cyberseihis/bnnprint/write/area_table.md

| | gasId | winewhite | cardio | pendigits | Har | winered |
|:---|---:|---:|---:|---:|---:|---:|
| bnndw |  8186903514 |  2398069796 | 2625544276 |  2989958945 | 2538763759 | 2451240647 |
| bnnpaar | 28155004994 |  1801300497 | 3873514668 |  3542788838 | 1742276623 | 1855123140 |
| bnndsat |  8104696944 |  2243047476 | 2476688256 |  2978862895 | 2401863926 | 2301503726 |
| bnnrobus |  5539426651 | 955878036 | 1244282486 |  1192648308 |  997044886 |  966295906 |
| bnnromem |  3787005725 | 795724384 |  973538254 | 954620558 |  815933049 |  795551471 |
| bnnromesx |  3784003792 | 797892993 | 1002634724 | 947374667 |  837521356 |  812703088 |
| bnnparstepw | 32698398388 |  1999572812 | 3928792766 |  3709266179 | 2315518878 | 2278159189 |
| bnnpaarter  | 26137614509 |  1665255587 | 3596909349 |  3222330307 | 1872808096 | 1747020576 |
| bnnparpnw | 26940613850 |  2586857731 | 4581533966 |  4301046264 | 2915795216 | 2779674503 |
| bnnpaarx | 28161515912 |  1819920659 | 3878707190 |  3551930192 | 1733307035 | 1843638582 |
| bnnparser | 17136617736 |  2036496895 | 3321122892 |  3396546062 | 2425075600 | 2186536366 |
| bnnrospinor |  3710576970 | 747786913 |  934543087 | 881331046 |  775932821 |  757033635 |
| bnnpar | 26976191700 |  2600670967 | 4671425747 |  4294613522 | 2939539015 | 2782322518 |
| bnndsatin |  7747969288 |  2356646791 | 2810682089 |  3109779691 | 2545317224 | 2429171177 |
| bnnroll |  4296589691 |  1034974561 | 1118415523 |  1313186365 | 1030487839 | 1020139925 |
| bnnparsign  | 17509279782 |  2047349412 | 3327450493 |  3338288839 | 2451830762 | 2245461263 |
| bnnroclk |  3740279945 | 757164887 |  978063287 | 944926916 |  813471167 |  781711587 |
| bnnroperm |  3767065181 | 785042623 |  956446441 | 935021870 |  814428053 |  787104215 |
| bnnrospine  |  3731008262 | 748739199 |  930476830 | 907653792 |  781939782 |  760587951 |
| bnnromesh |  3762552965 | 778943884 |  967400533 | 943117202 |  811382778 |  799002613 |
| bnndirect |  8862217257 |  2731200293 | 3049513878 |  3293137497 | 2763413176 | 2711150360 |
| bnnparw | 17136617736 |  2036496895 | 3321122892 |  3396546062 | 2425075600 | 2186536366 |
| bnnrolx |  4212096283 | 864705835 | 1109597201 |  1069429557 |  914303937 |  885090188 |
| bnnromex |  3797082992 | 796969544 |  975525744 | 966093815 |  822660672 |  810091571 |
| bnnseq |  4767284030 |  2974950246 | 3146979597 |  3471397032 | 2954896914 | 2957271954 |
| bnnrolin |  3854120055 | 799945409 | 1085099120 |  1036541150 |  829139916 |  804058285 |
| bnnparce | 18182298639 |  2047575794 | 3484390096 |  3573660077 | 2499410773 | 2076451308 |
