cyberseihis/bnnprint/scripts/grefs.md

bnnpar_bnnparsign

| | bnnpar area(cm²) | bnnparsign area(cm²) | area change | bnnpar power(mW) | bnnparsign power(mW) | power change |
|:---|---:|---:|:---|---:|---:|:---|
| Har | 29.4  | 24.52 | -16.6% | 92.1 | 78.8 | -14.4% |
| cardio | 46.71 | 33.27 | -28.8% | 145.3 | 106.2 | -26.9% |
| gasId | 269.76 | 175.09 | -35.1% | 767.7 | 499.1 | -35.0% |
| pendigits | 42.95 | 33.38 | -22.3% | 136.8 | 108.9 | -20.4% |
| winered | 27.82 | 22.45 | -19.3% | 90.7 | 74.6 | -17.8% |
| winewhite | 26.01 | 20.47 | -21.3% | 84.6 | 68 | -19.6% |

bnnparsign_bnnparw

| | bnnparsign area(cm²) | bnnparw area(cm²) | area change | bnnparsign power(mW) | bnnparw power(mW) | power change |
|:---|---:|---:|:---|---:|---:|:---|
| Har | 24.52 | 24.25 | -1.1% | 78.8 | 77.6 | -1.5% |
| cardio | 33.27 | 33.21 | -0.2% | 106.2 | 105.4 | -0.8% |
| gasId | 175.09 | 171.37 | -2.1% | 499.1 | 486.9 | -2.4% |
| pendigits | 33.38 | 33.97 | +1.8% | 108.9 | 109.6 | +0.6% |
| winered | 22.45 | 21.87 | -2.6% | 74.6 | 72.3 | -3.1% |
| winewhite | 20.47 | 20.36 | -0.5% | 68 | 66.7 | -1.9% |

bnnparw_bnnparce

| | bnnparw area(cm²) | bnnparce area(cm²) | area change | bnnparw power(mW) | bnnparce power(mW) | power change |
|:---|---:|---:|:---|---:|---:|:---|
| Har | 24.25 | 24.99 | +3.1% | 77.6 | 79 | +1.8% |
| cardio | 33.21 | 34.84 | +4.9% | 105.4 | 110.5 | +4.8% |
| gasId | 171.37 | 181.82 | +6.1% | 486.9 | 516.1 | +6.0% |
| pendigits | 33.97 | 35.74 | +5.2% | 109.6 | 115.5 | +5.4% |
| winered | 21.87 | 20.76 | -5.1% | 72.3 | 67.7 | -6.4% |
| winewhite | 20.36 | 20.48 | +0.6% | 66.7 | 65.8 | -1.3% |

bnnparw_bnnparstepw

| | bnnparw area(cm²) | bnnparstepw area(cm²) | area change | bnnparw power(mW) | bnnparstepw power(mW) | power change |
|:---|---:|---:|:---|---:|---:|:---|
| Har | 24.25 | 23.16 | -4.5% | 77.6 | 73.7 | -5.0% |
| cardio | 33.21 | 39.29 | +18.3% | 105.4 | 125.5 | +19.1% |
| gasId | 171.37 | 326.98 | +90.8% | 486.9 | 935.2 | +92.1% |
| pendigits | 33.97 | 37.09 | +9.2% | 109.6 | 120.3 | +9.8% |
| winered | 21.87 | 22.78 | +4.2% | 72.3 | 75.3 | +4.1% |
| winewhite | 20.36 | 20 | -1.8% | 66.7 | 65.8 | -1.3% |

bnnparsign_bnnpaar

| | bnnparsign area(cm²) | bnnpaar area(cm²) | area change | bnnparsign power(mW) | bnnpaar power(mW) | power change |
|:---|---:|---:|:---|---:|---:|:---|
| Har | 24.52 | 17.42 | -29.0% | 78.8 | 57.2 | -27.4% |
| cardio | 33.27 | 38.74 | +16.4% | 106.2 | 124.1 | +16.9% |
| gasId | 175.09 | 281.55 | +60.8% | 499.1 | 807.6 | +61.8% |
| pendigits | 33.38 | 35.43 | +6.1% | 108.9 | 114.6 | +5.2% |
| winered | 22.45 | 18.55 | -17.4% | 74.6 | 62.6 | -16.1% |
| winewhite | 20.47 | 18.01 | -12.0% | 68 | 59.8 | -12.1% |

bnnpaar_bnnpaarter

| | bnnpaar area(cm²) | bnnpaarter area(cm²) | area change | bnnpaar power(mW) | bnnpaarter power(mW) | power change |
|:---|---:|---:|:---|---:|---:|:---|
| Har | 17.42 | 18.73 | +7.5% | 57.2 | 60.8 | +6.3% |
| cardio | 38.74 | 35.97 | -7.2% | 124.1 | 116 | -6.5% |
| gasId | 281.55 | 261.38 | -7.2% | 807.6 | 759.7 | -5.9% |
| pendigits | 35.43 | 32.22 | -9.1% | 114.6 | 107.3 | -6.4% |
| winered | 18.55 | 17.47 | -5.8% | 62.6 | 59.6 | -4.8% |
| winewhite | 18.01 | 16.65 | -7.6% | 59.8 | 55.9 | -6.5% |

bnnseq_bnndirect

| | bnnseq area(cm²) | bnndirect area(cm²) | area change | bnnseq power(mW) | bnndirect power(mW) | power change |
|:---|---:|---:|:---|---:|---:|:---|
| Har | 29.55 | 27.63 | -6.5% | 132.7 | 128.8 | -2.9% |
| cardio | 31.47 | 30.5  | -3.1% | 143.1 | 150.8 | +5.4% |
| gasId | 47.67 | 88.62 | +85.9% | 216.8 | 364.5 | +68.1% |
| pendigits | 34.71 | 32.93 | -5.1% | 139 | 135.7 | -2.4% |
| winered | 29.57 | 27.11 | -8.3% | 131.7 | 125.7 | -4.6% |
| winewhite | 29.75 | 27.31 | -8.2% | 128.6 | 122.6 | -4.7% |

bnndirect_bnndw

| | bnndirect area(cm²) | bnndw area(cm²) | area change | bnndirect power(mW) | bnndw power(mW) | power change |
|:---|---:|---:|:---|---:|---:|:---|
| Har | 27.63 | 25.39 | -8.1% | 128.8 | 116.4 | -9.6% |
| cardio | 30.5  | 26.26 | -13.9% | 150.8 | 124.9 | -17.2% |
| gasId | 88.62 | 81.87 | -7.6% | 364.5 | 325.6 | -10.7% |
| pendigits | 32.93 | 29.9  | -9.2% | 135.7 | 123.1 | -9.3% |
| winered | 27.11 | 24.51 | -9.6% | 125.7 | 112.1 | -10.8% |
| winewhite | 27.31 | 23.98 | -12.2% | 122.6 | 106.2 | -13.4% |

bnndw_bnndsat

| | bnndw area(cm²) | bnndsat area(cm²) | area change | bnndw power(mW) | bnndsat power(mW) | power change |
|:---|---:|---:|:---|---:|---:|:---|
| Har | 25.39 | 24.02 | -5.4% | 116.4 | 109.2 | -6.2% |
| cardio | 26.26 | 24.77 | -5.7% | 124.9 | 118.7 | -5.0% |
| gasId | 81.87 | 81.05 | -1.0% | 325.6 | 318.9 | -2.1% |
| pendigits | 29.9  | 29.79 | -0.4% | 123.1 | 121.6 | -1.2% |
| winered | 24.51 | 23.02 | -6.1% | 112.1 | 104.5 | -6.8% |
| winewhite | 23.98 | 22.43 | -6.5% | 106.2 | 98.5 | -7.3% |

bnnrolx_bnnrolin

| | bnnrolx area(cm²) | bnnrolin area(cm²) | area change | bnnrolx power(mW) | bnnrolin power(mW) | power change |
|:---|---:|---:|:---|---:|---:|:---|
| Har | 9.14 | 8.29 | -9.3% | 39 | 36.3 | -6.9% |
| cardio | 11.1  | 10.85 | -2.3% | 45.5 | 45.6 | +0.2% |
| gasId | 42.12 | 38.54 | -8.5% | 142.4 | 131.3 | -7.8% |
| pendigits | 10.69 | 10.37 | -3.0% | 43.5 | 42.6 | -2.1% |
| winered | 8.85 | 8.04 | -9.2% | 38.9 | 35.7 | -8.2% |
| winewhite | 8.65 | 8 | -7.5% | 37.5 | 34.9 | -6.9% |

bnnrolin_bnnrospine

| | bnnrolin area(cm²) | bnnrospine area(cm²) | area change | bnnrolin power(mW) | bnnrospine power(mW) | power change |
|:---|---:|---:|:---|---:|---:|:---|
| Har | 8.29 | 7.82 | -5.7% | 36.3 | 31.7 | -12.7% |
| cardio | 10.85 | 9.3  | -14.3% | 45.6 | 36 | -21.1% |
| gasId | 38.54 | 37.31 | -3.2% | 131.3 | 124.4 | -5.3% |
| pendigits | 10.37 | 9.08 | -12.4% | 42.6 | 35.1 | -17.6% |
| winered | 8.04 | 7.61 | -5.3% | 35.7 | 30.9 | -13.4% |
| winewhite | 8 | 7.49 | -6.4% | 34.9 | 30.9 | -11.5% |

bnnrospine_bnnrobus

| | bnnrospine area(cm²) | bnnrobus area(cm²) | area change | bnnrospine power(mW) | bnnrobus power(mW) | power change |
|:---|---:|---:|:---|---:|---:|:---|
| Har | 7.82 | 9.97 | +27.5% | 31.7 | 26.1 | -17.7% |
| cardio | 9.3  | 12.44 | +33.8% | 36 | 29.4 | -18.3% |
| gasId | 37.31 | 55.39 | +48.5% | 124.4 | 97.9 | -21.3% |
| pendigits | 9.08 | 11.93 | +31.4% | 35.1 | 29.7 | -15.4% |
| winered | 7.61 | 9.66 | +26.9% | 30.9 | 25.7 | -16.8% |
| winewhite | 7.49 | 9.56 | +27.6% | 30.9 | 25.2 | -18.4% |

bnnparw_bnnrospine

| | bnnparw area(cm²) | bnnrospine area(cm²) | area change | bnnparw power(mW) | bnnrospine power(mW) | power change |
|:---|---:|---:|:---|---:|---:|:---|
| Har | 24.25 | 7.82 | -67.8% | 77.6 | 31.7 | -59.1% |
| cardio | 33.21 | 9.3  | -72.0% | 105.4 | 36 | -65.8% |
| gasId | 171.37 | 37.31 | -78.2% | 486.9 | 124.4 | -74.5% |
| pendigits | 33.97 | 9.08 | -73.3% | 109.6 | 35.1 | -68.0% |
| winered | 21.87 | 7.61 | -65.2% | 72.3 | 30.9 | -57.3% |
| winewhite | 20.36 | 7.49 | -63.2% | 66.7 | 30.9 | -53.7% |

bnnparw_tnnparsign

| | bnnparw area(cm²) | tnnparsign area(cm²) | area change | bnnparw power(mW) | tnnparsign power(mW) | power change |
|:---|---:|---:|:---|---:|---:|:---|
| Har | 24.25 | 13.4  | -44.7% | 77.6 | 42.7 | -45.0% |
| cardio | 33.21 | 19.21 | -42.2% | 105.4 | 62.4 | -40.8% |
| gasId | 171.37 | 101.65 | -40.7% | 486.9 | 297.1 | -39.0% |
| pendigits | 33.97 | 29.43 | -13.4% | 109.6 | 95.8 | -12.6% |
| winered | 21.87 | 11.78 | -46.1% | 72.3 | 40 | -44.7% |
| winewhite | 20.36 | 9.53 | -53.2% | 66.7 | 32.8 | -50.8% |
