cyberseihis/bnnprint/trainingdata/listofdatasets.txt

pendigits ready
har [XYZ][Mean/Std][Acc/Gyro] cleaned
arrythmia cleaned
redwine not all classes used
whitewine cleaned
cardio cleaned
gasId cleaned
