cyberseihis/bnnprint/write/tnstuf/bnnpar_tnnpartab.md

| | bnnpar area | tnnpar area | area change | bnnpar power | tnnpar power | power change |
|:---|---:|---:|:---|---:|---:|:---|
| Har | 29.4  | 14.58 | -50.4% | 92.1 | 46.1 | -49.9% |
| cardio | 46.71 | 20.55 | -56.0% | 145.3 | 66.3 | -54.4% |
| gasId | 269.76 | 110.99 | -58.9% | 767.7 | 325.4 | -57.6% |
| pendigits | 42.95 | 29.97 | -30.2% | 136.8 | 97.4 | -28.8% |
| winered | 27.82 | 13.42 | -51.8% | 90.7 | 44 | -51.5% |
| winewhite | 26.01 | 10.49 | -59.7% | 84.6 | 35.1 | -58.5% |
