cyberseihis/bnnprint/write/tnstuf/bnnparsign_tnnparsigntab.md

| | bnnparsign area | tnnparsign area | area change | bnnparsign power | tnnparsign power | power change |
|:---|---:|---:|:---|---:|---:|:---|
| Har | 24.52 | 13.4  | -45.4% | 78.8 | 42.7 | -45.8% |
| cardio | 33.27 | 19.21 | -42.3% | 106.2 | 62.4 | -41.2% |
| gasId | 175.09 | 101.65 | -41.9% | 499.1 | 297.1 | -40.5% |
| pendigits | 33.38 | 29.43 | -11.8% | 108.9 | 95.8 | -12.0% |
| winered | 22.45 | 11.78 | -47.5% | 74.6 | 40 | -46.4% |
| winewhite | 20.47 | 9.53 | -53.4% | 68 | 32.8 | -51.8% |
