cyberseihis/bnnprint/write/tnstuf/bnnseq_tnnseqtab.md

| | bnnseq area | tnnseq area | area change | bnnseq power | tnnseq power | power change |
|:---|---:|---:|:---|---:|---:|:---|
| Har | 29.55 | 25.69 | -13.1% | 132.7 | 119.6 | -9.9% |
| cardio | 31.47 | 21.74 | -30.9% | 143.1 | 101.4 | -29.1% |
| gasId | 47.67 | 35.6  | -25.3% | 216.8 | 158.2 | -27.0% |
| pendigits | 34.71 | 34.64 | -0.2% | 139 | 139.1 | +0.1% |
| winered | 29.57 | 24.95 | -15.6% | 131.7 | 117.3 | -10.9% |
| winewhite | 29.75 | 24.45 | -17.8% | 128.6 | 115.5 | -10.2% |
