cyberseihis/bnnprint/write/tnstuf/tnnparsign_tnnpaartab.md

| | tnnparsign area | tnnpaar area | area change | tnnparsign power | tnnpaar power | power change |
|:---|---:|---:|:---|---:|---:|:---|
| Har | 13.4  | 14.03 | +4.7% | 42.7 | 44 | +3.0% |
| cardio | 19.21 | 18.75 | -2.4% | 62.4 | 61.4 | -1.6% |
| gasId | 101.65 | 107.06 | +5.3% | 297.1 | 312.8 | +5.3% |
| pendigits | 29.43 | 28.34 | -3.7% | 95.8 | 93.2 | -2.7% |
| winered | 11.78 | 12.61 | +7.0% | 40 | 42.2 | +5.5% |
| winewhite | 9.53 | 10.47 | +9.9% | 32.8 | 34.9 | +6.4% |
