cyberseihis/bnnprint/write/tnstuf/tnnparsign_tnnpaartertab.md

| | tnnparsign area | tnnpaarter area | area change | tnnparsign power | tnnpaarter power | power change |
|:---|---:|---:|:---|---:|---:|:---|
| Har | 13.4  | 14.01 | +4.6% | 42.7 | 44.7 | +4.7% |
| cardio | 19.21 | 19.87 | +3.4% | 62.4 | 65 | +4.2% |
| gasId | 101.65 | 110.62 | +8.8% | 297.1 | 324.5 | +9.2% |
| pendigits | 29.43 | 27.95 | -5.0% | 95.8 | 93 | -2.9% |
| winered | 11.78 | 12.85 | +9.1% | 40 | 43.7 | +9.3% |
| winewhite | 9.53 | 10.29 | +8.0% | 32.8 | 34.2 | +4.3% |
