cyberseihis/bnnprint/write/tnstuf/tnnparsign_tnnparwtab.md

| | tnnparsign area | tnnparw area | area change | tnnparsign power | tnnparw power | power change |
|:---|---:|---:|:---|---:|---:|:---|
| Har | 13.4  | 13.82 | +3.1% | 42.7 | 44.2 | +3.5% |
| cardio | 19.21 | 19.85 | +3.3% | 62.4 | 63.9 | +2.4% |
| gasId | 101.65 | 101.42 | -0.2% | 297.1 | 294.6 | -0.8% |
| pendigits | 29.43 | 29.74 | +1.1% | 95.8 | 97.2 | +1.5% |
| winered | 11.78 | 12.26 | +4.1% | 40 | 40.6 | +1.5% |
| winewhite | 9.53 | 10.18 | +6.8% | 32.8 | 34.1 | +4.0% |
