cyberseihis/bnnprint/write/tnstuf/tnnseq_tnnzeqtab.md

| | tnnseq area | tnnzeq area | area change | tnnseq power | tnnzeq power | power change |
|:---|---:|---:|:---|---:|---:|:---|
| Har | 25.69 | 23.86 | -7.1% | 119.6 | 115.7 | -3.3% |
| cardio | 21.74 | 22.16 | +1.9% | 101.4 | 105.9 | +4.4% |
| gasId | 35.6  | 60.56 | +70.1% | 158.2 | 236.5 | +49.5% |
| pendigits | 34.64 | 32.95 | -4.9% | 139.1 | 135.7 | -2.4% |
| winered | 24.95 | 22.66 | -9.2% | 117.3 | 110.8 | -5.5% |
| winewhite | 24.45 | 22.08 | -9.7% | 115.5 | 108.9 | -5.7% |
