cyberseihis/bnnprint/write/tnstuf/tnnzeq_tnnzewtab.md

| | tnnzeq area | tnnzew area | area change | tnnzeq power | tnnzew power | power change |
|:---|---:|---:|:---|---:|---:|:---|
| Har | 23.86 | 19.85 | -16.8% | 115.7 | 94.5 | -18.3% |
| cardio | 22.16 | 18.06 | -18.5% | 105.9 | 83.4 | -21.2% |
| gasId | 60.56 | 57.54 | -5.0% | 236.5 | 221.6 | -6.3% |
| pendigits | 32.95 | 28.85 | -12.4% | 135.7 | 117.5 | -13.4% |
| winered | 22.66 | 18.73 | -17.3% | 110.8 | 89.3 | -19.4% |
| winewhite | 22.08 | 18.5  | -16.2% | 108.9 | 89.1 | -18.2% |
