cyberseihis/bnnprint/write/comps/bnnrolin_bnnromemtab.md

| | bnnrolin area | bnnromem area | area change | bnnrolin power | bnnromem power | power change |
|:---|---:|---:|:---|---:|---:|:---|
| Har | 8.29 | 8.16 | -1.6% | 36.3 | 35.1 | -3.3% |
| cardio | 10.85 | 9.74 | -10.2% | 45.6 | 40.8 | -10.5% |
| gasId | 38.54 | 37.87 | -1.7% | 131.3 | 130 | -1.0% |
| pendigits | 10.37 | 9.55 | -7.9% | 42.6 | 38.2 | -10.3% |
| winered | 8.04 | 7.96 | -1.0% | 35.7 | 35.2 | -1.4% |
| winewhite | 8 | 7.96 | -0.5% | 34.9 | 34.9 | +0.0% |
