cyberseihis/bnnprint/write/comps/bnnromem_bnnromeshtab.md

| | bnnromem area | bnnromesh area | area change | bnnromem power | bnnromesh power | power change |
|:---|---:|---:|:---|---:|---:|:---|
| Har | 8.16 | 8.11 | -0.6% | 35.1 | 35.3 | +0.6% |
| cardio | 9.74 | 9.67 | -0.7% | 40.8 | 40.1 | -1.7% |
| gasId | 37.87 | 37.63 | -0.6% | 130 | 129.6 | -0.3% |
| pendigits | 9.55 | 9.43 | -1.3% | 38.2 | 38.7 | +1.3% |
| winered | 7.96 | 7.99 | +0.4% | 35.2 | 34.8 | -1.1% |
| winewhite | 7.96 | 7.79 | -2.1% | 34.9 | 34.1 | -2.3% |
