cyberseihis/bnnprint/write/comps/bnnromesh_bnnromesxtab.md

| | bnnromesh area | bnnromesx area | area change | bnnromesh power | bnnromesx power | power change |
|:---|---:|---:|:---|---:|---:|:---|
| Har | 8.11 | 8.38 | +3.3% | 35.3 | 36.9 | +4.5% |
| cardio | 9.67 | 10.03 | +3.7% | 40.1 | 42 | +4.7% |
| gasId | 37.63 | 37.84 | +0.6% | 129.6 | 135.5 | +4.6% |
| pendigits | 9.43 | 9.47 | +0.4% | 38.7 | 40.4 | +4.4% |
| winered | 7.99 | 8.13 | +1.8% | 34.8 | 35.9 | +3.2% |
| winewhite | 7.79 | 7.98 | +2.4% | 34.1 | 35.4 | +3.8% |
