cyberseihis/bnnprint/write/comps/bnnromesh_bnnropermtab.md

| | bnnromesh area | bnnroperm area | area change | bnnromesh power | bnnroperm power | power change |
|:---|---:|---:|:---|---:|---:|:---|
| Har | 8.11 | 8.14 | +0.4% | 35.3 | 35.2 | -0.3% |
| cardio | 9.67 | 9.56 | -1.1% | 40.1 | 39.1 | -2.5% |
| gasId | 37.63 | 37.67 | +0.1% | 129.6 | 131.7 | +1.6% |
| pendigits | 9.43 | 9.35 | -0.8% | 38.7 | 38.5 | -0.5% |
| winered | 7.99 | 7.87 | -1.5% | 34.8 | 34.7 | -0.3% |
| winewhite | 7.79 | 7.85 | +0.8% | 34.1 | 33.9 | -0.6% |
