cyberseihis/bnnprint/write/comps/bnnromesh_bnnrospinetab.md

| | bnnromesh area | bnnrospine area | area change | bnnromesh power | bnnrospine power | power change |
|:---|---:|---:|:---|---:|---:|:---|
| Har | 8.11 | 7.82 | -3.6% | 35.3 | 31.7 | -10.2% |
| cardio | 9.67 | 9.3  | -3.8% | 40.1 | 36 | -10.2% |
| gasId | 37.63 | 37.31 | -0.9% | 129.6 | 124.4 | -4.0% |
| pendigits | 9.43 | 9.08 | -3.7% | 38.7 | 35.1 | -9.3% |
| winered | 7.99 | 7.61 | -4.8% | 34.8 | 30.9 | -11.2% |
| winewhite | 7.79 | 7.49 | -3.9% | 34.1 | 30.9 | -9.4% |
