cyberseihis/bnnprint/write/comps/bnnrospine_bnnrospinortab.md

| | bnnrospine area | bnnrospinor area | area change | bnnrospine power | bnnrospinor power | power change |
|:---|---:|---:|:---|---:|---:|:---|
| Har | 7.82 | 7.76 | -0.8% | 31.7 | 31.5 | -0.6% |
| cardio | 9.3  | 9.35 | +0.5% | 36 | 36.2 | +0.6% |
| gasId | 37.31 | 37.11 | -0.5% | 124.4 | 121.8 | -2.1% |
| pendigits | 9.08 | 8.81 | -3.0% | 35.1 | 34.1 | -2.8% |
| winered | 7.61 | 7.57 | -0.5% | 30.9 | 30.8 | -0.3% |
| winewhite | 7.49 | 7.48 | -0.1% | 30.9 | 30.6 | -1.0% |
