cyberseihis/bnnprint/write/mark.pdf

## Δυαδικά νευρωνικά δίκτυα για τυπωμένα ηλεκτρονικά

Παναγιώτης Παπανικολάου

7 Ιουλίου 2023

## Τυπωμένα ηλεκτρονικά

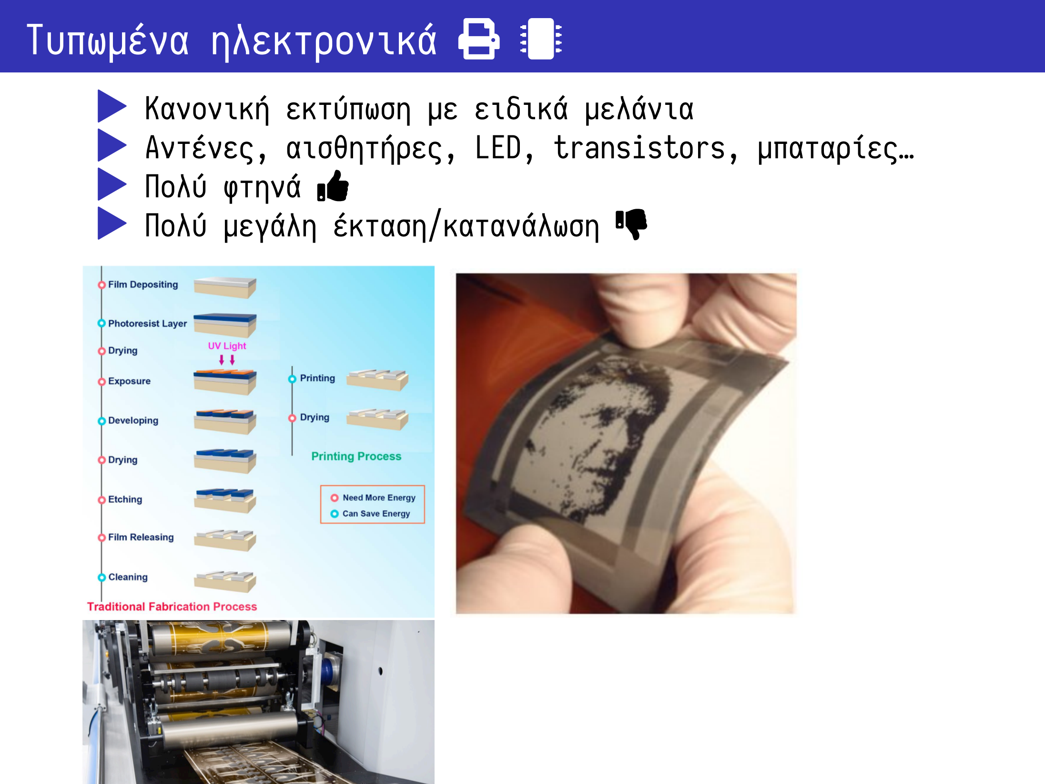
[picture p40: page 2]

- Κανονική εκτύπωση με ειδικά μελάνια
- Αντένες, αισθητήρες, LED, transistors, μπαταρίες…
- Πολύ φτηνά
- Πολύ μεγάλη έκταση/κατανάλωση

## Ubiquitous computing ç

Υπολογιστικά στοιχεία στα πάντα.

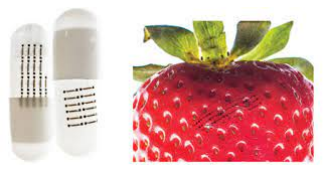
[picture p41: figure]

Εκτυπωμένo machine learning
- Πολλές εφαρμογές classification
- Δύσκολα υλοποιήσιμο

## Δυαδικά νευρωνικά δίκτυα(ΒΝΝ)

- Weights/activations ∈ {−1, 1} (1 bit)
- Multiply-accumulate → XNOR-popcount
- Χαμηλές απαιτήσεις
- Λιγότερο αξιόπιστα

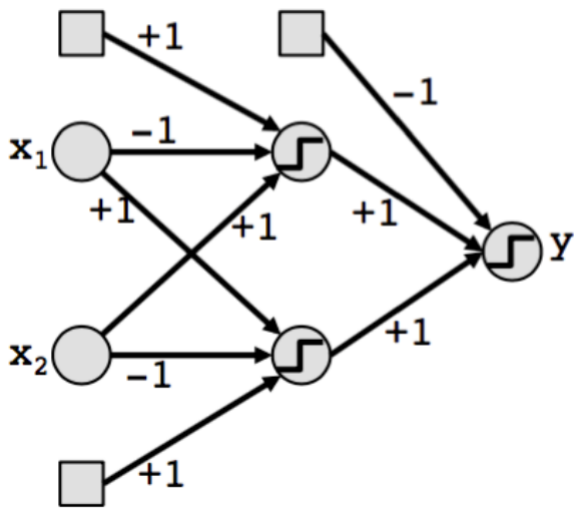
[picture p42: figure]

## Προηγούμενες εργασίες

- Αναλογικοί νευρώνες¹
- Bespoke decision trees, SVMs²
- Bespoke approximate MLPs³
- Stochastic computing⁴
- Sea of gates⁵

1
Weller et al, Programmable neuromorphic circuit based on printed electrolyte-gated transistors, in: (Asp-Dac)
2
Weller et al, Printed machine learning classifiers, in: Annu. Int. Symp. Microarchitecture (Micro)
3
Armeniakos et al, Cross-layer approximation for printed machine learning circuits, in: (Date)
4
Weller et al,Printed stochastic computing neural networks, in: (Date)
5
Iordanou et al, Tiny classifier circuits: Evolving accelerators for tabular data, (2023).

## Στόχος

Εξέταση ΒΝΝ ως προς την υποστήριξη τυπωμένου ML é

Υλοποίηση framework για αυτόματη δημιουργία τυπωμένου ΒΝΝ από dataset

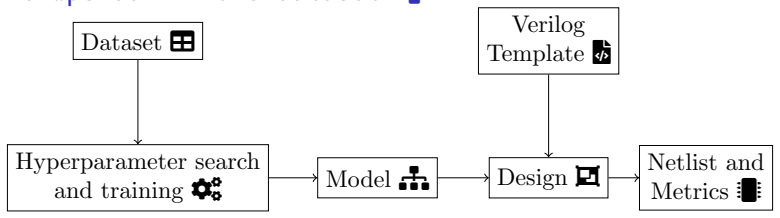
[picture p43: figure]
Dataset O; Hyperparameter search; and training Ô; Model ú; Design _; Verilog Template D; Netlist and Metrics >

## Model accuracy é

Dataset | FP32 BNN TNN MLPC
Cardio | 92 | 88 | 90 88
GasId | 90 | 81 | 88 -
Har | 74 | 51 | 52 -
Pendigits | 99 | 87 | 92 94
Redwine | 60 | 54 | 58 56
Whitewine | 57 | 51 | 50 54

## Παράλληλη υλοποίηση

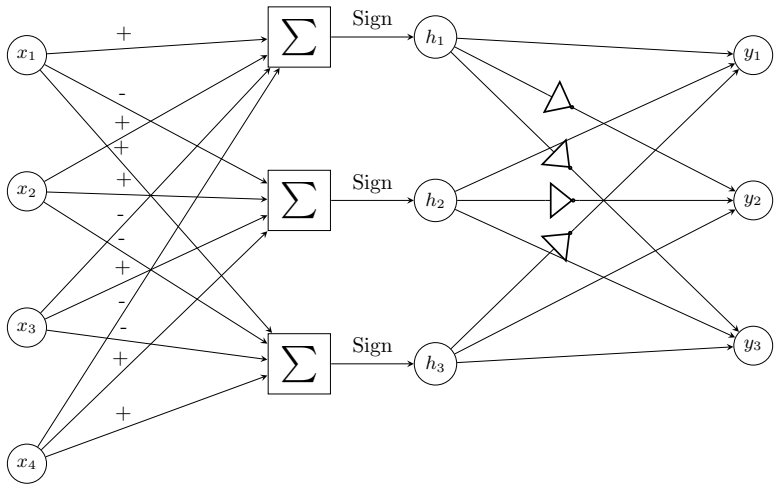
[picture p44: figure]
Sign

## Παράλληλη υλοποίηση

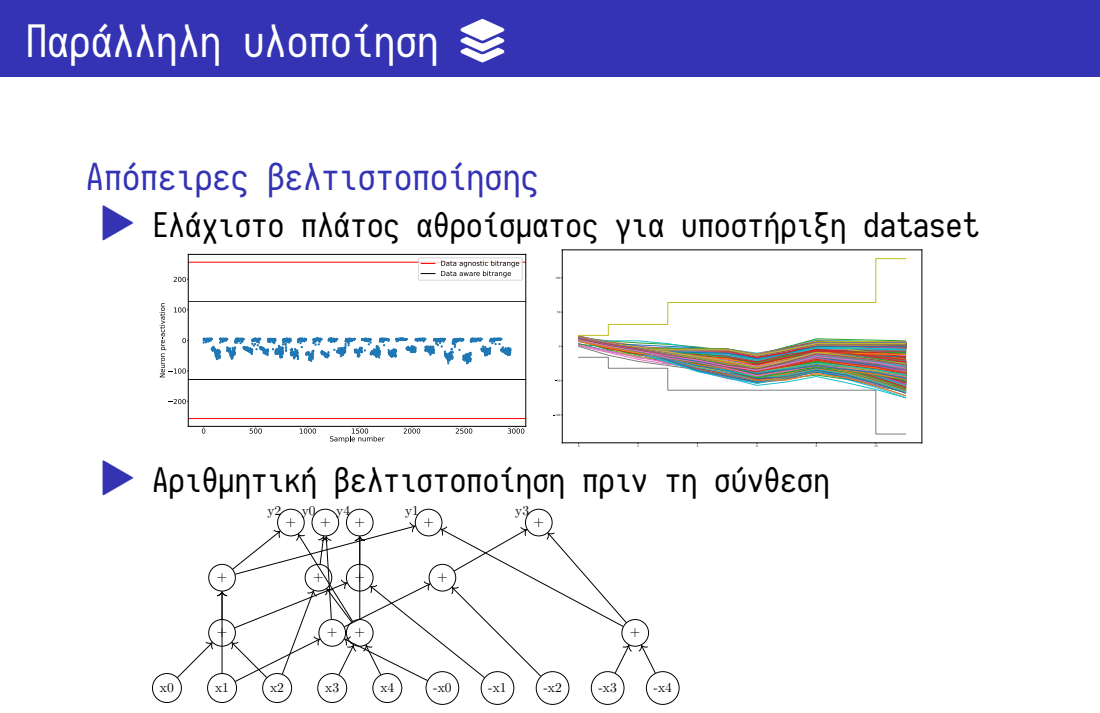
[picture p45: page 9]

Απόπειρες βελτιστοποίησης
▶ Ελάχιστο πλάτος αθροίσματος για υποστήριξη dataset

▶ Αριθμητική βελτιστοποίηση πριν τη σύνθεση

## Ακολουθιακή υλοποίηση ¥

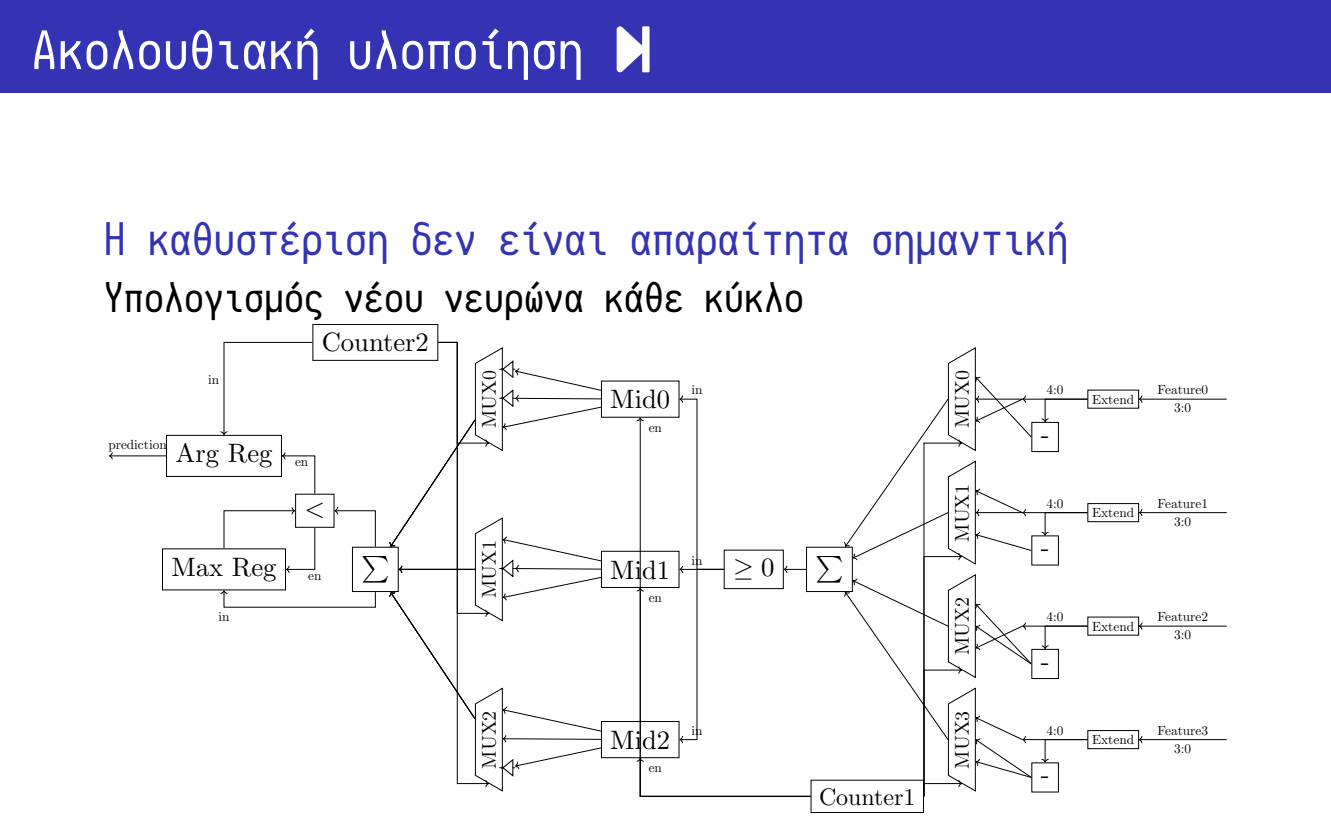
[picture p46: page 10]
Counter1; Extend; Feature0; MUX0; Feature1; MUX1; Feature2; MUX2; Feature3; MUX3; Counter2; Mid0; Mid1; Mid2; Max Reg; Arg Reg; prediction

Η καθυστέριση δεν είναι απαραίτητα σημαντική
Υπολογισμός νέου νευρώνα κάθε κύκλο P

## Βελτιώσεις στην ακολουθιακή υλοποίηση ¥

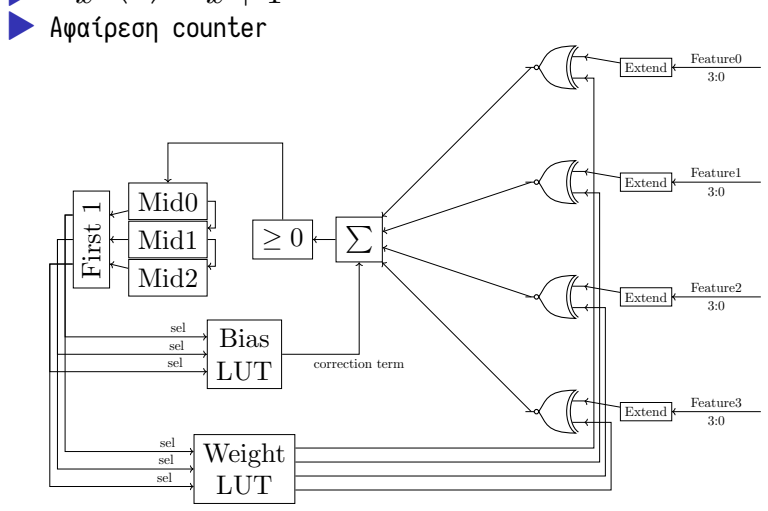
[picture p47: figure]
▶ Αφαίρεση counter; Bias LUT; Weight LUT; correction term; Extend; Feature0 3:0; Feature1 3:0; Feature2 3:0; Feature3 3:0; Mid1; First 1; Mid0; sel; Mid2

- −x ⟺ ¬x + 1

## Tristate buffer memory

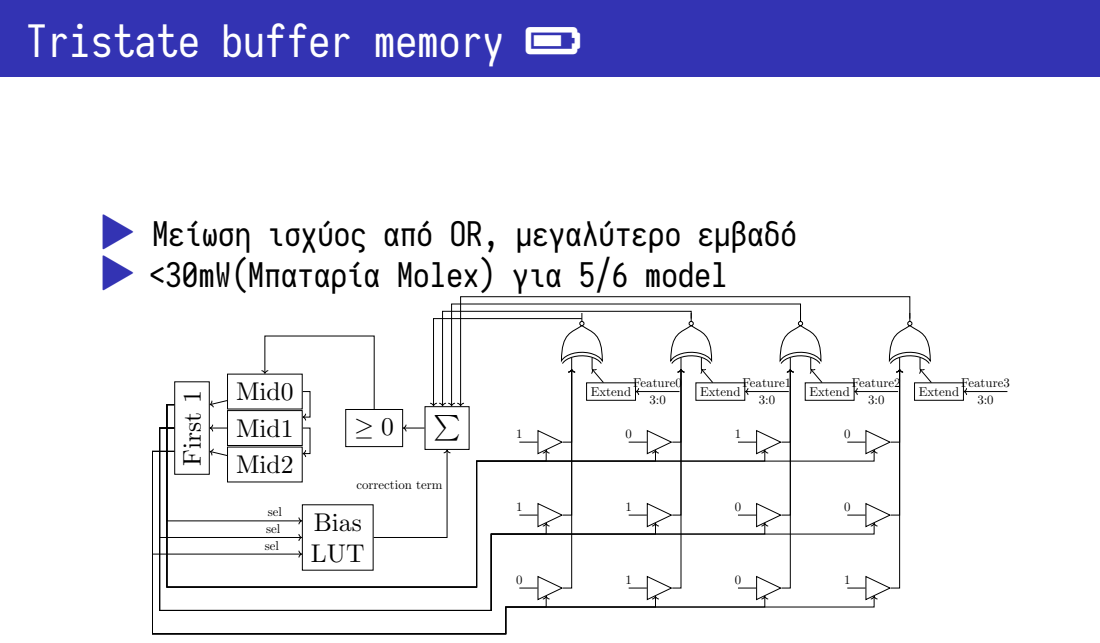
[picture p48: page 12]
Bias LUT; correction term; Extend Feature0; Extend Feature1; Extend Feature2; Extend Feature3; First 1; Mid0; sel; Mid1; Mid2

▶ Μείωση ισχύος από OR, μεγαλύτερο εμβαδό
▶ <30mW(Μπαταρία Molex) για 5/6 model

## Delays

dataset

combinatorial
delay(ms)

sequential
delay(ms)

sequential
cycles

total
sequential
delay(ms)
cardio | 142 | 147 | 43 | 6321
gasId | 260 | 181 | 46 | 8326
Har | 165 | 135 | 46 | 6210
pendigits | 309 | 147 | 50 | 7350
winered | 160 | 138 | 46 | 6348
winewhite | 143 | 129 | 47 | 6063

## Ternary weight networks

- Βάρη ∈ {−1, 0, 1} αντί {−1, 1}
- Αφαίρεση συνδέσεων με βάρος 0 ñ
- Καλύτερη ακρίβεια και έως 2× μικρότερα κόστη Ô

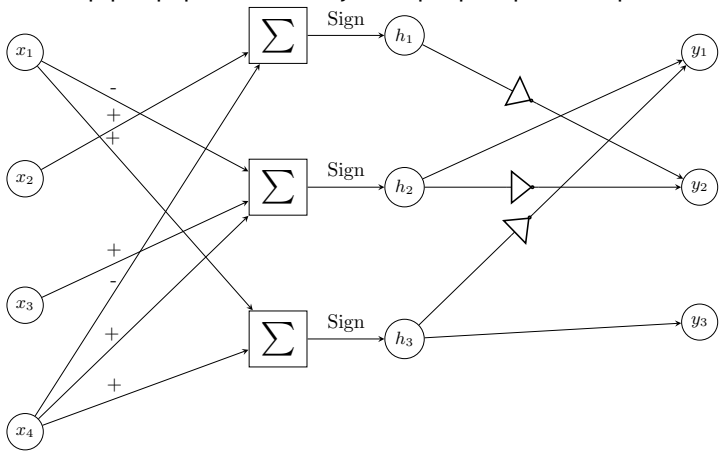
[picture p49: figure]
Sign

## Συγκρίσεις

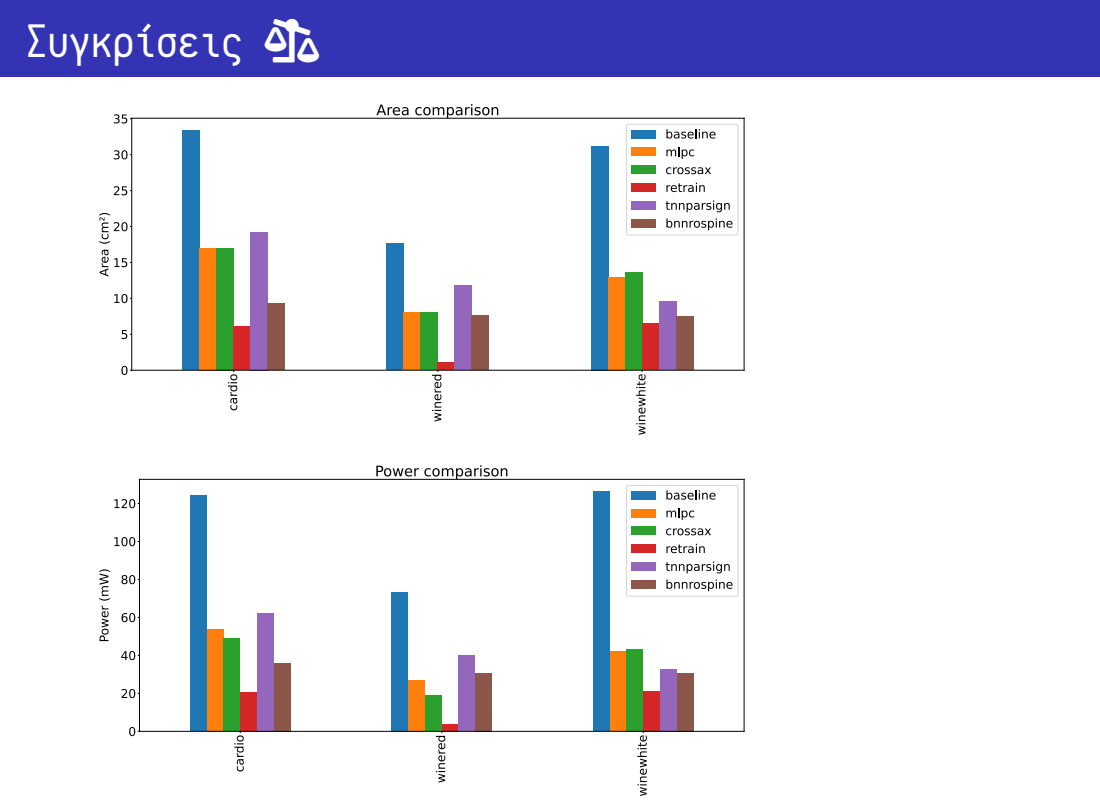
[picture p50: page 15]
