cyberseihis/bnnprint/write/xx.pdf

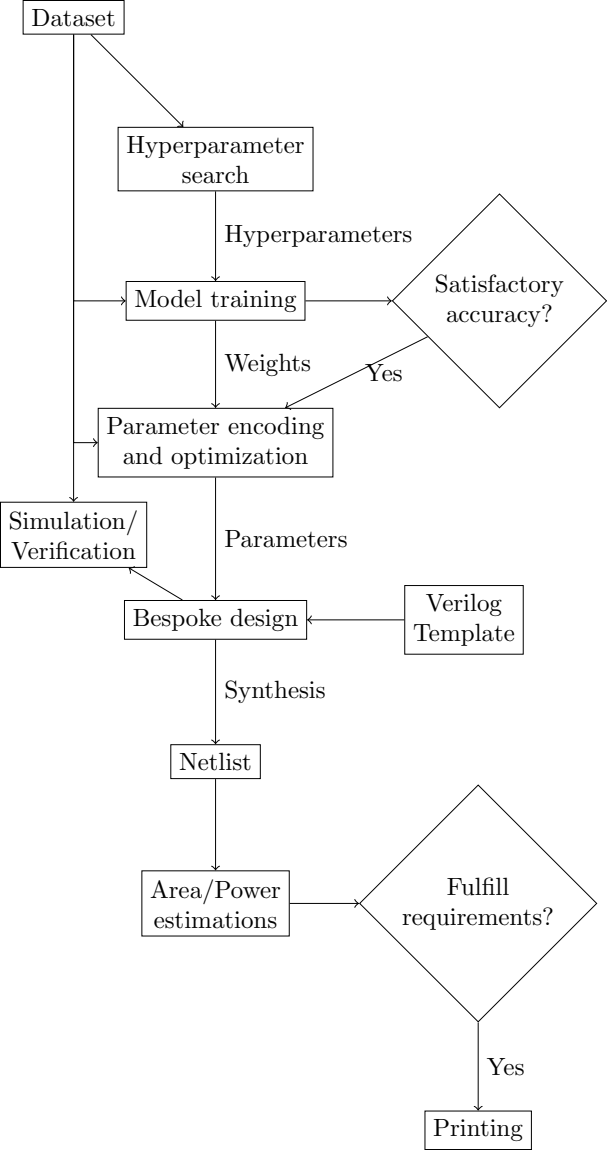
[picture p51: figure]
Dataset; Hyperparameter search; Model training; Parameter encoding and optimization; Satisfactory accuracy?; Bespoke design; Simulation/ Verification; Verilog Template; Netlist; Area/Power estimations; Fulfill requirements?; Printing; Hyperparameters; Weights; Yes; Parameters; Synthesis
