cyberseihis/bnnprint/write/grtheory.md

\newpage

# Abstract

Τα τυπωμένα ηλεκτρονικά είναι μια αναδυόμενη τεχνολογία που έχει τη δυνατότητα να καταστήσει δυνατή τη διείσδυση της πληροφορικής σε μια μεγάλη ποικιλία καταναλωτικών προϊόντων, χάρη στην υπό του cent κατασκευή τους και τους εύκαμπτους παράγοντες μορφής τους. Πολλές από τις προβλεπόμενες εφαρμογές που θα υποστηρίξουν έχουν να κάνουν με την ταξινόμηση των δεδομένων που συλλέγονται από τυπωμένους αισθητήρες για την εξαγωγή μιας χρήσιμης ιδιότητας σχετικά με το υπό μέτρηση αντικείμενο. Η εκτυπωμένη μηχανική μάθηση (ML) αναπτύσσεται προκειμένου να πραγματοποιούνται τέτοιου είδους ταξινομήσεις από δεδομένα αισθητήρων. Επειδή τα τυπωμένα ηλεκτρονικά έχουν πολύ υψηλότερες απαιτήσεις σε έκταση και κατανάλωση ενέργειας σε σύγκριση με τα παραδοσιακά ηλεκτρονικά, αυτά τα μοντέλα ML πρέπει να εκτελούνται σε περιβάλλον με πολύ περιορισμένους πόρους. Ευτυχώς, η ευκολία κατασκευής τυπωμένων κυκλωμάτων με τη χρήση προσθετικών μεθόδων επιτρέπει την πλήρη προσαρμογή του υλικού στο ακριβές εκπαιδευμένο μοντέλο που ενσωματώνει. Αυτό επιτρέπει τη συρρίκνωση των απαιτήσεων σε πόρους κατά πολλούς παράγοντες. Η παρούσα εργασία αξιολογεί τη δυνατότητα ανάπτυξης αρχιτεκτονικών δυαδικών νευρωνικών δικτύων (BNN) ως τυπωμένων ταξινομητών, όπου τα BNN είναι δίκτυα με βάρη και ενεργοποιήσεις που κβαντίζονται σε ένα μόνο bit για τη μείωση των υπολογιστικών απαιτήσεων στο ελάχιστο, γεγονός που τα καθιστά μια καλή υποψήφια αρχιτεκτονική για το συγκεκριμένο πρόβλημα.

\newpage

# Εισαγωγή

## Εισαγωγή στα τυπωμένα ηλεκτρονικά

Τα τυπωμένα ηλεκτρονικά αναφέρονται σε πολύ λεπτές ηλεκτρονικές συσκευές
και κυκλώματα που παράγονται με την εφαρμογή μελανιών με τις επιθυμητές
ηλεκτρικές ιδιότητες σε διάφορα υποστρώματα. Μπορούν να κατασκευαστούν
σε μεγάλο όγκο για πολύ χαμηλότερο κόστος σε σύγκριση με άλλα
ηλεκτρονικά με μεθόδους που είναι κοινές στην βιομηχανία εκτύπωσης. Αυτό
τα καθιστά ιδιαίτερα κατάλληλα για εφαρμογές όπου τα οφέλη της
ηλεκτρονικής λειτουργικότητας από μόνα τους δεν αντισταθμίζουν τα
σχετικά έξοδα. Επιπλέον, μπορούν να προσφέρουν ευέλικτες μορφές και τη
δυνατότητα κάλυψης μεγάλης περιοχής. Ένα άλλο πλεονέκτημα που μπορεί να
προκύψει από τη διάδοσή τους είναι η μείωση του αντίκτυπου των
ηλεκτρονικών αποβλήτων, αφού τα τυπωμένα ηλεκτρονικά μπορούν να είναι
πολύ λιγότερο τοξικά για το περιβάλλον και πιο εύκολα ανακυκλώσιμα από
τα υπόλοιπα, ή ακόμη και βιοδιασπώμενα. Δεν μπορούν να ανταγωνιστούν τα
ηλεκτρονικά πυριτίου σε επιδόσεις λόγω της μεγάλης αντίστασης των
αγώγιμων μελανιών, της έλλειψης υποστήριξης για υψηλές συχνότητες και
της μεγάλης μεταβλητότητας κατά την κατασκευή. Ενώ η δυνατότητα να
καλύπτουν μεγάλες περιοχές είναι μερικές φορές επιθυμητή, πολλές
εφαρμογές απαιτούν σμίκρυνση που δεν μπορούν να προσφέρουν. Μια ποικιλία
ενεργών και παθητικών συσκευών, όπως τρανζίστορ, αντιστάσεις, πυκνωτές,
αισθητήρες, συλλέκτες και κεραίες μπορούν να υλοποιηθούν με αυτές.
Θεωρούνται ότι αποτελούν μια αναδυόμενη αγορά με σημαντικές δυνατότητες
διεύρυνσης του ρόλου των υπολογιστικών συστημάτων στην καθημερινή ζωή.
Μπορούν να βοηθήσουν στη διείσδυση του Internet-of-Things να φτάσει πολύ
βαθύτερα, και έτσι συνεργίζονται καλά με άλλες εξελίξεις στον τομέα. Μια
πρόσφατη έκθεση της IDTechEx[25] προβλέπει την παγκόσμια αγορά για τα
τυπωμένα εύκαμπτα ηλεκτρονικά, εξαιρουμένων των OLEDs, θα φθάσει τα 12
δισεκατομμύρια δολάρια έως το 2033.




## Εισαγωγή στην πανταχού παρούσα πληροφορική και δήλωση θέσης

Η τεχνολογία γενικά και πιο συγκεκριμένα ο υπολογισμός παίζει έναν
ολοένα και μεγαλύτερο ρόλο στη ζωή μας και δεν υπάρχουν ενδείξεις ότι η
τάση αυτή θα επιβραδυνθεί σύντομα. Εξακολουθεί ωστόσο να υπάρχει ακόμη
ένα σχετικά άκαμπτο χάσμα μεταξύ του πραγματικού κόσμου και του
υπολογιστικού τομέα, πράγμα που σημαίνει ότι οι περισσότερες από τις
αλληλεπιδράσεις μας με τον κόσμο γύρω μας δεν εμπεριέχουν την
πραγματοποίηση οποιουδήποτε υπολογισμού. Δεν είναι δύσκολο να
φανταστούμε αμέτρητα παραδείγματα όπου υπολογιστικά στοιχεία θα
προσέθεταν αξία σε καθημερινές δραστηριότητες όπως τα ψώνια από το
παντοπωλείο ή θα μείωναν την απαιτούμενη εργασία σε διαδικασίες
παραγωγής, όπως η μεταποίηση, εάν τα στοιχεία αυτά είχαν σχεδόν μηδενικό
κόστος και μεγαλύτερη ενσωματωσιμότητα που συνδέεται με αυτά.

Αν και σχεδόν όλοι στις ανεπτυγμένες χώρες φέρουν μαζί τους και
αλληλεπιδρούν με ισχυρούς υπολογιστές παντού όπου τυχαίνει να
βρίσκονται, η μορφή της αλληλεπίδρασης δεν μπορεί εύκολα να προσαρμοστεί
στο πλαίσιο όπου βρίσκονται. Δεν μπορεί κανείς απλά να ρωτήσει τις
μπανάνες που πήρε αν είναι αρκετά ώριμες, να φωνάξει τα κλειδιά του για
να βρει πού τα άφησε, να ελέγξει με τα παπούτσια του πόσα βήματα μπορούν
να κάνουν ακόμα. Επιπλέον, είναι σαφές ότι οι μη μετρήσιμες διαδικασίες
είναι τρομερά μη βελτιστοποιημένες σε σύγκριση με το τι θα μπορούσε να
επιτευχθεί αν μια συνεχής ροή λεπτομερούς πληροφόρησης από κάθε ένα από
τα στοιχεία που την απαρτίζουν και πρόσβαση σε έλεγχο της κάθε
λεπτομέρειας αυτών των στοιχείων ήταν διαθέσιμη.  Σκεφτείτε για
παράδειγμα ένα αγρόκτημα όπου κάθε μεμονωμένος καρπός σε κάθε δέντρο
έχει να παρακολουθείται η πρόοδος της ανάπτυξής του.

Παίρνοντας ουσιαστικά τις ιδέες του Διαδικτύου των Πραγμάτων (IoT) και
προωθώντας στο λογικό τους όριο, η πανταχού παρούσα
πληροφορική(ubiquitous computing) είναι ένα φιλόδοξο ιδανικό για ένα
μέλλον όπου κάθε προϊόν είναι μια έξυπνη συσκευή, κάθε παρατηρήσιμη
ιδιότητα, για την οποία οποιοσδήποτε θα μπορούσε λογικά να ενδιαφερθεί,
είναι προσβάσιμη. Αυτοκίνητα θα είναι σε θέση να πλοηγούνται με ασφάλεια
χωρίς πρόσβαση στην όραση ρωτώντας τις θέσεις των κοντινών συσκευών,
αφού οτιδήποτε δεν είναι συσκευή άμεσα, έχει τουλάχιστον μία ή
περισσότερες προσαρτημένες.

Τα τυπωμένα ηλεκτρονικά είναι σε θέση να διαδραματίσουν σημαντικό ρόλο τουλάχιστον στα πρώτα στάδια ενός τέτοιου μετασχηματισμού. Η εκτύπωση είναι επί του παρόντος η μόνη μέθοδος κατασκευής που μπορεί να παρέχει υπολογιστικά στοιχεία κάτω του cent, και το κόστος είναι το μεγαλύτερο εμπόδιο για το πόσο διαδεδομένα μπορούν να γίνουν. Επιπλέον, η μη τοξικότητα είναι ζωτικής σημασίας για να καταστεί δυνατή η προσθήκη τους σε ταχέως κινούμενα καταναλωτικά αγαθά που είναι αναλώσιμα σε αυτές τις κλίμακες. Η ελαστικότητα βοηθά επίσης στην ευκολότερη ενσωμάτωση.  Ακόμα και οι σχετικά "μέτριες" σε σύγκριση με το πλήρες όραμα εφαρμογές που μπορούμε να περιμένουμε ότι θα έρθουν τελικά, όπως οι ετικέτες RFID που αντικαθιστούν τους barcodes και επιτρέπουν στα καταστήματα να παρακολουθούν κάθε μεμονωμένο στοιχείο του αποθέματος ή οι τυπωμένοι αισθητήρες ποιότητας τροφίμων που καθιστούν τις ημερομηνίες λήξης παρωχημένες, έχουν μεγάλες δυνατότητες να διαταράξουν ένα ευρύ φάσμα βιομηχανιών.

Η μηχανική μάθηση μπορεί να επιταχύνει τη διαδικασία κατά πολλές τάξεις μεγέθους σε σύγκριση με το χρόνο που θα χρειάζονταν εξειδικευμένοι άνθρωποι σε πολλούς τομείς για να σχεδιάσουν ένα υπολογιστικό μοντέλο για να ερμηνεύσουν και να επεξεργαστούν τα δεδομένα των αισθητήρων. Σε πολλές περιπτώσεις, το αρχικό κόστος των μηχανικών θα ήταν αρκετό για να σταματήσει εντελώς η υιοθέτηση του προτύπου. Αν το μόνο που χρειάζεται είναι να συλλεχθούν και να επισημανθούν κάποια δεδομένα αισθητήρων, αυτό μπορεί εύκολα να αντιμετωπιστεί από οποιονδήποτε υπάλληλο. Εξαρτόμαστε επίσης από το ότι το autoML είναι αρκετά καλό για τις περισσότερες από αυτές τις εφαρμογές δεδομένων μικρής κλίμακας, καθώς διαφορετικά θα αντιμετωπίζαμε απλώς την ίδια δυσχέρεια με το να χρειαζόμαστε έναν επιστήμονα δεδομένων για κάθε μικρόπράγμα. Μέθοδοι για την ελάφρυνση των πόρων που απαιτούνται από το εκτυπωμένο σύστημα που υλοποιεί το μοντέλο, όπως η κβάντιση και η δυαδικοποίηση, μπορούν σαφώς να επεκτείνουν το εύρος του πόσο πολύπλοκη μπορεί να είναι η υποστηριζόμενη ταξινόμηση.

Η ιδέα της παρούσας διατριβής λαμβάνει χώρα σε ένα τέτοιο σενάριο. Έχω διασφαλίσει ότι η όλη διαδικασία από το σύνολο δεδομένων μέχρι τη netlist που μπορεί να περάσει στον εκτυπωτή δεν απαιτεί καμία χειροκίνητη παρέμβαση. Οποιοσδήποτε μπορεί να περάσει τα δεδομένα του αισθητήρα του στο ένα άκρο και να λάβει μετρήσεις για την ακρίβεια του μοντέλου, την επιφάνεια του κυκλώματος και τις απαιτήσεις ισχύος στο άλλο άκρο, χωρίς να απαιτούνται από αυτόν ειδικές γνώσεις σε οποιονδήποτε τομέα. Αυτό γίνεται συγκεκριμένα με τη χρήση εξειδικευμένων υλοποιήσεων δυαδικών νευρωνικών δικτύων, προκειμένου να αξιολογηθεί η αποτελεσματικότητά τους ως προς την παροχή μιας ραχοκοκαλιάς για τη διαδικασία αυτή.

Φανταστείτε, αν θέλετε, το σενάριο ενός ιδιοκτήτη καφετέριας. Αποφασίζει ότι θα ήθελε τα ποτήρια στα οποία σερβίρει τον καφέ του να υποδεικνύουν την ποσότητα ζάχαρης ή άλλων γλυκαντικών που χρησιμοποιούνται στο ρόφημα. Αυτό θα προλάβαινε τους πελάτες από το να αρπάζουν τον λάθος καφέ από το τραπέζι επειδή όλα φαίνονται δυσδιάκριτα. Αφού ψάχνουν σε ένα διαδικτυακό αποθετήριο για το ποιος αισθητήρας θα ήταν χρήσιμος εδώ, παραγγέλνουν μερικά δειγματοληπτικά φύλλα αυτών των εκτυπωμένων αισθητήρων και ένα μικρό gadget που κουμπώνει στο φύλλο και καταγράφει τις μετρήσεις των αισθητήρων. Αφού τους βυθίσουν σε δώδεκα καφέδες με διαφορετικά μίγματα γλυκαντικών μέσα, συνδέουν το gadget στον υπολογιστή τους και παίρνουν ένα spreadsheet με τις τιμές των αισθητήρων για κάθε περίοδο βύθισης. Απλώς προσθέτουν την ετικέτα που αποφάσισαν ότι αντιστοιχεί σε κάθε επίπεδο γλυκαντικού και περνούν το φύλλο στο σύστημα. Αποφασίζουν ότι η αναφερόμενη ακρίβεια και έκταση είναι διαχειρίσιμες και παραγγέλνουν το κύκλωμα που προκύπτει να τυπωθεί σε μια παρτίδα εύκαμπτων επιθεμάτων που μπορούν να επικολληθούν στο εσωτερικό των ποτηριών.

# Υπόβαθρο - Προαπαιτούμενα

## Χρήσεις των τυπωμένων ηλεκτρονικών

Η χρήση των τυπωμένων ηλεκτρονικών που οι περισσότεροι άνθρωποι μπορεί να γνωρίζουν στην καθημερινή τους ζωή είναι η μεμβράνη που χρησιμοποιείται για την ανίχνευση των πατημάτων των πλήκτρων στα περισσότερα μη μηχανικά πληκτρολόγια, ή ίσως οι αποπαγωτές παρμπρίζ.

Άλλες χρήσεις περιλαμβάνουν:

- Αισθητήρες: τα εύκαμπτα, βιοδιασπώμενα και ελαστικά αισθητήρια στοιχεία επιτρέπουν την αποτελεσματική παρακολούθηση πολλών διεργασιών. Μια ποικιλία ιδιοτήτων του κόσμου μπορεί να μετρηθεί με τυπωμένους αισθητήρες, όπως η θερμοκρασία, η αφή, η πίεση, τα αέρια, η υγρασία, τα επίπεδα φωτός και η παρουσία ορισμένων χημικών ουσιών. Η ευελιξία και η μη τοξικότητα είναι ιδιαίτερα σημαντικές για την ιατρική παρακολούθηση, γι' αυτό και οι βιοαισθητήρες έχουν λάβει μεγάλη προσοχή, ενώ ορισμένοι από αυτούς (π.χ. εκτυπωμένα επιθέματα ανίχνευσης επιληπτικών κρίσεων) είναι ήδη διαθέσιμοι στο εμπόριο.

- RFID: Το RFID (Radio Frequency Identification) είναι μια ασύρματη τεχνολογία ανάγνωσης, η οποία επιτρέπει την απρόσκοπτη ταυτοποίηση και παρακολούθηση αντικειμένων μέσω μοναδικών κωδικών αναγνώρισης που αποθηκεύονται στις ετικέτες. Στόχος των τυπωμένων RFID είναι η αντικατάσταση των σημερινών μεθόδων αναγνώρισης αγαθών με έξυπνες ετικέτες. Οι ετικέτες RFID είναι συνήθως παθητικές και δεν απαιτούν παροχή ρεύματος. Μπορούν να κατασκευαστούν φτηνά με οποιαδήποτε κοινή μέθοδο εκτύπωσης. Έχει παρουσιαστεί ότι λειτουργούν σε συχνότητες 5G και WLAN και μπορούν να έχουν ακόμη και δυνατότητες αισθητήρων. Επί του παρόντος χρησιμοποιούνται κυρίως στα εισιτήρια και στην καταπολέμηση της κλοπής.

- Συγκομιδή ενέργειας: Οι τυπωμένες μπαταρίες μπορούν να παρέχουν ενέργεια στα λειτουργικά μέρη των τυπωμένων κυκλωμάτων μόνο για περιορισμένο χρονικό διάστημα και μπορεί να καταλαμβάνουν σημαντικό μέρος της επιφάνειας του κυκλώματος. Προκειμένου να καταστεί δυνατή η μεγαλύτερη αυτονομία στα αναπτυγμένα τυπωμένα ηλεκτρονικά συστήματα, η ικανότητα συγκομιδής ενέργειας από το περιβάλλον είναι ζωτικής σημασίας. Οι τυπωμένοι συλλέκτες μπορούν να αντλήσουν ενέργεια από ραδιοσήματα, δονήσεις και συνηθέστερα από το φως. Οι τυπωμένες φωτοηλεκτρικές/ηλιακές κυψέλες έχουν επίσης προσελκύσει μεγάλο ενδιαφέρον και εκτός του πεδίου των συγκομιστών για μικρά κυκλώματα, καθώς ενώ η απόδοσή τους δεν φτάνει τα επίπεδα των άκαμπτων ηλιακών κυψελών πυριτίου μπορούν να αναπτυχθούν σε μια ευρύτερη επιλογή χώρων, συμπεριλαμβανομένων των ενδυμάτων.

- Φωτισμός: Οι λυχνίες LED έχουν γίνει η κυρίαρχη πηγή φωτισμού, στη θέση των ενεργειακά σπάταλων λαμπτήρων πυρακτώσεως και των περιβαλλοντικών ναρκοπεδίων του φωτισμού με φθορίζοντες λαμπτήρες. Οι OLED αυξάνουν περαιτέρω την εξοικονόμηση ενέργειας και παράγουν πιο απαλό και ομοιόμορφο φωτισμό. Η εκτύπωση φαίνεται να αποτελεί μια πολλά υποσχόμενη λύση για την κατασκευή OLED χαμηλού κόστους με ανταγωνιστική φωτιστική απόδοση και να τους επιτρέπει να καλύπτουν μεγάλες επιφάνειες. Με αυτόν τον τρόπο έχουν καταδειχθεί φωτεινά πάνελ πάχους λεπτού χαρτιού.

- Οθόνες: Οι οθόνες είναι μία από τις πιο ώριμες πτυχές των τυπωμένων ηλεκτρονικών, με μεγάλες εκτυπωμένες οθόνες OLED 4Κ να είναι διαθέσιμες στο εμπόριο. Επιτρέπουν εύκαμπτες οθόνες, οι οποίες έχουν πολλές εφαρμογές στα ηλεκτρονικά είδη ευρείας κατανάλωσης και στα φορέσιμα και έτσι αποτελούν μια αγορά 5 δισεκατομμυρίων δολαρίων. Ακόμη και αν η εύκαμπτη οθόνη δεν είναι πλήρως τυπωμένη, τα τυπωμένα ηλεκτρονικά μπορούν να της προσφέρουν πρόσθετα χαρακτηριστικά. Οι οθόνες QLED μπορεί επίσης μια μέρα να εκτυπωθούν, αν η ακρίβεια εκτύπωσης συνεχίσει να αυξάνεται.

- Wearables: Έξυπνες ηλεκτρονικές συσκευές που φοριούνται είναι ήδη πολύ δημοφιλείς, όπως έξυπνα ρολόγια ή ακουστικά βαρηκοΐας ή δαχτυλίδια NFC. Τα τυπωμένα ηλεκτρονικά έχουν πολλά να προσφέρουν στον χώρο χάρη στην ευελιξία τους. Έχουν αναπτυχθεί αγώγιμα υλικά που μπορούν να εκτυπωθούν σε ύφασμα και να αντέξουν στο πλύσιμο με απορρυπαντικό, επιτρέποντας την ενσωμάτωση ηλεκτρονικών σε κανονικά ρούχα. Οι εκτυπωμένοι αισθητήρες μπορούν να χρησιμοποιηθούν για την παρακολούθηση της δραστηριότητας, ένα από τα πιο δημοφιλή χαρακτηριστικά των σημερινών έξυπνων ρολογιών, ή για την παρακολούθηση της υγείας, με εκτυπωμένα επιθέματα για την ανίχνευση επιληπτικών κρίσεων που κυκλοφορούν ήδη στην αγορά. Μπορεί επίσης να φανταστεί κανείς ότι θα ενδιέφεραν τη βιομηχανία της μόδας.

## Μέθοδοι κατασκευής

Τα τυπωμένα ηλεκτρονικά κατασκευάζονται με τεχνικές από τη βιομηχανία γραφικών εκτυπώσεων. Διακρίνονται σε τεχνικές εκτύπωσης με επαφή ή R2R που χρησιμοποιούν πρότυπο και σε ανέπαφες που δεν χρησιμοποιούν. Απαιτούνται πολλαπλά βήματα εκτύπωσης για τα πολλαπλά στρώματα του κυκλώματος. Οι τεχνικές εκτύπωσης επαφής περιλαμβάνουν:  

- Βαθυτυπία: Στη βαθυτυπία, ο κύλινδρος εκτύπωσης χαράσσεται με το πρότυπο και βυθίζεται εν μέρει στο μελάνι κατά τη διάρκεια της διαδικασίας, με μια λεπίδα να απορρίπτει το πλεονάζον μελάνι. Αυτό αφήνει μόνο μελάνι στα τμήματα του προτύπου, το οποίο μεταφέρεται στο υπόστρωμα υπό πίεση. Η βαθυτυπία μπορεί να εκτυπώσει με υψηλή ανάλυση και ταχύτητα σε σύγκριση με άλλες μεθόδους, αλλά το κόστος της χάραξης του κυλίνδρου την καθιστά χρήσιμη μόνο για μεγάλες παρτίδες.  

- Offset: Στην εκτύπωση offset το σχήμα του προτύπου εναποτίθεται σε έναν κύλινδρο με μια ουσία που δέχεται μελάνι και το αρνητικό του προτύπου καλύπτεται με ουσίες που απωθούν το μελάνι. Με αυτόν τον τρόπο μόνο το σχήμα του προτύπου απορροφά μελάνι από έναν κύλινδρο μελάνης και στη συνέχεια μεταφέρεται στο υπόστρωμα μέσω ενός ενδιάμεσου κυλίνδρου. 

- Φλεξογραφία: Το πρότυπο ενσωματώνεται σε μια εύκαμπτη πλάκα που τυλίγεται γύρω από έναν κύλινδρο εκτύπωσης έτσι ώστε τμήματα του σχήματος να υπερυψώνονται. Το μελάνι που εφαρμόζεται σε αυτόν τον κύλινδρο μεταφέρεται σε έναν δεύτερο κύλινδρο και στη συνέχεια στο υπόστρωμα, μόνο εάν βρίσκεται στα ανυψωμένα μέρη που αντιστοιχούν στο πρότυπο. Μπορεί να υποστηρίξει τόσο μη πορώδη όσο και πορώδη υποστρώματα.  

- Μεταξοτυπία: Το "κόσκινο" σε αυτή την περίπτωση είναι ένα στενά συνδεδεμένο ύφασμα, έτσι ώστε το μελάνι να μπορεί να περάσει μόνο με την άσκηση πίεσης. Ένα στένσιλ του προτύπου τοποθετείται πάνω στο κόσκινο και μια λεπίδα ωθεί το μελάνι μέσω των ακάλυπτων τμημάτων στο υπόστρωμα. Η μεταξοτυπία είναι η απλούστερη τεχνική από όλες και μπορεί να δημιουργήσει παχύτερα στρώματα και να εκτυπώσει σε καμπύλες επιφάνειες. Πάσχει από χαμηλότερη ανάλυση σε σύγκριση με άλλες μεθόδους.

- Εκτύπωση με ταμπόν: Το μελάνι μπαίνει πάνω σε μια χάραξη του προτύπου. Στη συνέχεια, ένα μαλακό ταμπόν πιέζεται πάνω του και μεταφέρει το μελάνι με το επιθυμητό σχήμα στο υπόστρωμα. Μπορεί να εκτυπώσει σε επιφάνειες τρισδιάστατων αντικειμένων.

Οι τεχνικές χωρίς επαφή περιλαμβάνουν:

- Εκτύπωση μελάνης: Το μελάνι πέφτει πάνω στο υπόστρωμα από μικροσκοπικά στόμια. Είτε υπάρχουν αρκετά στόμια για να καλύψουν το πλάτος της εκτύπωσης είτε μπορούν να μετακινηθούν για να το κάνουν. Δεν απαιτεί μεγάλο εξοπλισμό και διαφορετικά σχέδια μπορούν να εκτυπωθούν σε υψηλή ανάλυση χωρίς επιπλοκές στην αλλαγή προτύπων, γεγονός που την καθιστά ιδανική για εκτύπωση κατά παραγγελία. Το κύριο μειονέκτημά της είναι η ταχύτητα εκτύπωσης. Η εκτύπωση συνεχούς ροής μελάνης έχει μια ροή μελάνης που κατευθύνεται πάνω στο υπόστρωμα ή σε έναν κάδο απόρριψης, ανάλογα με τις πληροφορίες του σχεδίου. Μπορεί να εκτυπώσει μεγαλύτερες παρτίδες από την Drop-on-Demand inkjet, αλλά με πέντε φορές χαμηλότερη ανάλυση. Η DoD ελέγχει αν θα ρέει μελάνι χρησιμοποιώντας μια βαλβίδα, ώστε να μην σπαταλιέται μελάνι. Αναπτύσσεται σε μικρότερες κλίμακες από τη συνεχή ροή.

- Αεροζόλ: Το μελάνι κονιορτοποιείται σε λεπτή ομίχλη μέσω πεπιεσμένου αέρα ή υπερήχων, επιταχύνεται και ψεκάζεται πάνω στο υπόστρωμα. Μπορεί να χρησιμοποιηθεί σε καμπύλες επιφάνειες και μπορεί να παρέχει ακόμη μικρότερα μεγέθη χαρακτηριστικών από ό,τι ο inkjet, αλλά είναι απαγορευτικά αργό.

Επιπλέον, μέθοδοι όπως η εναπόθεση υπό κενό, κατά την οποία εξατμιζόμενο μελάνι καλύπτει μια επιφάνεια σε κενό αέρος, ή η νανολιθογραφία με στυλό εμβάπτισης, κατά την οποία ένα μικροσκόπιο ατομικής δύναμης εφαρμόζει το μελάνι με μεγάλη ακρίβεια στο υπόστρωμα, θεωρούνται μερικές φορές ότι περιλαμβάνονται στην ομπρέλα των τυπωμένων ηλεκτρονικών, και παρόλο που μπορούν να επιτύχουν μικρότερα μεγέθη χαρακτηριστικών απαιτούν εξειδικευμένο εξοπλισμό και δεν είναι τόσο φιλικές προς το κόστος όσο οι παραδοσιακές μέθοδοι εκτύπωσης και συνεπώς λιγότερο συναφείς.




## Μελάνια

Για την υλοποίηση λειτουργικών κυκλωμάτων απαιτούνται μελάνια με αγώγιμες, ημιαγώγιμες και διηλεκτρικές ιδιότητες. Συνήθως αποτελούνται από νανοσωματίδια υλικών με αυτές τις ιδιότητες που αναμειγνύονται με διαλύτη στο επιθυμητό ιξώδες και άλλα πρόσθετα για να καταστεί δυνατή η διαδικασία εκτύπωσης. Μπορούν να χρησιμοποιηθούν τόσο οργανικά όσο και ανόργανα υλικά.

- Αγώγιμα μελάνια: Η πλειονότητα των υλικών για αγώγιμα μελάνια είναι μεταλλικά νανοσωματίδια, με πιο συνηθισμένο το ασήμι. Αν και ο άργυρος ανήκει στην κατηγορία των πολύτιμων μετάλλων, το ασημένιο μελάνι δεν είναι φοβερά ακριβό, με στυλό με αγώγιμο ασημένιο μελάνι να κοστίζει λιγότερο από 4 δολάρια. Άλλα μέταλλα που χρησιμοποιούνται είναι ο χρυσός, το αλουμίνιο και ο χαλκός. Τα μελάνια χαλκού και αλουμινίου υφίστανται πολύ χειρότερη γήρανση από τα ασημένια. Τα οργανικά μελάνια βασίζονται συχνά σε νανοσωλήνες άνθρακα ή γραφένιο. Χρησιμοποιούνται επίσης φθηνότερα πολυμερή, παρά την κατώτερη αγωγιμότητά τους. Το πιο δημοφιλές είναι το PEDOT:PSS. Κεραμικά υλικά χρησιμοποιούνται επίσης σε αγώγιμα μελάνια, κυρίως οξείδιο του κασσίτερου του ινδίου(ITO), αν και πρόκειται για ακριβό υλικό.

- Ημιαγώγιμα μελάνια: Τα πιο συνηθισμένα ανόργανα υλικά που χρησιμοποιούνται είναι το πυρίτιο και το γερμάνιο και από τα οργανικά τα περισσότερα βασίζονται και πάλι σε CNT ή γραφένιο. Από αυτά μπορούν να παραχθούν τόσο υλικά τύπου p όσο και υλικά τύπου n, αν και οι τύποι p έχουν ιστορικά πολύ υψηλότερη απόδοση. (Το αντίθετο ισχύει για τα τρανζίστορ με πύλη ηλεκτρολύτη).

- Διηλεκτρικά μελάνια: Το διηλεκτρικό στρώμα πρέπει να είναι παχύτερο από το αγώγιμο και το ημιαγώγιμο στρώμα, ώστε να μην διαρρέει φορτίο μέσω αυτού. Ως ενεργό συστατικό μπορούν να χρησιμοποιηθούν υλικά υποστρώματος, κεραμικά οξείδια και πολυμερή.





## TinyML

Edge computing enables applications where data processing is location sensitive. It provides greater security, privacy and availability guarantees to the end users. It is a fundamental component of the IoT market, that can reduce the dependance on cloud systems. The main bottleneck to it's addoption spread are the resource contstraints it imposes.  

To deal with the demand of running machine learning applications on the edge for inteligent devices, traditional architectures are too bloated to make the cut. Many models nowadays demand computing capabilities out of reach for even the most high-end consumer hardware, let alone low power devices. TinyML is the field of optimising machine learning architectures to run on ultra resource constrained systems, typically no more than a few milliwatts.  

Multidisciplinary work is demanded for this undertaking, as both the ML algorithms, the software and the hardware that supports them must accomodate these constraints while not compromising the accuracy of the models to a significant degree. Roughly the constraints at play are energy efficiency, processing capacity, memory space and production and engineering costs. It should be emphasised that the concern is with the inference step of ML although enabling the training phase on edge hardware is also it's own niche endeavor. 

Since pretrained ML models cannot be run on these terms by default, end to end pipelines are required from data acquisition to inference, giving rise to the field of TinyML-as-a-Service or TinyMaaS. Special precausions must be taken at every intermediate step to lead to a runtime model lightweight enough.  

Some approaches to the problem include:

## TinyML

Το Edge Computing επιτρέπει εφαρμογές στις οποίες η επεξεργασία δεδομένων είναι ευαίσθητη στην τοποθεσία. Παρέχει μεγαλύτερες εγγυήσεις ασφάλειας, ιδιωτικότητας και διαθεσιμότητας στους τελικούς χρήστες. Αποτελεί θεμελιώδες στοιχείο της αγοράς IoT, που μπορεί να μειώσει την εξάρτηση από τα συστήματα cloud. Το κύριο εμπόδιο στην εξάπλωση της προσθήκης είναι οι περιορισμοί πόρων που επιβάλλει.  

Για να αντιμετωπιστεί η απαίτηση εκτέλεσης εφαρμογών μηχανικής μάθησης στην ακμή για έξυπνες συσκευές, οι παραδοσιακές αρχιτεκτονικές είναι πολύ διογκωμένες για να ανταποκριθούν. Πολλά μοντέλα απαιτούν σήμερα υπολογιστικές δυνατότητες που δεν είναι εφικτές ακόμη και για το πιο high-end καταναλωτικό υλικό, πόσο μάλλον για συσκευές χαμηλής ισχύος. Το TinyML είναι ο τομέας της βελτιστοποίησης των αρχιτεκτονικών μηχανικής μάθησης ώστε να εκτελούνται σε συστήματα με εξαιρετικά περιορισμένους πόρους, συνήθως όχι περισσότερους από μερικά χιλιοστά του βατ.  

Για το εγχείρημα αυτό απαιτείται διεπιστημονική εργασία, καθώς τόσο οι αλγόριθμοι ML, όσο και το λογισμικό και το υλικό που τους υποστηρίζει πρέπει να προσαρμόζονται σε αυτούς τους περιορισμούς, χωρίς να διακυβεύεται σε σημαντικό βαθμό η ακρίβεια των μοντέλων. Περίπου οι περιορισμοί που παίζουν ρόλο είναι η ενεργειακή απόδοση, η ικανότητα επεξεργασίας, ο χώρος μνήμης και το κόστος παραγωγής και σχεδιασμού. Θα πρέπει να τονιστεί ότι η ανησυχία αφορά το στάδιο inference της ML, αν και η δυνατότητα υλοποίησης της φάσης εκπαίδευσης σε υλικό άκρων αποτελεί επίσης μια δική της εξειδικευμένη προσπάθεια. 

Δεδομένου ότι τα προ-εκπαιδευμένα μοντέλα ML δεν μπορούν να εκτελούνται σε αυτούς τους όρους κατά κανόνα, απαιτούνται pipelines από άκρη σε άκρη, από την απόκτηση δεδομένων έως την εξαγωγή συμπερασμάτων, δημιουργώντας τον τομέα της TinyML-as-a-Service ή TinyMaaS. Πρέπει να λαμβάνονται ειδικές προφυλάξεις σε κάθε ενδιάμεσο βήμα ώστε να οδηγηθούμε σε ένα αρκετά ελαφρύ μοντέλο εκτέλεσης.  

Ορισμένες προσεγγίσεις του προβλήματος περιλαμβάνουν:

- Μια εναλλακτική λύση στα κοινά μοντέλα ML που μπορεί να λειτουργήσει με χαμηλότερους ενεργειακούς προϋπολογισμούς είναι ο υπερδιάστατος υπολογισμός (HDC). Σε αυτό το παράδειγμα, αξιοποιείται η ιδιότητα των χώρων υψηλών διαστάσεων ότι τα τυχαία δειγματισμένα διανύσματα είναι σχεδόν σίγουρα σχεδόν ορθογώνια μεταξύ τους για την αναπαράσταση κλάσεων και χαρακτηριστικών ως σύνολα υπερδιανυσμάτων. Τα δείγματα αντιστοιχίζονται σε querry υπερδιανύσματα κατά τη διάρκεια του inference, τα οποία στη συνέχεια συγκρίνονται με τους κωδικοποιητές κλάσεων και το πιο παρόμοιο δηλώνεται ως η προβλεπόμενη κλάση. Τα διανύσματα έχουν συνήθως δυαδικά στοιχεία 1 ή -1 για τη μείωση των απαιτήσεων. Μπορεί να χειριστεί θορυβώδη ή/και ελλιπή δεδομένα, γεγονός που αποτελεί μεγάλο πλεονέκτημα. Δυστυχώς ο αριθμός των διαστάσεων που απαιτούνται για πολλά προβλήματα είναι τόσο μεγάλος που δεν μπορούμε να κάνουμε εξοικονόμηση πόρων με αυτή τη μέθοδο. 

- Μια από τις πιο διαδεδομένες μεθόδους στο πεδίο είναι η αναζήτηση περιορισμένης νευρωνικής αρχιτεκτονικής (constrained neural architecture search, NAS). Η αναζήτηση νευρωνικής αρχιτεκτονικής εξετάζει ένα χώρο αναζήτησης διαφορετικών αρχιτεκτονικών για διαφορετικές υπερπαραμέτρους. Ένας αλγόριθμος προσπαθεί να εντοπίσει την καλύτερη δυνατή αρχιτεκτονική για τη μεγιστοποίηση της απόδοσης του μοντέλου στην επίτευγματική συνάρτηση. Ένας αξιολογητής εξετάζει τους συμβιβασμούς μεταξύ ακρίβειας και αποδοτικότητας κατά την εγκατάσταση, δεδομένων των δηλωμένων περιορισμών μνήμης, ενέργειας κ.λπ. Μπορεί να εξετάσει ένα ή πολλά μοντέλα-στόχους σε μία ή περισσότερες πλατφόρμες. Τόσο ο χώρος αναζήτησης όσο και ο αλγόριθμος αναζήτησης έχουν επίγνωση του υλικού. Πρόκειται για ένα πρόβλημα βελτιστοποίησης πολλαπλών στόχων που συνήθως υλοποιείται ως πρόβλημα βελτιστοποίησης πολλαπλών σταδίων ενός στόχου. Η εκτέλεση της αναζήτησης είναι πολύ χρονοβόρα, αλλά τα αποτελέσματα υπερτερούν των περισσότερων χειροκίνητα σχεδιασμένων δικτύων.

- Μια προφανής προσέγγιση για τον χειρισμό του προβλήματος του περιορισμού μνήμης είναι η χρήση τεχνικών συμπίεσης δεδομένων στο μοντέλο ML. Μια βασική προσέγγιση που έχει επιδείξει συντελεστές συμπίεσης 15-40 φορές είναι τα προϊόντα Kronecker (KP). Ωστόσο, μπορεί να προκύψουν μεγάλες ποινές ακρίβειας και μια μέθοδος που ονομάζεται ντοπαρισμένο προϊόν Kronecker (DKP) αξιοποιεί την προσαρμογή των συν-μητρών για να προσπαθήσει να τις διορθώσει.

- Once-for-all network είναι το όνομα μιας μεθόδου για την αποσύνδεση της αναζήτησης της αρχιτεκτονικής από την εκπαίδευση του μοντέλου. Η OFA μπορεί να βρει εξειδικευμένα υποδίκτυα που διατηρούν σε μεγάλο βαθμό την ακρίβεια του μεγαλύτερου μοντέλου πλήρους ακρίβειας χωρίς την ανάγκη εκπαίδευσης. Ένας πρόσφατος αλγόριθμος προοδευτικής συρρίκνωσης (PSA) μειώνει το βάθος και το πλάτος των στρωμάτων διατηρώντας υψηλότερη τελική ακρίβεια από την αντίστοιχη γενική περικοπή.




- Η υπερπαραμετροποίηση είναι η ιδιότητα ενός νευρωνικού δικτύου όπου οι πλεονάζοντες νευρώνες δεν βελτιώνουν την ακρίβεια των αποτελεσμάτων. Αυτός ο πλεονασμός μπορεί συχνά να αφαιρεθεί με μικρή ή καθόλου απώλεια ακρίβειας. Τα πλήρως συνδεδεμένα βαθιά νευρωνικά δίκτυα απαιτούν N^2 συνδέσεις μεταξύ των νευρώνων. Το κλάδεμα του δικτύου αφαιρεί παραμέτρους που δεν επηρεάζουν την ακρίβεια σε μεγάλο βαθμό. Μια συνηθισμένη περίπτωση όπου αυτό μπορεί εύκολα να γίνει είναι όταν οι παράμετροι είναι είτε μηδέν είτε αρκετά κοντά σε αυτό. Ομοίως όταν οι τιμές των παραμέτρων είναι περιττά επαναλαμβανόμενες. Μπορεί να εφαρμοστεί σε οποιαδήποτε κλίμακα, από μεμονωμένες συνδέσεις, νευρώνες έως ολόκληρα επίπεδα. Όταν μια διαδικασία κλαδέματος έχει ως αποτέλεσμα το νευρωνικό δίκτυο να χάσει τη συμμετρική του δομή αναφέρεται ως μη δομημένο κλάδεμα, διαφορετικά πρόκειται για δομημένο κλάδεμα. Το μη δομημένο κλάδεμα οδηγεί σε αραιούς πίνακες βαρών που οι γενικοί επεξεργαστές δεν εκτελούν αποτελεσματικά.  Η επανεκπαίδευση ενός δικτύου μετά το κλάδεμα των παραμέτρων που δεν συνέβαλαν αρκετά μπορεί να του επιτρέψει να επιτύχει υψηλότερες ακρίβειες από ό,τι πριν. Ακόμα και το κλάδεμα ενός τυχαία αρχικοποιημένου δικτύου χωρίς εκπαίδευση πριν ή μετά μπορεί να οδηγήσει σε ευπρεπή ακρίβεια. Το κλάδεμα χωρίζεται σε στατικό κλάδεμα και δυναμικό κλάδεμα. Το στατικό κλάδεμα αφαιρεί νευρώνες μεταξύ των σταδίων εκπαίδευσης και λειτουργίας, ενώ στο δυναμικό κλάδεμα αυτό συμβαίνει κατά τη διάρκεια της εκτέλεσης. Συνήθως όλα τα βάρη του μοντέλου είναι διαθέσιμα κατά τον χρόνο εκτέλεσης και ένας ελεγκτής συμπεριλαμβάνει ή αποκλείει υπό όρους τμήματα του δικτύου από τον υπολογισμό με βάση την ανίχνευση συγκεκριμένων χαρακτηριστικών μοτίβων. Αυτός ο ελεγκτής είναι συχνά επίσης ένα εκπαιδευμένο μοντέλο μηχανικής μάθησης. Τα κριτήρια για το ποια στοιχεία πρέπει να κλαδευτούν περιλαμβάνουν το brute-force pruning, όπου ολόκληρο το μοντέλο αναζητείται στοιχείο προς στοιχείο για να βρεθούν εκείνα που δεν επηρεάζουν το αποτέλεσμα. Για το κλάδεμα των νευρώνων μπορούν να χρησιμοποιηθούν νόρμες των διανυσμάτων βάρους, ιδίως η δημοφιλής νόρμα L1 στη μέθοδο LASSO. Το Optimal Brain Damage χρησιμοποιεί τη δεύτερη παράγωγο ή τον Εσσιανό πίνακα της συνάρτησης απωλειών για τον εντοπισμό μη αναγκαίων βαρών και διαδέχθηκε από το παρόμοιο Optimal Brain Surgeon. Ο υπολογισμός αυτών των παραγώγων είναι πολύ υπολογιστικά δαπανηρός για να εφαρμοστεί σε μεγαλύτερα δίκτυα. Το Average Percentage Of Zeros (Μέσο ποσοστό μηδενικών) είναι μια μέθοδος για να κρίνεται αν οι έξοδοι ενός νευρώνα συμβάλλουν συνήθως στο αποτέλεσμα. Το κλάδεμα με βάση την ποινή εισάγει περιορισμούς κατά τη διάρκεια της εκπαίδευσης, ώστε περισσότερα βάρη να είναι κοντά στο μηδέν και έτσι να μπορούν να κλαδευτούν. Η επιλογή χαρακτηριστικών αφαιρεί τα χαρακτηριστικά εισόδου του μοντέλου που δεν αξιοποιούνται επαρκώς. Αποτρέπει την υπερβολική προσαρμογή και επιταχύνει την εκπαίδευση. Μια άλλη μέθοδος ομαδοποιεί τα κρυμμένα χαρακτηριστικά ενός επιπέδου και αφαιρεί εκείνα που είναι αρκετά κοντά ώστε να είναι περιττά. Το επαναληπτικό κλάδεμα ενός δικτύου και στη συνέχεια η επανεκπαίδευσή του μόνο με τα εναπομείναντα στοιχεία επιτρέπει την αφαίρεση πολύ μεγαλύτερου ποσοστού παραμέτρων χωρίς να βλάπτεται η απόδοση. Η απόσταξη γνώσης με το αρχικό δίκτυο ως δάσκαλο και το κλαδεμένο δίκτυο ως μαθητή μπορεί να χρησιμοποιηθεί για την ανάκτηση της χαμένης ακρίβειας.




- Η απόσταξη γνώσης είναι μια διαδικασία εκπαίδευσης ενός μικρότερου, ρηχότερου μαθητικού δικτύου για να αποδίδει κατά ένα μεγάλο μέρος τα logits εξόδου ενός μεγαλύτερου, ικανότερου δικτύου δασκάλου που έχει εκπαιδευτεί με ικανοποιητική ακρίβεια. Οι πιο προηγμένες παραλλαγές περιλαμβάνουν σύνολα μικρών δικτύων που το καθένα προσπαθεί να ταιριάξει με τα αποτελέσματα του συγκεντρωμένου συνόλου ή την αυτοαπόσταξη κατά την οποία τα ρηχότερα στρώματα ενός βαθύ νευρωνικού δικτύου προσπαθούν να μάθουν να ταιριάζουν με τα πιο περίπλοκα χαρακτηριστικά των βαθύτερων στρωμάτων. Εάν η διαφορά μεγέθους μεταξύ των δικτύων μαθητή και δασκάλου είναι πολύ μεγάλη, ένα ενδιάμεσου μεγέθους δίκτυο βοηθού δασκάλου λαμβάνει τις απαντήσεις του δασκάλου και στη συνέχεια τις αποστάζει στο μαθητή.

- Η κβάντιση είναι η διαδικασία μείωσης της αριθμητικής ακρίβειας των τιμών στο μοντέλο. Τα δίκτυα χρησιμοποιούν συνήθως αριθμούς κινητής υποδιαστολής 32 bit κατά τη διάρκεια της εκπαίδευσης[22]. Οι πιο συνηθισμένοι στόχοι κβαντισμού για αυτά είναι είτε ακέραιοι αριθμοί 8-bit είτε ακέραιοι αριθμοί 4-bit. Σε πολλές περιπτώσεις το δίκτυο δεν αξιοποιεί πλήρως αυτό το επίπεδο ακρίβειας. Η μείωση της ακρίβειας σε αυτές τις περιπτώσεις μπορεί να ανακουφίσει τον υπολογιστικό φόρτο που συνεπάγεται με αμελητέες θυσίες ακρίβειας. Η εκπαίδευση με επίγνωση της κβάντισης είναι μια διαδικασία κατά την οποία το δίκτυο πλήρους ακρίβειας εκπαιδεύεται εκ νέου στη μειωμένη μορφή. Διαδέχεται την κβάντιση του δικτύου μόνο μετά την ολοκλήρωση της διαδικασίας εκπαίδευσης. Όταν η μέθοδος φτάνει στα όριά της, η ακρίβεια μειώνεται σε 1 bit. Τα δίκτυα με ακρίβεια ενός μόνο bit ονομάζονται δυαδικά νευρωνικά δίκτυα(BNNs).

## Binary Neural Networks

BNN είναι ο όρος για τα νευρωνικά δίκτυα που έχουν τόσο τις ενεργοποιήσεις όσο και τα βάρη με ακρίβεια 1 bit σε όλα τα κρυφά στρώματα. Τα στρώματα εισόδου οφείλουν να έχουν εισόδους υψηλότερης ακρίβειας, ώστε το δίκτυο να λαμβάνει επαρκείς πληροφορίες για να είναι δυνατή η ταξινόμηση, ενώ τα στρώματα εξόδου των ταξινομητών έχουν τις ενεργοποιήσεις τους να συγκρίνονται μεταξύ τους για να αποφασίσουν για την προβλεπόμενη κλάση, οπότε δεν μπορούν να δυαδικοποιηθούν. Ο πιο συνηθισμένος τομέας για τα BNN είναι τα Convolutional Neural Networks(CNNs). Παρουσιάστηκαν ανεξάρτητα το 2016 από τις εργασίες [23] και [24].

Πέρα από τη μείωση του μεγέθους αποθήκευσης που απαιτείται για τα βάρη $32\times$ σε σύγκριση με ένα δίκτυο πλήρους ακρίβειας 32-bit της ίδιας αρχιτεκτονικής, το υπολογιστικό κόστος μειώνεται επίσης σημαντικά, καθώς οι πράξεις πολλαπλασιασμού-συσσώρευσης(MAC) μπορούν να πραγματοποιηθούν με πράξεις XNOR και popcount. Αυτό μπορεί να οδηγήσει σε βελτίωση της ταχύτητας έως και $58\times$.

Κατά τη διάρκεια της εκπαίδευσης, χρησιμοποιούνται υποκείμενα βάρη υψηλότερης ακρίβειας για να γίνει η μάθηση πιο ισχυρή. Στη φάση προς τα εμπρός διάδοσης, αυτά τα ακριβέστερα βάρη, $W$, και οι ενεργοποιήσεις από το προηγούμενο επίπεδο $I$ δυαδικοποιούνται χρησιμοποιώντας τη συνάρτηση προσήμου:

$$ 
sign(x) = \begin{dcases}
    +1, & \text{if } x \geq 0\\
    -1,              & \text{if } x < 0
\end{dcases}
$$

Οι δυαδικές πράξεις $({-1,1},*)$ και $({0,1},\odot)$ είναι ισόμορφες, οπότε ο πολλαπλασιασμός των βαρών με τις ενεργοποιήσεις γίνεται με τη χρήση της πράξης XNOR όταν οι δυαδικές τιμές {-1,1} κωδικοποιούνται στις λογικές τιμές {0,1} για να αποθηκευτούν σε ένα bit.

Αυτή η απεικόνιση μπορεί να αναπαρασταθεί με τον γραμμικό μετασχηματισμό $f(x) = \frac{x+1}{2}$, αφού $f(-1) = 0$ και $f(1)=1$. Η συσσώρευση και η επακόλουθη δυαδικοποίηση των προϊόντων ενεργοποίησης-βάρους $sign(I)*sign(W)$ μπορεί να υπολογιστεί με την εκτέλεση μιας πράξης popcount, η οποία επιστρέφει τον αριθμό των bit σε μια δεδομένη συλλογή που είναι 1, και τη σύγκριση του αποτελέσματος με ένα κατώφλι για τη δυαδικοποίηση.

Κατά τη διάρκεια της προς τα πίσω διάδοσης, πρέπει να χρησιμοποιηθεί μια προσέγγιση της συνάρτησης ενεργοποίησης $sign$, δεδομένου ότι το $sign$ έχει παράγωγο 0. Η πιο συνηθισμένη μέθοδος είναι γνωστή ως straight-through estimation(STE). Στην STE η συνάρτηση πρόσημου προσεγγίζεται ως εξής:

$$ 
STEsign(x) = \begin{dcases}
    +1, & \text{if } x \geq 1\\
    x, & \text{if } 1 \geq x \geq -1\\
    -1,              & \text{if } x \leq -1
\end{dcases}
$$

η οποία έχει παράγωγο:

$$ 
\frac{dSTEsign}{dx} = \begin{dcases}
    1, & \text{if } 1 \geq x \geq -1\\
    0,              & elsewhere
\end{dcases}
$$

Οι ενημερώσεις γίνονται στα υποκείμενα βάρη υψηλότερης ακρίβειας και οι δυαδικοποιήσεις τους χρησιμοποιούνται για το εμπρόσθιο πέρασμα.

## Σύνολα δεδομένων

Τα σύνολα δεδομένων που επιλέχθηκαν για την εκπαίδευση των μοντέλων και την υλοποίηση είναι αυτά που χρησιμοποιήθηκαν από το [20]. Με αυτόν τον τρόπο τα αποτελέσματα για την ακρίβεια του μοντέλου και τις απαιτήσεις σε χώρο/ενέργεια μπορούν να συγκριθούν με άλλες προσεγγίσεις στη βιβλιογραφία. Όπως και σε αυτές τις εργασίες, τα κατηγορικά χαρακτηριστικά αφαιρέθηκαν από τα σύνολα δεδομένων, αφήνοντας μόνο τις εισόδους από αισθητήρες, αφού σε αυτές θα έχει πρόσβαση το πραγματικό εκτυπωμένο σύστημα (αυτή η υπόθεση μπορεί να παρακαμφθεί, αλλά αυτό είναι πέρα από το τρέχον αντικείμενο). Σημειώστε ότι η επιλογή των χαρακτηριστικών μπορεί να μην είναι η ίδια με τις προηγούμενες εργασίες, δεδομένου ότι τα κομμάτια δεδομένων που διατηρούσαν δεν τεκμηριώνονταν. Όλα τους ελήφθησαν από το αποθετήριο μηχανικής μάθησης του UCI[7].

Σύντομη περιγραφή των συνόλων δεδομένων:

- Arrythmia[8]: Διάγνωση καρδιακής αρρυθμίας από 12 ηλεκτροκαρδιογραφήματα.
- Cardio[9]: Διάγνωση προβλημάτων στον καρδιακό ρυθμό αγέννητων
  βρεφών.
- Pendigits[10]: Ταξινόμηση γραπτού ψηφίου από μια σειρά 8
  σημάτων πίεσης από αισθητήρες αφής.
- Human Activity Recognition(HAR)[11]: Ταξινόμηση του τύπου της
  κίνησης ενός ατόμου (ορθοστασία, ανέβασμα σκαλοπατιών κ.λπ.) με τη χρήση επιταχυνσιόμετρων από κινητά τηλέφωνα
στη μέση τους.
- Gas Id[12]: Ταξινόμηση της παρουσίας αερίου με χρήση χημικών
αισθητήρων.
- Wine quality(white wine)[13]: Εκτίμηση της αντιλαμβανόμενης απόλαυσης των
  διαφόρων λευκών κρασιών με βάση την οξύτητα και τα ίχνη ανόργανων συστατικών.
- Wine quality(red wine)[13]: Αντίστοιχο με το παραπάνω για τα κόκκινα κρασιά.

Τα σύνολα δεδομένων χρησιμοποιούν εισόδους από αισθητήρες που αντιστοιχούν τουλάχιστον κατά προσέγγιση σε αισθητήρες που έχει αποδειχθεί ότι είναι δυνατόν να κατασκευαστούν με εκτύπωση. Το πλήρες σύστημα που περιλαμβάνει αισθητήρες, ταξινομητή και τροφοδοσία ρεύματος θα μπορούσε έτσι να υλοποιηθεί κάπως ρεαλιστικά και να μην απέχει πολύ από μια πραγματική περίπτωση χρήσης της τεχνολογίας.

Αισθητήρας | Dataset
---|---
Electrocardiography sensor on paper[1] | Arrythmia
Electrocardiography sensor on paper[1] | Cardio
Printed movement sensor | Human activity recognition
Printed gas sensor[6] | Gas identification
Printed piezoelectric sensor[4] | Pendigits
Printed pH sensor[2], Inkjet mineral sensor[3] | Wine Quality(White)
Printed pH sensor[2], Inkjet mineral sensor[3] | Wine Quality(Red)

\newpage
