cyberseihis/bnnprint/write/elad.md

---
link-citations: true
numbersections: true
header-includes:
 - \usepackage{fvextra}
 - \usepackage{mathtools}
 - \usepackage{amsmath}
 - \usepackage{tikz}
 - \usepackage[margin=1.5in]{geometry}
 - \usetikzlibrary{patterns} \DefineVerbatimEnvironment{Highlighting}{Verbatim}{breaklines,commandchars=\\\{\}}
 - \usepackage{float}
 - \floatplacement{figure}{H}
 - \makeatletter
 - \def\fps@figure{H}
 - \makeatother
---

\newpage

# Περίληψη

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

\newpage

# Εισαγωγή

## Εισαγωγή στην πανταχού παρούσα πληροφορική

Η τεχνολογία γενικά και πιο συγκεκριμένα ο υπολογισμός παίζει έναν
ολοένα και μεγαλύτερο ρόλο στη ζωή μας και δεν υπάρχουν ενδείξεις ότι η
τάση αυτή θα επιβραδυνθεί σύντομα. Εξακολουθεί ωστόσο να υπάρχει ακόμη
ένα σχετικά άκαμπτο χάσμα μεταξύ του πραγματικού κόσμου και του
υπολογιστικού τομέα, πράγμα που σημαίνει ότι οι περισσότερες από τις
αλληλεπιδράσεις μας με τον κόσμο γύρω μας δεν εμπεριέχουν την
πραγματοποίηση οποιουδήποτε υπολογισμού. Δεν είναι δύσκολο να
φανταστούμε αμέτρητα παραδείγματα όπου υπολογιστικά στοιχεία θα
προσέθεταν αξία σε καθημερινές δραστηριότητες όπως τα ψώνια από το
παντοπωλείο ή θα μείωναν την απαιτούμενη εργασία σε διαδικασίες
παραγωγής, όπως η μεταποίηση, εάν τα στοιχεία αυτά είχαν σχεδόν μηδενικό
κόστος και μεγαλύτερη ενσωματωσιμότητα που συνδέεται με αυτά.

Αν και σχεδόν όλοι στις ανεπτυγμένες χώρες φέρουν μαζί τους και
αλληλεπιδρούν με ισχυρούς υπολογιστές παντού όπου τυχαίνει να
βρίσκονται, η μορφή της αλληλεπίδρασης δεν μπορεί εύκολα να προσαρμοστεί
στο πλαίσιο όπου βρίσκονται. Δεν μπορεί κανείς απλά να ρωτήσει τις
μπανάνες που πήρε αν είναι αρκετά ώριμες, να φωνάξει τα κλειδιά του για
να βρει πού τα άφησε, να ελέγξει με τα παπούτσια του πόσα βήματα μπορούν
να κάνουν ακόμα. Επιπλέον, είναι σαφές ότι οι μη μετρήσιμες διαδικασίες
είναι τρομερά μη βελτιστοποιημένες σε σύγκριση με το τι θα μπορούσε να
επιτευχθεί αν μια συνεχής ροή λεπτομερούς πληροφόρησης από κάθε ένα από
τα στοιχεία που την απαρτίζουν και πρόσβαση σε έλεγχο της κάθε
λεπτομέρειας αυτών των στοιχείων ήταν διαθέσιμη.  Σκεφτείτε για
παράδειγμα ένα αγρόκτημα όπου κάθε μεμονωμένος καρπός σε κάθε δέντρο
έχει να παρακολουθείται η πρόοδος της ανάπτυξής του.

Παίρνοντας ουσιαστικά τις ιδέες του Διαδικτύου των Πραγμάτων (IoT) και
προωθώντας στο λογικό τους όριο, η πανταχού παρούσα
πληροφορική(ubiquitous computing) είναι ένα φιλόδοξο ιδανικό για ένα
μέλλον όπου κάθε προϊόν είναι μια έξυπνη συσκευή, κάθε παρατηρήσιμη
ιδιότητα, για την οποία οποιοσδήποτε θα μπορούσε λογικά να ενδιαφερθεί,
είναι προσβάσιμη. Αυτοκίνητα θα είναι σε θέση να πλοηγούνται με ασφάλεια
χωρίς πρόσβαση στην όραση ρωτώντας τις θέσεις των κοντινών συσκευών,
αφού οτιδήποτε δεν είναι συσκευή άμεσα, έχει τουλάχιστον μία ή
περισσότερες προσαρτημένες.

Τα τυπωμένα ηλεκτρονικά είναι σε θέση να διαδραματίσουν σημαντικό ρόλο τουλάχιστον στα πρώτα στάδια ενός τέτοιου μετασχηματισμού. Η εκτύπωση είναι επί του παρόντος η μόνη μέθοδος κατασκευής που μπορεί να παρέχει υπολογιστικά στοιχεία κάτω του cent, και το κόστος είναι το μεγαλύτερο εμπόδιο για το πόσο διαδεδομένα μπορούν να γίνουν. Επιπλέον, η μη τοξικότητα είναι ζωτικής σημασίας για να καταστεί δυνατή η προσθήκη τους σε ταχέως κινούμενα καταναλωτικά αγαθά που είναι αναλώσιμα σε αυτές τις κλίμακες. Η ελαστικότητα βοηθά επίσης στην ευκολότερη ενσωμάτωση.  Ακόμα και οι σχετικά "μέτριες" σε σύγκριση με το πλήρες όραμα εφαρμογές που μπορούμε να περιμένουμε ότι θα έρθουν τελικά, όπως οι ετικέτες RFID που αντικαθιστούν τους barcodes και επιτρέπουν στα καταστήματα να παρακολουθούν κάθε μεμονωμένο στοιχείο του αποθέματος ή οι τυπωμένοι αισθητήρες ποιότητας τροφίμων που καθιστούν τις ημερομηνίες λήξης παρωχημένες, έχουν μεγάλες δυνατότητες να διαταράξουν ένα ευρύ φάσμα βιομηχανιών.

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

## Εισαγωγή στα τυπωμένα ηλεκτρονικά

Τα τυπωμένα ηλεκτρονικά αναφέρονται σε πολύ λεπτές ηλεκτρονικές συσκευές
και κυκλώματα που παράγονται με την εφαρμογή μελανιών με τις επιθυμητές
ηλεκτρικές ιδιότητες σε διάφορα υποστρώματα. Μπορούν να κατασκευαστούν
σε μεγάλο όγκο για πολύ χαμηλότερο κόστος σε σύγκριση με άλλα
ηλεκτρονικά με μεθόδους που είναι κοινές στην βιομηχανία εκτύπωσης. Αυτό
τα καθιστά ιδιαίτερα κατάλληλα για εφαρμογές όπου τα οφέλη της
ηλεκτρονικής λειτουργικότητας από μόνα τους δεν αντισταθμίζουν τα
σχετικά έξοδα. Επιπλέον, μπορούν να προσφέρουν ευέλικτες μορφές και τη
δυνατότητα κάλυψης μεγάλης περιοχής. Ένα άλλο πλεονέκτημα που μπορεί να
προκύψει από τη διάδοσή τους είναι η μείωση του αντίκτυπου των
ηλεκτρονικών αποβλήτων, αφού τα τυπωμένα ηλεκτρονικά μπορούν να είναι
πολύ λιγότερο τοξικά για το περιβάλλον και πιο εύκολα ανακυκλώσιμα από
τα υπόλοιπα, ή ακόμη και βιοδιασπώμενα. Δεν μπορούν να ανταγωνιστούν τα
ηλεκτρονικά πυριτίου σε επιδόσεις λόγω της μεγάλης αντίστασης των
αγώγιμων μελανιών, της έλλειψης υποστήριξης για υψηλές συχνότητες και
της μεγάλης μεταβλητότητας κατά την κατασκευή. Ενώ η δυνατότητα να
καλύπτουν μεγάλες περιοχές είναι μερικές φορές επιθυμητή, πολλές
εφαρμογές απαιτούν σμίκρυνση που δεν μπορούν να προσφέρουν. Μια ποικιλία
ενεργών και παθητικών συσκευών, όπως τρανζίστορ, αντιστάσεις, πυκνωτές,
αισθητήρες, συλλέκτες και κεραίες μπορούν να υλοποιηθούν με αυτές.
Θεωρούνται ότι αποτελούν μια αναδυόμενη αγορά με σημαντικές δυνατότητες
διεύρυνσης του ρόλου των υπολογιστικών συστημάτων στην καθημερινή ζωή.
Μπορούν να βοηθήσουν στη διείσδυση του Internet-of-Things να φτάσει πολύ
βαθύτερα, και έτσι συνεργίζονται καλά με άλλες εξελίξεις στον τομέα. Μια
πρόσφατη έκθεση της IDTechEx[@fn25] προβλέπει την παγκόσμια αγορά για τα
τυπωμένα εύκαμπτα ηλεκτρονικά, εξαιρουμένων των OLEDs, θα φθάσει τα 12
δισεκατομμύρια δολάρια έως το 2033.

Σύγκριση της αφαιρετικής κατασκευής ηλεκτρονικών με την αμιγώς προσθετική κατασκευή. Source: https://doi.org/10.1109/ISCAS.2017.8050614

Πρόγνωση του μεγέθους της αγοράς τυπωμένων ηλεκτρονικών. Source: Precedence Research

## Χρήσεις των τυπωμένων ηλεκτρονικών

Η χρήση των τυπωμένων ηλεκτρονικών που οι περισσότεροι άνθρωποι μπορεί να γνωρίζουν στην καθημερινή τους ζωή είναι η μεμβράνη που χρησιμοποιείται για την ανίχνευση των πατημάτων των πλήκτρων στα περισσότερα μη μηχανικά πληκτρολόγια, ή ίσως οι αποπαγωτές παρμπρίζ.

Άλλες χρήσεις περιλαμβάνουν:

- Αισθητήρες: τα εύκαμπτα, βιοδιασπώμενα και ελαστικά αισθητήρια στοιχεία επιτρέπουν την αποτελεσματική παρακολούθηση πολλών διεργασιών. Μια ποικιλία ιδιοτήτων του κόσμου μπορεί να μετρηθεί με τυπωμένους αισθητήρες, όπως η θερμοκρασία, η αφή, η πίεση, τα αέρια, η υγρασία, τα επίπεδα φωτός και η παρουσία ορισμένων χημικών ουσιών. Η ευελιξία και η μη τοξικότητα είναι ιδιαίτερα σημαντικές για την ιατρική παρακολούθηση, γι' αυτό και οι βιοαισθητήρες έχουν λάβει μεγάλη προσοχή, ενώ ορισμένοι από αυτούς (π.χ. εκτυπωμένα επιθέματα ανίχνευσης επιληπτικών κρίσεων) είναι ήδη διαθέσιμοι στο εμπόριο.

- RFID: Το RFID (Radio Frequency Identification) είναι μια ασύρματη τεχνολογία ανάγνωσης, η οποία επιτρέπει την απρόσκοπτη ταυτοποίηση και παρακολούθηση αντικειμένων μέσω μοναδικών κωδικών αναγνώρισης που αποθηκεύονται στις ετικέτες. Στόχος των τυπωμένων RFID είναι η αντικατάσταση των σημερινών μεθόδων αναγνώρισης αγαθών με έξυπνες ετικέτες. Οι ετικέτες RFID είναι συνήθως παθητικές και δεν απαιτούν παροχή ρεύματος. Μπορούν να κατασκευαστούν φτηνά με οποιαδήποτε κοινή μέθοδο εκτύπωσης. Έχει παρουσιαστεί ότι λειτουργούν σε συχνότητες 5G και WLAN και μπορούν να έχουν ακόμη και δυνατότητες αισθητήρων. Επί του παρόντος χρησιμοποιούνται κυρίως στα εισιτήρια και στην καταπολέμηση της κλοπής.

- Συγκομιδή ενέργειας: Οι τυπωμένες μπαταρίες μπορούν να παρέχουν ενέργεια στα λειτουργικά μέρη των τυπωμένων κυκλωμάτων μόνο για περιορισμένο χρονικό διάστημα και μπορεί να καταλαμβάνουν σημαντικό μέρος της επιφάνειας του κυκλώματος. Προκειμένου να καταστεί δυνατή η μεγαλύτερη αυτονομία στα αναπτυγμένα τυπωμένα ηλεκτρονικά συστήματα, η ικανότητα συγκομιδής ενέργειας από το περιβάλλον είναι ζωτικής σημασίας. Οι τυπωμένοι συλλέκτες μπορούν να αντλήσουν ενέργεια από ραδιοσήματα, δονήσεις και συνηθέστερα από το φως. Οι τυπωμένες φωτοηλεκτρικές/ηλιακές κυψέλες έχουν επίσης προσελκύσει μεγάλο ενδιαφέρον και εκτός του πεδίου των συγκομιστών για μικρά κυκλώματα, καθώς ενώ η απόδοσή τους δεν φτάνει τα επίπεδα των άκαμπτων ηλιακών κυψελών πυριτίου μπορούν να αναπτυχθούν σε μια ευρύτερη επιλογή χώρων, συμπεριλαμβανομένων των ενδυμάτων.

- Φωτισμός: Οι λυχνίες LED έχουν γίνει η κυρίαρχη πηγή φωτισμού, στη θέση των ενεργειακά σπάταλων λαμπτήρων πυρακτώσεως και των περιβαλλοντικών ναρκοπεδίων του φωτισμού με φθορίζοντες λαμπτήρες. Οι OLED αυξάνουν περαιτέρω την εξοικονόμηση ενέργειας και παράγουν πιο απαλό και ομοιόμορφο φωτισμό. Η εκτύπωση φαίνεται να αποτελεί μια πολλά υποσχόμενη λύση για την κατασκευή OLED χαμηλού κόστους με ανταγωνιστική φωτιστική απόδοση και να τους επιτρέπει να καλύπτουν μεγάλες επιφάνειες. Με αυτόν τον τρόπο έχουν καταδειχθεί φωτεινά πάνελ πάχους λεπτού χαρτιού.

- Οθόνες: Οι οθόνες είναι μία από τις πιο ώριμες πτυχές των τυπωμένων ηλεκτρονικών, με μεγάλες εκτυπωμένες οθόνες OLED 4Κ να είναι διαθέσιμες στο εμπόριο. Επιτρέπουν εύκαμπτες οθόνες, οι οποίες έχουν πολλές εφαρμογές στα ηλεκτρονικά είδη ευρείας κατανάλωσης και στα φορέσιμα και έτσι αποτελούν μια αγορά 5 δισεκατομμυρίων δολαρίων. Ακόμη και αν η εύκαμπτη οθόνη δεν είναι πλήρως τυπωμένη, τα τυπωμένα ηλεκτρονικά μπορούν να της προσφέρουν πρόσθετα χαρακτηριστικά. Οι οθόνες QLED μπορεί επίσης μια μέρα να εκτυπωθούν, αν η ακρίβεια εκτύπωσης συνεχίσει να αυξάνεται.

- Wearables: Έξυπνες ηλεκτρονικές συσκευές που φοριούνται είναι ήδη πολύ δημοφιλείς, όπως έξυπνα ρολόγια ή ακουστικά βαρηκοΐας ή δαχτυλίδια NFC. Τα τυπωμένα ηλεκτρονικά έχουν πολλά να προσφέρουν στον χώρο χάρη στην ευελιξία τους. Έχουν αναπτυχθεί αγώγιμα υλικά που μπορούν να εκτυπωθούν σε ύφασμα και να αντέξουν στο πλύσιμο με απορρυπαντικό, επιτρέποντας την ενσωμάτωση ηλεκτρονικών σε κανονικά ρούχα. Οι εκτυπωμένοι αισθητήρες μπορούν να χρησιμοποιηθούν για την παρακολούθηση της δραστηριότητας, ένα από τα πιο δημοφιλή χαρακτηριστικά των σημερινών έξυπνων ρολογιών, ή για την παρακολούθηση της υγείας, με εκτυπωμένα επιθέματα για την ανίχνευση επιληπτικών κρίσεων που κυκλοφορούν ήδη στην αγορά. Μπορεί επίσης να φανταστεί κανείς ότι θα ενδιέφεραν τη βιομηχανία της μόδας.

Εκτυπωμένο NFC. Source: PRINTED ELECTRONICS LTD

Τυπωμένη μεμβράνη πληκτρολογίου. Source: Paulo Maluf

\newpage

## TinyML

Το Edge Computing επιτρέπει εφαρμογές στις οποίες η επεξεργασία δεδομένων είναι ευαίσθητη στην τοποθεσία. Παρέχει μεγαλύτερες εγγυήσεις ασφάλειας, ιδιωτικότητας και διαθεσιμότητας στους τελικούς χρήστες. Αποτελεί θεμελιώδες στοιχείο της αγοράς IoT, που μπορεί να μειώσει την εξάρτηση από τα συστήματα cloud. Το κύριο εμπόδιο στην εξάπλωση της προσθήκης είναι οι περιορισμοί πόρων που επιβάλλει.  

Για να αντιμετωπιστεί η απαίτηση εκτέλεσης εφαρμογών μηχανικής μάθησης στην ακμή για έξυπνες συσκευές, οι παραδοσιακές αρχιτεκτονικές είναι πολύ διογκωμένες για να ανταποκριθούν. Πολλά μοντέλα απαιτούν σήμερα υπολογιστικές δυνατότητες που δεν είναι εφικτές ακόμη και για το πιο high-end καταναλωτικό υλικό, πόσο μάλλον για συσκευές χαμηλής ισχύος. Το TinyML είναι ο τομέας της βελτιστοποίησης των αρχιτεκτονικών μηχανικής μάθησης ώστε να εκτελούνται σε συστήματα με εξαιρετικά περιορισμένους πόρους, συνήθως όχι περισσότερους από μερικά χιλιοστά του βατ.  

Για το εγχείρημα αυτό απαιτείται διεπιστημονική εργασία, καθώς τόσο οι αλγόριθμοι ML, όσο και το λογισμικό και το υλικό που τους υποστηρίζει πρέπει να προσαρμόζονται σε αυτούς τους περιορισμούς, χωρίς να διακυβεύεται σε σημαντικό βαθμό η ακρίβεια των μοντέλων. Περίπου οι περιορισμοί που παίζουν ρόλο είναι η ενεργειακή απόδοση, η ικανότητα επεξεργασίας, ο χώρος μνήμης και το κόστος παραγωγής και σχεδιασμού. Θα πρέπει να τονιστεί ότι η ανησυχία αφορά το στάδιο inference της ML, αν και η δυνατότητα υλοποίησης της φάσης εκπαίδευσης σε υλικό άκρων αποτελεί επίσης μια δική της εξειδικευμένη προσπάθεια. 

Δεδομένου ότι τα προ-εκπαιδευμένα μοντέλα ML δεν μπορούν να εκτελούνται σε αυτούς τους όρους κατά κανόνα, απαιτούνται pipelines από άκρη σε άκρη, από την απόκτηση δεδομένων έως την εξαγωγή συμπερασμάτων, δημιουργώντας τον τομέα της TinyML-as-a-Service ή TinyMaaS. Πρέπει να λαμβάνονται ειδικές προφυλάξεις σε κάθε ενδιάμεσο βήμα ώστε να οδηγηθούμε σε ένα αρκετά ελαφρύ μοντέλο εκτέλεσης.  

Ορισμένες προσεγγίσεις του προβλήματος περιλαμβάνουν:

- Μια από τις πιο διαδεδομένες μεθόδους στο πεδίο είναι η αναζήτηση περιορισμένης νευρωνικής αρχιτεκτονικής (constrained neural architecture search, NAS). Η αναζήτηση νευρωνικής αρχιτεκτονικής εξετάζει ένα χώρο αναζήτησης διαφορετικών αρχιτεκτονικών για διαφορετικές υπερπαραμέτρους. Ένας αλγόριθμος προσπαθεί να εντοπίσει την καλύτερη δυνατή αρχιτεκτονική για τη μεγιστοποίηση της απόδοσης του μοντέλου στην επίτευγματική συνάρτηση. Ένας αξιολογητής εξετάζει τους συμβιβασμούς μεταξύ ακρίβειας και αποδοτικότητας κατά την εγκατάσταση, δεδομένων των δηλωμένων περιορισμών μνήμης, ενέργειας κ.λπ. Μπορεί να εξετάσει ένα ή πολλά μοντέλα-στόχους σε μία ή περισσότερες πλατφόρμες. Τόσο ο χώρος αναζήτησης όσο και ο αλγόριθμος αναζήτησης έχουν επίγνωση του υλικού. Πρόκειται για ένα πρόβλημα βελτιστοποίησης πολλαπλών στόχων που συνήθως υλοποιείται ως πρόβλημα βελτιστοποίησης πολλαπλών σταδίων ενός στόχου. Η εκτέλεση της αναζήτησης είναι πολύ χρονοβόρα, αλλά τα αποτελέσματα υπερτερούν των περισσότερων χειροκίνητα σχεδιασμένων δικτύων.

- Μια προφανής προσέγγιση για τον χειρισμό του προβλήματος του περιορισμού μνήμης είναι η χρήση τεχνικών συμπίεσης δεδομένων στο μοντέλο ML. Μια βασική προσέγγιση που έχει επιδείξει συντελεστές συμπίεσης 15-40 φορές είναι τα προϊόντα Kronecker (KP). Ωστόσο, μπορεί να προκύψουν μεγάλες ποινές ακρίβειας και μια μέθοδος που ονομάζεται ντοπαρισμένο προϊόν Kronecker (DKP) αξιοποιεί την προσαρμογή των συν-μητρών για να προσπαθήσει να τις διορθώσει.

- Η υπερπαραμετροποίηση είναι η ιδιότητα ενός νευρωνικού δικτύου όπου οι πλεονάζοντες νευρώνες δεν βελτιώνουν την ακρίβεια των αποτελεσμάτων. Αυτός ο πλεονασμός μπορεί συχνά να αφαιρεθεί με μικρή ή καθόλου απώλεια ακρίβειας. Τα πλήρως συνδεδεμένα βαθιά νευρωνικά δίκτυα απαιτούν N^2 συνδέσεις μεταξύ των νευρώνων. Το κλάδεμα του δικτύου αφαιρεί παραμέτρους που δεν επηρεάζουν την ακρίβεια σε μεγάλο βαθμό. Μια συνηθισμένη περίπτωση όπου αυτό μπορεί εύκολα να γίνει είναι όταν οι παράμετροι είναι είτε μηδέν είτε αρκετά κοντά σε αυτό. Ομοίως όταν οι τιμές των παραμέτρων είναι περιττά επαναλαμβανόμενες. Μπορεί να εφαρμοστεί σε οποιαδήποτε κλίμακα, από μεμονωμένες συνδέσεις, νευρώνες έως ολόκληρα επίπεδα. Όταν μια διαδικασία κλαδέματος έχει ως αποτέλεσμα το νευρωνικό δίκτυο να χάσει τη συμμετρική του δομή αναφέρεται ως μη δομημένο κλάδεμα, διαφορετικά πρόκειται για δομημένο κλάδεμα. Το μη δομημένο κλάδεμα οδηγεί σε αραιούς πίνακες βαρών που οι γενικοί επεξεργαστές δεν εκτελούν αποτελεσματικά.  Η επανεκπαίδευση ενός δικτύου μετά το κλάδεμα των παραμέτρων που δεν συνέβαλαν αρκετά μπορεί να του επιτρέψει να επιτύχει υψηλότερες ακρίβειες από ό,τι πριν. Ακόμα και το κλάδεμα ενός τυχαία αρχικοποιημένου δικτύου χωρίς εκπαίδευση πριν ή μετά μπορεί να οδηγήσει σε ευπρεπή ακρίβεια.

- Η απόσταξη γνώσης είναι μια διαδικασία εκπαίδευσης ενός μικρότερου, ρηχότερου μαθητικού δικτύου για να αποδίδει κατά ένα μεγάλο μέρος τα logits εξόδου ενός μεγαλύτερου, ικανότερου δικτύου δασκάλου που έχει εκπαιδευτεί με ικανοποιητική ακρίβεια. Οι πιο προηγμένες παραλλαγές περιλαμβάνουν σύνολα μικρών δικτύων που το καθένα προσπαθεί να ταιριάξει με τα αποτελέσματα του συγκεντρωμένου συνόλου ή την αυτοαπόσταξη κατά την οποία τα ρηχότερα στρώματα ενός βαθύ νευρωνικού δικτύου προσπαθούν να μάθουν να ταιριάζουν με τα πιο περίπλοκα χαρακτηριστικά των βαθύτερων στρωμάτων. Εάν η διαφορά μεγέθους μεταξύ των δικτύων μαθητή και δασκάλου είναι πολύ μεγάλη, ένα ενδιάμεσου μεγέθους δίκτυο βοηθού δασκάλου λαμβάνει τις απαντήσεις του δασκάλου και στη συνέχεια τις αποστάζει στο μαθητή.

- Η κβάντιση είναι η διαδικασία μείωσης της αριθμητικής ακρίβειας των τιμών στο μοντέλο. Τα δίκτυα χρησιμοποιούν συνήθως αριθμούς κινητής υποδιαστολής 32 bit κατά τη διάρκεια της εκπαίδευσης[@fn22]. Οι πιο συνηθισμένοι στόχοι κβαντισμού για αυτά είναι είτε ακέραιοι αριθμοί 8-bit είτε ακέραιοι αριθμοί 4-bit. Σε πολλές περιπτώσεις το δίκτυο δεν αξιοποιεί πλήρως αυτό το επίπεδο ακρίβειας. Η μείωση της ακρίβειας σε αυτές τις περιπτώσεις μπορεί να ανακουφίσει τον υπολογιστικό φόρτο που συνεπάγεται με αμελητέες θυσίες ακρίβειας. Η εκπαίδευση με επίγνωση της κβάντισης είναι μια διαδικασία κατά την οποία το δίκτυο πλήρους ακρίβειας εκπαιδεύεται εκ νέου στη μειωμένη μορφή. Διαδέχεται την κβάντιση του δικτύου μόνο μετά την ολοκλήρωση της διαδικασίας εκπαίδευσης. Όταν η μέθοδος φτάνει στα όριά της, η ακρίβεια μειώνεται σε 1 bit. Τα δίκτυα με ακρίβεια ενός μόνο bit ονομάζονται δυαδικά νευρωνικά δίκτυα(BNNs).

\newpage

## Εκτυπωμένη μηχανική μάθηση

Οι πιο ξεκάθαρα επιθυμητές εφαρμογές των υπολογισμών σε τυπωμένα ηλεκτρονικά συστήματα στον τομέα της πανταχού παρούσας πληροφορικής επικεντρώνονται γύρω από κάποια μορφή ταξινόμησης. Για κάθε τυπωμένο κύκλωμα που περιλαμβάνει έναν ή περισσότερους αισθητήρες απαιτείται ένα σύστημα για την ερμηνεία των εξόδων αυτού του αισθητήρα σε μια χρήσιμη μορφή, εκτός από τις τετριμμένες περιπτώσεις.

Η δημιουργία χειροποίητων υπολογιστικών μοντέλων για κάθε συνδυασμό αισθητήρων και περιπτώσεων χρήσης στις οποίες περιλαμβάνονται και η σχεδίαση αποδοτικών σχεδίων υλικού για την υποστήριξη του καθενός θα απαιτούσε ένα συντριπτικό ποσό εργατοωρών. Η μηχανική μάθηση παρέχει ένα κοινό μέσο τόσο για τη δημιουργία μοντέλων πρόβλεψης όσο και αρχιτεκτονικών για την υλοποίηση σε κυκλώματα ενός τεράστιου φάσματος αυτών των εφαρμογών. Υπάρχουν λοιπόν σαφή κίνητρα για την παροχή αυτών των μέσων.

Οι δυσκολίες σε αυτό το εγχείρημα πηγάζουν όλες από τους ακραίους περιορισμούς πόρων που δίνονται από τα μεγέθη των στοιχείων και τις ενεργειακές απαιτήσεις των τυπωμένων ηλεκτρονικών. Για να ξεπεραστούν αυτά τα εμπόδια, ολόκληρη η διαδικασία, από την επιλογή των κατάλληλων γενικών αρχιτεκτονικών μέχρι τη διατήρηση μόνο των απολύτως απαραίτητων στοιχείων υλικού στα κυκλώματα που προκύπτουν, πρέπει να βελτιστοποιηθεί για το σκοπό αυτό.

Πέρα από το να μειωθεί η επιφάνεια του κυκλώματος σε ένα λογικό μέγεθος, ένας σημαντικός παράγοντας που εμποδίζει τη χρηστικότητα ορισμένων υλοποιήσεων είναι ότι καμία τυπωμένη μπαταρία δεν μπορεί να υποστηρίξει την ηλεκτρική τους κατανάλωση. Επομένως, δεν είναι δυνατόν να τις έχουμε σε λειτουργία στην πράξη. Η ισχύς εξόδου αυτών των μπαταριών είναι ένα σκληρό όριο που πρέπει να επιτευχθεί ή η τυπωμένη ML είναι καθαρά θεωρητική. Στην παρούσα εργασία στοχεύεται η πιο παραχωρητική μπαταρία, της Molex, η οποία μπορεί να υποστηρίξει κυκλώματα με ισχύ έως και 30mW.

\newpage

## Στόχος διπλωματικής εργασίας

Η ιδέα αυτής της διατριβής λαμβάνει χώρα σε ένα σενάριο διάχυτου υπολογισμού. Έχω διασφαλίσει ότι η όλη διαδικασία από το σύνολο δεδομένων μέχρι τη netlist που μπορεί να περάσει στον εκτυπωτή δεν απαιτεί καμία χειροκίνητη παρέμβαση. Οποιοσδήποτε μπορεί να περάσει τα δεδομένα του αισθητήρα του στο ένα άκρο και να λάβει μετρήσεις για την ακρίβεια του μοντέλου, την επιφάνεια του κυκλώματος και τις απαιτήσεις ισχύος στο άλλο άκρο, χωρίς να απαιτούνται από αυτόν ειδικές γνώσεις σε οποιονδήποτε τομέα. Αυτό γίνεται συγκεκριμένα με τη χρήση εξειδικευμένων υλοποιήσεων δυαδικών νευρωνικών δικτύων, προκειμένου να αξιολογηθεί η αποτελεσματικότητά τους ως προς την παροχή μιας ραχοκοκαλιάς για τη διαδικασία αυτή.

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

Έχουν αξιολογηθεί διάφορες αρχιτεκτονικές για ένα τέτοιο framework. Η παρούσα εργασία προσθέτει τα Δυαδικά Νευρωνικά Δίκτυα (BNN) στον κατάλογο των προσεγγίσεων για έντυπη εκτέλεση ML. Τα BNNs είναι δίκτυα που ποσοτικοποιούνται στο απόλυτο όριο του 1 bit. Έχουν σχεδιαστεί ειδικά για να ελαχιστοποιούν όσο το δυνατόν περισσότερο τους υπολογιστικούς πόρους και συνεπώς αποτελούν έναν βασικό υποψήφιο για να φέρουν όλο και περισσότερους ταξινομητές κάτω από το όριο υλοποίησης των τυπωμένων ηλεκτρονικών. Το μεγαλύτερο μέρος αυτής της διατριβής αφιερώνεται στην εξέταση αποδοτικών υλοποιήσεων υλικού προσαρμοσμένου κατά παραγγελία (bespoke) για τα BNNs ώστε να χωρέσουν στους περιορισμούς της τεχνολογίας.

# Σχετικές εργασίες στη μηχανική μάθηση για τυπωμένα κυκλώματα

Από τότε που η τεχνολογία των τυπωμένων υπολογιστών έφτασε στο σημείο όπου τα μοντέλα Μηχανικής Μάθησης θα μπορούσαν να υποστηριχθούν για εκτέλεση, έχουν γίνει εργασίες για την υλοποίησή τους.
Οι Tahoori et al [@fn14] επιδεικνύουν έναν αναλογικό νευρώνα δύο εισόδων και δείχνουν πώς θα μπορούσε να επεκταθεί σε πλήρως τυπωμένα αναλογικά νευρωνικά δίκτυα με λειτουργίες MAC και ενεργοποίησης. Οι Douthwaite et al[@fn15] χρησιμοποιούν κωδικοποίηση σημάτων στο πεδίο του χρόνου, αναπαριστώντας το μέγεθος ως πλάτος παλμού και κωδικοποιώντας τα βάρη με καθρέφτες ρεύματος. Η συσσώρευση γίνεται με γραμμική φόρτιση ενός πυκνωτή με τους κατοπτρισμένους παλμούς. Οι Gkoupidenis et al [@fn16] μιμούνται βιολογικής έμπνευσης συναπτικές λειτουργίες με τρανζίστορ με ηλεκτρολυτική πύλη και δείχνουν πώς θα μπορούσαν να χρησιμοποιηθούν για ένα perceptron ενός στρώματος. Οι Ozer et al [@fn17] οραματίζονται πώς θα μπορούσε να μοιάζει μια αυτόματη διαδικασία για τη δημιουργία εξειδικευμένων επεξεργαστών για μια ποικιλία αρχιτεκτονικών ML σε τυπωμένα ηλεκτρονικά, αλλά δεν προχωρούν πέρα από το στάδιο του οράματος. Οι Bleier et al [@fn18] παρουσιάζουν έναν τυπωμένο μικροεπεξεργαστή με σύνολο εντολών προσαρμοσμένο στο εκάστοτε πρόγραμμα. Οι Weller et al [@fn19] αξιοποιούν τον στοχαστικό υπολογισμό για να μειώσουν τις απαιτήσεις των μικτών αναλογικών-ψηφιακών νευρωνικών δικτύων, αλλά με βαρύ κόστος ακρίβειας.

Οι Mubarik et al [@fn20] αξιολογούν μικρές αρχιτεκτονικές μηχανικής μάθησης (δέντρα απόφασης, τυχαία δάση και μηχανές διανυσμάτων υποστήριξης) σε ψηφιακές, βασισμένες σε πίνακες αναζήτησης και αναλογικές αρχιτεκτονικές σε ειδικά σχεδιασμένα τυπωμένα κυκλώματα. Εξετάζουν επίσης τις MLP, αλλά αποφασίζουν ότι είναι πολύ δαπανηρές για να τις αξιολογήσουν. Τα κυριότερα αποτελέσματα αφορούν τα δέντρα απόφασης (DT), όπου εξετάζουν τις απαιτήσεις των τυπωμένων υλοποιήσεων για βάθη από 1 έως 8, τόσο σε συμβατικά όσο και σε προσαρμοσμένα κυκλώματα. Δείχνουν ότι τα κατά παραγγελία(bespoke) κυκλώματα, τα οποία είναι μοναδικά κατάλληλα για τυπωμένα ηλεκτρονικά λόγω του χαμηλού μη επαναλαμβανόμενου μηχανικού(NRE) και κατασκευαστικού κόστους, μπορούν να υλοποιηθούν με περίπου δύο τάξεις μεγέθους χαμηλότερες απαιτήσεις από τα κυκλώματα που μπορούν να υποστηρίξουν ένα ευρύτερο φάσμα DTs και όχι μόνο ένα. Η παρούσα διατριβή είναι άμεσα εμπνευσμένη από αυτή την εργασία όσον αφορά τη χρήση σχεδιασμού κατά παραγγελία για τη μείωση των απαιτήσεων των υλοποιήσεων μοντέλων και εφαρμόζει κυρίως τις ιδέες τους στον τομέα των BNNs.

Οι Armeniakos et al [@fn21] επεκτείνονται σε πιο απαιτητικά SVMs και Multi Layer Perceptrons. Προκειμένου να καταστεί δυνατή η υλοποίησή τους, αξιοποιούν τον προσεγγιστικό υπολογισμό με δύο τρόπους. Πρώτον, παρατηρούν ότι υπάρχει μεγάλη διακύμανση στις απαιτήσεις περιοχής ενός σταθερού πολλαπλασιαστή με βάση τον συντελεστή με τον οποίο πολλαπλασιάζει. Για παράδειγμα, ο πολλαπλασιασμός με μια δύναμη του δύο δεν απαιτεί καθόλου υλικό αφού πρόκειται για μια σταθερή μετατόπιση. Προσεγγίζουν τους συντελεστές βάρους των MLP και SVM για να εκμεταλλευτούν αυτή την παρατήρηση. Δεύτερον, εφαρμόζουν κλαδέματα μετά τη σύνθεση σε επίπεδο πύλης στη λίστα δικτύου των σχεδίων. Στοχεύουν σε πύλες που έχουν σχεδόν σταθερές εξόδους και επηρεάζουν μόνο τα λιγότερο σημαντικά bits των αποτελεσμάτων και τα αντικαθιστούν με τη σταθερή τιμή που ως επί το πλείστον εξάγουν. Μαζί αυτές οι προσεγγίσεις οδηγούν σε μειώσεις έκτασης και ισχύος περίπου κατά 2 φορές στις περισσότερες περιπτώσεις. Η εργασία αυτή είναι άμεση πηγή έμπνευσης για την παρούσα διατριβή, όπου οι συντελεστές βάρους ορίζονται στη φάση της εκπαίδευσης να είναι αποκλειστικά τιμές που δεν απαιτούν την υλοποίηση πολλαπλασιαστών, όπως συμβαίνει στα BNN. Έτσι, τα αποτελέσματα που επιτυγχάνονται εδώ συγκρίνονται με αυτά της εργασίας αυτής ως βάση. Η σύγκριση αυτή παρέχεται στην ενότητα [Αποτελέσματα](#results).

Στο επόμενο δημοσίευμα [@haware] εφαρμόζουν επιπλέον τεχνικές ελαχιστοποίησης των νευρωνικών συστημάτων, όπως κβάντιση, κλάδεμα και ομαδοποίηση βαρών, και τις συνδυάζουν χρησιμοποιώντας γενετικούς αλγορίθμους για να μειώσουν τις απαιτήσεις έκτασης έως και 8 φορές.

Στο [@modelcircuit], εκτός από τους προαναφερθέντες φιλικούς προς το υλικό συντελεστές και το κλάδεμα της λίστας δικτύων, εφαρμόζεται υπερκλιμάκωση τάσης(VOS) για την περαιτέρω μείωση των απαιτήσεων ισχύος των κυκλωμάτων ταξινομητών. Στη συνέχεια εφαρμόζεται ένας γενετικός αλγόριθμος για την ελαχιστοποίηση της περιοχής και τη μεγιστοποίηση της ακρίβειας για δεδομένο περιορισμό ισχύος. Αυτό επιτρέπει σε πολλά σχέδια να τροφοδοτούνται από τυπωμένες μπαταρίες θυσιάζοντας λιγότερο από 1% στην ακρίβεια.

Στη συνέχεια, το [@codesign] επανεκπαιδεύει τα MLP με μια συνάρτηση βαθμολόγησης που λαμβάνει υπόψη το κόστος υλικού που σχετίζεται με τον πολλαπλασιασμό με τον συντελεστή κάθε βάρους. Οι συντελεστές ταξινομούνται σε συστάδες με βάση το κόστος υλικού τους και η επανεκπαίδευση επιτρέπει τη χρήση όλο και πιο ακριβών τιμών για τα βάρη μέχρι να επιτευχθεί το όριο ακρίβειας. Επιπλέον, τα προϊόντα αθροίζονται χρησιμοποιώντας προσεγγιστική πρόσθεση απορρίπτοντας τα λιγότερο σημαντικά bit των προϊόντων που συμβάλλουν λιγότερο στο αποτέλεσμα του MAC. Όλες αυτές οι βελτιώσεις οδηγούν σε 6πλάσια εξοικονόμηση χώρου και ισχύος για απώλεια ακρίβειας 1% και 20πλάσια για 5%. Επειδή συχνά τα δίκτυά τους χρησιμοποιούν μόνο δυνάμεις του 2 ως βάρη και συνεπώς δεν χρησιμοποιείται υλικό για την εκτέλεση του πολλαπλασιασμού, αυτό το πλεονέκτημα της χρήσης BNN δεν υπάρχει εδώ. Ωστόσο, διαφορετικοί νευρώνες χρησιμοποιούν διαφορετικά βάρη για την ίδια είσοδο, με αποτέλεσμα λιγότερα ενδιάμεσα αθροίσματα να μπορούν να μοιραστούν μεταξύ των νευρώνων. Αυτό είναι ένα πλεονέκτημα που μπορούν να εκμεταλλευτούν τα BNNs, αν και πληρώνουν ένα τίμημα στις δυνατότητες αναπαράστασης.

Οι Balaskas et al στο [@axxdtrees] επεκτείνουν την ιδέα των φιλικών προς το υλικό συντελεστών στις τιμές κατωφλίου των συγκριτών στα δέντρα αποφάσεων. Πέρα από την τιμή κατωφλίου, η ακρίβεια της σύγκρισης μπορεί επίσης να διαμορφωθεί σε βάση ανά συγκριτή προκειμένου να αυξηθεί η αποδοτικότητα. Αναπτύσσουν έναν γενετικό αλγόριθμο για να βρουν βέλτιστες διαμορφώσεις των φιλικών προς το υλικό κατωφλίων κοντά στις αρχικές τιμές και μειωμένες ακρίβειες σύγκρισης χωρίς να θυσιάζεται ακρίβεια άνω του 1%. Ως αποτέλεσμα, η έκταση και η ισχύς μειώνονται κατά 3-4 φορές. Αυτό οδηγεί μερικά από τα μικρότερα σχέδια που εξετάζουν σε επιφάνεια κάτω από cm$^2$ και κατανάλωση ισχύος κάτω από mW.

Οι Iordanou et al [@tinyclass] έχουν μια ενδιαφέρουσα προσέγγιση στην οποία χρησιμοποιούν γενετικό προγραμματισμό βασισμένο σε γράφους για να αναζητήσουν στο χώρο των λογικών εκφράσεων boolean αυτές που προβλέπουν την κλάση των δεδομένων του πίνακα με υψηλή ακρίβεια και μεταφράζοντας αυτές τις λογικές πύλες σε μια netlist. Το αποτέλεσμα είναι μια θάλασσα από λογικές πύλες, σε αντίθεση με τα δομημένα κυκλώματα άλλων προσεγγίσεων. Είναι περιττό να πούμε ότι αυτό απομακρύνεται από το πρότυπο των παραδοσιακών αρχιτεκτονικών ML στις οποίες τοποθετείται αυτή η εργασία.

\newpage

# Πληροφοριακό υπόβαθρο - Προαπαιτούμενα

## Τεχνικές λεπτομέρειες για τα τυπωμένα ηλεκτρονικά

## Μέθοδοι κατασκευής

Τα τυπωμένα ηλεκτρονικά κατασκευάζονται με τεχνικές από τη βιομηχανία γραφικών εκτυπώσεων. Διακρίνονται σε τεχνικές εκτύπωσης με επαφή ή R2R που χρησιμοποιούν πρότυπο και σε ανέπαφες που δεν χρησιμοποιούν. Απαιτούνται πολλαπλά βήματα εκτύπωσης για τα πολλαπλά στρώματα του κυκλώματος. Οι τεχνικές εκτύπωσης επαφής περιλαμβάνουν:  

- Βαθυτυπία: Στη βαθυτυπία, ο κύλινδρος εκτύπωσης χαράσσεται με το πρότυπο και βυθίζεται εν μέρει στο μελάνι κατά τη διάρκεια της διαδικασίας, με μια λεπίδα να απορρίπτει το πλεονάζον μελάνι. Αυτό αφήνει μόνο μελάνι στα τμήματα του προτύπου, το οποίο μεταφέρεται στο υπόστρωμα υπό πίεση. Η βαθυτυπία μπορεί να εκτυπώσει με υψηλή ανάλυση και ταχύτητα σε σύγκριση με άλλες μεθόδους, αλλά το κόστος της χάραξης του κυλίνδρου την καθιστά χρήσιμη μόνο για μεγάλες παρτίδες.  

- Offset: Στην εκτύπωση offset το σχήμα του προτύπου εναποτίθεται σε έναν κύλινδρο με μια ουσία που δέχεται μελάνι και το αρνητικό του προτύπου καλύπτεται με ουσίες που απωθούν το μελάνι. Με αυτόν τον τρόπο μόνο το σχήμα του προτύπου απορροφά μελάνι από έναν κύλινδρο μελάνης και στη συνέχεια μεταφέρεται στο υπόστρωμα μέσω ενός ενδιάμεσου κυλίνδρου. 

- Φλεξογραφία: Το πρότυπο ενσωματώνεται σε μια εύκαμπτη πλάκα που τυλίγεται γύρω από έναν κύλινδρο εκτύπωσης έτσι ώστε τμήματα του σχήματος να υπερυψώνονται. Το μελάνι που εφαρμόζεται σε αυτόν τον κύλινδρο μεταφέρεται σε έναν δεύτερο κύλινδρο και στη συνέχεια στο υπόστρωμα, μόνο εάν βρίσκεται στα ανυψωμένα μέρη που αντιστοιχούν στο πρότυπο. Μπορεί να υποστηρίξει τόσο μη πορώδη όσο και πορώδη υποστρώματα.  

- Μεταξοτυπία: Το "κόσκινο" σε αυτή την περίπτωση είναι ένα στενά συνδεδεμένο ύφασμα, έτσι ώστε το μελάνι να μπορεί να περάσει μόνο με την άσκηση πίεσης. Ένα στένσιλ του προτύπου τοποθετείται πάνω στο κόσκινο και μια λεπίδα ωθεί το μελάνι μέσω των ακάλυπτων τμημάτων στο υπόστρωμα. Η μεταξοτυπία είναι η απλούστερη τεχνική από όλες και μπορεί να δημιουργήσει παχύτερα στρώματα και να εκτυπώσει σε καμπύλες επιφάνειες. Πάσχει από χαμηλότερη ανάλυση σε σύγκριση με άλλες μεθόδους.

- Εκτύπωση με ταμπόν: Το μελάνι μπαίνει πάνω σε μια χάραξη του προτύπου. Στη συνέχεια, ένα μαλακό ταμπόν πιέζεται πάνω του και μεταφέρει το μελάνι με το επιθυμητό σχήμα στο υπόστρωμα. Μπορεί να εκτυπώσει σε επιφάνειες τρισδιάστατων αντικειμένων.

Οι τεχνικές χωρίς επαφή περιλαμβάνουν:

- Εκτύπωση μελάνης: Το μελάνι πέφτει πάνω στο υπόστρωμα από μικροσκοπικά στόμια. Είτε υπάρχουν αρκετά στόμια για να καλύψουν το πλάτος της εκτύπωσης είτε μπορούν να μετακινηθούν για να το κάνουν. Δεν απαιτεί μεγάλο εξοπλισμό και διαφορετικά σχέδια μπορούν να εκτυπωθούν σε υψηλή ανάλυση χωρίς επιπλοκές στην αλλαγή προτύπων, γεγονός που την καθιστά ιδανική για εκτύπωση κατά παραγγελία. Το κύριο μειονέκτημά της είναι η ταχύτητα εκτύπωσης. Η εκτύπωση συνεχούς ροής μελάνης έχει μια ροή μελάνης που κατευθύνεται πάνω στο υπόστρωμα ή σε έναν κάδο απόρριψης, ανάλογα με τις πληροφορίες του σχεδίου. Μπορεί να εκτυπώσει μεγαλύτερες παρτίδες από την Drop-on-Demand inkjet, αλλά με πέντε φορές χαμηλότερη ανάλυση. Η DoD ελέγχει αν θα ρέει μελάνι χρησιμοποιώντας μια βαλβίδα, ώστε να μην σπαταλιέται μελάνι. Αναπτύσσεται σε μικρότερες κλίμακες από τη συνεχή ροή.

- Αεροζόλ: Το μελάνι κονιορτοποιείται σε λεπτή ομίχλη μέσω πεπιεσμένου αέρα ή υπερήχων, επιταχύνεται και ψεκάζεται πάνω στο υπόστρωμα. Μπορεί να χρησιμοποιηθεί σε καμπύλες επιφάνειες και μπορεί να παρέχει ακόμη μικρότερα μεγέθη χαρακτηριστικών από ό,τι ο inkjet, αλλά είναι απαγορευτικά αργό.

Επιπλέον, μέθοδοι όπως η εναπόθεση υπό κενό, κατά την οποία εξατμιζόμενο μελάνι καλύπτει μια επιφάνεια σε κενό αέρος, ή η νανολιθογραφία με στυλό εμβάπτισης, κατά την οποία ένα μικροσκόπιο ατομικής δύναμης εφαρμόζει το μελάνι με μεγάλη ακρίβεια στο υπόστρωμα, θεωρούνται μερικές φορές ότι περιλαμβάνονται στην ομπρέλα των τυπωμένων ηλεκτρονικών, και παρόλο που μπορούν να επιτύχουν μικρότερα μεγέθη χαρακτηριστικών απαιτούν εξειδικευμένο εξοπλισμό και δεν είναι τόσο φιλικές προς το κόστος όσο οι παραδοσιακές μέθοδοι εκτύπωσης και συνεπώς λιγότερο συναφείς.

Dimatix DMP-2850 Materials Printer. Source: FUJIFILM

Μεγάλο φύλλο κυκλωμάτων τυπωμένο σε σύστημα Roll-to-Roll. Source: PRINTED ELECTRONICS LTD

\newpage

## Μελάνια

Για την υλοποίηση λειτουργικών κυκλωμάτων απαιτούνται μελάνια με αγώγιμες, ημιαγώγιμες και διηλεκτρικές ιδιότητες. Συνήθως αποτελούνται από νανοσωματίδια υλικών με αυτές τις ιδιότητες που αναμειγνύονται με διαλύτη στο επιθυμητό ιξώδες και άλλα πρόσθετα για να καταστεί δυνατή η διαδικασία εκτύπωσης. Μπορούν να χρησιμοποιηθούν τόσο οργανικά όσο και ανόργανα υλικά.

- Αγώγιμα μελάνια: Η πλειονότητα των υλικών για αγώγιμα μελάνια είναι μεταλλικά νανοσωματίδια, με πιο συνηθισμένο το ασήμι. Αν και ο άργυρος ανήκει στην κατηγορία των πολύτιμων μετάλλων, το ασημένιο μελάνι δεν είναι φοβερά ακριβό, με στυλό με αγώγιμο ασημένιο μελάνι να κοστίζει λιγότερο από 4 δολάρια. Άλλα μέταλλα που χρησιμοποιούνται είναι ο χρυσός, το αλουμίνιο και ο χαλκός. Τα μελάνια χαλκού και αλουμινίου υφίστανται πολύ χειρότερη γήρανση από τα ασημένια. Τα οργανικά μελάνια βασίζονται συχνά σε νανοσωλήνες άνθρακα ή γραφένιο. Χρησιμοποιούνται επίσης φθηνότερα πολυμερή, παρά την κατώτερη αγωγιμότητά τους. Το πιο δημοφιλές είναι το PEDOT:PSS. Κεραμικά υλικά χρησιμοποιούνται επίσης σε αγώγιμα μελάνια, κυρίως οξείδιο του κασσίτερου του ινδίου(ITO), αν και πρόκειται για ακριβό υλικό.

- Ημιαγώγιμα μελάνια: Τα πιο συνηθισμένα ανόργανα υλικά που χρησιμοποιούνται είναι το πυρίτιο και το γερμάνιο και από τα οργανικά τα περισσότερα βασίζονται και πάλι σε CNT ή γραφένιο. Από αυτά μπορούν να παραχθούν τόσο υλικά τύπου p όσο και υλικά τύπου n, αν και οι τύποι p έχουν ιστορικά πολύ υψηλότερη απόδοση. (Το αντίθετο ισχύει για τα τρανζίστορ με πύλη ηλεκτρολύτη).

- Διηλεκτρικά μελάνια: Το διηλεκτρικό στρώμα πρέπει να είναι παχύτερο από το αγώγιμο και το ημιαγώγιμο στρώμα, ώστε να μην διαρρέει φορτίο μέσω αυτού. Ως ενεργό συστατικό μπορούν να χρησιμοποιηθούν υλικά υποστρώματος, κεραμικά οξείδια και πολυμερή.

### EGFET

Η παρούσα εργασία βασίζεται στο Process Design Kit(PDK) για τρανζίστορ επίδρασης πεδίου οξειδίου με ηλεκτρολύτη(EGFET)[@egfet]. Το EGFET χρησιμοποιεί στερεούς πολυμερείς ηλεκτρολύτες για την πύλη των τρανζίστορ αντί για διηλεκτρικά. Συγκεκριμένα χρησιμοποιείται οξείδιο του ινδίου για το σκοπό αυτό. Μπορούν να λειτουργήσουν σε συχνότητα έως και 250 Hz σε τάση 1V.

Το κύριο πλεονέκτημα των EGFET σε σύγκριση με τα οργανικά τρανζίστορ είναι ότι μπορούν να οδηγηθούν σε πολύ χαμηλές τάσεις, έως και 0,6V. Αυτό είναι ζωτικής σημασίας για την ικανοποίηση των περιορισμών που επιβάλλουν οι διαθέσιμες τυπωμένες μπαταρίες. Η περιοχή που καλύπτουν είναι ωστόσο σημαντικά μεγαλύτερη(10-100x) από εκείνη των οργανικών τρανζίστορ όπως τα CNT-TFT[@cnttft]. Για παράδειγμα, ένα απλό SR-latch που βασίζεται σε EGFET καταλαμβάνει 7mm$^2$. Μια άλλη διαφορά των τρανζίστορ με ηλεκτρολύτη με τα αντίστοιχα οργανικά είναι ότι στο EGFET είναι δυνατόν να υλοποιηθούν μόνο τρανζίστορ τύπου n, ενώ στο CNT είναι δυνατόν να υλοποιηθούν μόνο τρανζίστορ τύπου p. Κανένα από τα δύο δεν υποστηρίζει και τα δύο, οπότε οι πύλες CMOS δεν μπορούν να χρησιμοποιηθούν σε τυπωμένα κυκλώματα.

\newpage

## Δυαδικά νευρωνικά δίκτυα

BNN είναι ο όρος για τα νευρωνικά δίκτυα που έχουν τόσο τις ενεργοποιήσεις όσο και τα βάρη με ακρίβεια 1 bit σε όλα τα κρυφά στρώματα. Τα στρώματα εισόδου οφείλουν να έχουν εισόδους υψηλότερης ακρίβειας, ώστε το δίκτυο να λαμβάνει επαρκείς πληροφορίες για να είναι δυνατή η ταξινόμηση, ενώ τα στρώματα εξόδου των ταξινομητών έχουν τις ενεργοποιήσεις τους να συγκρίνονται μεταξύ τους για να αποφασίσουν για την προβλεπόμενη κλάση, οπότε δεν μπορούν να δυαδικοποιηθούν. Ο πιο συνηθισμένος τομέας για τα BNN είναι τα Convolutional Neural Networks(CNNs). Παρουσιάστηκαν ανεξάρτητα το 2016 από τις εργασίες [@fn23] και [@fn24].

Πέρα από τη μείωση του μεγέθους αποθήκευσης που απαιτείται για τα βάρη $32\times$ σε σύγκριση με ένα δίκτυο πλήρους ακρίβειας 32-bit της ίδιας αρχιτεκτονικής, το υπολογιστικό κόστος μειώνεται επίσης σημαντικά, καθώς οι πράξεις πολλαπλασιασμού-συσσώρευσης(MAC) μπορούν να πραγματοποιηθούν με πράξεις XNOR και popcount. Αυτό μπορεί να οδηγήσει σε βελτίωση της ταχύτητας έως και $58\times$.

Κατά τη διάρκεια της εκπαίδευσης, χρησιμοποιούνται υποκείμενα βάρη υψηλότερης ακρίβειας για να γίνει η μάθηση πιο ισχυρή. Στη φάση προς τα εμπρός διάδοσης, αυτά τα ακριβέστερα βάρη, $W$, και οι ενεργοποιήσεις από το προηγούμενο επίπεδο $I$ δυαδικοποιούνται χρησιμοποιώντας τη συνάρτηση προσήμου:

$$ 
sign(x) = \begin{dcases}
    +1, & \text{if } x \geq 0\\
    -1,              & \text{if } x < 0
\end{dcases}
$$

Οι δυαδικές πράξεις $({-1,1},*)$ και $({0,1},\odot)$ είναι ισόμορφες, οπότε ο πολλαπλασιασμός των βαρών με τις ενεργοποιήσεις γίνεται με τη χρήση της πράξης XNOR όταν οι δυαδικές τιμές {-1,1} κωδικοποιούνται στις λογικές τιμές {0,1} για να αποθηκευτούν σε ένα bit.

Αυτή η απεικόνιση μπορεί να αναπαρασταθεί με τον γραμμικό μετασχηματισμό $f(x) = \frac{x+1}{2}$, αφού $f(-1) = 0$ και $f(1)=1$. Η συσσώρευση και η επακόλουθη δυαδικοποίηση των προϊόντων ενεργοποίησης-βάρους $sign(I)*sign(W)$ μπορεί να υπολογιστεί με την εκτέλεση μιας πράξης popcount, η οποία επιστρέφει τον αριθμό των bit σε μια δεδομένη συλλογή που είναι 1, και τη σύγκριση του αποτελέσματος με ένα κατώφλι για τη δυαδικοποίηση.

Κατά τη διάρκεια της προς τα πίσω διάδοσης, πρέπει να χρησιμοποιηθεί μια προσέγγιση της συνάρτησης ενεργοποίησης $sign$, δεδομένου ότι το $sign$ έχει παράγωγο 0. Η πιο συνηθισμένη μέθοδος είναι γνωστή ως straight-through estimation(STE). Στην STE η συνάρτηση πρόσημου προσεγγίζεται ως εξής:

$$ 
STEsign(x) = \begin{dcases}
    +1, & \text{if } x \geq 1\\
    x, & \text{if } 1 \geq x \geq -1\\
    -1,              & \text{if } x \leq -1
\end{dcases}
$$

η οποία έχει παράγωγο:

$$ 
\frac{dSTEsign}{dx} = \begin{dcases}
    1, & \text{if } 1 \geq x \geq -1\\
    0,              & elsewhere
\end{dcases}
$$

Οι ενημερώσεις γίνονται στα υποκείμενα βάρη υψηλότερης ακρίβειας και οι δυαδικοποιήσεις τους χρησιμοποιούνται για το εμπρόσθιο πέρασμα.

## Σύνολα δεδομένων

Τα σύνολα δεδομένων που επιλέχθηκαν για την εκπαίδευση των μοντέλων και την υλοποίηση είναι αυτά που χρησιμοποιήθηκαν από το [@fn20]. Με αυτόν τον τρόπο τα αποτελέσματα για την ακρίβεια του μοντέλου και τις απαιτήσεις σε χώρο/ενέργεια μπορούν να συγκριθούν με άλλες προσεγγίσεις στη βιβλιογραφία. Όπως και σε αυτές τις εργασίες, τα κατηγορικά χαρακτηριστικά αφαιρέθηκαν από τα σύνολα δεδομένων, αφήνοντας μόνο τις εισόδους από αισθητήρες, αφού σε αυτές θα έχει πρόσβαση το πραγματικό εκτυπωμένο σύστημα (αυτή η υπόθεση μπορεί να παρακαμφθεί, αλλά αυτό είναι πέρα από το τρέχον αντικείμενο). Σημειώστε ότι η επιλογή των χαρακτηριστικών μπορεί να μην είναι η ίδια με τις προηγούμενες εργασίες, δεδομένου ότι τα κομμάτια δεδομένων που διατηρούσαν δεν τεκμηριώνονταν. Όλα τους ελήφθησαν από το αποθετήριο μηχανικής μάθησης του UCI[@fn7].

Σύντομη περιγραφή των συνόλων δεδομένων:

- Arrythmia[@fn8]: Διάγνωση καρδιακής αρρυθμίας από 12 ηλεκτροκαρδιογραφήματα.
- Cardio[@fn9]: Διάγνωση προβλημάτων στον καρδιακό ρυθμό αγέννητων
  βρεφών.
- Pendigits[@fn10]: Ταξινόμηση γραπτού ψηφίου από μια σειρά 8
  σημάτων πίεσης από αισθητήρες αφής.
- Human Activity Recognition(HAR)[@fn11]: Ταξινόμηση του τύπου της
  κίνησης ενός ατόμου (ορθοστασία, ανέβασμα σκαλοπατιών κ.λπ.) με τη χρήση επιταχυνσιόμετρων από κινητά τηλέφωνα
στη μέση τους.
- Gas Id[@fn12]: Ταξινόμηση της παρουσίας αερίου με χρήση χημικών
αισθητήρων.
- Wine quality(white wine)[@fn13]: Εκτίμηση της αντιλαμβανόμενης απόλαυσης των
  διαφόρων λευκών κρασιών με βάση την οξύτητα και τα ίχνη ανόργανων συστατικών.
- Wine quality(red wine)[@fn13]: Αντίστοιχο με το παραπάνω για τα κόκκινα κρασιά.

Τα σύνολα δεδομένων χρησιμοποιούν εισόδους από αισθητήρες που αντιστοιχούν τουλάχιστον κατά προσέγγιση σε αισθητήρες που έχει αποδειχθεί ότι είναι δυνατόν να κατασκευαστούν με εκτύπωση. Το πλήρες σύστημα που περιλαμβάνει αισθητήρες, ταξινομητή και τροφοδοσία ρεύματος θα μπορούσε έτσι να υλοποιηθεί κάπως ρεαλιστικά και να μην απέχει πολύ από μια πραγματική περίπτωση χρήσης της τεχνολογίας.

Αισθητήρας | Dataset
---|---
Electrocardiography sensor on paper[@fn1] | Arrythmia
Electrocardiography sensor on paper[@fn1] | Cardio
Printed movement sensor | Human activity recognition
Printed gas sensor[@fn6] | Gas identification
Printed piezoelectric sensor[@fn4] | Pendigits
Printed pH sensor[@fn2], Inkjet mineral sensor[@fn3] | Wine Quality(White)
Printed pH sensor[@fn2], Inkjet mineral sensor[@fn3] | Wine Quality(Red)

\newpage

# Προτεινόμενο σύστημα

Προτεινόμενο σύστημα

Όπως περιγράφεται στην ενότητα πανταχού παρούσα πληροφορική, το παραδοτέο αυτής της διατριβής προορίζεται να είναι ένα πλαίσιο που επιτρέπει σε ένα επισημασμένο σύνολο δεδομένων αισθητήρων να παράγει ένα πλήρως λειτουργικό τυπωμένο κύκλωμα που υλοποιεί έναν ταξινομητή για αυτό το σύνολο δεδομένων. Λόγω της έλλειψης πρόσβασης σε εξοπλισμό, η πραγματική εκτύπωση δεν είναι βιώσιμη σε αυτό το σημείο και το πεδίο εφαρμογής θα περιοριστεί στο μέρος της διαδικασίας από το σύνολο δεδομένων στη netlist.

Η αρχιτεκτονική του ταξινομητή θα είναι ειδικότερα ένα δυαδικό νευρωνικό δίκτυο (BNN), όπως εξηγείται στα προκαταρκτικά. Μπορεί να μην είναι απαραίτητα η καταλληλότερη αρχιτεκτονική σε κάθε περίπτωση, αλλά δημιουργήθηκε με σκοπό τη μείωση της κατανάλωσης πόρων, η οποία αποτελεί το βασικό μέλημα. Επιλέχθηκε έτσι ως η γωνιά που θα εξετάσω εδώ.

Η πρόχειρη ακολουθία των διεργασιών που εκτελούν τον εν λόγω μετασχηματισμό περιλαμβάνει τα εξής:

1. Αναζήτηση υπερπαραμέτρων: Προκειμένου μια διαδικασία εκπαίδευσης που δεν απαιτεί χειρισμό να είναι εφαρμόσιμη σε έναν αχανή χώρο πιθανών συνόλων δεδομένων αισθητήρων για τα οποία μπορεί να είναι επιθυμητοί οι εκτυπωμένοι ταξινομητές, μια ενιαία γενική διαμόρφωση των υπερπαραμέτρων εκπαίδευσης δεν επαρκεί. Έτσι, πρέπει να πραγματοποιηθεί αναζήτηση για την εύρεση ενός συνόλου κατάλληλου για την εκάστοτε κατανομή δεδομένων.
2. Εκπαίδευση μοντέλων: Αφού βρεθεί μια χρήσιμη διαμόρφωση υπερπαραμέτρων, ένα μοντέλο εκπαιδεύεται βάσει αυτών και αξιολογείται. Εάν η ακρίβεια του διαχωρισμού δοκιμής είναι επαρκής για τις ανάγκες του χρήστη, μπορεί να πραγματοποιηθεί η υπόλοιπη διαδικασία. Τα βάρη και η αρχιτεκτονική του δικτύου του τελικού μοντέλου διαβιβάζονται προς επεξεργασία.
3. Βελτιστοποίηση των παραμέτρων: Ορισμένες πληροφορίες που προκύπτουν από τα βάρη και το σύνολο δεδομένων μπορούν να χρησιμοποιηθούν για να βοηθήσουν τον σχεδιασμό να αποφύγει τους περιττούς υπολογισμούς. Για ένα ακραίο αλλά πρακτικά ισχύον παράδειγμα, εάν ένας νευρώνας δεν αλλάζει ποτέ την έξοδό του με βάση τις ενεργοποιήσεις εισόδου του, μπορεί να επισημανθεί ώστε να αντικατασταθεί με μια στατική σταθερή ανάθεση.
4. Κωδικοποίηση παραμέτρων: Τα βάρη, τα μέτρα της αρχιτεκτονικής του δικτύου και οι παράγωγες πληροφορίες υποβοήθησης είτε χρησιμοποιούνται για την παραγωγή κώδικα verilog που εκτελεί τους υπολογισμούς που συνεπάγονται είτε μορφοποιούνται έτσι ώστε να μπορούν να διαβαστούν και να αναλυθούν από τους μηχανισμούς ελέγχου της Verilog.
5. Ενσάρκωση της σχεδίασης: Ένα template για τον τύπο της σχεδίασης που θα έπρεπε να παραχθεί λαμβάνει τα αποσπάσματα της προσαρμοσμένης λειτουργικότητας ή/και τις μορφοποιημένες παραμέτρους που απαιτούνται για την εξαγωγή της εν λόγω λειτουργικότητας με τη χρήση των generate blocks που εισάγονται σε αυτό. Το αποτέλεσμα είναι ένας σχεδιασμός που είναι προσαρμοσμένος στο ακριβές εκπαιδευμένο υπό εξέταση μοντέλο.
6. Επαλήθευση: Πραγματοποιείται προσομοίωση συμπεριφοράς του σχεδιασμού για να επιβεβαιωθεί ότι η ακρίβεια του ταξινομητή διατηρείται ικανοποιητικά.
7. Σύνθεση: Μια βελτιστοποιημένη λίστα δικτύου παράγεται από τις προδιαγραφές HDL. Πραγματοποιείται προσομοίωση σε επίπεδο πύλης για να εξασφαλιστεί η λειτουργικότητα.
8. Εκτίμηση μετρικών: Οι εκτιμήσεις εμβαδού και ισχύος λαμβάνονται από τα εργαλεία σύνθεσης και προσομοίωσης χρησιμοποιώντας πληροφορίες από το PDK των τυπωμένων εξαρτημάτων. Εάν οι απαιτήσεις αυτές φαίνεται να υποστηρίζονται από τον προϋπολογισμό της περίπτωσης χρήσης, ο χρήστης μπορεί να δώσει εντολή εκτύπωσης.

Τμήματα της ευρύτερης διαδικασίας που δεν εμπίπτουν στο πεδίο εφαρμογής του παρόντος πλαισίου είναι:

- Διαθεσιμότητα εκτυπωμένων αισθητήρων
- Πρόσβαση σε δεδομένα εκτυπωμένων αισθητήρων για την επισήμανση
- Εξέταση άλλων υποσχόμενων αρχιτεκτονικών
- Σχεδιασμός μασκών για την τοποθέτηση τυπωμένων στοιχείων
- Συμπερίληψη της κατανάλωσης πόρων αισθητήρα, ADC και ένδειξης εξόδου σε
  αναφερόμενες εκτιμήσεις. 

Επιπλέον, το πλαίσιο παρέχει έναν τρόπο γρήγορης δοκιμής, αξιολόγησης και σύγκρισης υλοποιήσεων μοντέλων Verilog. Από τη στιγμή που έχει γραφτεί ο πρότυπος σχεδιασμός δεν απαιτούνται χειροκίνητα βήματα από τον σχεδιαστή για την εφαρμογή του σε κάθε μοντέλο που τον ενδιαφέρει, την επαλήθευση της λειτουργικότητάς του και τη λήψη feedback σχετικά με το πώς η νέα προσέγγιση συγκρίνεται με τις προηγούμενες. Αυτή η πτυχή του πλαισίου επέτρεψε στον πειραματισμό για την αναζήτηση αποδοτικών υλοποιήσεων BNN να προχωρήσει με ρυθμό που δεν θα ήταν εφικτός εάν τα βήματα αυτά δεν ήταν αυτοματοποιημένα.

Το υπόλοιπο της διατριβής θα ασχοληθεί σχεδόν εξ ολοκλήρου με τη σχεδίαση αποδοτικού υλικού ταξινομητή BNN κατά παραγγελία. Αυτό περιλαμβάνει τα μέρη 3 και 5 της διαδικασίας που αναφέρονται παραπάνω. Τα υπόλοιπα, αν και είναι χρονοβόρα για την υλοποίηση, δεν έχουν μέρη που να παρουσιάζουν ενδιαφέρον και θα συνοψιστούν στην ενότητα πειραματικής διάταξης.

Τα σημεία που νομίζω ότι είναι χρήσιμο να παρουσιαστούν εκ των προτέρων, προκειμένου να είναι κατανοητή η συζήτηση που θα ακολουθήσει για τις υλοποιήσεις HDL, είναι τα εξής:

- Κατά τη διάρκεια της εργασίας στα σχέδια που παρουσιάζονται χρησιμοποιούνται σταθερά 6 μοντέλα που αντιστοιχούν σε 6 από τα 7 σύνολα δεδομένων που παρουσιάζονται παραπάνω για τη δοκιμή και τη σύγκριση των αποτελεσμάτων. Το ένα σύνολο δεδομένων από τα 7 που δεν κατάφερε να περάσει ήταν το Arrhythmia, επειδή η εκμαθημένη στρατηγική του μοντέλου δεν ήταν αποδεκτή.

- Όλα αυτά τα δίκτυα έχουν ένα κρυφό στρώμα που δέχεται εισόδους 4 bit που λαμβάνονται από τους ADC που είναι συνδεδεμένοι με τους αντίστοιχους αισθητήρες και ένα στρώμα εξόδου που δέχεται δυαδικές εισόδους 1 bit από το προηγούμενο στρώμα και παράγει μια βαθμολογία για το πόσο πιθανή είναι η κάθε κλάση. Μια μονάδα argmax περιλαμβάνεται επίσης σε όλες τις ακόλουθες υλοποιήσεις για να παρέχει το δείκτη της προβλεπόμενης κλάσης και περιλαμβάνεται επίσης στις εκτιμήσεις περιοχής/ισχύος.

- Όλα αυτά τα δίκτυα έχουν ακριβώς 40 κρυμμένους νευρώνες στο πρώτο επίπεδο. Αυτό δεν αντικατοπτρίζει έναν πραγματικό περιορισμό του πλαισίου. Μια πρώτη παρτίδα μοντέλων που χρησιμοποιήθηκαν για την αξιολόγηση των σχεδίων και επρόκειτο να αντικατασταθούν κάποια στιγμή, κατέληξε να παραμείνει μέχρι το τέλος. Mετά από κάποιο σημείο η αντικατάστασή τους θα απαιτούσε την επαναξιολόγηση κάθε τύπου υλοποίησης σχεδιασμού με κάθε νέο μοντέλο, προκειμένου οι συγκρίσεις αποτελεσμάτων να είναι κατατοπιστικές, γεγονός που θα απαιτούσε σημαντική χρήση του χρόνου σύνθεσης και θα σταματούσε την περαιτέρω πρόοδο για κάποιο χρονικό διάστημα.

- Κατά τη διάρκεια της σύνθεσης επιτρέπεται ένας πρακτικά απεριόριστος προϋπολογισμός χρονισμού, ώστε να μην πραγματοποιούνται βελτιστοποιήσεις χρονισμού και να μην αντισταθμίζονται με πιο σημαντικούς για το έργο στόχους.

- Η εκτίμηση της κατανάλωσης ισχύος γίνεται με προσομοίωση του συντιθέμενου κυκλώματος σε επίπεδο πύλης, αξιολογώντας 1000 δείγματα του συνόλου δεδομένων για την αναπαραγωγή ενός ρεαλιστικού περιβάλλοντος χρήσης. Η συχνότητα ρολογιού ορίζεται στην κρίσιμη συχνότητα χρονισμού του κυκλώματος που αναφέρει το εργαλείο σύνθεσης.

\newpage

## Γλωσσάριο συμβόλων
- $N$ = ο αριθμός των χαρακτηριστικών εισόδου,  
- $M$ = ο αριθμός των κρυφών νευρώνων (στην περίπτωσή μας είναι πάντα 40),  
- $C$ = ο αριθμός των νευρώνων εξόδου/ αριθμός κλάσεων.  
- $S$ είναι ο αριθμός των δειγμάτων στο σύνολο δεδομένων,
- $x_i$ είναι το $i$-οστό χαρακτηριστικό εισόδου,  
- $D^i$ το $i$-οστό δείγμα του συνόλου δεδομένων,
- $D^i_j$ είναι η τιμή που παίρνει το $j$-οστό χαρακτηριστικό εισόδου στο $i$-οστό δείγμα του συνόλου δεδομένων,
- $h_i$ είναι ο $i$-οστός κρυφός νευρώνας, που χρησιμοποιείται επίσης για να δηλώσει την τιμή εξόδου του πριν από τη δυαδικοποίηση,  
- $s_i$ είναι η έξοδος του $i$-οστού κρυμμένου νευρώνα μετά τη δυαδικοποίηση, οπότε $s_i = h_i \ge 0$,  
- $y_i$ είναι ο $i$-οστός νευρώνας εξόδου, που χρησιμοποιείται επίσης για να δηλώσει την τιμή εξόδου του,  
- $W1$ = ο πίνακας βαρών του πρώτου στρώματος,  
- $W2$ = ο πίνακας βαρών του δεύτερου στρώματος,  

Οι σειρές αντιπροσωπεύουν νευρώνες και οι στήλες αντιπροσωπεύουν ενεργοποιήσεις εισόδου,
έτσι $W1_{i,j}$ είναι το βάρος του πρώτου στρώματος που αντιστοιχεί στην
σύνδεση μεταξύ του χαρακτηριστικού εισόδου $x_j$ και του νευρώνα $h_i$.

\newpage

# Πλήρως συνδυαστικές πλήρως συνδεδεμένες υλοποιήσεις
Συγκρίνονται δύο αρχικές προσεγγίσεις για την υλοποίηση των πλήρως συνδεδεμένων BNNs σε ένα πλήρως συνδυαστικό μονοπάτι δεδομένων. Μόνο το πρώτο στρώμα διαφέρει μεταξύ τους, το δεύτερο στρώμα παραμένει αμετάβλητο.

## Θετικό-αρνητικό άθροισμα

Υλοποίηση με διαχωρισμό θετικών και αρνητικών αθροισμάτων

Για κάθε νευρώνα στο πρώτο στρώμα υπολογίζονται δύο αθροίσματα. $\Sigma^+_i$ είναι το άθροισμα των χαρακτηριστικών εισόδου για τα οποία η σύνδεση με τον $i$-οστό κρυφό νευρώνα έχει θετικό βάρος , ενώ $\Sigma^-_i$ το άθροισμα εκείνων που έχουν αρνητικό βάρος συνδεδεμένο. Τα δύο αθροίσματα συγκρίνονται στη συνέχεια και αν το θετικό άθροισμα είναι μεγαλύτερο ή ίσο με το αρνητικό η έξοδος του νευρώνα είναι 1, διαφορετικά 0.
$$ \Sigma^+_i = \sum_{j=0}^{N-1} x_j [W1_{i,j} > 0] $$
$$ \Sigma^-_i = \sum_{j=0}^{N-1} x_j [W1_{i,j} < 0] $$
$$ h_i = \Sigma^+_i \ge \Sigma^-_i $$

Sample code snippet:
```{.verilog}
assign positives[0] = + feature_array[1] + feature_array[2] + ... + feature_array[10];
assign negatives[0] = + feature_array[0] + feature_array[3] + feature_array[5];
assign hidden[0] = positives[0] >= negatives[0];
```

Η λογική πίσω από τη διάσπαση των αθροισμάτων είναι ότι η διατήρηση των λειτουργιών στη χρήση μόνο μη προσημασμένων θετικών αριθμών και η χρήση μόνο της πρόσθεσης και όχι της αφαίρεσης σημαίνει ότι απαιτούνται απλούστερες λειτουργίες και αυτό μπορεί να οδηγήσει σε μικρότερο αποτύπωμα.

Για κάθε νευρώνα του στρώματος εξόδου η τιμή του υπολογίζεται αθροίζοντας την έξοδο των κρυφών νευρώνων. Η δυαδική έξοδος του κρυμμένου νευρώνα $s_j$ προστίθεται ως έχει στο άθροισμα του νευρώνα εξόδου $y_i$ στην περίπτωση που το βάρος της σύνδεσής τους $W2_{i,j}$ είναι θετικό και το δυαδικό αντίστροφό του προστίθεται στο άθροισμα αν το $W2_{i,j}$ είναι αρνητικό. Αυτό ισοδυναμεί με το άθροισμα του xnor μεταξύ του διανύσματος εξόδου του κρυφού στρώματος και του διανύσματος βάρους του νευρώνα εξόδου.

$$
y_i = \sum_{j=0}^{M-1} \begin{dcases}
    s_j,& \text{if } W2_{i,j} > 0\\
    \neg s_j,              & \text{if } W2_{i,j} < 0
\end{dcases}
$$

Code sample:

```{.verilog}
assign scores[0*SUM_BITS+:SUM_BITS] = + hidden_n[0] + hidden[1] + hidden[2] + ... + hidden_n[39];
```

## Προσημασμένο άθροισμα

Εφαρμογή ενός μόνο αθροίσματος ανά νευρώνα

Σε αυτή την έκδοση υπολογίζεται ένα μόνο άθροισμα για κάθε νευρώνα. Εάν η σύνδεση μεταξύ του χαρακτηριστικού εισόδου $x_j$ και του κρυμμένου νευρώνα $h_i$ έχει βάρος $W1_{i,j} = 1$ προστίθεται στο άθροισμα, διαφορετικά αφαιρείται από αυτό. Ουσιαστικά η πρόσθεση του χαρακτηριστικού πολλαπλασιασμένου είτε με 1 είτε με -1 είναι hard-coded ως η προκύπτουσα πρόσθεση ή αφαίρεση αντίστοιχα. Το αποτέλεσμα στη συνέχεια συγκρίνεται με το μηδέν για να δώσει τη δυαδική έξοδο του νευρώνα. Δεδομένου ότι το αποτέλεσμα είναι ένας προσημασμένος αριθμός, αυτό σημαίνει απλώς ότι λαμβάνεται το bit του προσήμου.

$$
h_i = \sum_{j=0}^{N-1} \begin{dcases}
    + x_j,& \text{if } W1_{i,j} > 0\\
    - x_j,              & \text{if } W1_{i,j} < 0
\end{dcases}
$$

Code sample:
```{.verilog}
wire signed [8:0] intra_0;
assign intra_0 = - feature_array[0] + feature_array[1] + ... + feature_array[10];
assign hidden[0] = intra_0 >= 0;
```
Η υλοποίηση του δεύτερου στρώματος δεν αλλάζει από τον τρόπο που είναι περιγράφεται παραπάνω.

### Αποτελέσματα και ανάλυση

| | bnnpar area(cm²) | bnnparsign area(cm²) | area change | bnnpar power(mW) | bnnparsign power(mW) | power change |
|:---|---:|---:|:---|---:|---:|:---|
| Har | 29.4  | 24.52 | -16.6% | 92.1 | 78.8 | -14.4% |
| cardio | 46.71 | 33.27 | -28.8% | 145.3 | 106.2 | -26.9% |
| gasId | 269.76 | 175.09 | -35.1% | 767.7 | 499.1 | -35.0% |
| pendigits | 42.95 | 33.38 | -22.3% | 136.8 | 108.9 | -20.4% |
| winered | 27.82 | 22.45 | -19.3% | 90.7 | 74.6 | -17.8% |
| winewhite | 26.01 | 20.47 | -21.3% | 84.6 | 68 | -19.6% |

Table: Σύγκριση του απλού προσημασμένου αθροίσματος με την προσέγγιση διπλού μη προσημασμένου αθροίσματος

Σύγκριση του αθροίσματος με μονό πρόσημο με την προσέγγιση διπλών αθροισμάτων χωρίς πρόσημο

Η αρχική μου προσδοκία ήταν ότι η διάσπαση των χαρακτηριστικών σε δύο αθροίσματα για την αποφυγή αφαιρέσεων θα οδηγούσε σε καλύτερα αποτελέσματα από τη διατήρηση όλων των πράξεων για έναν νευρώνα σε μία μόνο έκφραση με βάση το σκεπτικό που συνοψίστηκε προηγουμένως. Στην πραγματικότητα αποδεικνύεται ότι η χρήση ενός ενιαίου αθροίσματος έχει απαιτήσεις σε επιφάνεια και ισχύ 20-30% χαμηλότερες από τη χρήση δύο αθροισμάτων.

Η εξήγησή μου γι' αυτό είναι ότι η διατήρηση των όρων σε ξεχωριστές εκφράσεις εμποδίζει τον μεταγλωττιστή να εντοπίζει και να μειώνει αποτελεσματικά τις κοινές υποεκφράσεις κατά τη σύνθεση. Για παράδειγμα, αν η έκφραση ενός νευρώνα περιέχει $+x_5+x_6-x_7$ και ένας άλλος νευρώνας περιέχει $-x_5+x_6+x_7$ τότε το αποτέλεσμα του $x_5-x_7$ μπορεί να χρησιμοποιηθεί και για τους δύο νευρώνες, αλλά αν τα $x_5$ και $x_7$ δεν είναι στην ίδια έκφραση, όπως δεν θα ήταν στην υλοποίηση θετικού-αρνητικού αθροίσματος, αυτή η αριθμητική βελτιστοποίηση δεν χρησιμοποιείται από τον μεταγλωττιστή.

\newpage

### Μείωση του ελάχιστου εύρους bit-width

Τιμές προ-ενεργοποίησης για έναν κρυφό νευρώνα για κάθε δείγμα του συνόλου δεδομένων και σύγκριση του προκαθορισμένου και του ελάχιστου εύρους bit που υποστηρίζει όλες τις τιμές

Το σκεπτικό λέει ότι αν μειωθεί το εύρος bit που απαιτείται για το συνολικό άθροισμα των χαρακτηριστικών, μειώνεται και το εύρος bit που απαιτούν χαμηλότερα στο γράφημα του αθροιστή τα επιμέρους αθροίσματα από τα οποία εξαρτάται. Κατά συνέπεια, οι αθροιστές πρέπει να φιλοξενήσουν λιγότερα bits και πρέπει να υλοποιηθεί λιγότερη λογική γι' αυτούς.

Τουλάχιστον θεωρητικά, το ελάχιστο κύκλωμα για την υλοποίηση των υπολογισμών των αθροισμάτων του πρώτου στρώματος με μειωμένα πλάτη για τα αποτελέσματα θα πρέπει να είναι αυστηρά ίσο ή μικρότερο από αυτό με πλήρη πλάτη. Αυτό οφείλεται στο γεγονός ότι, δεδομένου ενός κυκλώματος που υλοποιεί τους υπολογισμούς πλήρους πλάτους, τα αποτελέσματα μειωμένου πλάτους μπορούν να ληφθούν επιλέγοντας την περιοχή bit αυτού του πλάτους από τα λιγότερο σημαντικά bits του αποτελέσματος πλήρους πλάτους. Αυτό είναι απλή επιλογή σημάτων και δεν απαιτεί πρόσθετο υλικό, επομένως η μείωση του πλάτους των νευρώνων δεν μπορεί ποτέ να απαιτήσει πρόσθετη λογική.

Μέχρι στιγμής στο πρώτο στρώμα το εύρος bit του συνολικού αθροίσματος $h_i$ του νευρώνα έχει οριστεί να είναι αρκετά μεγάλο ώστε να χωράει οποιαδήποτε τιμή που μπορεί να προκύψει ως αποτέλεσμα $M$ προσθέσεων και αφαιρέσεων 4-bit μη προσημασμένων αριθμών. Η υπόθεση είναι ότι αυτό το εύρος είναι σημαντικά ευρύτερο από το εύρος των τιμών που παίρνει στην πραγματικότητα ο νευρώνας κατά την αξιολόγηση τυπικών δειγμάτων. Αυτό θα σήμαινε ότι το εύρος bit μπορεί να μειωθεί χωρίς σφάλματα λόγω υπερχείλισης ή υποχείλισης κατά την πραγματική χρήση του σχεδίου, και αυτή η μείωση θα βελτίωνε την απόδοση.

Για να ελεγχθεί αυτό υπολογίζεται το συνολικό άθροισμα κάθε νευρώνα $h_i$ για κάθε δείγμα στο σύνολο δεδομένων. Παίρνω την ελάχιστη και τη μέγιστη τιμή αυτών των τιμών. Δεδομένου ότι όλες οι τιμές που πρέπει να πάρει το συνολικό άθροισμα περιέχονται στο εύρος μεταξύ αυτών των δύο, οι αριθμητικές πράξεις δεν χρειάζεται να εξυπηρετήσουν οποιοδήποτε εύρος μεγαλύτερο από αυτό.  Έστω $H^i_j$ η τιμή του $h_i$ κατά την αξιολόγηση του $i$-οστού δείγματος του συνόλου δεδομένων και $wh_i$ το εύρος bit του $i$-οστού κρυμμένου νευρώνα.

$$h_{i max} = \max\limits_{j=0}^{S-1} H^i_j$$
$$h_{i min} = \min\limits_{j=0}^{S-1} H^i_j$$
$$ wh_i = \lceil \log_2(\max(h_{i max},\lvert h_{i min}\rvert -1)) \rceil+1 $$

### Αποτελέσματα και ανάλυση

| | bnnparsign area(cm²) | bnnparw area(cm²) | area change | bnnparsign power(mW) | bnnparw power(mW) | power change |
|:---|---:|---:|:---|---:|---:|:---|
| Har | 24.52 | 24.25 | -1.1% | 78.8 | 77.6 | -1.5% |
| cardio | 33.27 | 33.21 | -0.2% | 106.2 | 105.4 | -0.8% |
| gasId | 175.09 | 171.37 | -2.1% | 499.1 | 486.9 | -2.4% |
| pendigits | 33.38 | 33.97 | +1.8% | 108.9 | 109.6 | +0.6% |
| winered | 22.45 | 21.87 | -2.6% | 74.6 | 72.3 | -3.1% |
| winewhite | 20.47 | 20.36 | -0.5% | 68 | 66.7 | -1.9% |

Table: Αποτελέσματα του περιορισμού του εύρους bit των νευρώνων

Αποτελέσματα του περιορισμού των bitwidths των νευρώνων

Τα αποτελέσματα είναι αμελητέα, στην περιοχή του 1-3%, και στην περίπτωση των pendigits μάλιστα επιδεινώνονται λίγο. Αυτή η επιδείνωση δεν θα έπρεπε να είναι δυνατή θεωρητικά εάν τα συνθετικά κυκλώματα είναι βέλτιστες υλοποιήσεις της περιγραφής τους. Αυτό είναι τουλάχιστον ένδειξη ότι τα αμελητέα αποτελέσματα στα άλλα σύνολα δεδομένων μπορούν να είναι καλύτερα, αν μπορέσω να τα φέρω σε μια μορφή με την οποία ο μεταγλωττιστής μπορεί να δουλέψει καλύτερα, αν και εξακολουθώ να πιστεύω ότι το κύριο πρόβλημα είναι με την ίδια την προσέγγιση. Φαίνεται ότι η περικοπή αντιβαίνει στις βέλτιστες πρακτικές και μπλοκάρει τη διαδικασία εξαγωγής μονοπατιών δεδομένων για ορισμένους νευρώνες, οπότε ορισμένες βελτιστοποιήσεις δεν εφαρμόζονται σε αυτούς και ορισμένοι που θα ήταν κοινοί πόροι δεν μοιράζονται. Δεν έχω βρει μέθοδο για να παρακάμψω αυτόν τον περιορισμό σε αυτό το σημείο.

\newpage

### Μείωση του εύρους bit των ενδιάμεσων αποτελεσμάτων
#### Συλλογισμός

Με δεδομένο τον τελικό στόχο της εφαρμογής τεχνικών προσεγγιστικού υπολογισμού στο γράφημα αθροιστών των σχεδίων προκύπτει ένα πρόβλημα, που αναφέρθηκε προηγουμένως. Εάν η προσέγγιση, όποια και αν είναι αυτή, εφαρμόζεται ξεχωριστά στο άθροισμα κάθε νευρώνα, σχεδόν σίγουρα μπλοκάρει τη διαδικασία εξαγωγής διαδρομών δεδομένων από την εκτέλεση αριθμητικών βελτιστοποιήσεων, όπως η μείωση και ο διαμοιρασμός κοινών υποεκφράσεων μεταξύ των νευρώνων. Το αποτέλεσμα είναι $M$ ξεχωριστά δέντρα προσεγγιστικού αθροιστή. Ακόμη και με δεδομένο ότι η λογική μείωση που κερδίζεται από τις προσεγγιστικές προσθέσεις για κάθε δέντρο αθροιστή είναι υπεραρκετή για να αντισταθμίσει το χαμένο όφελος από την κοινή χρήση ενδιάμεσων αποτελεσμάτων, αυτή μπορεί να είναι μια περιττή παραχώρηση.

Για να εκτιμήσω πόσο μεγάλη μπορεί να είναι η αρνητική επίδραση μιας τεχνικής προσέγγισης που δεν λαμβάνει υπόψη την κοινή χρήση μεταξύ των νευρώνων, μειώνω τα πλάτη bit των ενδιάμεσων αποτελεσμάτων του αθροίσματος κάθε νευρώνα. Παρόλο που αυτό θα βοηθούσε εύλογα για έναν μεμονωμένο νευρώνα, αναμένω ότι θα προκαλέσει τη διακοπή του διαμοιρασμού πόρων. Δεδομένου του πόσο μεγάλη είναι η αρνητική επίδραση, μπορώ να ελέγξω αν αυτό είναι ένα πρόβλημα που θα έπρεπε να διορθωθεί πριν η προσέγγιση μπορεί να εφαρμοστεί με σιγουριά.

#### Εφαρμογή

Τα ενδιάμεσα αθροίσματα του διαδοχικού υπολογισμού του κρυμμένου νευρώνα 28 για όλο το σύνολο δεδομένων Har και το εύρος των bit που απαιτείται για την υποστήριξη κάθε βήματος

Το σωρευτικό άθροισμα κατά μήκος των χαρακτηριστικών εισόδου πολλαπλασιασμένων με το βάρος της σύνδεσής τους με τον νευρώνα $i$ υπολογίζεται για κάθε κρυφό νευρώνα και για κάθε δείγμα του συνόλου δεδομένων. Στη συνέχεια, υπολογίζεται η μέγιστη και η ελάχιστη τιμή σε όλα τα δείγματα σε κάθε βήμα του σωρευτικού αθροίσματος για έναν συγκεκριμένο νευρώνα. Με παρόμοιο τρόπο με τη μέθοδο που περιγράφηκε παραπάνω για τη μείωση του εύρους bit του συνολικού αποτελέσματος των πράξεων του νευρώνα, οι πράξεις γράφονται διαδοχικά με το αποτέλεσμα της καθεμιάς να έχει το εύρος bit που ορίζεται με βάση το εύρος τιμών για το ισοδύναμο βήμα του αθροίσματος για όλο το σύνολο δεδομένων.

Έστω $h_{i,j}$ το αποτέλεσμα της τιμής προ-ενεργοποίησης του $i$-οστού κρυμμένου νευρώνα λαμβάνοντας υπόψη μόνο τα χαρακτηριστικά εισόδου $x_0$ έως $x_j$, ή ισοδύναμα η τιμή του $h_i$ αν τα $x_{j+1}$ έως $x_{N-1}$ είναι καλυμμένα με μηδέν.

$$ h_{i,j} = \sum_{k=0}^{j} x_k W1_{i,k} $$
$$ hmax_{i,j} = \max\limits_{l=0}^{S-1} \sum_{k=0}^{j} D_k^l W1_{i,k} $$
$$ hmin_{i,j} = \min\limits_{l=0}^{S-1} \sum_{k=0}^{j} D_k^l W1_{i,k} $$
$$ wh_{i,j} = \lceil \log_2(\max(hmax_{i,j},\lvert hmin_{i,j}\rvert -1)) \rceil+1 $$

Μερικές φορές, λόγω της σειράς των προσθέσεων και αφαιρέσεων, το πλάτος που απαιτείται σε ένα μεταγενέστερο βήμα είναι μικρότερο από αυτό ενός προηγούμενου βήματος. Αυτό οφείλεται στο γεγονός ότι κάθε δείγμα για το οποίο θα υπήρχε υπερχείλιση στο προηγούμενο βήμα με το μικρότερο πλάτος θα υποχείλιζε σε κάποιο επόμενο χαρακτηριστικό πίσω στο εύρος που υποστηρίζει. Αυτό έχει ληφθεί υπόψη. Εάν ένα πλάτος του αποτελέσματος μιας επόμενης λειτουργίας είναι μικρότερο, το πλάτος bit της προηγούμενης πρόσθεσης/αφαίρεσης απλά τίθεται σε αυτή τη μικρότερη τιμή.

$$ wh'_{i,j} = \min\limits_{k=j}^{N-1} wh_{i,j} $$

Διαδοχικές πράξεις που έχουν το ίδιο εύρος bit στο αποτέλεσμα ομαδοποιούνται και εκφράζονται σε verilog ως ένα ενιαίο άθροισμα. Δεν έχω επιβεβαιώσει αν αυτό όντως επηρεάζει καθόλου το αποτέλεσμα της σύνθεσης, αλλά φαίνεται να συμμορφώνεται περισσότερο με τις συστάσεις του οδηγού βέλτιστων πρακτικών.

#### Αποτελέσματα και ανάλυση

| | bnnparw area(cm²) | bnnparstepw area(cm²) | area change | bnnparw power(mW) | bnnparstepw power(mW) | power change |
|:---|---:|---:|:---|---:|---:|:---|
| Har | 24.25 | 23.16 | -4.5% | 77.6 | 73.7 | -5.0% |
| cardio | 33.21 | 39.29 | +18.3% | 105.4 | 125.5 | +19.1% |
| gasId | 171.37 | 326.98 | +90.8% | 486.9 | 935.2 | +92.1% |
| pendigits | 33.97 | 37.09 | +9.2% | 109.6 | 120.3 | +9.8% |
| winered | 21.87 | 22.78 | +4.2% | 72.3 | 75.3 | +4.1% |
| winewhite | 20.36 | 20 | -1.8% | 66.7 | 65.8 | -1.3% |

Table: Αποτελέσματα της συρρίκνωσης των ενδιάμεσων αποτελεσμάτων

Αποτελέσματα της συρρίκνωσης ενδιάμεσων αποτελεσμάτων

Τα αποτελέσματα ήταν θετικά για δύο από τα μοντέλα με τον μικρότερο αριθμό χαρακτηριστικών εισόδου $N$, πράγμα που σημαίνει ότι η μέθοδος αυτή απέδωσε καλύτερα από την αρχική προσδοκία. Ωστόσο, η απώλεια βελτιστοποίησης από τη μείωση των κοινών λειτουργιών παρουσιάζει σαφή κλιμάκωση με τον αριθμό $N$ των χαρακτηριστικών εισόδου. Με περισσότερα στοιχεία προς άθροιση, θα έπρεπε να προκύπτουν περισσότερες κοινές υποεκφράσεις προς βελτιστοποίηση, οπότε αυτό ανταποκρίνεται στις προσδοκίες.

Στο δίκτυο με το μεγαλύτερο $N$, αυτό που ανήκει στο gasId, το οποίο έχει 128 χαρακτηριστικά αισθητήρων, η κατάσταση έχει γίνει αρκετά σοβαρή ώστε να διπλασιαστούν σχεδόν οι απαιτήσεις σε επιφάνεια και ισχύ. Αυτό δείχνει ότι το πρόβλημα είναι πράγματι σημαντικό όταν υπάρχουν περισσότερες από ένα μικρό αριθμό εισόδων και θα πρέπει να αναζητηθούν τρόποι για την αντιμετώπισή του.

\newpage

### Προκαταβολική αριθμητική βελτιστοποίηση

Υλοποίηση ενός δυαδικού στρώματος βάρους με προκαθορισμένη σειρά προσθέσεων

#### Αιτιολόγηση
Με βάση τα αποτελέσματα από τα παραπάνω επιχειρώ να πάρω την αριθμητική έκφραση που υπολογίζει το σχέδιο μετά τη σύνθεση, με σκοπό να προσαρμόσω σε αυτήν μεταγενέστερες τεχνικές προσέγγισης, αντί να υπαγορεύουν οι προσεγγίσεις το γράφημα των πράξεων και να χάνονται αυτά τα πλεονεκτήματα.

Ο μεταγλωττιστής σχεδίασης παρέχει μια αναφορά "*resource and datapath extraction*", η οποία, παραθέτοντας τον οδηγό χρήσης, "αναλύει το αριθμητικό περιεχόμενο της σχεδίασης και παρέχει ανατροφοδότηση, ώστε να μπορείτε να βελτιώσετε τον κώδικα RTL όπως απαιτείται". Σε αυτή την αναφορά οι αριθμητικές πράξεις που εκτελούνται μετά τη βελτιστοποίηση από κάθε μπλοκ datapath περιγράφονται στην ενότητα πόρων του μπλοκ. Από αυτό θα μπορούσε να ανακατασκευαστεί ένα γράφημα πρόσθεσης/αφαίρεσης από τα στοιχεία εισόδου στις εξόδους του στρώματος με σχετικά απλή ανάλυση.

Δυστυχώς, η έκθεση δεν παρέχει αντιστοίχιση μεταξύ των συμβόλων που χρησιμοποιεί για τις μεταβλητές εισόδου και εξόδου των μπλοκ datapath και των αντίστοιχων σημάτων στην αρχική σχεδίαση. Εξαιτίας αυτού, ο ανακατασκευασμένος γράφος αθροιστή δεν μπορεί να χρησιμοποιηθεί για την υλοποίηση των επιπέδων του δικτύου, πριν οι είσοδοι και οι έξοδοι επισημανθούν με άλλο τρόπο.

Ως εναλλακτική λύση, αναζητούνται στη βιβλιογραφία αλγόριθμοι ή ευρετικές μέθοδοι που θα εκτελούσαν μια αντίστοιχη αριθμητική βελτιστοποίηση με αυτή που παρέχει ο Design Compiler. Δεν φαντάζει πολύ αισιόδοξο ότι υπάρχει μια de facto πρότυπη μέθοδος για τέτοιες περιπτώσεις και ίσως μάλιστα να είναι αυτή που χρησιμοποιείται κάτω από την κουκούλα του μεταγλωττιστή, οπότε οι λειτουργίες που βρίσκονται είναι ακριβώς ή σχεδόν οι ίδιες. 

Ένα παράδειγμα της αναφοράς εξαγωγής ενός μπλοκ datapath. Επισημαίνεται μια ενδιάμεση τιμή που επαναχρησιμοποιείται πολλές φορές.

#### Εφαρμογή

Μια διατύπωση του προβλήματος είναι η ακόλουθη:  Δεδομένου ενός καταλόγου εκφράσεων της γενικής μορφής $y_i = x_0 + x_1 - x_2 - ... + x_n$ στην οποία οι τελεστές μπορούν να διαμοιραστούν μεταξύ των εκφράσεων βρείτε τον ελάχιστο αριθμό προσθέσεων ή αφαιρέσεων που πρέπει να εκτελεστούν για την αξιολόγηση όλων των εκφράσεων. 

Το πρόβλημα αποδεικνύεται σημαντικά λιγότερο καλά μελετημένο από ό,τι αρχικά αναμενόταν. Ενώ η παραπλανητικά απλή περιγραφή υποδηλώνει έναν απλό τρόπο για την απάντησή του, είναι NP-Complete δύσκολο, πιο συγκεκριμένα στην οικογένεια MaxSNP των προβλημάτων βελτιστοποίησης. Ως άμεσο αποτέλεσμα επιχειρούνται μόνο προσεγγιστικές λύσεις. Ο [@guy] αναζητά ακριβείς λύσεις αξιοποιώντας επιλυτές SAT, αλλά καταφέρνει να το κάνει να λειτουργήσει μόνο για πολύ μικρά μεγέθη πινάκων μέχρι 8 x 8. Δεν βρέθηκαν πολλά άλλα για το ακριβές σενάριο παραπάνω, αλλά ένα αρκετά κοντινό πρόβλημα που έχει να κάνει με την παραγοντοποίηση παρόμοιων λιστών εκφράσεων της μορφής $y_i = x_0 \oplus x_1 \oplus ... \oplus x_n$ με τη χρήση των ελάχιστων δυνατών πράξεων XOR εξετάζεται ενεργά χάρη σε ορισμένες εφαρμογές στον τομέα των κρυπτογραφικών επιταχυντών. Και τα δύο ανήκουν στην οικογένεια προβλημάτων συντομότερου γραμμικού προγράμματος.

Επιλέγω να δοκιμάσω να χρησιμοποιήσω πρώτα τον αλγόριθμο παραγοντοποίησης του Paar [@paar]. Είναι παλαιότερος από τις περισσότερες ευρετικές μεθόδους που έχουν εφαρμοστεί στο πρόβλημα της παραγοντοποίησης XOR, αλλά έχει το πλεονέκτημα ότι δεν εκμεταλλεύεται την ακύρωση όρων. Χάρη στην ιδιότητα $x \oplus x = 0$ ορισμένες βέλτιστες λύσεις στο πρόβλημα XOR περιλαμβάνουν δύο υποεκφράσεις που περιέχουν τον ίδιο όρο $x$ και συνδυάζονται με XOR για να παράγουν μια επιθυμητή έκφραση που δεν περιλαμβάνει τον όρο $x$. Οι ευρετικές μέθοδοι που αναπτύχθηκαν μετά τον Paar εκμεταλλεύονται αυτό το χαρακτηριστικό, και ενώ υπάρχει ένας παραλληλισμός μεταξύ αυτού και της ακύρωσης των όρων των αντιθέτων στο σενάριό μας ($x - x = 0$ ή $x + -x = 0$) δεν έχω καταφέρει να βρω τις προσαρμογές που απαιτούνται για να εφαρμόσω τις ιδέες τους στο νέο πεδίο. Έτσι, δίνω προτεραιότητα στην πιο απλή μέθοδο, που μεταφράζεται άμεσα στη χρήση της πρόσθεσης στη θέση της ισοτιμίας.

Δοκιμάζω επίσης μια μικρή τροποποίηση της αρχικής διαδικασίας ώστε να είναι άμεσα συμβατή με εκφράσεις που περιλαμβάνουν αφαιρέσεις.

\newpage

#### Αποτελέσματα και ανάλυση

| | bnnparsign area(cm²) | bnnpaar area(cm²) | area change | bnnparsign power(mW) | bnnpaar power(mW) | power change |
|:---|---:|---:|:---|---:|---:|:---|
| Har | 24.52 | 17.42 | -29.0% | 78.8 | 57.2 | -27.4% |
| cardio | 33.27 | 38.74 | +16.4% | 106.2 | 124.1 | +16.9% |
| gasId | 175.09 | 281.55 | +60.8% | 499.1 | 807.6 | +61.8% |
| pendigits | 33.38 | 35.43 | +6.1% | 108.9 | 114.6 | +5.2% |
| winered | 22.45 | 18.55 | -17.4% | 74.6 | 62.6 | -16.1% |
| winewhite | 20.47 | 18.01 | -12.0% | 68 | 59.8 | -12.1% |

Table: Επίδραση της προκαταβολικής αριθμητικής βελτιστοποίησης με την ευρετική του Paar

| | bnnpaar area(cm²) | bnnpaarter area(cm²) | area change | bnnpaar power(mW) | bnnpaarter power(mW) | power change |
|:---|---:|---:|:---|---:|---:|:---|
| Har | 17.42 | 18.73 | +7.5% | 57.2 | 60.8 | +6.3% |
| cardio | 38.74 | 35.97 | -7.2% | 124.1 | 116 | -6.5% |
| gasId | 281.55 | 261.38 | -7.2% | 807.6 | 759.7 | -5.9% |
| pendigits | 35.43 | 32.22 | -9.1% | 114.6 | 107.3 | -6.4% |
| winered | 18.55 | 17.47 | -5.8% | 62.6 | 59.6 | -4.8% |
| winewhite | 18.01 | 16.65 | -7.6% | 59.8 | 55.9 | -6.5% |

Table: Σύγκριση του τροποποιημένου ευρετικού συστήματος Paar με το αρχικό

Επίδραση της προκαταβολικής αριθμητικής βελτιστοποίησης με την ευρετική του Paar

Σύγκριση της τροποποιημένης ευρετικής του Paar με την αρχική

Περίμενα ότι είτε:

1. Τα αποτελέσματα της σκληρής αντιστοίχισης της σειράς των πράξεων για τον υπολογισμό του αποτελέσματος της προ-ενεργοποίησης των νευρώνων με τη χρήση της ευρετικής του Paar θα είναι σημαντικά χειρότερα από το αποτέλεσμα που θα είχαμε αν αφήναμε τον Design Compiler να χρησιμοποιήσει τα αποτελέσματα της δικής του ευρετικής βελτιστοποίησης, αφού θα έπρεπε να εφαρμόζει τις καλύτερες διαθέσιμες. Σε αυτή την περίπτωση η προσπάθεια μιας εναλλακτικής λύσης για την εκ των προτέρων βελτιστοποίηση των λειτουργιών είναι πιθανότατα σπατάλη κόπου, επειδή η εύρεση μιας ανταγωνιστικής ευρετικής θα ήταν δυσκολότερη από την ανάλυση των αποτελεσμάτων της δικής τους λύσης.

2. Τα αποτελέσματα θα είχαν αμελητέα διαφορά, επειδή οι ευριστικές που χρησιμοποιούνται είναι συναφείς και/ή η ποιότητα των αποτελεσμάτων που μπορεί να αναμένεται από τις τρέχουσες μεθόδους για λογικούς προϋπολογισμούς compute χτυπά ένα ορισμένο ανώτατο όριο για τις διάφορες προσεγγίσεις. Στην περίπτωση αυτή η εφαρμογή τεχνικών προσέγγισης στο εκτιμώμενο γράφημα αριθμητικών πράξεων μπορεί να προχωρήσει.

Τα αποτελέσματα δείχνουν ότι, αν και δεν είναι συνεπής σε όλα τα δίκτυα, υπάρχει βελτίωση της τάξης του 20-30% στις εκτιμήσεις εμβαδού και ισχύος των μικρότερων δικτύων. 

Δυστυχώς, το ζήτημα που προσπαθώ να αντιμετωπίσω έχει να κάνει με τις απώλειες απόδοσης από τη διακοπή των αριθμητικών βελτιστοποιήσεων του μεταγλωττιστή που κλιμακώνονται με το μέγεθος του μοντέλου, και η σχετική απόδοση της εναλλακτικής ευρετικής κλιμακώνεται αντιστρόφως ανάλογα με το μέγεθος αυτό. Αυτό σημαίνει ότι η επιχειρούμενη διόρθωση δεν μπορεί να εφαρμοστεί στις περιπτώσεις που τη χρειάζονται περισσότερο, οπότε το υποκείμενο πρόβλημα παραμένει άλυτο.

Η τριαδική εκδοχή της ευρετικής του Paar υπερέχει της αρχικής με σχετικά σταθερή αναλογία, με εξαίρεση το δίκτυο του μοντέλου Har. Αυτό μου δίνει κάποια ελπίδα ότι η εφαρμογή πιο προηγμένων ευρετικών που χρησιμοποιούνται στα συντομότερα γραμμικά προγράμματα τροποποιημένα για τη συγκεκριμένη περίπτωση χρήσης θα αυξήσει το όριο μεγέθους του δικτύου για το οποίο μπορούν να βελτιωθούν τα αποτελέσματα.

\newpage

# Ακολουθιακή εκτέλεση
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
