cyberseihis/bnnprint/write/elad.pdf

## Contents

1 Περίληψη | 3
2 Εισαγωγή | 4
3 Σχετικές εργασίες στη μηχανική μάθηση για τυπωμένα κυκλώματα | 17
4 Πληροφοριακό υπόβαθρο - Προαπαιτούμενα | 20
5 Προτεινόμενο σύστημα | 29
6 Πλήρως συνδυαστικές πλήρως συνδεδεμένες υλοποιήσεις | 34
7 Ακολουθιακή εκτέλεση | 54
8 Δίκτυα τριαδικού βάρους | 65
9 Αποτελέσματα | 70

1

9.3 Συγκριτική ανάλυση: Cross-Layer Approximation For Printed Ma-

10 Συμπεράσματα | 76
11 Παράρτημα: Αγγλική μετάφραση | 77
Βιβλιογραφία | 175

2

## 1 Περίληψη
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
