cyberseihis/bnnprint/stats/scrot_023.png

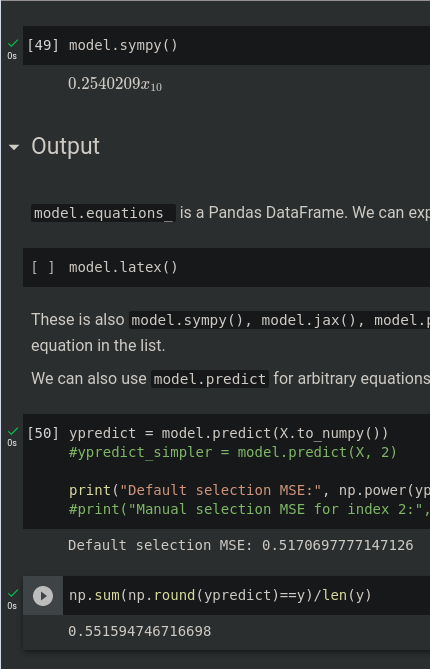
stats/scrot_023.png
