cyberseihis/bnnprint/write/masterplan.png

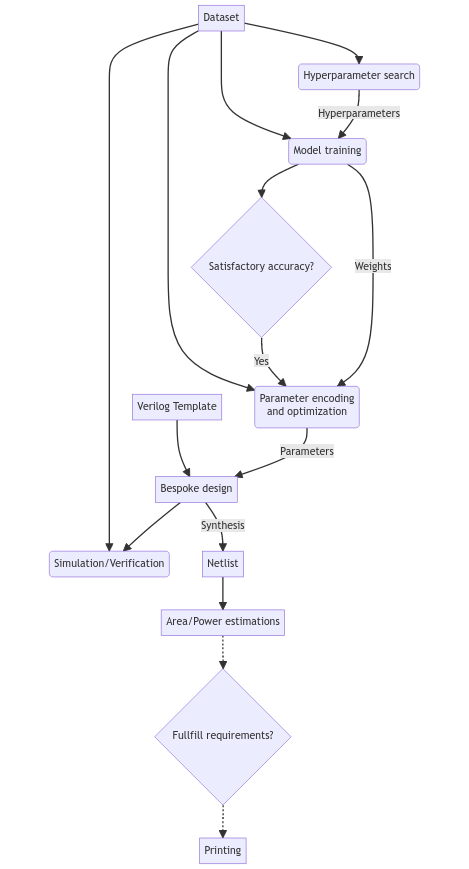
write/masterplan.png
