cyberseihis/bnnprint/write/pics/extraction_report_og.png

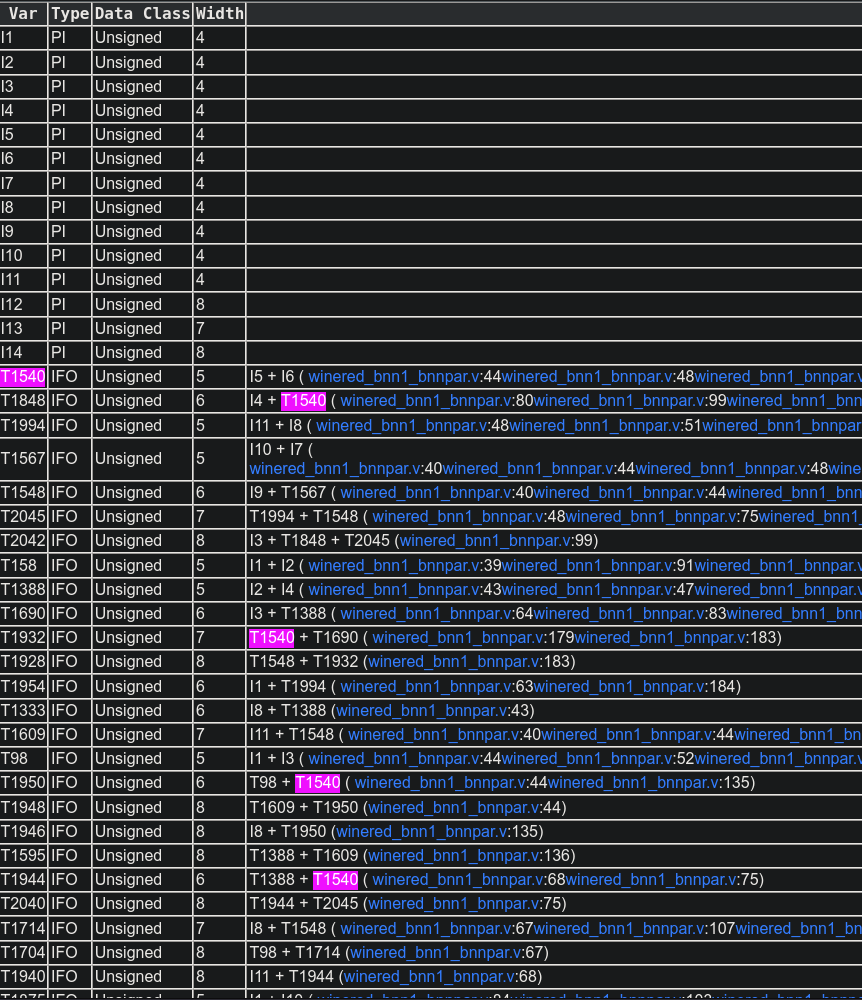
write/pics/extraction_report_og.png
