cyberseihis/bnnprint/write/pics/p.jpeg

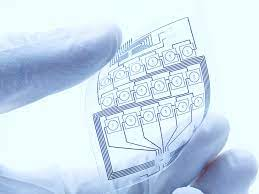
write/pics/p.jpeg
