cyberseihis/bnnprint/write/pics/tenor-2666883609.gif

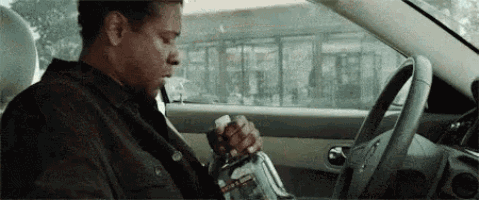
write/pics/tenor-2666883609.gif
