cyberseihis/bnnprint/write/tikz1/bnndsat.png

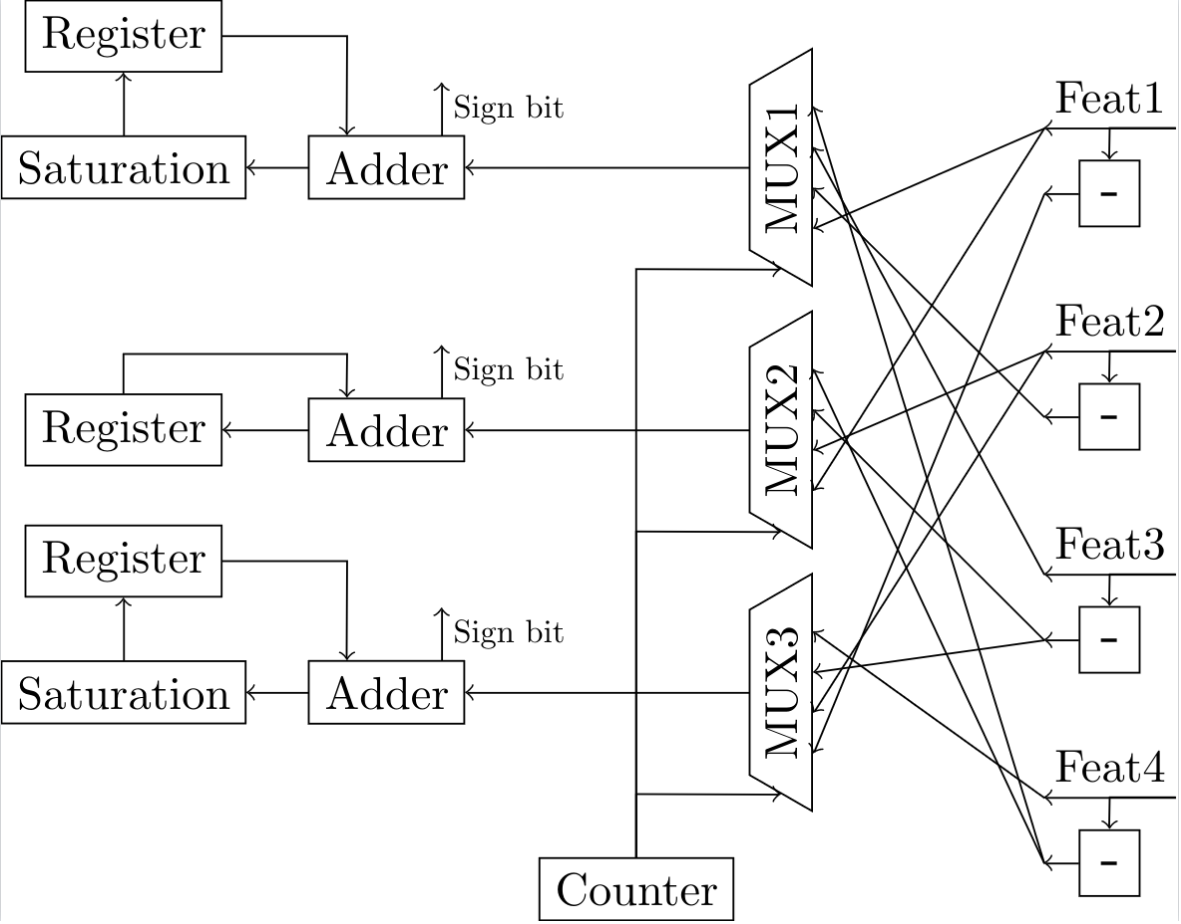
write/tikz1/bnndsat.png
