cyberseihis/bnnprint/write/tikz1/bnnparce.png

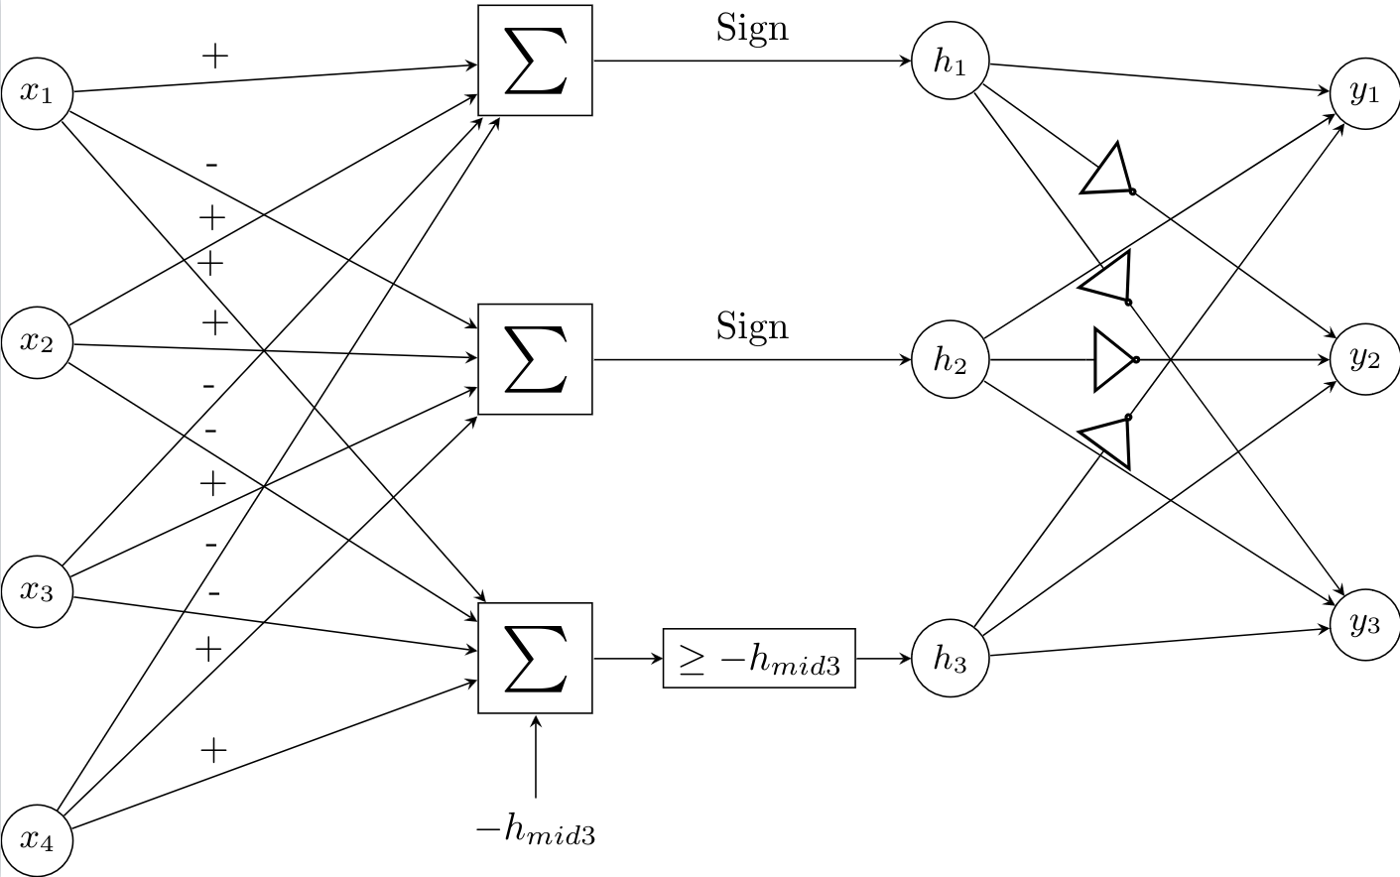
write/tikz1/bnnparce.png
