cyberseihis/bnnprint/write/tikz1/bnnrobus.png

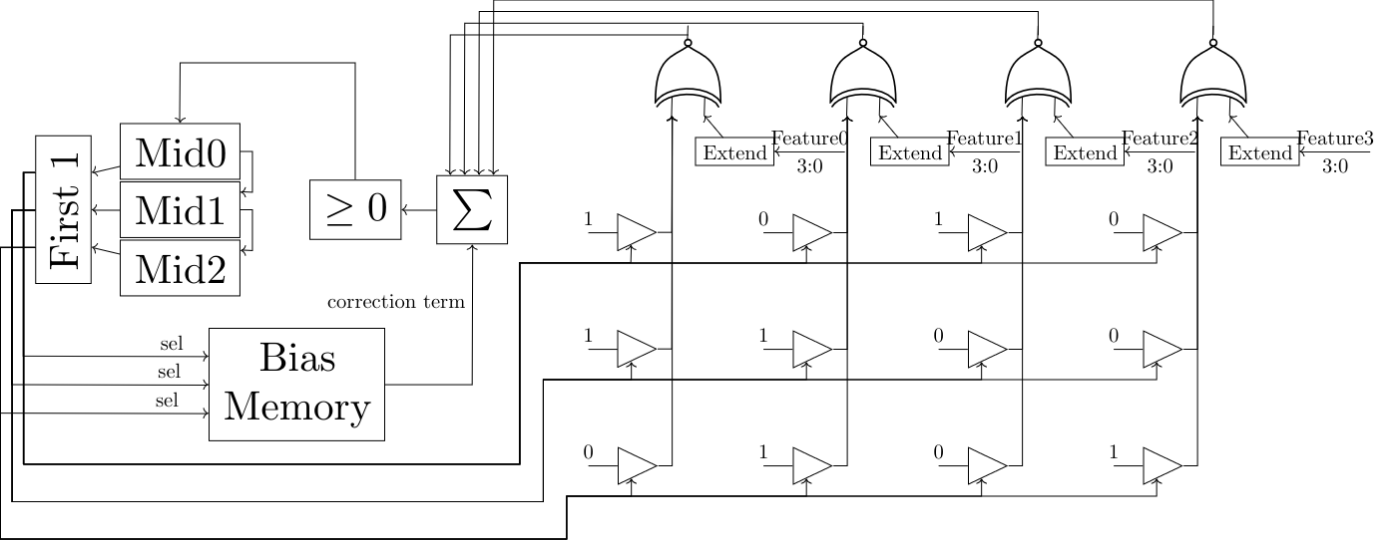
write/tikz1/bnnrobus.png
