cyberseihis/bnnprint/write/tikz1/bnnrolx.png

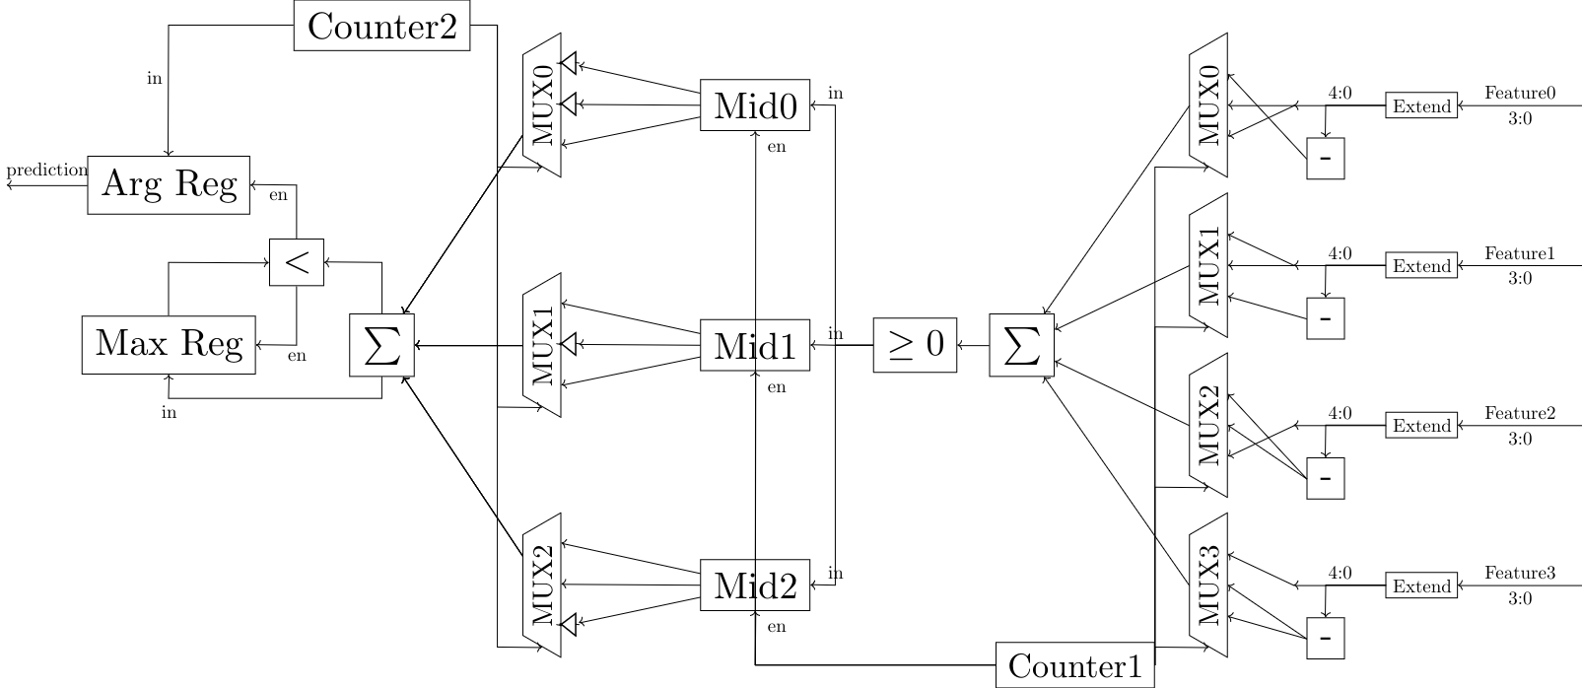
write/tikz1/bnnrolx.png
