cyberseihis/bnnprint/results_bnn.csv

cardio_bnn1_bnndirect | 3049513878 | 0.1508
cardio_bnn1_bnndsatin | 2810682089 | 0.1303
cardio_bnn1_bnndsat | 2476688256 | 0.1187
cardio_bnn1_bnndw | 2625544276 | 0.1249
cardio_bnn1_bnnpaar | 3873514668 | 0.1241
cardio_bnn1_bnnpaarter | 3596909349 | 0.1160
cardio_bnn1_bnnpaarx | 3878707190 | 0.1244
cardio_bnn1_bnnparce | 3484390096 | 0.1105
cardio_bnn1_bnnparpnw | 4581533966 | 0.1428
cardio_bnn1_bnnparser | 3321122892 | 0.1054
cardio_bnn1_bnnparsign | 3327450493 | 0.1062
cardio_bnn1_bnnparstepw | 3928792766 | 0.1255
cardio_bnn1_bnnpar | 4671425747 | 0.1453
cardio_bnn1_bnnparw | 3321122892 | 0.1054
cardio_bnn1_bnnrobus | 1244282486 | 0.0294
cardio_bnn1_bnnroclk | 978063287 | 0.0406
cardio_bnn1_bnnrolin | 1085099120 | 0.0456
cardio_bnn1_bnnroll | 1118415523 | 0.0469
cardio_bnn1_bnnrolx | 1109597201 | 0.0455
cardio_bnn1_bnnromem | 973538254 | 0.0408
cardio_bnn1_bnnromesh | 967400533 | 0.0401
cardio_bnn1_bnnromesx | 1002634724 | 0.0420
cardio_bnn1_bnnromex | 975525744 | 0.0409
cardio_bnn1_bnnroperm | 956446441 | 0.0391
cardio_bnn1_bnnrospine | 930476830 | 0.0360
cardio_bnn1_bnnrospinor | 934543087 | 0.0362
cardio_bnn1_bnnseq | 3146979597 | 0.1431
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
