cyberseihis/bnnprint/stats/020523_results.csv

cardio_bnn1_bnndirect | 3049513878 | 0.1466
cardio_bnn1_bnndw | 2625544276 | 0.1233
cardio_bnn1_bnnparce | 3484390096 | 0.1055
cardio_bnn1_bnnpar | 4671425747 | 0.1391
cardio_bnn1_bnnparw | 3321122892 | 0.1005
cardio_bnn1_bnnseq | 3146979597 | 0.1478
cardio_bnn1_bnnshift | 5531257884 | 0.3301
cardio_tnn1_tnndirect | 2463121709 | 0.1144
cardio_tnn1_tnnpar | 2055376041 | 0.0630
cardio_tnn1_tnnparw | 1985239062 | 0.0608
cardio_tnn1_tnnseq | 2174284639 | 0.1075
cardio_tnn1_tnnzeq | 2215862084 | 0.1091
gasId_bnn1_bnndirect | 8862217257 | 0.3367
gasId_bnn1_bnndw | 8186903514 | 0.3049
gasId_bnn1_bnnparce | 18182298639 | 0.5046
gasId_bnn1_bnnpar | 26976191700 | 0.7530
gasId_bnn1_bnnparw | 17136617736 | 0.4771
gasId_bnn1_bnnseq | 4767284030 | 0.1925
gasId_bnn1_bnnshift | 22800739482 | 1.1411
gasId_tnn1_tnndirect | 6185239249 | 0.2122
gasId_tnn1_tnnpar | 11098521145 | 0.3183
gasId_tnn1_tnnparw | 10141936825 | 0.2878
gasId_tnn1_tnnseq | 3559700432 | 0.1484
gasId_tnn1_tnnzeq | 6056292666 | 0.2222
Har_bnn1_bnndirect | 2763413176 | 0.1145
Har_bnn1_bnndw | 2538763759 | 0.1041
Har_bnn1_bnnparce | 2499410773 | 0.0760
Har_bnn1_bnnpar | 2939539015 | 0.0890
Har_bnn1_bnnparw | 2425075600 | 0.0748
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
