cyberseihis/bnnprint/stats/040523_results.csv

cardio_bnn1_bnndirect | 3049513878 | 0.1508
cardio_bnn1_bnndw | 2625544276 | 0.1249
cardio_bnn1_bnnparce | 3484390096 | 0.1105
cardio_bnn1_bnnpar | 4671425747 | 0.1453
cardio_bnn1_bnnparw | 3321122892 | 0.1054
cardio_bnn1_bnnrolin | 1085099120 | 0.0456
cardio_bnn1_bnnroll | 1118415523 | 0.0469
cardio_bnn1_bnnrolx | 1109597201 | 0.0455
cardio_bnn1_bnnseq | 3146979597 | 0.1431
cardio_tnn1_tnndirect | 2463121709 | 0.1183
cardio_tnn1_tnnpar | 2055376041 | 0.0663
cardio_tnn1_tnnparw | 1985239062 | 0.0639
cardio_tnn1_tnnseq | 2174284639 | 0.1014
cardio_tnn1_tnnzeq | 2215862084 | 0.1059
cardio_tnn1_tnnzew | 1806439318 | 0.0834
gasId_bnn1_bnndirect | 8862217257 | 0.3645
gasId_bnn1_bnndw | 8186903514 | 0.3256
gasId_bnn1_bnnparce | 18182298639 | 0.5161
gasId_bnn1_bnnpar | 26976191700 | 0.7677
gasId_bnn1_bnnparw | 17136617736 | 0.4869
gasId_bnn1_bnnrolin | 3854120055 | 0.1313
gasId_bnn1_bnnroll | 4296589691 | 0.1435
gasId_bnn1_bnnrolx | 4212096283 | 0.1424
gasId_bnn1_bnnseq | 4767284030 | 0.2168
gasId_tnn1_tnndirect | 6185239249 | 0.2305
gasId_tnn1_tnnpar | 11098521145 | 0.3254
gasId_tnn1_tnnparw | 10141936825 | 0.2946
gasId_tnn1_tnnseq | 3559700432 | 0.1582
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
