cyberseihis/bnnprint/stats/100523_results.csv

cardio_bnn1_bnndirect | 3049513878 | 0.1508
cardio_bnn1_bnndsatin | 2810682089 | 0.1303
cardio_bnn1_bnndsat | 2476688256 | 0.1187
cardio_bnn1_bnndw | 2625544276 | 0.1249
cardio_bnn1_bnnparce | 3484390096 | 0.1105
cardio_bnn1_bnnparpnw | 4581533966 | 0.1428
cardio_bnn1_bnnparstepw | 3928792766 | 0.1255
cardio_bnn1_bnnpar | 4671425747 | 0.1453
cardio_bnn1_bnnparw | 3321122892 | 0.1054
cardio_bnn1_bnnroclk | 978063287 | 0.0406
cardio_bnn1_bnnrolin | 1085099120 | 0.0456
cardio_bnn1_bnnroll | 1118415523 | 0.0469
cardio_bnn1_bnnrolx | 1109597201 | 0.0455
cardio_bnn1_bnnromem | 973538254 | 0.0408
cardio_bnn1_bnnromesh | 967400533 | 0.0401
cardio_bnn1_bnnromesx | 1002634724 | 0.0420
cardio_bnn1_bnnromex | 975525744 | 0.0409
cardio_bnn1_bnnroperm | 956446441 | 0.0391
cardio_bnn1_bnnseq | 3146979597 | 0.1431
cardio_tnn1_tnndirect | 2463121709 | 0.1183
cardio_tnn1_tnnpar | 2055376041 | 0.0663
cardio_tnn1_tnnparw | 1985239062 | 0.0639
cardio_tnn1_tnnseq | 2174284639 | 0.1014
cardio_tnn1_tnnzeq | 2215862084 | 0.1059
cardio_tnn1_tnnzew | 1806439318 | 0.0834
gasId_bnn1_bnndirect | 8862217257 | 0.3645
gasId_bnn1_bnndsatin | 7747969288 | 0.3076
gasId_bnn1_bnndsat | 8104696944 | 0.3189
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
