cyberseihis/bnnprint/write/tikz2/bnndirect.pdf

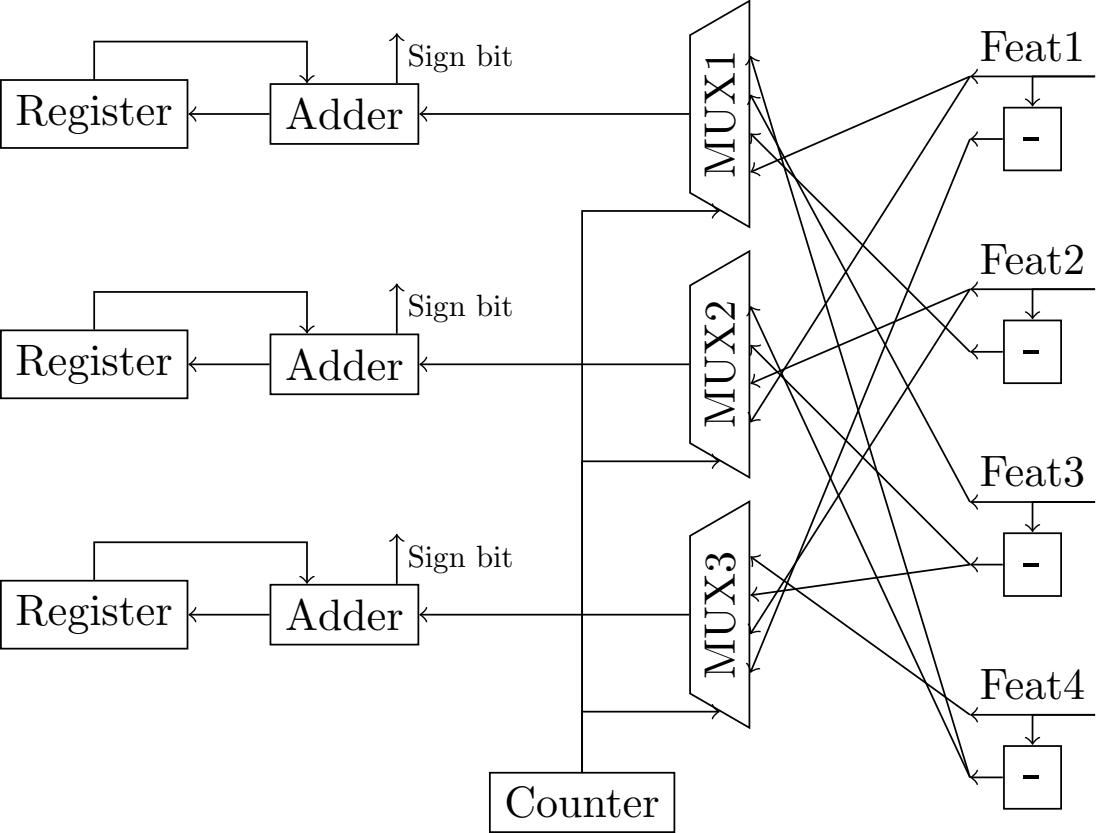
[picture p130: page 1]
Counter; Feat1 -; Feat2 -; Feat3 -; Feat4 -; Register; Adder; Sign bit; MUX1; MUX2; MUX3
