cyberseihis/bnnprint/write/tikz2/bnndsat.pdf

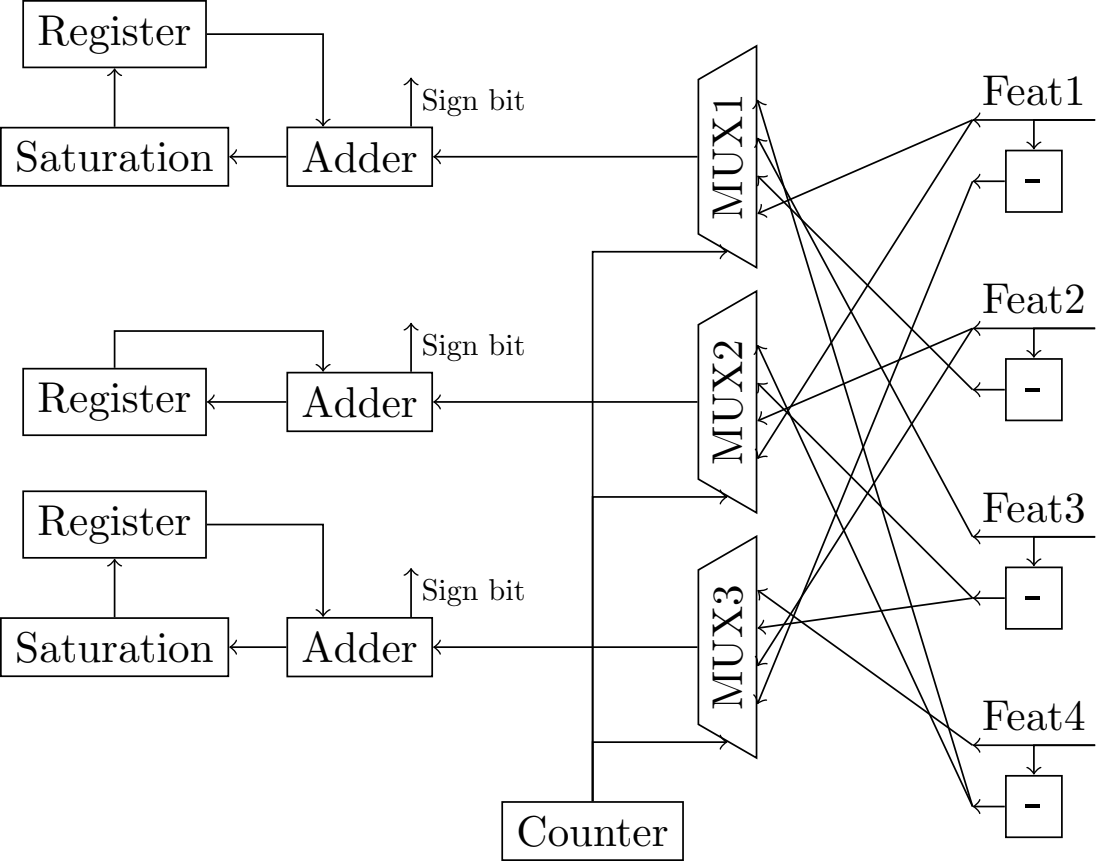
[picture p131: page 1]
Counter; Feat1 -; Feat2 -; Feat3 -; Feat4 -; Adder; Register; Saturation; Sign bit; MUX1; MUX2; MUX3
