cyberseihis/bnnprint/write/tikz2/bnnpaar.pdf

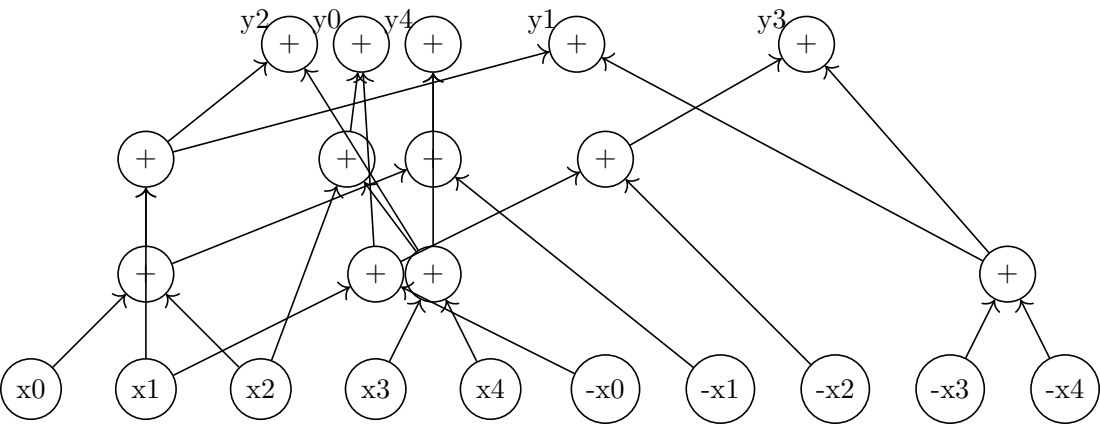
[picture p132: page 1]
