cyberseihis/bnnprint/write/tikz2/bnnpar.pdf

P
+

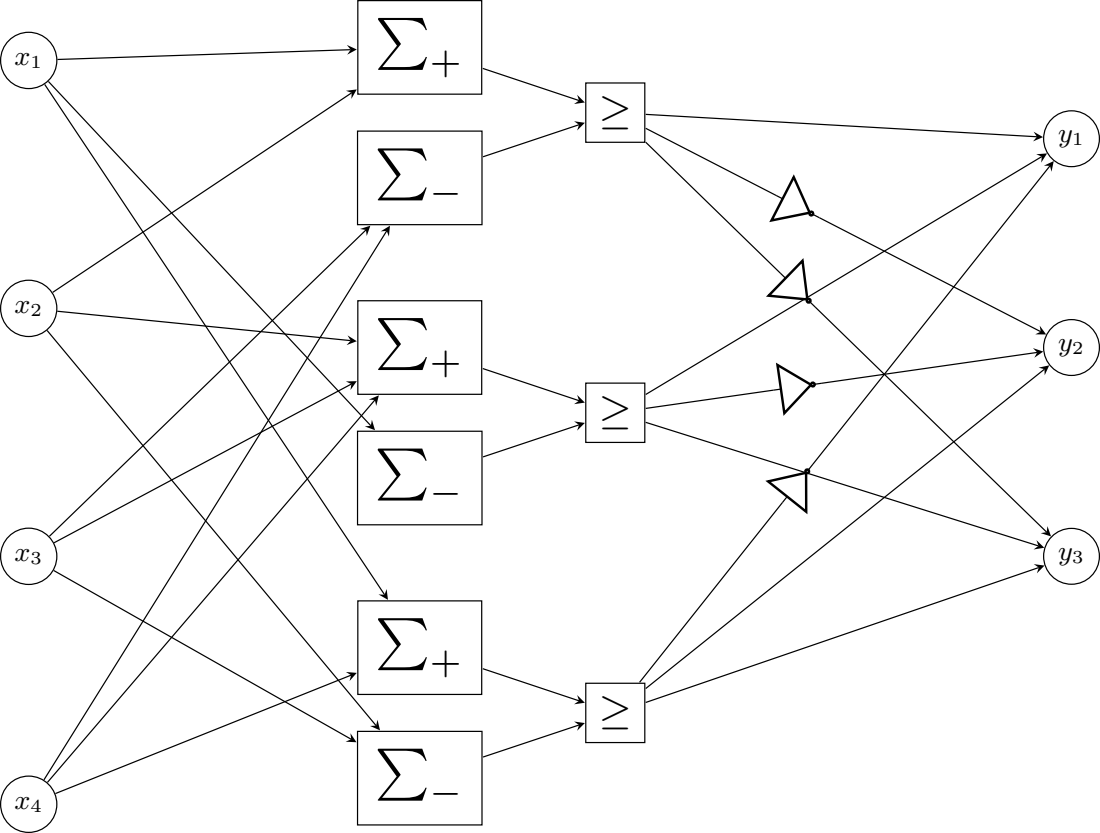
[picture p133: page 1]
