cyberseihis/bnnprint/write/tikz2/bnnparce.pdf

P

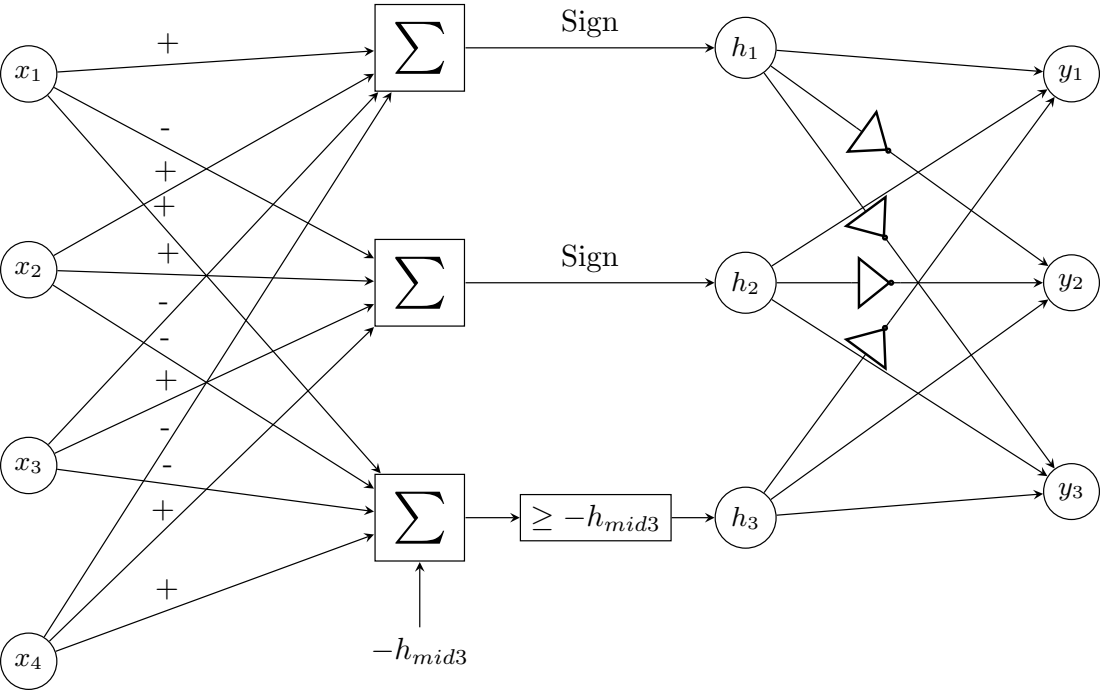
[picture p134: page 1]
Sign; hmid
