cyberseihis/bnnprint/write/tikz2/bnnparsign.pdf

P

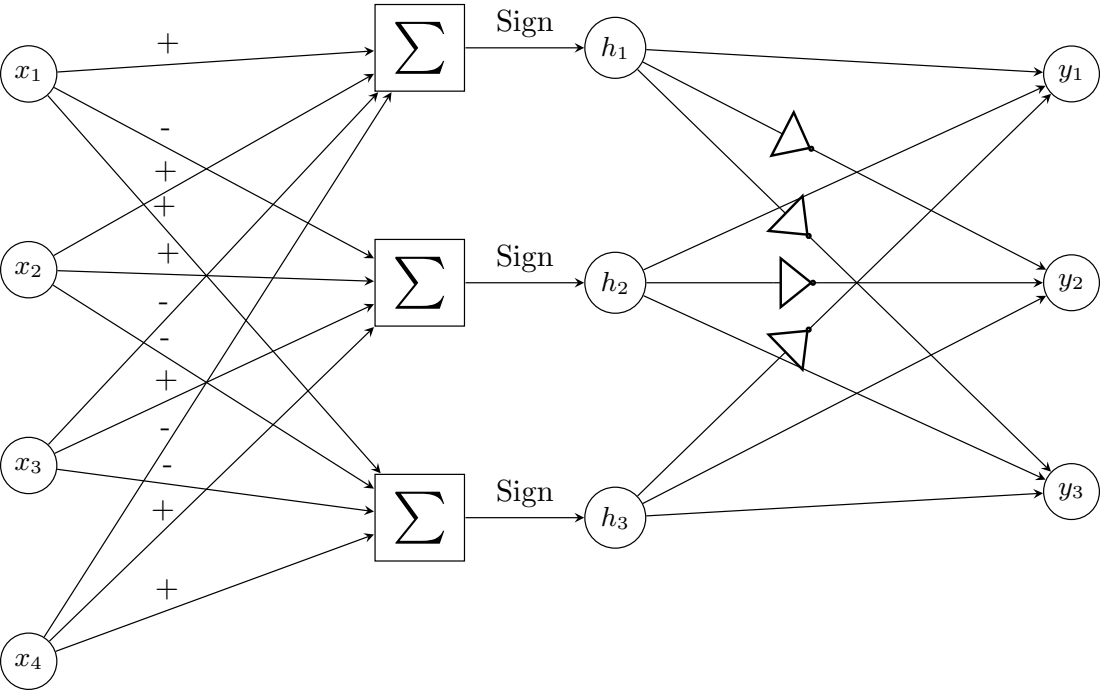
[picture p135: page 1]
Sign
