cyberseihis/bnnprint/write/tikz2/bnnrobus.pdf

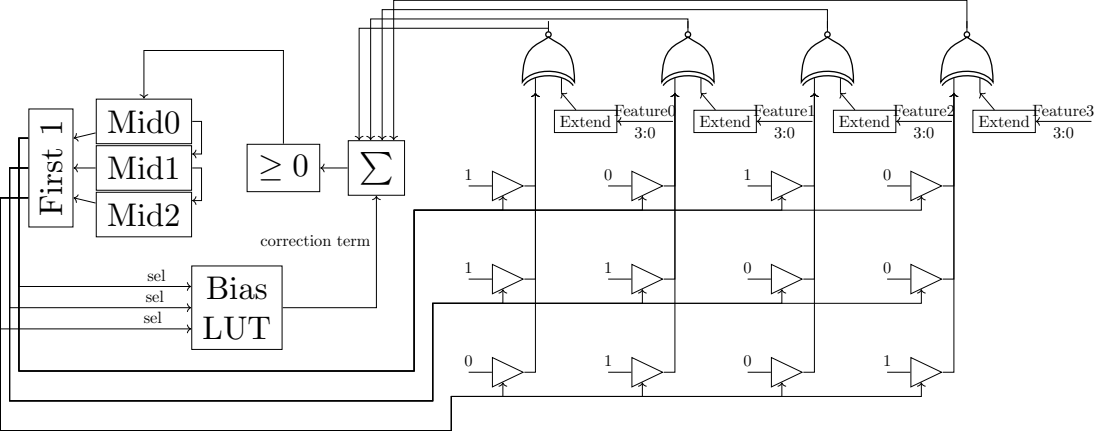
[picture p136: page 1]
Bias LUT; correction term; Extend; Feature0; Feature1; Feature2; Feature3 3:0; First 1; Mid0; sel; Mid1; Mid2
