cyberseihis/bnnprint/write/tikz2/bnnrolx.pdf

# Counter2

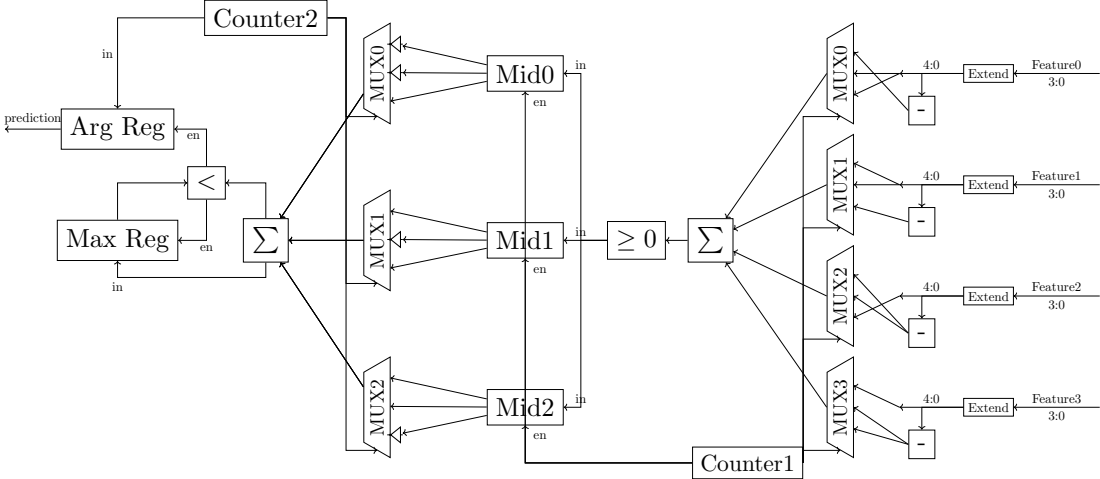
[picture p137: page 1]
Counter1; Extend; Feature0 3:0; MUX0; Feature1 3:0; MUX1; Feature2 3:0; MUX2; Feature3 3:0; MUX3; Mid0; Mid1; Mid2; Max Reg; Arg Reg; prediction
