cyberseihis/bnnprint/write/tikz2/bnnromem.pdf

# Counter2

# Mid0 in

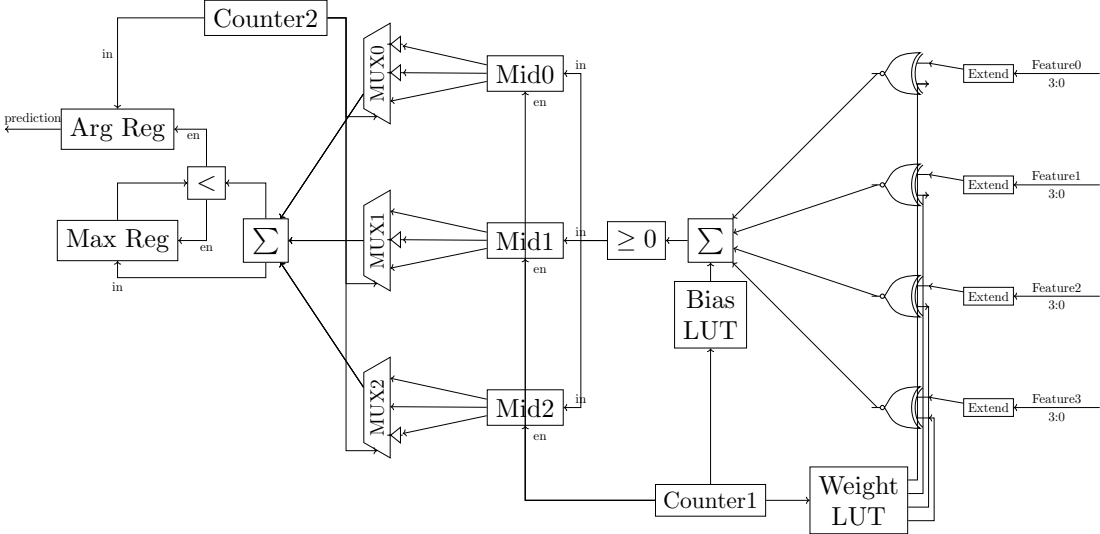
[picture p138: page 1]
Counter1; Weight; LUT; Extend; Feature0 3:0; Feature1 3:0; Feature2 3:0; Feature3 3:0; MUX0; Mid1; MUX1; Mid2; MUX2; Max Reg; Arg Reg; prediction; Bias LUT
