cyberseihis/bnnprint/write/tikz2/bnnseq2.pdf

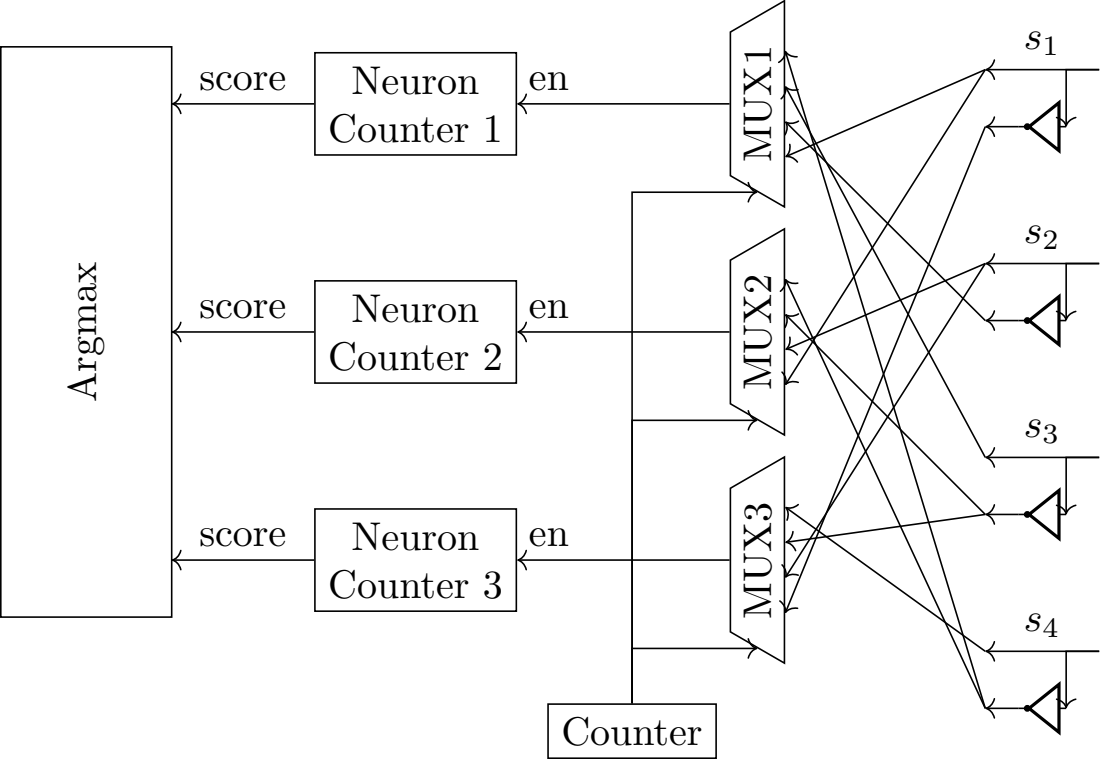
[picture p139: page 1]
Counter; Neuron Counter 1; MUX1; Neuron Counter 2; MUX2; Neuron Counter 3; MUX3; Argmax; score
