cyberseihis/bnnprint/write/tikz2/tnnparsign.pdf

P

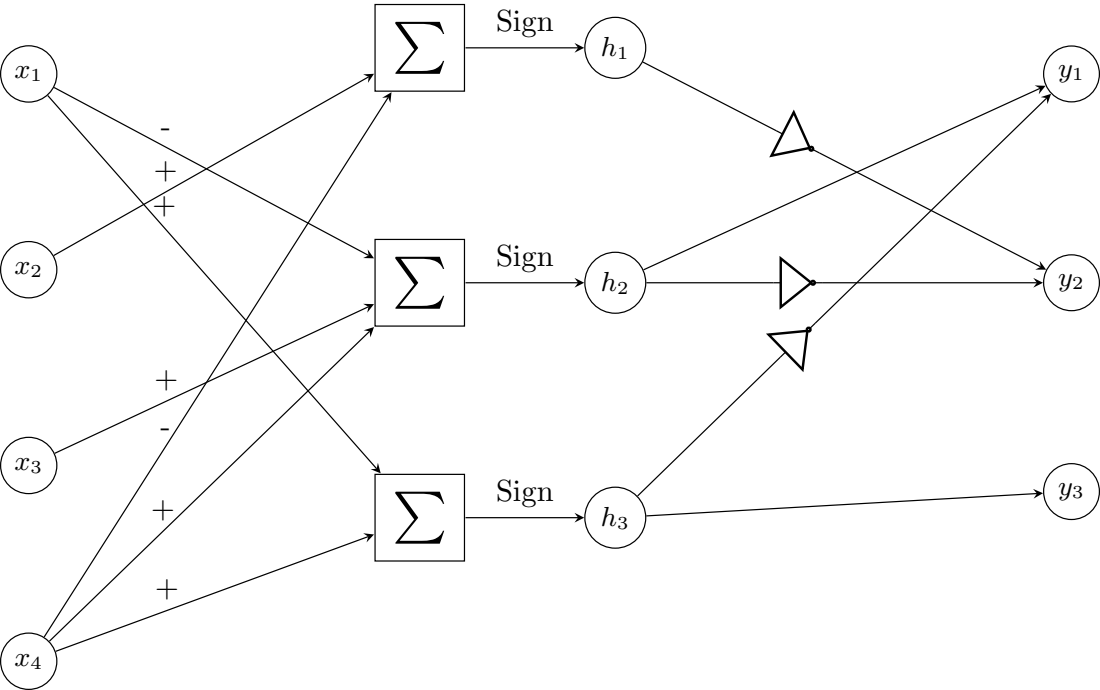
[picture p140: page 1]
Sign
