cyberseihis/bnnprint/designs/seq/components/seqlego.v

module seqlego #(
  parameter FEAT_CNT = 4,
  parameter FEAT_BITS = 4,
  parameter HIDDEN_CNT = 4,
  parameter CLASS_CNT = 4,
  parameter Weights0 = 0,
  parameter Weights1 = 0
  ) (
  input clk,
  input rst,
  input [FEAT_CNT*FEAT_BITS-1:0] features,
  output [$clog2(CLASS_CNT)-1:0] prediction
  );
  
  localparam SUM_BITS = $clog2(HIDDEN_CNT+1);
  wire [HIDDEN_CNT-1:0] hidden;
  wire next_layer;
  wire [SUM_BITS*CLASS_CNT-1:0] scores;

  seqq #(.FEAT_CNT(FEAT_CNT),.FEAT_BITS(FEAT_BITS),.HIDDEN_CNT(HIDDEN_CNT),.Weights(Weights0)) layer1 (
    .clk(clk),
    .rst(rst),
    .features(features),
    .hidden(hidden),
    .done(next_layer)
  );

 xnorseqq #(.HIDDEN_CNT(HIDDEN_CNT),.CLASS_CNT(CLASS_CNT),.Weights(Weights1)) layer2 (
    .clk(clk),
    .rst(rst),
    .enable(next_layer),
    .features(hidden),
    .scores(scores)
 );
  
  argmax #(.SIZE(CLASS_CNT),.I($clog2(CLASS_CNT)),.K(SUM_BITS)) result (
     .inx(scores),
     .outimax(prediction)
  );

endmodule
