cyberseihis/bnnprint/designs/bnnpaarter/products/gasId_bnn1_bnnpaarter.v

module gasId_bnn1_bnnpaarter #(

parameter FEAT_CNT = 128,
parameter HIDDEN_CNT = 40,
parameter FEAT_BITS = 4,
parameter CLASS_CNT = 6,
parameter TEST_CNT = 1000


)(
    input [FEAT_CNT*FEAT_BITS-1:0] features,
    output [$clog2(CLASS_CNT)-1:0] prediction
);

localparam PAAR0 = 59712'h04ef05330001050e05320001051b0531000104d9053000010473052f00010509052e00010510052d00010503052c00010504052b000104db052a000105050529000104ff05280001050205270001050a0526000104ba0525000104ea0524000104f60523000105120522000104fe0521000104c505200001050d051f000104c6051e000104cf051d000104f1051c00010506051a0001046e0519000104f80518000104f90517000104f70516000104e40515000105010514000104fc05130001050f0511000104fb050c00010508050b000104ce0507000104fa0500000104ee04fd000104f204f5000104f304f4000104ac04f0000004ca04ed000004a404ec000004b104eb000004ae04e9000004a604e8000004b504e7000004a204e6000004be04e5000004ad04e3000004ab04e2000004bb04e10000049d04e00000048c04df000004aa04de0000047b04dd0000048404dc0000047504da0000048b04d80000047f04d70000048004d6000004a004d50000049e04d4000004a304d30000048e04d20000048304d10000048f04d00000047604cd0000049304cc0000049c04cb000004af04c90000046d04c80000049504c70000046504c40000047804c30000047004c20000044f04c10000045204c00000046204bf0000046104bd0000043d04bc0000045a04b90000045f04b80000045b04b70000048604b60000041f04b40000043304b30000043f04b20000046004b00000042004a90000042b04a80000042304a70000047904a50000044104a100000485049f00000443049b0000046a049a0000046f04990000048804980000043e04970000041c04960000044804940000042c0492000004070491000003f3049000000428048d000003df048a0000041704890000044a048700000414048200000471048100000446047e00000457047d000003cb047c00000437047a00000451047700000430047400000427047200000449046c000003b6046b0000043504690000041a04680000043c04670000042d0466000004310464000003ff0463000003f9045e0000041b045d00000379045c000003ab04590000041e04580000040a0456000003b00455000003dc045400000432045300000419045000000415044e0000040e044d000003d0044c000003f4044b000004050447000003be0445000003ce0444000004110442000004100440000003d7043b0000042a043a000003e80439000004020438000003c2043600000354043400000412042f000003f0042e000003ca0429000003ec0426000003970425000003e604240000038d04220000039c0421000003ed041d000003fa0418000003480416000003b5041300000367040f000003ac040d000003c5040c000003da040b0000035b04090000033004080000038f0406000003cd0404000003b10403000003860401000003de0400000003cc03fe000003db03fd000003bb03fc000003ae03fb0000039903f8000003bc03f7000003c103f6000003e303f5000003d503f2000003d203f10000038e03ef000003c703ee000003bd03eb000003c803ea000003d603e90000038903e7000003a703e50000034e03e40000037703e2000003a303e1000003b803e0000003c003dd0000036203d90000036d03d80000034303d4000003a103d30000037e03d10000037103cf0000030103c90000037203c60000037f03c40000036003c30000036a03bf0000038303ba0000039a03b9000002b503b70000032b03b40000031703b30000039403b20000039e03af0000033603ad0000037b03aa0000036c03a90000030a03a80000039203a60000037a03a50000036803a40000037603a20000038403a0000002de039f0000037c039d0000033a039b000002f103980000032503960000038003950000035903930000035f0391000003700390000002dd038c00000334038b0000034a038a000003190388000003200387000002f603850000035e038200000361038100000347037d000002ea03780000036f03750000030003740000034903730000031a036e00000329036b0000033803690000031f03660000034f0365000002ef0364000002d00363000002e3035d00000323035c000002e5035a000002e803580000032d0357000002fb0356000003120355000003260353000002e40352000002d40351000002af035000000316034d0000030d034c0000030e034b0000030c0346000003070345000003020344000002fa0342000002ce034100000278034000000327033f000002d2033e00000306033d000002e7033c00000313033b000002fe0339000003090337000002ed0335000002bd0333000002e60332000003220331000002fc032f0000031e032e0000030f032c000002ee032a000003150328000002eb0324000003080321000002c4031d000002c2031c000002a6031b000002520318000002ba0314000002620311000002e00310000002f7030b000002d50305000002f20304000002ec0303000002c702ff0000027f02fd0000028402f9000002c802f8000002bc02f50000027e02f40000025502f3000002ac02f0000002d302e90000026c02e20000028102e1000002c502df000002a302dc0000023a02db000002aa02da000002c902d9000001dc02d8000002cd02d7000002b802d60000027102d10000029e02cf0000027902cc000002b402cb000002ab02ca0000023202c60000029502c30000027002c10000028a02c00000028302bf0000026602be0000027a02bb0000020902b90000027702b70000026002b60000027d02b30000027102b20000027602b10000022b02b0000001cc02ae0000029902ad0000022802a9000001c002a80000029302a70000025902a50000028602a40000024602a20000027c02a10000029b02a000000289029f0000027b029d0000028f029c0000027a029a0000022e02980000028802970000022402960000027902940000028d029200000274029100000270029000000275028e00000273028c0000027c028b0000024602870000026e0285000002580282000001ea02820000022d028100000256028000000254027f0000026f027e00000263027d00000247027800000225027700000236027500000256027300000258027200000221027200000239026f00000269026e0000025e026d00000227026c00000268026b0000023e026b0000025a026a000002180269000001cd02680000023402670000022f02670000023c02660000026102650000026102640000025d02640000022d025f000001f8025e00000242025d0000024d025c00000221025c00000225025a000001fc02590000025002570000024202570000015f0255000001f902530000021e02520000024402510000023a02510000020a02500000020b024e000001ba024e00000107024d0000024a024b000001e2024b0000018b024a000001aa02490000017e02490000021d02480000021202480000023302470000021b0244000000f502410000022f0240000001fe02400000021f023f0000021e023f00000223023e000001da023c0000022b02390000022c0238000002190238000001fd0236000001ba02340000020e0233000002170232000002280231000001a8022c000001e2022a0000021a0229000002020229000001fe02270000020e0226000002000224000001ab02220000020c0220000001de021d00000196021b000001f5021a000002100218000001b102170000020602160000019c0216000001d40213000001b50213000001720212000002050211000001b70210000001db020c00000205020b000001c8020a000002060209000001db0208000001cc0208000002010202000001590201000001cd0200000001ad01fd000001d901fc000001ae01fb0000018001fb0000019e01fa0000017c01fa000001cb01f9000001e101f8000001e601f7000001d501f7000001ec01f6000001eb01f6000001d801f5000001a301f4000001cd01f0000001c701f0000001e701ef000001c201ee0000018d01ee000001b301ed000001d401ec000001e601eb0000018201ea000001e501e8000000e301e7000001e401e50000014d01e4000001cf01e1000001d801e00000010c01e0000001d201df0000017e01de0000012001da000001d201d7000001c101d7000001d101d6000001bb01d6000001b201ce000001ad01ce000001bf01cb0000019d01cb0000019a01ca0000019a01c9000001be01c7000001ae01c60000014401c5000001ba01c40000017401c3000001b001c1000001ad01bd0000017601bc0000019a01b90000019d01b80000019001b70000016001b70000017e01b60000018301b50000011f01b40000016701af0000018701ac0000019001a80000016501a80000016201a70000018501a60000019401a50000019901a20000016e01a000000139019f00000177019d0000014a019b0000018e01980000017301970000014e0197000000f901970000019201960000018101960000018901950000014201940000016f019300000155019100000183019000000137018d00000154018b0000015c01890000015b01880000014801880000013901860000017101850000013f01840000017001820000015e018100000156018000000177017f0000011f017f00000155017c00000146017a00000120017500000169017100000161017000000156016f000000fc016b00000167016a0000014a0169000000b10168000000890168000001420166000001370165000001470164000000ee0161000000e60160000000e9015d0000015a015c00000133015c0000014501580000010c0158000001530157000000c401550000013e0154000001410152000001490151000000d9014f0000012a014d00000104014c000000ab014c00000126014b000001470148000001320146000001300146000000de01430000013c014100000124013e00000120013e00000110013d00000110013b0000012801360000011d01360000011b01360000011601360000011a01350000011401350000012e0131000000ab013100000118012f00000121012b000000ff012b000001240127000000e00123000000c901230000010201220000010c011f000000dc011e00000115011b000000bd011a000001010119000000d601180000010d011700000107011400000100011400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
localparam YMAP = 1280'h000005360000053e00010538000005540000055a00010545000005460000055200010558000005420000053b000005500001053d000105430000055500000557000005390001055900000549000105340001054e000105400001054f00000537000005510000053a000005530000055b0001053f000105470001055600000541000105350001054a0000053c0000054b0001054c0000054d0000054400010548;
localparam ADDCNT = $bits(PAAR0) / 48;
localparam FULLCNT = ADDCNT + FEAT_CNT;
localparam Weights1 = 240'b001101100010110011101111111110000101100100111011101110001100100011010110111110010011010000101000111011101111100011011101110101110110000001111111010010111010101110110110000010000111110101011111100011100111010010101100110110001100101001011011 ;
localparam WIDTH = 320'h09090909090909090a0909090a080a09090809090908080909090a0808090909080808080a080909;
localparam SUM_BITS = $clog2(HIDDEN_CNT+1);
localparam INDEX_BITS = $clog2(FEAT_CNT+1)+FEAT_BITS;
wire signed [FEAT_BITS:0] feature_array [FEAT_CNT-1:0];
wire [HIDDEN_CNT-1:0] hidden;
wire [HIDDEN_CNT-1:0] hidden_n;
wire [CLASS_CNT*SUM_BITS-1:0] scores; 
assign hidden_n = ~hidden;

wire signed [INDEX_BITS:0] node [FULLCNT-1:0];

genvar i;
generate
    for(i=0;i<FEAT_CNT;i=i+1)
        assign feature_array[i] = {1'b0,features[i*FEAT_BITS+:FEAT_BITS]};
    for(i=0;i<FEAT_CNT;i=i+1)
        assign node[i] = feature_array[i];
endgenerate

integer j;
generate
for(i=0;i<ADDCNT;i=i+1) begin
    localparam adsub = PAAR0[i*48];
    localparam op1 = PAAR0[i*48+16+:16];
    localparam op2 = PAAR0[i*48+32+:16];
    localparam nodeloc = FEAT_CNT + i;
    if(adsub)
        assign node[nodeloc] = node[op1] - node[op2];
    else
        assign node[nodeloc] = node[op1] + node[op2];
end
for(i=0;i<HIDDEN_CNT;i=i+1) begin
    localparam ymap = YMAP[i*32+:16];
    localparam signy = YMAP[i*32+16];
    if(signy)
        assign hidden[i] = node[ymap] >= 0;
    else
        assign hidden[i] = node[ymap] <= 0;
end
endgenerate

/* initial begin */
/*     #10 */
/*     for(j=0;j<FULLCNT;j=j+1) begin */
/*         $display("%d | %d | %b, %d, %d", j, node[j], PAAR0[(j- FEAT_CNT )*48],  PAAR0[(j-FEAT_CNT)*48+16+:16], PAAR0[(j-FEAT_CNT)*48+32+:16]); */
/*     end */
/* end */

generate
for(i=0;i<CLASS_CNT;i=i+1) begin
    localparam Wneur = Weights1[i*HIDDEN_CNT+:HIDDEN_CNT];
    reg unsigned [SUM_BITS-1:0] tmpscore;
    always @ (*) begin
        tmpscore = 0;
        for(j=0;j<HIDDEN_CNT;j=j+1) begin
        if(Wneur[j])
            tmpscore = tmpscore + hidden[j];
        else 
            tmpscore = tmpscore + hidden_n[j];
        end
    end
    assign scores[i*SUM_BITS+:SUM_BITS] = tmpscore;
end
endgenerate

argmax #(.SIZE(CLASS_CNT),.INDEX_BITS($clog2(CLASS_CNT)),.BITS(SUM_BITS)) result (
    .inx(scores),
    .outimax(prediction)
);
endmodule
