cyberseihis/bnnprint/designs/bnnparser/cardio_bnn1_bnnparw.v

module cardio_bnn1_bnnparw #(

parameter FEAT_CNT = 19,
parameter HIDDEN_CNT = 40,
parameter FEAT_BITS = 4,
parameter CLASS_CNT = 3,
parameter TEST_CNT = 1000


)(
    input [FEAT_CNT*FEAT_BITS-1:0] features,
    output [$clog2(CLASS_CNT)-1:0] prediction
);
localparam SUM_BITS = $clog2(HIDDEN_CNT+1);
localparam INDEX_BITS = $clog2(FEAT_CNT+1)+FEAT_BITS;
wire signed [FEAT_BITS:0] feature_array [FEAT_CNT-1:0];
wire [HIDDEN_CNT-1:0] hidden;
wire unsigned [INDEX_BITS-1:0] positives [HIDDEN_CNT-1:0];
wire unsigned [INDEX_BITS-1:0] negatives [HIDDEN_CNT-1:0];
wire [HIDDEN_CNT-1:0] hidden_n;
wire [CLASS_CNT*SUM_BITS-1:0] scores; 
assign hidden_n = ~hidden;

genvar i;
generate
    for(i=0;i<FEAT_CNT;i=i+1)
        assign feature_array[i] = {1'b0,features[i*FEAT_BITS+:FEAT_BITS]};
endgenerate



    wire signed [7:0] intra_0;
    assign intra_0 = + feature_array[0] + feature_array[1] - feature_array[2] + feature_array[3] - feature_array[4] + feature_array[5] - feature_array[6] + feature_array[7] + feature_array[8] - feature_array[9] - feature_array[10] - feature_array[11] + feature_array[12] - feature_array[13] + feature_array[14] + feature_array[15] + feature_array[16] + feature_array[17] - feature_array[18];
    assign hidden[0] = intra_0 >= 0;

    wire signed [6:0] intra_1;
    assign intra_1 = - feature_array[0] + feature_array[1] - feature_array[2] + feature_array[3] - feature_array[4] + feature_array[5] - feature_array[6] + feature_array[7] - feature_array[8] - feature_array[9] + feature_array[10] - feature_array[11] - feature_array[12] + feature_array[13] + feature_array[14] + feature_array[15] - feature_array[16] + feature_array[17] - feature_array[18];
    assign hidden[1] = intra_1 >= 0;

    wire signed [6:0] intra_2;
    assign intra_2 = + feature_array[0] - feature_array[1] - feature_array[2] - feature_array[3] + feature_array[4] - feature_array[5] + feature_array[6] - feature_array[7] - feature_array[8] + feature_array[9] - feature_array[10] - feature_array[11] + feature_array[12] - feature_array[13] + feature_array[14] - feature_array[15] + feature_array[16] - feature_array[17] - feature_array[18];
    assign hidden[2] = intra_2 >= 0;

    wire signed [6:0] intra_3;
    assign intra_3 = + feature_array[0] - feature_array[1] - feature_array[2] - feature_array[3] + feature_array[4] + feature_array[5] - feature_array[6] - feature_array[7] - feature_array[8] + feature_array[9] + feature_array[10] + feature_array[11] + feature_array[12] - feature_array[13] + feature_array[14] - feature_array[15] - feature_array[16] + feature_array[17] + feature_array[18];
    assign hidden[3] = intra_3 >= 0;

    wire signed [6:0] intra_4;
    assign intra_4 = - feature_array[0] + feature_array[1] - feature_array[2] + feature_array[3] + feature_array[4] + feature_array[5] - feature_array[6] + feature_array[7] + feature_array[8] - feature_array[9] + feature_array[10] + feature_array[11] - feature_array[12] + feature_array[13] + feature_array[14] - feature_array[15] + feature_array[16] + feature_array[17] - feature_array[18];
    assign hidden[4] = intra_4 >= 0;

    wire signed [6:0] intra_5;
    assign intra_5 = + feature_array[0] - feature_array[1] + feature_array[2] + feature_array[3] + feature_array[4] - feature_array[5] - feature_array[6] - feature_array[7] + feature_array[8] - feature_array[9] - feature_array[10] - feature_array[11] - feature_array[12] + feature_array[13] - feature_array[14] - feature_array[15] + feature_array[16] - feature_array[17] + feature_array[18];
    assign hidden[5] = intra_5 >= 0;

    wire signed [6:0] intra_6;
    assign intra_6 = + feature_array[0] - feature_array[1] - feature_array[2] - feature_array[3] + feature_array[4] + feature_array[5] - feature_array[6] - feature_array[7] + feature_array[8] + feature_array[9] - feature_array[10] + feature_array[11] + feature_array[12] - feature_array[13] + feature_array[14] - feature_array[15] - feature_array[16] - feature_array[17] + feature_array[18];
    assign hidden[6] = intra_6 >= 0;

    wire signed [6:0] intra_7;
    assign intra_7 = - feature_array[0] - feature_array[1] + feature_array[2] + feature_array[3] - feature_array[4] + feature_array[5] + feature_array[6] + feature_array[7] + feature_array[8] - feature_array[9] - feature_array[10] - feature_array[11] + feature_array[12] - feature_array[13] - feature_array[14] + feature_array[15] + feature_array[16] - feature_array[17] - feature_array[18];
    assign hidden[7] = intra_7 >= 0;

    wire signed [7:0] intra_8;
    assign intra_8 = + feature_array[0] + feature_array[1] - feature_array[2] + feature_array[3] - feature_array[4] + feature_array[5] - feature_array[6] + feature_array[7] + feature_array[8] - feature_array[9] + feature_array[10] - feature_array[11] + feature_array[12] + feature_array[13] - feature_array[14] + feature_array[15] + feature_array[16] + feature_array[17] - feature_array[18];
    assign hidden[8] = intra_8 >= 0;

    wire signed [6:0] intra_9;
    assign intra_9 = + feature_array[0] - feature_array[1] + feature_array[2] - feature_array[3] + feature_array[4] - feature_array[5] + feature_array[6] - feature_array[7] + feature_array[8] + feature_array[9] - feature_array[10] - feature_array[11] + feature_array[12] - feature_array[13] + feature_array[14] - feature_array[15] - feature_array[16] - feature_array[17] + feature_array[18];
    assign hidden[9] = intra_9 >= 0;

    wire signed [7:0] intra_10;
    assign intra_10 = + feature_array[0] - feature_array[1] - feature_array[2] - feature_array[3] - feature_array[4] + feature_array[5] - feature_array[6] - feature_array[7] + feature_array[8] - feature_array[9] + feature_array[10] - feature_array[11] - feature_array[12] - feature_array[13] - feature_array[14] - feature_array[15] - feature_array[16] - feature_array[17] + feature_array[18];
    assign hidden[10] = intra_10 >= 0;

    wire signed [7:0] intra_11;
    assign intra_11 = + feature_array[0] - feature_array[1] - feature_array[2] - feature_array[3] + feature_array[4] - feature_array[5] - feature_array[6] + feature_array[7] + feature_array[8] + feature_array[9] + feature_array[10] + feature_array[11] + feature_array[12] + feature_array[13] - feature_array[14] - feature_array[15] + feature_array[16] - feature_array[17] + feature_array[18];
    assign hidden[11] = intra_11 >= 0;

    wire signed [7:0] intra_12;
    assign intra_12 = - feature_array[0] + feature_array[1] + feature_array[2] + feature_array[3] + feature_array[4] - feature_array[5] - feature_array[6] + feature_array[7] + feature_array[8] - feature_array[9] - feature_array[10] - feature_array[11] - feature_array[12] - feature_array[13] - feature_array[14] - feature_array[15] + feature_array[16] - feature_array[17] - feature_array[18];
    assign hidden[12] = intra_12 >= 0;

    wire signed [7:0] intra_13;
    assign intra_13 = - feature_array[0] - feature_array[1] + feature_array[2] - feature_array[3] + feature_array[4] + feature_array[5] + feature_array[6] - feature_array[7] + feature_array[8] + feature_array[9] - feature_array[10] - feature_array[11] - feature_array[12] - feature_array[13] - feature_array[14] - feature_array[15] - feature_array[16] - feature_array[17] - feature_array[18];
    assign hidden[13] = intra_13 >= 0;

    wire signed [6:0] intra_14;
    assign intra_14 = + feature_array[0] + feature_array[1] - feature_array[2] + feature_array[3] - feature_array[4] - feature_array[5] - feature_array[6] + feature_array[7] + feature_array[8] - feature_array[9] + feature_array[10] - feature_array[11] + feature_array[12] + feature_array[13] + feature_array[14] + feature_array[15] - feature_array[16] - feature_array[17] - feature_array[18];
    assign hidden[14] = intra_14 >= 0;

    wire signed [6:0] intra_15;
    assign intra_15 = + feature_array[0] - feature_array[1] + feature_array[2] - feature_array[3] + feature_array[4] - feature_array[5] - feature_array[6] + feature_array[7] - feature_array[8] - feature_array[9] - feature_array[10] - feature_array[11] - feature_array[12] + feature_array[13] - feature_array[14] - feature_array[15] + feature_array[16] + feature_array[17] + feature_array[18];
    assign hidden[15] = intra_15 >= 0;

    wire signed [6:0] intra_16;
    assign intra_16 = - feature_array[0] + feature_array[1] + feature_array[2] + feature_array[3] - feature_array[4] + feature_array[5] - feature_array[6] - feature_array[7] - feature_array[8] - feature_array[9] + feature_array[10] - feature_array[11] - feature_array[12] + feature_array[13] - feature_array[14] + feature_array[15] + feature_array[16] + feature_array[17] - feature_array[18];
    assign hidden[16] = intra_16 >= 0;

    wire signed [6:0] intra_17;
    assign intra_17 = - feature_array[0] + feature_array[1] - feature_array[2] + feature_array[3] - feature_array[4] + feature_array[5] - feature_array[6] + feature_array[7] + feature_array[8] - feature_array[9] + feature_array[10] + feature_array[11] - feature_array[12] - feature_array[13] - feature_array[14] - feature_array[15] + feature_array[16] + feature_array[17] + feature_array[18];
    assign hidden[17] = intra_17 >= 0;

    wire signed [6:0] intra_18;
    assign intra_18 = - feature_array[0] + feature_array[1] - feature_array[2] + feature_array[3] + feature_array[4] + feature_array[5] - feature_array[6] - feature_array[7] - feature_array[8] - feature_array[9] - feature_array[10] + feature_array[11] + feature_array[12] + feature_array[13] + feature_array[14] + feature_array[15] + feature_array[16] - feature_array[17] - feature_array[18];
    assign hidden[18] = intra_18 >= 0;

    wire signed [6:0] intra_19;
    assign intra_19 = + feature_array[0] - feature_array[1] + feature_array[2] - feature_array[3] - feature_array[4] - feature_array[5] - feature_array[6] + feature_array[7] - feature_array[8] - feature_array[9] - feature_array[10] + feature_array[11] + feature_array[12] + feature_array[13] - feature_array[14] - feature_array[15] - feature_array[16] - feature_array[17] + feature_array[18];
    assign hidden[19] = intra_19 >= 0;

    wire signed [7:0] intra_20;
    assign intra_20 = + feature_array[0] - feature_array[1] - feature_array[2] - feature_array[3] - feature_array[4] - feature_array[5] - feature_array[6] + feature_array[7] - feature_array[8] - feature_array[9] - feature_array[10] - feature_array[11] - feature_array[12] - feature_array[13] - feature_array[14] + feature_array[15] - feature_array[16] + feature_array[17] + feature_array[18];
    assign hidden[20] = intra_20 >= 0;

    wire signed [6:0] intra_21;
    assign intra_21 = - feature_array[0] + feature_array[1] - feature_array[2] + feature_array[3] - feature_array[4] - feature_array[5] + feature_array[6] + feature_array[7] + feature_array[8] - feature_array[9] + feature_array[10] - feature_array[11] + feature_array[12] - feature_array[13] - feature_array[14] + feature_array[15] + feature_array[16] + feature_array[17] - feature_array[18];
    assign hidden[21] = intra_21 >= 0;

    wire signed [7:0] intra_22;
    assign intra_22 = - feature_array[0] - feature_array[1] + feature_array[2] - feature_array[3] - feature_array[4] - feature_array[5] - feature_array[6] - feature_array[7] - feature_array[8] + feature_array[9] - feature_array[10] - feature_array[11] - feature_array[12] + feature_array[13] + feature_array[14] + feature_array[15] - feature_array[16] - feature_array[17] + feature_array[18];
    assign hidden[22] = intra_22 >= 0;

    wire signed [5:0] intra_23;
    assign intra_23 = + feature_array[0] - feature_array[1] - feature_array[2] - feature_array[3] + feature_array[4] + feature_array[5] - feature_array[6] - feature_array[7] - feature_array[8] + feature_array[9] + feature_array[10] - feature_array[11] - feature_array[12] - feature_array[13] - feature_array[14] - feature_array[15] + feature_array[16] + feature_array[17] - feature_array[18];
    assign hidden[23] = intra_23 >= 0;

    wire signed [6:0] intra_24;
    assign intra_24 = - feature_array[0] + feature_array[1] - feature_array[2] - feature_array[3] - feature_array[4] + feature_array[5] - feature_array[6] + feature_array[7] - feature_array[8] + feature_array[9] + feature_array[10] + feature_array[11] - feature_array[12] + feature_array[13] - feature_array[14] - feature_array[15] + feature_array[16] + feature_array[17] + feature_array[18];
    assign hidden[24] = intra_24 >= 0;

    wire signed [6:0] intra_25;
    assign intra_25 = + feature_array[0] - feature_array[1] - feature_array[2] - feature_array[3] + feature_array[4] - feature_array[5] + feature_array[6] + feature_array[7] - feature_array[8] + feature_array[9] - feature_array[10] - feature_array[11] + feature_array[12] - feature_array[13] - feature_array[14] + feature_array[15] - feature_array[16] - feature_array[17] - feature_array[18];
    assign hidden[25] = intra_25 >= 0;

    wire signed [7:0] intra_26;
    assign intra_26 = - feature_array[0] - feature_array[1] + feature_array[2] - feature_array[3] + feature_array[4] + feature_array[5] + feature_array[6] - feature_array[7] + feature_array[8] + feature_array[9] + feature_array[10] + feature_array[11] - feature_array[12] - feature_array[13] - feature_array[14] - feature_array[15] - feature_array[16] - feature_array[17] + feature_array[18];
    assign hidden[26] = intra_26 >= 0;

    wire signed [6:0] intra_27;
    assign intra_27 = + feature_array[0] + feature_array[1] - feature_array[2] + feature_array[3] - feature_array[4] + feature_array[5] + feature_array[6] + feature_array[7] + feature_array[8] - feature_array[9] + feature_array[10] - feature_array[11] + feature_array[12] + feature_array[13] + feature_array[14] - feature_array[15] - feature_array[16] - feature_array[17] - feature_array[18];
    assign hidden[27] = intra_27 >= 0;

    wire signed [6:0] intra_28;
    assign intra_28 = - feature_array[0] + feature_array[1] + feature_array[2] + feature_array[3] + feature_array[4] - feature_array[5] - feature_array[6] + feature_array[7] + feature_array[8] - feature_array[9] + feature_array[10] - feature_array[11] - feature_array[12] - feature_array[13] - feature_array[14] + feature_array[15] + feature_array[16] + feature_array[17] + feature_array[18];
    assign hidden[28] = intra_28 >= 0;

    wire signed [6:0] intra_29;
    assign intra_29 = + feature_array[0] + feature_array[1] - feature_array[2] + feature_array[3] - feature_array[4] + feature_array[5] + feature_array[6] - feature_array[7] + feature_array[8] - feature_array[9] - feature_array[10] - feature_array[11] - feature_array[12] + feature_array[13] + feature_array[14] - feature_array[15] + feature_array[16] - feature_array[17] - feature_array[18];
    assign hidden[29] = intra_29 >= 0;

    wire signed [7:0] intra_30;
    assign intra_30 = - feature_array[0] - feature_array[1] - feature_array[2] - feature_array[3] - feature_array[4] - feature_array[5] + feature_array[6] + feature_array[7] - feature_array[8] - feature_array[9] - feature_array[10] - feature_array[11] - feature_array[12] - feature_array[13] + feature_array[14] - feature_array[15] + feature_array[16] + feature_array[17] - feature_array[18];
    assign hidden[30] = intra_30 >= 0;

    wire signed [6:0] intra_31;
    assign intra_31 = - feature_array[0] + feature_array[1] + feature_array[2] + feature_array[3] - feature_array[4] - feature_array[5] + feature_array[6] + feature_array[7] + feature_array[8] - feature_array[9] + feature_array[10] - feature_array[11] + feature_array[12] - feature_array[13] + feature_array[14] - feature_array[15] + feature_array[16] - feature_array[17] + feature_array[18];
    assign hidden[31] = intra_31 >= 0;

    wire signed [7:0] intra_32;
    assign intra_32 = + feature_array[0] + feature_array[1] - feature_array[2] + feature_array[3] + feature_array[4] + feature_array[5] - feature_array[6] + feature_array[7] + feature_array[8] - feature_array[9] + feature_array[10] + feature_array[11] + feature_array[12] - feature_array[13] + feature_array[14] - feature_array[15] + feature_array[16] + feature_array[17] - feature_array[18];
    assign hidden[32] = intra_32 >= 0;

    wire signed [7:0] intra_33;
    assign intra_33 = - feature_array[0] - feature_array[1] + feature_array[2] - feature_array[3] + feature_array[4] - feature_array[5] - feature_array[6] - feature_array[7] - feature_array[8] - feature_array[9] - feature_array[10] + feature_array[11] - feature_array[12] + feature_array[13] - feature_array[14] - feature_array[15] + feature_array[16] - feature_array[17] - feature_array[18];
    assign hidden[33] = intra_33 >= 0;

    wire signed [7:0] intra_34;
    assign intra_34 = + feature_array[0] - feature_array[1] + feature_array[2] - feature_array[3] - feature_array[4] - feature_array[5] + feature_array[6] + feature_array[7] - feature_array[8] - feature_array[9] - feature_array[10] + feature_array[11] - feature_array[12] - feature_array[13] + feature_array[14] + feature_array[15] - feature_array[16] - feature_array[17] - feature_array[18];
    assign hidden[34] = intra_34 >= 0;

    wire signed [7:0] intra_35;
    assign intra_35 = + feature_array[0] - feature_array[1] - feature_array[2] + feature_array[3] - feature_array[4] + feature_array[5] + feature_array[6] - feature_array[7] - feature_array[8] - feature_array[9] + feature_array[10] - feature_array[11] + feature_array[12] + feature_array[13] - feature_array[14] + feature_array[15] + feature_array[16] + feature_array[17] + feature_array[18];
    assign hidden[35] = intra_35 >= 0;

    wire signed [7:0] intra_36;
    assign intra_36 = - feature_array[0] - feature_array[1] - feature_array[2] - feature_array[3] + feature_array[4] + feature_array[5] - feature_array[6] - feature_array[7] - feature_array[8] + feature_array[9] - feature_array[10] - feature_array[11] + feature_array[12] - feature_array[13] - feature_array[14] - feature_array[15] - feature_array[16] - feature_array[17] + feature_array[18];
    assign hidden[36] = intra_36 >= 0;

    wire signed [6:0] intra_37;
    assign intra_37 = - feature_array[0] - feature_array[1] + feature_array[2] + feature_array[3] - feature_array[4] + feature_array[5] + feature_array[6] + feature_array[7] - feature_array[8] + feature_array[9] + feature_array[10] + feature_array[11] - feature_array[12] - feature_array[13] - feature_array[14] - feature_array[15] - feature_array[16] + feature_array[17] + feature_array[18];
    assign hidden[37] = intra_37 >= 0;

    wire signed [6:0] intra_38;
    assign intra_38 = - feature_array[0] + feature_array[1] - feature_array[2] + feature_array[3] - feature_array[4] - feature_array[5] - feature_array[6] - feature_array[7] + feature_array[8] - feature_array[9] - feature_array[10] + feature_array[11] - feature_array[12] + feature_array[13] - feature_array[14] + feature_array[15] + feature_array[16] + feature_array[17] - feature_array[18];
    assign hidden[38] = intra_38 >= 0;

    wire signed [7:0] intra_39;
    assign intra_39 = - feature_array[0] - feature_array[1] + feature_array[2] - feature_array[3] - feature_array[4] + feature_array[5] + feature_array[6] + feature_array[7] + feature_array[8] + feature_array[9] + feature_array[10] - feature_array[11] + feature_array[12] + feature_array[13] - feature_array[14] - feature_array[15] - feature_array[16] - feature_array[17] - feature_array[18];
    assign hidden[39] = intra_39 >= 0;
assign scores[0*SUM_BITS+:SUM_BITS] = + hidden[0] + hidden[1] + hidden_n[2] + hidden_n[3] + hidden[4] + hidden[5] + hidden_n[6] + hidden[7] + hidden[8] + hidden_n[9] + hidden_n[10] + hidden_n[11] + hidden_n[12] + hidden[13] + hidden[14] + hidden_n[15] + hidden[16] + hidden[17] + hidden[18] + hidden_n[19] + hidden[20] + hidden[21] + hidden_n[22] + hidden_n[23] + hidden[24] + hidden_n[25] + hidden_n[26] + hidden[27] + hidden[28] + hidden[29] + hidden_n[30] + hidden_n[31] + hidden[32] + hidden[33] + hidden_n[34] + hidden[35] + hidden_n[36] + hidden_n[37] + hidden[38] + hidden_n[39];
assign scores[1*SUM_BITS+:SUM_BITS] = + hidden[0] + hidden[1] + hidden[2] + hidden_n[3] + hidden_n[4] + hidden[5] + hidden_n[6] + hidden[7] + hidden[8] + hidden_n[9] + hidden_n[10] + hidden[11] + hidden_n[12] + hidden[13] + hidden[14] + hidden_n[15] + hidden[16] + hidden[17] + hidden[18] + hidden_n[19] + hidden[20] + hidden[21] + hidden_n[22] + hidden_n[23] + hidden[24] + hidden[25] + hidden_n[26] + hidden[27] + hidden[28] + hidden_n[29] + hidden_n[30] + hidden_n[31] + hidden[32] + hidden[33] + hidden_n[34] + hidden[35] + hidden_n[36] + hidden_n[37] + hidden[38] + hidden[39];
assign scores[2*SUM_BITS+:SUM_BITS] = + hidden[0] + hidden_n[1] + hidden_n[2] + hidden[3] + hidden[4] + hidden[5] + hidden_n[6] + hidden_n[7] + hidden_n[8] + hidden[9] + hidden_n[10] + hidden_n[11] + hidden_n[12] + hidden[13] + hidden_n[14] + hidden_n[15] + hidden[16] + hidden[17] + hidden_n[18] + hidden_n[19] + hidden_n[20] + hidden_n[21] + hidden_n[22] + hidden_n[23] + hidden[24] + hidden[25] + hidden[26] + hidden[27] + hidden[28] + hidden_n[29] + hidden_n[30] + hidden_n[31] + hidden_n[32] + hidden_n[33] + hidden_n[34] + hidden[35] + hidden_n[36] + hidden[37] + hidden_n[38] + hidden[39];


argmax #(.SIZE(CLASS_CNT),.INDEX_BITS($clog2(CLASS_CNT)),.BITS(SUM_BITS)) result (
    .inx(scores),
    .outimax(prediction)
);
endmodule
