cyberseihis/bnnprint/designs/bnnparpnw/products/gasId_bnn1_bnnparpnw.v

module gasId_bnn1_bnnparpnw #(

parameter FEAT_CNT = 128,
parameter HIDDEN_CNT = 40,
parameter FEAT_BITS = 4,
parameter CLASS_CNT = 6,
parameter TEST_CNT = 1000


)(
    input [FEAT_CNT*FEAT_BITS-1:0] features,
    output [$clog2(CLASS_CNT)-1:0] prediction
);
localparam SUM_BITS = $clog2(HIDDEN_CNT+1);
localparam INDEX_BITS = $clog2(FEAT_CNT+1)+FEAT_BITS;
wire unsigned [FEAT_BITS-1:0] feature_array [FEAT_CNT-1:0];
wire [HIDDEN_CNT-1:0] hidden;
wire [HIDDEN_CNT-1:0] hidden_n;
wire [CLASS_CNT*SUM_BITS-1:0] scores; 
assign hidden_n = ~hidden;

genvar i;
generate
    for(i=0;i<FEAT_CNT;i=i+1)
        assign feature_array[i] = features[i*FEAT_BITS+:FEAT_BITS];
endgenerate



    wire unsigned [9:0] pos_0;
    wire unsigned [9:0] neg_0;
    assign pos_0 = + feature_array[0] + feature_array[1] + feature_array[3] + feature_array[4] + feature_array[5] + feature_array[8] + feature_array[9] + feature_array[10] + feature_array[11] + feature_array[12] + feature_array[14] + feature_array[21] + feature_array[22] + feature_array[23] + feature_array[24] + feature_array[28] + feature_array[30] + feature_array[33] + feature_array[34] + feature_array[35] + feature_array[36] + feature_array[39] + feature_array[40] + feature_array[41] + feature_array[42] + feature_array[43] + feature_array[48] + feature_array[49] + feature_array[51] + feature_array[53] + feature_array[54] + feature_array[57] + feature_array[58] + feature_array[64] + feature_array[65] + feature_array[66] + feature_array[67] + feature_array[68] + feature_array[72] + feature_array[73] + feature_array[74] + feature_array[75] + feature_array[76] + feature_array[78] + feature_array[79] + feature_array[80] + feature_array[85] + feature_array[86] + feature_array[88] + feature_array[93] + feature_array[94] + feature_array[95] + feature_array[96] + feature_array[97] + feature_array[99] + feature_array[100] + feature_array[103] + feature_array[104] + feature_array[105] + feature_array[106] + feature_array[107] + feature_array[108] + feature_array[109] + feature_array[110] + feature_array[111] + feature_array[117] + feature_array[119] + feature_array[120] + feature_array[122] + feature_array[124] + feature_array[126] + feature_array[127];
    assign neg_0 = + feature_array[2] + feature_array[6] + feature_array[7] + feature_array[13] + feature_array[15] + feature_array[16] + feature_array[17] + feature_array[18] + feature_array[19] + feature_array[20] + feature_array[25] + feature_array[26] + feature_array[27] + feature_array[29] + feature_array[31] + feature_array[32] + feature_array[37] + feature_array[38] + feature_array[44] + feature_array[45] + feature_array[46] + feature_array[47] + feature_array[50] + feature_array[52] + feature_array[55] + feature_array[56] + feature_array[59] + feature_array[60] + feature_array[61] + feature_array[62] + feature_array[63] + feature_array[69] + feature_array[70] + feature_array[71] + feature_array[77] + feature_array[81] + feature_array[82] + feature_array[83] + feature_array[84] + feature_array[87] + feature_array[89] + feature_array[90] + feature_array[91] + feature_array[92] + feature_array[98] + feature_array[101] + feature_array[102] + feature_array[112] + feature_array[113] + feature_array[114] + feature_array[115] + feature_array[116] + feature_array[118] + feature_array[121] + feature_array[123] + feature_array[125];
    assign hidden[0] = pos_0 >= neg_0;

    wire unsigned [9:0] pos_1;
    wire unsigned [9:0] neg_1;
    assign pos_1 = + feature_array[1] + feature_array[2] + feature_array[5] + feature_array[16] + feature_array[17] + feature_array[18] + feature_array[19] + feature_array[20] + feature_array[21] + feature_array[22] + feature_array[23] + feature_array[24] + feature_array[25] + feature_array[26] + feature_array[27] + feature_array[28] + feature_array[29] + feature_array[30] + feature_array[35] + feature_array[37] + feature_array[39] + feature_array[41] + feature_array[43] + feature_array[44] + feature_array[47] + feature_array[48] + feature_array[49] + feature_array[51] + feature_array[52] + feature_array[53] + feature_array[54] + feature_array[56] + feature_array[58] + feature_array[59] + feature_array[62] + feature_array[70] + feature_array[80] + feature_array[81] + feature_array[83] + feature_array[84] + feature_array[85] + feature_array[86] + feature_array[89] + feature_array[90] + feature_array[91] + feature_array[96] + feature_array[97] + feature_array[98] + feature_array[99] + feature_array[100] + feature_array[103] + feature_array[104] + feature_array[105] + feature_array[106] + feature_array[107] + feature_array[108] + feature_array[110] + feature_array[115] + feature_array[116] + feature_array[117] + feature_array[118] + feature_array[119] + feature_array[123] + feature_array[124] + feature_array[125] + feature_array[127];
    assign neg_1 = + feature_array[0] + feature_array[3] + feature_array[4] + feature_array[6] + feature_array[7] + feature_array[8] + feature_array[9] + feature_array[10] + feature_array[11] + feature_array[12] + feature_array[13] + feature_array[14] + feature_array[15] + feature_array[31] + feature_array[32] + feature_array[33] + feature_array[34] + feature_array[36] + feature_array[38] + feature_array[40] + feature_array[42] + feature_array[45] + feature_array[46] + feature_array[50] + feature_array[55] + feature_array[57] + feature_array[60] + feature_array[61] + feature_array[63] + feature_array[64] + feature_array[65] + feature_array[66] + feature_array[67] + feature_array[68] + feature_array[69] + feature_array[71] + feature_array[72] + feature_array[73] + feature_array[74] + feature_array[75] + feature_array[76] + feature_array[77] + feature_array[78] + feature_array[79] + feature_array[82] + feature_array[87] + feature_array[88] + feature_array[92] + feature_array[93] + feature_array[94] + feature_array[95] + feature_array[101] + feature_array[102] + feature_array[109] + feature_array[111] + feature_array[112] + feature_array[113] + feature_array[114] + feature_array[120] + feature_array[121] + feature_array[122] + feature_array[126];
    assign hidden[1] = pos_1 >= neg_1;

    wire unsigned [9:0] pos_2;
    wire unsigned [9:0] neg_2;
    assign pos_2 = + feature_array[0] + feature_array[6] + feature_array[7] + feature_array[8] + feature_array[9] + feature_array[10] + feature_array[12] + feature_array[14] + feature_array[16] + feature_array[17] + feature_array[18] + feature_array[19] + feature_array[20] + feature_array[24] + feature_array[25] + feature_array[26] + feature_array[27] + feature_array[37] + feature_array[38] + feature_array[39] + feature_array[41] + feature_array[45] + feature_array[46] + feature_array[47] + feature_array[48] + feature_array[49] + feature_array[50] + feature_array[51] + feature_array[56] + feature_array[58] + feature_array[62] + feature_array[63] + feature_array[64] + feature_array[66] + feature_array[71] + feature_array[72] + feature_array[77] + feature_array[80] + feature_array[81] + feature_array[82] + feature_array[83] + feature_array[89] + feature_array[90] + feature_array[93] + feature_array[95] + feature_array[101] + feature_array[102] + feature_array[103] + feature_array[109] + feature_array[111] + feature_array[112] + feature_array[114] + feature_array[115] + feature_array[117] + feature_array[118] + feature_array[120] + feature_array[121] + feature_array[123] + feature_array[126] + feature_array[127];
    assign neg_2 = + feature_array[1] + feature_array[2] + feature_array[3] + feature_array[4] + feature_array[5] + feature_array[11] + feature_array[13] + feature_array[15] + feature_array[21] + feature_array[22] + feature_array[23] + feature_array[28] + feature_array[29] + feature_array[30] + feature_array[31] + feature_array[32] + feature_array[33] + feature_array[34] + feature_array[35] + feature_array[36] + feature_array[40] + feature_array[42] + feature_array[43] + feature_array[44] + feature_array[52] + feature_array[53] + feature_array[54] + feature_array[55] + feature_array[57] + feature_array[59] + feature_array[60] + feature_array[61] + feature_array[65] + feature_array[67] + feature_array[68] + feature_array[69] + feature_array[70] + feature_array[73] + feature_array[74] + feature_array[75] + feature_array[76] + feature_array[78] + feature_array[79] + feature_array[84] + feature_array[85] + feature_array[86] + feature_array[87] + feature_array[88] + feature_array[91] + feature_array[92] + feature_array[94] + feature_array[96] + feature_array[97] + feature_array[98] + feature_array[99] + feature_array[100] + feature_array[104] + feature_array[105] + feature_array[106] + feature_array[107] + feature_array[108] + feature_array[110] + feature_array[113] + feature_array[116] + feature_array[119] + feature_array[122] + feature_array[124] + feature_array[125];
    assign hidden[2] = pos_2 >= neg_2;

    wire unsigned [9:0] pos_3;
    wire unsigned [8:0] neg_3;
    assign pos_3 = + feature_array[7] + feature_array[8] + feature_array[9] + feature_array[13] + feature_array[14] + feature_array[16] + feature_array[17] + feature_array[18] + feature_array[19] + feature_array[21] + feature_array[23] + feature_array[24] + feature_array[25] + feature_array[26] + feature_array[27] + feature_array[28] + feature_array[29] + feature_array[32] + feature_array[34] + feature_array[35] + feature_array[36] + feature_array[39] + feature_array[40] + feature_array[41] + feature_array[43] + feature_array[44] + feature_array[46] + feature_array[47] + feature_array[48] + feature_array[49] + feature_array[51] + feature_array[52] + feature_array[55] + feature_array[57] + feature_array[60] + feature_array[61] + feature_array[63] + feature_array[68] + feature_array[69] + feature_array[70] + feature_array[71] + feature_array[72] + feature_array[77] + feature_array[79] + feature_array[80] + feature_array[81] + feature_array[82] + feature_array[83] + feature_array[84] + feature_array[86] + feature_array[88] + feature_array[89] + feature_array[90] + feature_array[93] + feature_array[94] + feature_array[96] + feature_array[97] + feature_array[98] + feature_array[100] + feature_array[104] + feature_array[106] + feature_array[107] + feature_array[108] + feature_array[109] + feature_array[110] + feature_array[111] + feature_array[112] + feature_array[113] + feature_array[114] + feature_array[115] + feature_array[116] + feature_array[117] + feature_array[121] + feature_array[122] + feature_array[127];
    assign neg_3 = + feature_array[0] + feature_array[1] + feature_array[2] + feature_array[3] + feature_array[4] + feature_array[5] + feature_array[6] + feature_array[10] + feature_array[11] + feature_array[12] + feature_array[15] + feature_array[20] + feature_array[22] + feature_array[30] + feature_array[31] + feature_array[33] + feature_array[37] + feature_array[38] + feature_array[42] + feature_array[45] + feature_array[50] + feature_array[53] + feature_array[54] + feature_array[56] + feature_array[58] + feature_array[59] + feature_array[62] + feature_array[64] + feature_array[65] + feature_array[66] + feature_array[67] + feature_array[73] + feature_array[74] + feature_array[75] + feature_array[76] + feature_array[78] + feature_array[85] + feature_array[87] + feature_array[91] + feature_array[92] + feature_array[95] + feature_array[99] + feature_array[101] + feature_array[102] + feature_array[103] + feature_array[105] + feature_array[118] + feature_array[119] + feature_array[120] + feature_array[123] + feature_array[124] + feature_array[125] + feature_array[126];
    assign hidden[3] = pos_3 >= neg_3;

    wire unsigned [9:0] pos_4;
    wire unsigned [9:0] neg_4;
    assign pos_4 = + feature_array[0] + feature_array[1] + feature_array[2] + feature_array[3] + feature_array[4] + feature_array[5] + feature_array[8] + feature_array[9] + feature_array[10] + feature_array[11] + feature_array[12] + feature_array[14] + feature_array[15] + feature_array[18] + feature_array[20] + feature_array[21] + feature_array[22] + feature_array[23] + feature_array[28] + feature_array[29] + feature_array[32] + feature_array[34] + feature_array[35] + feature_array[38] + feature_array[42] + feature_array[43] + feature_array[44] + feature_array[45] + feature_array[46] + feature_array[47] + feature_array[49] + feature_array[52] + feature_array[53] + feature_array[57] + feature_array[58] + feature_array[59] + feature_array[60] + feature_array[64] + feature_array[65] + feature_array[66] + feature_array[67] + feature_array[68] + feature_array[69] + feature_array[70] + feature_array[71] + feature_array[72] + feature_array[73] + feature_array[74] + feature_array[75] + feature_array[76] + feature_array[77] + feature_array[79] + feature_array[85] + feature_array[86] + feature_array[87] + feature_array[91] + feature_array[92] + feature_array[96] + feature_array[98] + feature_array[99] + feature_array[100] + feature_array[104] + feature_array[106] + feature_array[107] + feature_array[108] + feature_array[109] + feature_array[110] + feature_array[111] + feature_array[112] + feature_array[113] + feature_array[115] + feature_array[116] + feature_array[118] + feature_array[120] + feature_array[123] + feature_array[124];
    assign neg_4 = + feature_array[6] + feature_array[7] + feature_array[13] + feature_array[16] + feature_array[17] + feature_array[19] + feature_array[24] + feature_array[25] + feature_array[26] + feature_array[27] + feature_array[30] + feature_array[31] + feature_array[33] + feature_array[36] + feature_array[37] + feature_array[39] + feature_array[40] + feature_array[41] + feature_array[48] + feature_array[50] + feature_array[51] + feature_array[54] + feature_array[55] + feature_array[56] + feature_array[61] + feature_array[62] + feature_array[63] + feature_array[78] + feature_array[80] + feature_array[81] + feature_array[82] + feature_array[83] + feature_array[84] + feature_array[88] + feature_array[89] + feature_array[90] + feature_array[93] + feature_array[94] + feature_array[95] + feature_array[97] + feature_array[101] + feature_array[102] + feature_array[103] + feature_array[105] + feature_array[114] + feature_array[117] + feature_array[119] + feature_array[121] + feature_array[122] + feature_array[125] + feature_array[126] + feature_array[127];
    assign hidden[4] = pos_4 >= neg_4;

    wire unsigned [9:0] pos_5;
    wire unsigned [9:0] neg_5;
    assign pos_5 = + feature_array[0] + feature_array[5] + feature_array[6] + feature_array[8] + feature_array[9] + feature_array[10] + feature_array[12] + feature_array[14] + feature_array[16] + feature_array[17] + feature_array[18] + feature_array[20] + feature_array[21] + feature_array[22] + feature_array[24] + feature_array[26] + feature_array[28] + feature_array[29] + feature_array[30] + feature_array[32] + feature_array[33] + feature_array[34] + feature_array[36] + feature_array[37] + feature_array[38] + feature_array[40] + feature_array[44] + feature_array[45] + feature_array[50] + feature_array[54] + feature_array[56] + feature_array[57] + feature_array[61] + feature_array[62] + feature_array[63] + feature_array[66] + feature_array[68] + feature_array[69] + feature_array[76] + feature_array[80] + feature_array[81] + feature_array[82] + feature_array[85] + feature_array[88] + feature_array[89] + feature_array[90] + feature_array[91] + feature_array[94] + feature_array[96] + feature_array[101] + feature_array[104] + feature_array[105] + feature_array[106] + feature_array[111] + feature_array[112] + feature_array[114] + feature_array[117] + feature_array[119] + feature_array[120] + feature_array[125] + feature_array[126];
    assign neg_5 = + feature_array[1] + feature_array[2] + feature_array[3] + feature_array[4] + feature_array[7] + feature_array[11] + feature_array[13] + feature_array[15] + feature_array[19] + feature_array[23] + feature_array[25] + feature_array[27] + feature_array[31] + feature_array[35] + feature_array[39] + feature_array[41] + feature_array[42] + feature_array[43] + feature_array[46] + feature_array[47] + feature_array[48] + feature_array[49] + feature_array[51] + feature_array[52] + feature_array[53] + feature_array[55] + feature_array[58] + feature_array[59] + feature_array[60] + feature_array[64] + feature_array[65] + feature_array[67] + feature_array[70] + feature_array[71] + feature_array[72] + feature_array[73] + feature_array[74] + feature_array[75] + feature_array[77] + feature_array[78] + feature_array[79] + feature_array[83] + feature_array[84] + feature_array[86] + feature_array[87] + feature_array[92] + feature_array[93] + feature_array[95] + feature_array[97] + feature_array[98] + feature_array[99] + feature_array[100] + feature_array[102] + feature_array[103] + feature_array[107] + feature_array[108] + feature_array[109] + feature_array[110] + feature_array[113] + feature_array[115] + feature_array[116] + feature_array[118] + feature_array[121] + feature_array[122] + feature_array[123] + feature_array[124] + feature_array[127];
    assign hidden[5] = pos_5 >= neg_5;

    wire unsigned [9:0] pos_6;
    wire unsigned [9:0] neg_6;
    assign pos_6 = + feature_array[0] + feature_array[1] + feature_array[2] + feature_array[3] + feature_array[6] + feature_array[8] + feature_array[9] + feature_array[13] + feature_array[15] + feature_array[17] + feature_array[21] + feature_array[23] + feature_array[25] + feature_array[28] + feature_array[35] + feature_array[37] + feature_array[39] + feature_array[41] + feature_array[43] + feature_array[46] + feature_array[48] + feature_array[50] + feature_array[51] + feature_array[52] + feature_array[54] + feature_array[57] + feature_array[60] + feature_array[63] + feature_array[64] + feature_array[66] + feature_array[67] + feature_array[68] + feature_array[69] + feature_array[70] + feature_array[71] + feature_array[72] + feature_array[73] + feature_array[74] + feature_array[75] + feature_array[76] + feature_array[77] + feature_array[78] + feature_array[80] + feature_array[82] + feature_array[83] + feature_array[89] + feature_array[94] + feature_array[95] + feature_array[98] + feature_array[99] + feature_array[100] + feature_array[102] + feature_array[103] + feature_array[107] + feature_array[108] + feature_array[112] + feature_array[114] + feature_array[115] + feature_array[117] + feature_array[118] + feature_array[122] + feature_array[123] + feature_array[124] + feature_array[125] + feature_array[126] + feature_array[127];
    assign neg_6 = + feature_array[4] + feature_array[5] + feature_array[7] + feature_array[10] + feature_array[11] + feature_array[12] + feature_array[14] + feature_array[16] + feature_array[18] + feature_array[19] + feature_array[20] + feature_array[22] + feature_array[24] + feature_array[26] + feature_array[27] + feature_array[29] + feature_array[30] + feature_array[31] + feature_array[32] + feature_array[33] + feature_array[34] + feature_array[36] + feature_array[38] + feature_array[40] + feature_array[42] + feature_array[44] + feature_array[45] + feature_array[47] + feature_array[49] + feature_array[53] + feature_array[55] + feature_array[56] + feature_array[58] + feature_array[59] + feature_array[61] + feature_array[62] + feature_array[65] + feature_array[79] + feature_array[81] + feature_array[84] + feature_array[85] + feature_array[86] + feature_array[87] + feature_array[88] + feature_array[90] + feature_array[91] + feature_array[92] + feature_array[93] + feature_array[96] + feature_array[97] + feature_array[101] + feature_array[104] + feature_array[105] + feature_array[106] + feature_array[109] + feature_array[110] + feature_array[111] + feature_array[113] + feature_array[116] + feature_array[119] + feature_array[120] + feature_array[121];
    assign hidden[6] = pos_6 >= neg_6;

    wire unsigned [9:0] pos_7;
    wire unsigned [9:0] neg_7;
    assign pos_7 = + feature_array[2] + feature_array[3] + feature_array[4] + feature_array[7] + feature_array[8] + feature_array[9] + feature_array[10] + feature_array[11] + feature_array[12] + feature_array[14] + feature_array[16] + feature_array[17] + feature_array[18] + feature_array[23] + feature_array[24] + feature_array[26] + feature_array[27] + feature_array[30] + feature_array[31] + feature_array[32] + feature_array[33] + feature_array[36] + feature_array[37] + feature_array[38] + feature_array[41] + feature_array[42] + feature_array[44] + feature_array[45] + feature_array[48] + feature_array[49] + feature_array[50] + feature_array[54] + feature_array[56] + feature_array[57] + feature_array[62] + feature_array[63] + feature_array[69] + feature_array[71] + feature_array[77] + feature_array[79] + feature_array[80] + feature_array[81] + feature_array[82] + feature_array[84] + feature_array[85] + feature_array[88] + feature_array[90] + feature_array[91] + feature_array[95] + feature_array[96] + feature_array[102] + feature_array[103] + feature_array[104] + feature_array[109] + feature_array[113] + feature_array[114] + feature_array[117] + feature_array[118] + feature_array[119] + feature_array[120] + feature_array[121] + feature_array[127];
    assign neg_7 = + feature_array[0] + feature_array[1] + feature_array[5] + feature_array[6] + feature_array[13] + feature_array[15] + feature_array[19] + feature_array[20] + feature_array[21] + feature_array[22] + feature_array[25] + feature_array[28] + feature_array[29] + feature_array[34] + feature_array[35] + feature_array[39] + feature_array[40] + feature_array[43] + feature_array[46] + feature_array[47] + feature_array[51] + feature_array[52] + feature_array[53] + feature_array[55] + feature_array[58] + feature_array[59] + feature_array[60] + feature_array[61] + feature_array[64] + feature_array[65] + feature_array[66] + feature_array[67] + feature_array[68] + feature_array[70] + feature_array[72] + feature_array[73] + feature_array[74] + feature_array[75] + feature_array[76] + feature_array[78] + feature_array[83] + feature_array[86] + feature_array[87] + feature_array[89] + feature_array[92] + feature_array[93] + feature_array[94] + feature_array[97] + feature_array[98] + feature_array[99] + feature_array[100] + feature_array[101] + feature_array[105] + feature_array[106] + feature_array[107] + feature_array[108] + feature_array[110] + feature_array[111] + feature_array[112] + feature_array[115] + feature_array[116] + feature_array[122] + feature_array[123] + feature_array[124] + feature_array[125] + feature_array[126];
    assign hidden[7] = pos_7 >= neg_7;

    wire unsigned [9:0] pos_8;
    wire unsigned [9:0] neg_8;
    assign pos_8 = + feature_array[6] + feature_array[7] + feature_array[12] + feature_array[15] + feature_array[16] + feature_array[17] + feature_array[18] + feature_array[19] + feature_array[20] + feature_array[22] + feature_array[23] + feature_array[25] + feature_array[26] + feature_array[27] + feature_array[30] + feature_array[33] + feature_array[36] + feature_array[37] + feature_array[38] + feature_array[39] + feature_array[44] + feature_array[46] + feature_array[47] + feature_array[48] + feature_array[51] + feature_array[54] + feature_array[55] + feature_array[56] + feature_array[58] + feature_array[59] + feature_array[60] + feature_array[61] + feature_array[62] + feature_array[69] + feature_array[80] + feature_array[81] + feature_array[82] + feature_array[83] + feature_array[86] + feature_array[87] + feature_array[88] + feature_array[89] + feature_array[90] + feature_array[91] + feature_array[93] + feature_array[95] + feature_array[96] + feature_array[97] + feature_array[103] + feature_array[104] + feature_array[105] + feature_array[110] + feature_array[112] + feature_array[113] + feature_array[115] + feature_array[117] + feature_array[124] + feature_array[126] + feature_array[127];
    assign neg_8 = + feature_array[0] + feature_array[1] + feature_array[2] + feature_array[3] + feature_array[4] + feature_array[5] + feature_array[8] + feature_array[9] + feature_array[10] + feature_array[11] + feature_array[13] + feature_array[14] + feature_array[21] + feature_array[24] + feature_array[28] + feature_array[29] + feature_array[31] + feature_array[32] + feature_array[34] + feature_array[35] + feature_array[40] + feature_array[41] + feature_array[42] + feature_array[43] + feature_array[45] + feature_array[49] + feature_array[50] + feature_array[52] + feature_array[53] + feature_array[57] + feature_array[63] + feature_array[64] + feature_array[65] + feature_array[66] + feature_array[67] + feature_array[68] + feature_array[70] + feature_array[71] + feature_array[72] + feature_array[73] + feature_array[74] + feature_array[75] + feature_array[76] + feature_array[77] + feature_array[78] + feature_array[79] + feature_array[84] + feature_array[85] + feature_array[92] + feature_array[94] + feature_array[98] + feature_array[99] + feature_array[100] + feature_array[101] + feature_array[102] + feature_array[106] + feature_array[107] + feature_array[108] + feature_array[109] + feature_array[111] + feature_array[114] + feature_array[116] + feature_array[118] + feature_array[119] + feature_array[120] + feature_array[121] + feature_array[122] + feature_array[123] + feature_array[125];
    assign hidden[8] = pos_8 >= neg_8;

    wire unsigned [9:0] pos_9;
    wire unsigned [9:0] neg_9;
    assign pos_9 = + feature_array[0] + feature_array[1] + feature_array[4] + feature_array[8] + feature_array[9] + feature_array[12] + feature_array[13] + feature_array[16] + feature_array[17] + feature_array[18] + feature_array[19] + feature_array[20] + feature_array[24] + feature_array[25] + feature_array[26] + feature_array[27] + feature_array[30] + feature_array[32] + feature_array[33] + feature_array[34] + feature_array[35] + feature_array[36] + feature_array[43] + feature_array[45] + feature_array[47] + feature_array[50] + feature_array[51] + feature_array[53] + feature_array[55] + feature_array[56] + feature_array[58] + feature_array[59] + feature_array[60] + feature_array[61] + feature_array[62] + feature_array[68] + feature_array[69] + feature_array[72] + feature_array[73] + feature_array[74] + feature_array[76] + feature_array[79] + feature_array[80] + feature_array[82] + feature_array[83] + feature_array[84] + feature_array[86] + feature_array[88] + feature_array[89] + feature_array[90] + feature_array[91] + feature_array[94] + feature_array[96] + feature_array[97] + feature_array[98] + feature_array[99] + feature_array[100] + feature_array[102] + feature_array[103] + feature_array[104] + feature_array[106] + feature_array[107] + feature_array[108] + feature_array[112] + feature_array[114] + feature_array[115] + feature_array[116] + feature_array[117] + feature_array[118] + feature_array[120] + feature_array[121] + feature_array[122] + feature_array[123] + feature_array[124] + feature_array[126];
    assign neg_9 = + feature_array[2] + feature_array[3] + feature_array[5] + feature_array[6] + feature_array[7] + feature_array[10] + feature_array[11] + feature_array[14] + feature_array[15] + feature_array[21] + feature_array[22] + feature_array[23] + feature_array[28] + feature_array[29] + feature_array[31] + feature_array[37] + feature_array[38] + feature_array[39] + feature_array[40] + feature_array[41] + feature_array[42] + feature_array[44] + feature_array[46] + feature_array[48] + feature_array[49] + feature_array[52] + feature_array[54] + feature_array[57] + feature_array[63] + feature_array[64] + feature_array[65] + feature_array[66] + feature_array[67] + feature_array[70] + feature_array[71] + feature_array[75] + feature_array[77] + feature_array[78] + feature_array[81] + feature_array[85] + feature_array[87] + feature_array[92] + feature_array[93] + feature_array[95] + feature_array[101] + feature_array[105] + feature_array[109] + feature_array[110] + feature_array[111] + feature_array[113] + feature_array[119] + feature_array[125] + feature_array[127];
    assign hidden[9] = pos_9 >= neg_9;

    wire unsigned [9:0] pos_10;
    wire unsigned [9:0] neg_10;
    assign pos_10 = + feature_array[0] + feature_array[2] + feature_array[8] + feature_array[10] + feature_array[11] + feature_array[12] + feature_array[13] + feature_array[14] + feature_array[17] + feature_array[18] + feature_array[19] + feature_array[23] + feature_array[25] + feature_array[26] + feature_array[27] + feature_array[30] + feature_array[33] + feature_array[36] + feature_array[37] + feature_array[39] + feature_array[44] + feature_array[45] + feature_array[46] + feature_array[48] + feature_array[53] + feature_array[56] + feature_array[62] + feature_array[63] + feature_array[64] + feature_array[65] + feature_array[66] + feature_array[67] + feature_array[68] + feature_array[69] + feature_array[72] + feature_array[77] + feature_array[78] + feature_array[80] + feature_array[81] + feature_array[82] + feature_array[84] + feature_array[86] + feature_array[87] + feature_array[88] + feature_array[89] + feature_array[90] + feature_array[92] + feature_array[94] + feature_array[101] + feature_array[102] + feature_array[103] + feature_array[109] + feature_array[111] + feature_array[112] + feature_array[113] + feature_array[114] + feature_array[117] + feature_array[118] + feature_array[120] + feature_array[121] + feature_array[122] + feature_array[124];
    assign neg_10 = + feature_array[1] + feature_array[3] + feature_array[4] + feature_array[5] + feature_array[6] + feature_array[7] + feature_array[9] + feature_array[15] + feature_array[16] + feature_array[20] + feature_array[21] + feature_array[22] + feature_array[24] + feature_array[28] + feature_array[29] + feature_array[31] + feature_array[32] + feature_array[34] + feature_array[35] + feature_array[38] + feature_array[40] + feature_array[41] + feature_array[42] + feature_array[43] + feature_array[47] + feature_array[49] + feature_array[50] + feature_array[51] + feature_array[52] + feature_array[54] + feature_array[55] + feature_array[57] + feature_array[58] + feature_array[59] + feature_array[60] + feature_array[61] + feature_array[70] + feature_array[71] + feature_array[73] + feature_array[74] + feature_array[75] + feature_array[76] + feature_array[79] + feature_array[83] + feature_array[85] + feature_array[91] + feature_array[93] + feature_array[95] + feature_array[96] + feature_array[97] + feature_array[98] + feature_array[99] + feature_array[100] + feature_array[104] + feature_array[105] + feature_array[106] + feature_array[107] + feature_array[108] + feature_array[110] + feature_array[115] + feature_array[116] + feature_array[119] + feature_array[123] + feature_array[125] + feature_array[126] + feature_array[127];
    assign hidden[10] = pos_10 >= neg_10;

    wire unsigned [9:0] pos_11;
    wire unsigned [9:0] neg_11;
    assign pos_11 = + feature_array[2] + feature_array[6] + feature_array[7] + feature_array[13] + feature_array[14] + feature_array[15] + feature_array[17] + feature_array[18] + feature_array[24] + feature_array[25] + feature_array[26] + feature_array[27] + feature_array[31] + feature_array[32] + feature_array[33] + feature_array[34] + feature_array[36] + feature_array[37] + feature_array[39] + feature_array[42] + feature_array[44] + feature_array[46] + feature_array[47] + feature_array[48] + feature_array[50] + feature_array[54] + feature_array[55] + feature_array[57] + feature_array[59] + feature_array[60] + feature_array[63] + feature_array[65] + feature_array[69] + feature_array[74] + feature_array[79] + feature_array[80] + feature_array[87] + feature_array[88] + feature_array[89] + feature_array[90] + feature_array[91] + feature_array[92] + feature_array[95] + feature_array[97] + feature_array[101] + feature_array[102] + feature_array[103] + feature_array[104] + feature_array[105] + feature_array[110] + feature_array[112] + feature_array[116] + feature_array[117] + feature_array[120] + feature_array[125] + feature_array[127];
    assign neg_11 = + feature_array[0] + feature_array[1] + feature_array[3] + feature_array[4] + feature_array[5] + feature_array[8] + feature_array[9] + feature_array[10] + feature_array[11] + feature_array[12] + feature_array[16] + feature_array[19] + feature_array[20] + feature_array[21] + feature_array[22] + feature_array[23] + feature_array[28] + feature_array[29] + feature_array[30] + feature_array[35] + feature_array[38] + feature_array[40] + feature_array[41] + feature_array[43] + feature_array[45] + feature_array[49] + feature_array[51] + feature_array[52] + feature_array[53] + feature_array[56] + feature_array[58] + feature_array[61] + feature_array[62] + feature_array[64] + feature_array[66] + feature_array[67] + feature_array[68] + feature_array[70] + feature_array[71] + feature_array[72] + feature_array[73] + feature_array[75] + feature_array[76] + feature_array[77] + feature_array[78] + feature_array[81] + feature_array[82] + feature_array[83] + feature_array[84] + feature_array[85] + feature_array[86] + feature_array[93] + feature_array[94] + feature_array[96] + feature_array[98] + feature_array[99] + feature_array[100] + feature_array[106] + feature_array[107] + feature_array[108] + feature_array[109] + feature_array[111] + feature_array[113] + feature_array[114] + feature_array[115] + feature_array[118] + feature_array[119] + feature_array[121] + feature_array[122] + feature_array[123] + feature_array[124] + feature_array[126];
    assign hidden[11] = pos_11 >= neg_11;

    wire unsigned [9:0] pos_12;
    wire unsigned [9:0] neg_12;
    assign pos_12 = + feature_array[5] + feature_array[10] + feature_array[11] + feature_array[14] + feature_array[17] + feature_array[18] + feature_array[21] + feature_array[23] + feature_array[24] + feature_array[25] + feature_array[27] + feature_array[29] + feature_array[34] + feature_array[38] + feature_array[40] + feature_array[41] + feature_array[44] + feature_array[45] + feature_array[46] + feature_array[47] + feature_array[50] + feature_array[51] + feature_array[54] + feature_array[55] + feature_array[56] + feature_array[57] + feature_array[59] + feature_array[60] + feature_array[61] + feature_array[62] + feature_array[63] + feature_array[65] + feature_array[69] + feature_array[73] + feature_array[77] + feature_array[78] + feature_array[79] + feature_array[80] + feature_array[81] + feature_array[82] + feature_array[83] + feature_array[85] + feature_array[88] + feature_array[90] + feature_array[92] + feature_array[97] + feature_array[110] + feature_array[111] + feature_array[112] + feature_array[113] + feature_array[114] + feature_array[116] + feature_array[118] + feature_array[120] + feature_array[121] + feature_array[122] + feature_array[125] + feature_array[127];
    assign neg_12 = + feature_array[0] + feature_array[1] + feature_array[2] + feature_array[3] + feature_array[4] + feature_array[6] + feature_array[7] + feature_array[8] + feature_array[9] + feature_array[12] + feature_array[13] + feature_array[15] + feature_array[16] + feature_array[19] + feature_array[20] + feature_array[22] + feature_array[26] + feature_array[28] + feature_array[30] + feature_array[31] + feature_array[32] + feature_array[33] + feature_array[35] + feature_array[36] + feature_array[37] + feature_array[39] + feature_array[42] + feature_array[43] + feature_array[48] + feature_array[49] + feature_array[52] + feature_array[53] + feature_array[58] + feature_array[64] + feature_array[66] + feature_array[67] + feature_array[68] + feature_array[70] + feature_array[71] + feature_array[72] + feature_array[74] + feature_array[75] + feature_array[76] + feature_array[84] + feature_array[86] + feature_array[87] + feature_array[89] + feature_array[91] + feature_array[93] + feature_array[94] + feature_array[95] + feature_array[96] + feature_array[98] + feature_array[99] + feature_array[100] + feature_array[101] + feature_array[102] + feature_array[103] + feature_array[104] + feature_array[105] + feature_array[106] + feature_array[107] + feature_array[108] + feature_array[109] + feature_array[115] + feature_array[117] + feature_array[119] + feature_array[123] + feature_array[124] + feature_array[126];
    assign hidden[12] = pos_12 >= neg_12;

    wire unsigned [8:0] pos_13;
    wire unsigned [9:0] neg_13;
    assign pos_13 = + feature_array[0] + feature_array[3] + feature_array[5] + feature_array[10] + feature_array[11] + feature_array[13] + feature_array[15] + feature_array[20] + feature_array[28] + feature_array[29] + feature_array[31] + feature_array[32] + feature_array[33] + feature_array[34] + feature_array[36] + feature_array[38] + feature_array[42] + feature_array[46] + feature_array[49] + feature_array[53] + feature_array[55] + feature_array[57] + feature_array[61] + feature_array[63] + feature_array[65] + feature_array[66] + feature_array[67] + feature_array[70] + feature_array[71] + feature_array[72] + feature_array[73] + feature_array[75] + feature_array[78] + feature_array[79] + feature_array[85] + feature_array[86] + feature_array[87] + feature_array[93] + feature_array[94] + feature_array[96] + feature_array[97] + feature_array[98] + feature_array[99] + feature_array[102] + feature_array[103] + feature_array[106] + feature_array[107] + feature_array[109] + feature_array[111] + feature_array[114] + feature_array[125];
    assign neg_13 = + feature_array[1] + feature_array[2] + feature_array[4] + feature_array[6] + feature_array[7] + feature_array[8] + feature_array[9] + feature_array[12] + feature_array[14] + feature_array[16] + feature_array[17] + feature_array[18] + feature_array[19] + feature_array[21] + feature_array[22] + feature_array[23] + feature_array[24] + feature_array[25] + feature_array[26] + feature_array[27] + feature_array[30] + feature_array[35] + feature_array[37] + feature_array[39] + feature_array[40] + feature_array[41] + feature_array[43] + feature_array[44] + feature_array[45] + feature_array[47] + feature_array[48] + feature_array[50] + feature_array[51] + feature_array[52] + feature_array[54] + feature_array[56] + feature_array[58] + feature_array[59] + feature_array[60] + feature_array[62] + feature_array[64] + feature_array[68] + feature_array[69] + feature_array[74] + feature_array[76] + feature_array[77] + feature_array[80] + feature_array[81] + feature_array[82] + feature_array[83] + feature_array[84] + feature_array[88] + feature_array[89] + feature_array[90] + feature_array[91] + feature_array[92] + feature_array[95] + feature_array[100] + feature_array[101] + feature_array[104] + feature_array[105] + feature_array[108] + feature_array[110] + feature_array[112] + feature_array[113] + feature_array[115] + feature_array[116] + feature_array[117] + feature_array[118] + feature_array[119] + feature_array[120] + feature_array[121] + feature_array[122] + feature_array[123] + feature_array[124] + feature_array[126] + feature_array[127];
    assign hidden[13] = pos_13 >= neg_13;

    wire unsigned [9:0] pos_14;
    wire unsigned [9:0] neg_14;
    assign pos_14 = + feature_array[0] + feature_array[2] + feature_array[3] + feature_array[5] + feature_array[7] + feature_array[8] + feature_array[10] + feature_array[11] + feature_array[12] + feature_array[13] + feature_array[14] + feature_array[15] + feature_array[16] + feature_array[21] + feature_array[22] + feature_array[23] + feature_array[24] + feature_array[28] + feature_array[31] + feature_array[32] + feature_array[34] + feature_array[35] + feature_array[36] + feature_array[38] + feature_array[42] + feature_array[43] + feature_array[48] + feature_array[49] + feature_array[50] + feature_array[52] + feature_array[54] + feature_array[56] + feature_array[57] + feature_array[61] + feature_array[62] + feature_array[63] + feature_array[64] + feature_array[65] + feature_array[66] + feature_array[67] + feature_array[68] + feature_array[70] + feature_array[71] + feature_array[72] + feature_array[73] + feature_array[74] + feature_array[75] + feature_array[76] + feature_array[77] + feature_array[79] + feature_array[85] + feature_array[88] + feature_array[90] + feature_array[95] + feature_array[96] + feature_array[98] + feature_array[99] + feature_array[104] + feature_array[106] + feature_array[107] + feature_array[110] + feature_array[114] + feature_array[117] + feature_array[122] + feature_array[124] + feature_array[126] + feature_array[127];
    assign neg_14 = + feature_array[1] + feature_array[4] + feature_array[6] + feature_array[9] + feature_array[17] + feature_array[18] + feature_array[19] + feature_array[20] + feature_array[25] + feature_array[26] + feature_array[27] + feature_array[29] + feature_array[30] + feature_array[33] + feature_array[37] + feature_array[39] + feature_array[40] + feature_array[41] + feature_array[44] + feature_array[45] + feature_array[46] + feature_array[47] + feature_array[51] + feature_array[53] + feature_array[55] + feature_array[58] + feature_array[59] + feature_array[60] + feature_array[69] + feature_array[78] + feature_array[80] + feature_array[81] + feature_array[82] + feature_array[83] + feature_array[84] + feature_array[86] + feature_array[87] + feature_array[89] + feature_array[91] + feature_array[92] + feature_array[93] + feature_array[94] + feature_array[97] + feature_array[100] + feature_array[101] + feature_array[102] + feature_array[103] + feature_array[105] + feature_array[108] + feature_array[109] + feature_array[111] + feature_array[112] + feature_array[113] + feature_array[115] + feature_array[116] + feature_array[118] + feature_array[119] + feature_array[120] + feature_array[121] + feature_array[123] + feature_array[125];
    assign hidden[14] = pos_14 >= neg_14;

    wire unsigned [9:0] pos_15;
    wire unsigned [9:0] neg_15;
    assign pos_15 = + feature_array[0] + feature_array[1] + feature_array[2] + feature_array[3] + feature_array[4] + feature_array[6] + feature_array[7] + feature_array[8] + feature_array[9] + feature_array[10] + feature_array[11] + feature_array[12] + feature_array[14] + feature_array[21] + feature_array[28] + feature_array[29] + feature_array[30] + feature_array[32] + feature_array[33] + feature_array[34] + feature_array[36] + feature_array[37] + feature_array[41] + feature_array[47] + feature_array[48] + feature_array[49] + feature_array[50] + feature_array[53] + feature_array[55] + feature_array[58] + feature_array[60] + feature_array[63] + feature_array[64] + feature_array[65] + feature_array[66] + feature_array[67] + feature_array[68] + feature_array[69] + feature_array[70] + feature_array[72] + feature_array[73] + feature_array[74] + feature_array[77] + feature_array[79] + feature_array[80] + feature_array[82] + feature_array[85] + feature_array[88] + feature_array[90] + feature_array[93] + feature_array[94] + feature_array[95] + feature_array[102] + feature_array[104] + feature_array[106] + feature_array[110] + feature_array[111] + feature_array[117] + feature_array[118] + feature_array[119] + feature_array[120];
    assign neg_15 = + feature_array[5] + feature_array[13] + feature_array[15] + feature_array[16] + feature_array[17] + feature_array[18] + feature_array[19] + feature_array[20] + feature_array[22] + feature_array[23] + feature_array[24] + feature_array[25] + feature_array[26] + feature_array[27] + feature_array[31] + feature_array[35] + feature_array[38] + feature_array[39] + feature_array[40] + feature_array[42] + feature_array[43] + feature_array[44] + feature_array[45] + feature_array[46] + feature_array[51] + feature_array[52] + feature_array[54] + feature_array[56] + feature_array[57] + feature_array[59] + feature_array[61] + feature_array[62] + feature_array[71] + feature_array[75] + feature_array[76] + feature_array[78] + feature_array[81] + feature_array[83] + feature_array[84] + feature_array[86] + feature_array[87] + feature_array[89] + feature_array[91] + feature_array[92] + feature_array[96] + feature_array[97] + feature_array[98] + feature_array[99] + feature_array[100] + feature_array[101] + feature_array[103] + feature_array[105] + feature_array[107] + feature_array[108] + feature_array[109] + feature_array[112] + feature_array[113] + feature_array[114] + feature_array[115] + feature_array[116] + feature_array[121] + feature_array[122] + feature_array[123] + feature_array[124] + feature_array[125] + feature_array[126] + feature_array[127];
    assign hidden[15] = pos_15 >= neg_15;

    wire unsigned [9:0] pos_16;
    wire unsigned [9:0] neg_16;
    assign pos_16 = + feature_array[2] + feature_array[4] + feature_array[5] + feature_array[6] + feature_array[9] + feature_array[11] + feature_array[12] + feature_array[13] + feature_array[14] + feature_array[15] + feature_array[16] + feature_array[17] + feature_array[18] + feature_array[19] + feature_array[22] + feature_array[23] + feature_array[25] + feature_array[26] + feature_array[27] + feature_array[29] + feature_array[31] + feature_array[34] + feature_array[36] + feature_array[38] + feature_array[39] + feature_array[41] + feature_array[42] + feature_array[46] + feature_array[47] + feature_array[49] + feature_array[53] + feature_array[54] + feature_array[56] + feature_array[61] + feature_array[70] + feature_array[77] + feature_array[82] + feature_array[84] + feature_array[86] + feature_array[87] + feature_array[88] + feature_array[90] + feature_array[91] + feature_array[92] + feature_array[95] + feature_array[96] + feature_array[97] + feature_array[101] + feature_array[105] + feature_array[112] + feature_array[118] + feature_array[119] + feature_array[126] + feature_array[127];
    assign neg_16 = + feature_array[0] + feature_array[1] + feature_array[3] + feature_array[7] + feature_array[8] + feature_array[10] + feature_array[20] + feature_array[21] + feature_array[24] + feature_array[28] + feature_array[30] + feature_array[32] + feature_array[33] + feature_array[35] + feature_array[37] + feature_array[40] + feature_array[43] + feature_array[44] + feature_array[45] + feature_array[48] + feature_array[50] + feature_array[51] + feature_array[52] + feature_array[55] + feature_array[57] + feature_array[58] + feature_array[59] + feature_array[60] + feature_array[62] + feature_array[63] + feature_array[64] + feature_array[65] + feature_array[66] + feature_array[67] + feature_array[68] + feature_array[69] + feature_array[71] + feature_array[72] + feature_array[73] + feature_array[74] + feature_array[75] + feature_array[76] + feature_array[78] + feature_array[79] + feature_array[80] + feature_array[81] + feature_array[83] + feature_array[85] + feature_array[89] + feature_array[93] + feature_array[94] + feature_array[98] + feature_array[99] + feature_array[100] + feature_array[102] + feature_array[103] + feature_array[104] + feature_array[106] + feature_array[107] + feature_array[108] + feature_array[109] + feature_array[110] + feature_array[111] + feature_array[113] + feature_array[114] + feature_array[115] + feature_array[116] + feature_array[117] + feature_array[120] + feature_array[121] + feature_array[122] + feature_array[123] + feature_array[124] + feature_array[125];
    assign hidden[16] = pos_16 >= neg_16;

    wire unsigned [9:0] pos_17;
    wire unsigned [9:0] neg_17;
    assign pos_17 = + feature_array[0] + feature_array[11] + feature_array[14] + feature_array[16] + feature_array[18] + feature_array[22] + feature_array[24] + feature_array[26] + feature_array[28] + feature_array[29] + feature_array[32] + feature_array[34] + feature_array[36] + feature_array[37] + feature_array[38] + feature_array[39] + feature_array[40] + feature_array[41] + feature_array[42] + feature_array[47] + feature_array[48] + feature_array[53] + feature_array[56] + feature_array[57] + feature_array[58] + feature_array[60] + feature_array[65] + feature_array[69] + feature_array[70] + feature_array[71] + feature_array[73] + feature_array[75] + feature_array[77] + feature_array[79] + feature_array[86] + feature_array[92] + feature_array[94] + feature_array[95] + feature_array[96] + feature_array[97] + feature_array[98] + feature_array[99] + feature_array[101] + feature_array[102] + feature_array[103] + feature_array[104] + feature_array[105] + feature_array[106] + feature_array[107] + feature_array[109] + feature_array[110] + feature_array[120] + feature_array[122] + feature_array[126] + feature_array[127];
    assign neg_17 = + feature_array[1] + feature_array[2] + feature_array[3] + feature_array[4] + feature_array[5] + feature_array[6] + feature_array[7] + feature_array[8] + feature_array[9] + feature_array[10] + feature_array[12] + feature_array[13] + feature_array[15] + feature_array[17] + feature_array[19] + feature_array[20] + feature_array[21] + feature_array[23] + feature_array[25] + feature_array[27] + feature_array[30] + feature_array[31] + feature_array[33] + feature_array[35] + feature_array[43] + feature_array[44] + feature_array[45] + feature_array[46] + feature_array[49] + feature_array[50] + feature_array[51] + feature_array[52] + feature_array[54] + feature_array[55] + feature_array[59] + feature_array[61] + feature_array[62] + feature_array[63] + feature_array[64] + feature_array[66] + feature_array[67] + feature_array[68] + feature_array[72] + feature_array[74] + feature_array[76] + feature_array[78] + feature_array[80] + feature_array[81] + feature_array[82] + feature_array[83] + feature_array[84] + feature_array[85] + feature_array[87] + feature_array[88] + feature_array[89] + feature_array[90] + feature_array[91] + feature_array[93] + feature_array[100] + feature_array[108] + feature_array[111] + feature_array[112] + feature_array[113] + feature_array[114] + feature_array[115] + feature_array[116] + feature_array[117] + feature_array[118] + feature_array[119] + feature_array[121] + feature_array[123] + feature_array[124] + feature_array[125];
    assign hidden[17] = pos_17 >= neg_17;

    wire unsigned [9:0] pos_18;
    wire unsigned [9:0] neg_18;
    assign pos_18 = + feature_array[2] + feature_array[3] + feature_array[4] + feature_array[6] + feature_array[7] + feature_array[11] + feature_array[13] + feature_array[17] + feature_array[18] + feature_array[20] + feature_array[22] + feature_array[23] + feature_array[25] + feature_array[26] + feature_array[27] + feature_array[29] + feature_array[34] + feature_array[36] + feature_array[38] + feature_array[39] + feature_array[40] + feature_array[41] + feature_array[42] + feature_array[44] + feature_array[45] + feature_array[46] + feature_array[47] + feature_array[48] + feature_array[49] + feature_array[51] + feature_array[54] + feature_array[55] + feature_array[56] + feature_array[57] + feature_array[60] + feature_array[65] + feature_array[69] + feature_array[70] + feature_array[71] + feature_array[78] + feature_array[79] + feature_array[81] + feature_array[82] + feature_array[85] + feature_array[86] + feature_array[87] + feature_array[89] + feature_array[90] + feature_array[91] + feature_array[92] + feature_array[98] + feature_array[99] + feature_array[102] + feature_array[103] + feature_array[105] + feature_array[109] + feature_array[110] + feature_array[113] + feature_array[114] + feature_array[120] + feature_array[121];
    assign neg_18 = + feature_array[0] + feature_array[1] + feature_array[5] + feature_array[8] + feature_array[9] + feature_array[10] + feature_array[12] + feature_array[14] + feature_array[15] + feature_array[16] + feature_array[19] + feature_array[21] + feature_array[24] + feature_array[28] + feature_array[30] + feature_array[31] + feature_array[32] + feature_array[33] + feature_array[35] + feature_array[37] + feature_array[43] + feature_array[50] + feature_array[52] + feature_array[53] + feature_array[58] + feature_array[59] + feature_array[61] + feature_array[62] + feature_array[63] + feature_array[64] + feature_array[66] + feature_array[67] + feature_array[68] + feature_array[72] + feature_array[73] + feature_array[74] + feature_array[75] + feature_array[76] + feature_array[77] + feature_array[80] + feature_array[83] + feature_array[84] + feature_array[88] + feature_array[93] + feature_array[94] + feature_array[95] + feature_array[96] + feature_array[97] + feature_array[100] + feature_array[101] + feature_array[104] + feature_array[106] + feature_array[107] + feature_array[108] + feature_array[111] + feature_array[112] + feature_array[115] + feature_array[116] + feature_array[117] + feature_array[118] + feature_array[119] + feature_array[122] + feature_array[123] + feature_array[124] + feature_array[125] + feature_array[126] + feature_array[127];
    assign hidden[18] = pos_18 >= neg_18;

    wire unsigned [9:0] pos_19;
    wire unsigned [9:0] neg_19;
    assign pos_19 = + feature_array[1] + feature_array[5] + feature_array[8] + feature_array[12] + feature_array[13] + feature_array[15] + feature_array[16] + feature_array[17] + feature_array[18] + feature_array[21] + feature_array[23] + feature_array[24] + feature_array[25] + feature_array[26] + feature_array[27] + feature_array[28] + feature_array[29] + feature_array[30] + feature_array[35] + feature_array[36] + feature_array[37] + feature_array[38] + feature_array[40] + feature_array[41] + feature_array[43] + feature_array[44] + feature_array[45] + feature_array[48] + feature_array[51] + feature_array[53] + feature_array[54] + feature_array[57] + feature_array[58] + feature_array[59] + feature_array[70] + feature_array[74] + feature_array[77] + feature_array[78] + feature_array[79] + feature_array[80] + feature_array[81] + feature_array[83] + feature_array[84] + feature_array[85] + feature_array[86] + feature_array[88] + feature_array[89] + feature_array[91] + feature_array[94] + feature_array[95] + feature_array[98] + feature_array[99] + feature_array[100] + feature_array[108] + feature_array[109] + feature_array[110] + feature_array[112] + feature_array[113] + feature_array[114] + feature_array[115] + feature_array[116] + feature_array[118] + feature_array[119] + feature_array[121] + feature_array[123] + feature_array[126] + feature_array[127];
    assign neg_19 = + feature_array[0] + feature_array[2] + feature_array[3] + feature_array[4] + feature_array[6] + feature_array[7] + feature_array[9] + feature_array[10] + feature_array[11] + feature_array[14] + feature_array[19] + feature_array[20] + feature_array[22] + feature_array[31] + feature_array[32] + feature_array[33] + feature_array[34] + feature_array[39] + feature_array[42] + feature_array[46] + feature_array[47] + feature_array[49] + feature_array[50] + feature_array[52] + feature_array[55] + feature_array[56] + feature_array[60] + feature_array[61] + feature_array[62] + feature_array[63] + feature_array[64] + feature_array[65] + feature_array[66] + feature_array[67] + feature_array[68] + feature_array[69] + feature_array[71] + feature_array[72] + feature_array[73] + feature_array[75] + feature_array[76] + feature_array[82] + feature_array[87] + feature_array[90] + feature_array[92] + feature_array[93] + feature_array[96] + feature_array[97] + feature_array[101] + feature_array[102] + feature_array[103] + feature_array[104] + feature_array[105] + feature_array[106] + feature_array[107] + feature_array[111] + feature_array[117] + feature_array[120] + feature_array[122] + feature_array[124] + feature_array[125];
    assign hidden[19] = pos_19 >= neg_19;

    wire unsigned [9:0] pos_20;
    wire unsigned [9:0] neg_20;
    assign pos_20 = + feature_array[1] + feature_array[4] + feature_array[5] + feature_array[7] + feature_array[13] + feature_array[16] + feature_array[17] + feature_array[18] + feature_array[19] + feature_array[23] + feature_array[25] + feature_array[26] + feature_array[27] + feature_array[28] + feature_array[31] + feature_array[32] + feature_array[35] + feature_array[38] + feature_array[40] + feature_array[43] + feature_array[46] + feature_array[47] + feature_array[49] + feature_array[50] + feature_array[51] + feature_array[52] + feature_array[53] + feature_array[54] + feature_array[55] + feature_array[57] + feature_array[58] + feature_array[59] + feature_array[60] + feature_array[61] + feature_array[73] + feature_array[77] + feature_array[78] + feature_array[79] + feature_array[81] + feature_array[83] + feature_array[85] + feature_array[86] + feature_array[87] + feature_array[89] + feature_array[90] + feature_array[91] + feature_array[92] + feature_array[93] + feature_array[94] + feature_array[97] + feature_array[98] + feature_array[99] + feature_array[100] + feature_array[101] + feature_array[105] + feature_array[106] + feature_array[107] + feature_array[108] + feature_array[110] + feature_array[113] + feature_array[115] + feature_array[116] + feature_array[118] + feature_array[121] + feature_array[123] + feature_array[124] + feature_array[125];
    assign neg_20 = + feature_array[0] + feature_array[2] + feature_array[3] + feature_array[6] + feature_array[8] + feature_array[9] + feature_array[10] + feature_array[11] + feature_array[12] + feature_array[14] + feature_array[15] + feature_array[20] + feature_array[21] + feature_array[22] + feature_array[24] + feature_array[29] + feature_array[30] + feature_array[33] + feature_array[34] + feature_array[36] + feature_array[37] + feature_array[39] + feature_array[41] + feature_array[42] + feature_array[44] + feature_array[45] + feature_array[48] + feature_array[56] + feature_array[62] + feature_array[63] + feature_array[64] + feature_array[65] + feature_array[66] + feature_array[67] + feature_array[68] + feature_array[69] + feature_array[70] + feature_array[71] + feature_array[72] + feature_array[74] + feature_array[75] + feature_array[76] + feature_array[80] + feature_array[82] + feature_array[84] + feature_array[88] + feature_array[95] + feature_array[96] + feature_array[102] + feature_array[103] + feature_array[104] + feature_array[109] + feature_array[111] + feature_array[112] + feature_array[114] + feature_array[117] + feature_array[119] + feature_array[120] + feature_array[122] + feature_array[126] + feature_array[127];
    assign hidden[20] = pos_20 >= neg_20;

    wire unsigned [9:0] pos_21;
    wire unsigned [9:0] neg_21;
    assign pos_21 = + feature_array[0] + feature_array[6] + feature_array[7] + feature_array[11] + feature_array[17] + feature_array[18] + feature_array[21] + feature_array[22] + feature_array[24] + feature_array[25] + feature_array[26] + feature_array[27] + feature_array[32] + feature_array[33] + feature_array[34] + feature_array[36] + feature_array[37] + feature_array[39] + feature_array[40] + feature_array[41] + feature_array[42] + feature_array[44] + feature_array[45] + feature_array[46] + feature_array[47] + feature_array[48] + feature_array[49] + feature_array[51] + feature_array[55] + feature_array[56] + feature_array[59] + feature_array[61] + feature_array[63] + feature_array[65] + feature_array[69] + feature_array[73] + feature_array[78] + feature_array[82] + feature_array[87] + feature_array[89] + feature_array[90] + feature_array[92] + feature_array[96] + feature_array[97] + feature_array[98] + feature_array[99] + feature_array[101] + feature_array[102] + feature_array[105] + feature_array[106] + feature_array[109] + feature_array[113] + feature_array[114] + feature_array[117] + feature_array[125];
    assign neg_21 = + feature_array[1] + feature_array[2] + feature_array[3] + feature_array[4] + feature_array[5] + feature_array[8] + feature_array[9] + feature_array[10] + feature_array[12] + feature_array[13] + feature_array[14] + feature_array[15] + feature_array[16] + feature_array[19] + feature_array[20] + feature_array[23] + feature_array[28] + feature_array[29] + feature_array[30] + feature_array[31] + feature_array[35] + feature_array[38] + feature_array[43] + feature_array[50] + feature_array[52] + feature_array[53] + feature_array[54] + feature_array[57] + feature_array[58] + feature_array[60] + feature_array[62] + feature_array[64] + feature_array[66] + feature_array[67] + feature_array[68] + feature_array[70] + feature_array[71] + feature_array[72] + feature_array[74] + feature_array[75] + feature_array[76] + feature_array[77] + feature_array[79] + feature_array[80] + feature_array[81] + feature_array[83] + feature_array[84] + feature_array[85] + feature_array[86] + feature_array[88] + feature_array[91] + feature_array[93] + feature_array[94] + feature_array[95] + feature_array[100] + feature_array[103] + feature_array[104] + feature_array[107] + feature_array[108] + feature_array[110] + feature_array[111] + feature_array[112] + feature_array[115] + feature_array[116] + feature_array[118] + feature_array[119] + feature_array[120] + feature_array[121] + feature_array[122] + feature_array[123] + feature_array[124] + feature_array[126] + feature_array[127];
    assign hidden[21] = pos_21 >= neg_21;

    wire unsigned [9:0] pos_22;
    wire unsigned [9:0] neg_22;
    assign pos_22 = + feature_array[1] + feature_array[4] + feature_array[7] + feature_array[8] + feature_array[11] + feature_array[12] + feature_array[13] + feature_array[14] + feature_array[16] + feature_array[18] + feature_array[20] + feature_array[21] + feature_array[22] + feature_array[23] + feature_array[25] + feature_array[30] + feature_array[33] + feature_array[34] + feature_array[35] + feature_array[36] + feature_array[38] + feature_array[39] + feature_array[41] + feature_array[43] + feature_array[45] + feature_array[46] + feature_array[49] + feature_array[51] + feature_array[52] + feature_array[53] + feature_array[54] + feature_array[56] + feature_array[63] + feature_array[64] + feature_array[65] + feature_array[67] + feature_array[68] + feature_array[69] + feature_array[71] + feature_array[73] + feature_array[74] + feature_array[75] + feature_array[76] + feature_array[77] + feature_array[79] + feature_array[81] + feature_array[82] + feature_array[88] + feature_array[89] + feature_array[90] + feature_array[91] + feature_array[92] + feature_array[93] + feature_array[95] + feature_array[97] + feature_array[99] + feature_array[101] + feature_array[103] + feature_array[105] + feature_array[107] + feature_array[108] + feature_array[112] + feature_array[114] + feature_array[119] + feature_array[122] + feature_array[124] + feature_array[125] + feature_array[127];
    assign neg_22 = + feature_array[0] + feature_array[2] + feature_array[3] + feature_array[5] + feature_array[6] + feature_array[9] + feature_array[10] + feature_array[15] + feature_array[17] + feature_array[19] + feature_array[24] + feature_array[26] + feature_array[27] + feature_array[28] + feature_array[29] + feature_array[31] + feature_array[32] + feature_array[37] + feature_array[40] + feature_array[42] + feature_array[44] + feature_array[47] + feature_array[48] + feature_array[50] + feature_array[55] + feature_array[57] + feature_array[58] + feature_array[59] + feature_array[60] + feature_array[61] + feature_array[62] + feature_array[66] + feature_array[70] + feature_array[72] + feature_array[78] + feature_array[80] + feature_array[83] + feature_array[84] + feature_array[85] + feature_array[86] + feature_array[87] + feature_array[94] + feature_array[96] + feature_array[98] + feature_array[100] + feature_array[102] + feature_array[104] + feature_array[106] + feature_array[109] + feature_array[110] + feature_array[111] + feature_array[113] + feature_array[115] + feature_array[116] + feature_array[117] + feature_array[118] + feature_array[120] + feature_array[121] + feature_array[123] + feature_array[126];
    assign hidden[22] = pos_22 >= neg_22;

    wire unsigned [9:0] pos_23;
    wire unsigned [9:0] neg_23;
    assign pos_23 = + feature_array[0] + feature_array[2] + feature_array[3] + feature_array[7] + feature_array[8] + feature_array[9] + feature_array[12] + feature_array[13] + feature_array[14] + feature_array[16] + feature_array[23] + feature_array[28] + feature_array[31] + feature_array[32] + feature_array[33] + feature_array[34] + feature_array[35] + feature_array[38] + feature_array[39] + feature_array[40] + feature_array[42] + feature_array[43] + feature_array[46] + feature_array[47] + feature_array[48] + feature_array[52] + feature_array[54] + feature_array[55] + feature_array[56] + feature_array[57] + feature_array[58] + feature_array[59] + feature_array[60] + feature_array[62] + feature_array[63] + feature_array[64] + feature_array[66] + feature_array[67] + feature_array[68] + feature_array[70] + feature_array[71] + feature_array[72] + feature_array[73] + feature_array[74] + feature_array[75] + feature_array[76] + feature_array[77] + feature_array[79] + feature_array[80] + feature_array[83] + feature_array[85] + feature_array[86] + feature_array[88] + feature_array[91] + feature_array[93] + feature_array[99] + feature_array[100] + feature_array[103] + feature_array[104] + feature_array[106] + feature_array[107] + feature_array[108] + feature_array[111] + feature_array[112] + feature_array[113] + feature_array[114] + feature_array[115] + feature_array[117] + feature_array[119] + feature_array[120] + feature_array[122] + feature_array[123] + feature_array[124];
    assign neg_23 = + feature_array[1] + feature_array[4] + feature_array[5] + feature_array[6] + feature_array[10] + feature_array[11] + feature_array[15] + feature_array[17] + feature_array[18] + feature_array[19] + feature_array[20] + feature_array[21] + feature_array[22] + feature_array[24] + feature_array[25] + feature_array[26] + feature_array[27] + feature_array[29] + feature_array[30] + feature_array[36] + feature_array[37] + feature_array[41] + feature_array[44] + feature_array[45] + feature_array[49] + feature_array[50] + feature_array[51] + feature_array[53] + feature_array[61] + feature_array[65] + feature_array[69] + feature_array[78] + feature_array[81] + feature_array[82] + feature_array[84] + feature_array[87] + feature_array[89] + feature_array[90] + feature_array[92] + feature_array[94] + feature_array[95] + feature_array[96] + feature_array[97] + feature_array[98] + feature_array[101] + feature_array[102] + feature_array[105] + feature_array[109] + feature_array[110] + feature_array[116] + feature_array[118] + feature_array[121] + feature_array[125] + feature_array[126] + feature_array[127];
    assign hidden[23] = pos_23 >= neg_23;

    wire unsigned [9:0] pos_24;
    wire unsigned [9:0] neg_24;
    assign pos_24 = + feature_array[1] + feature_array[2] + feature_array[3] + feature_array[4] + feature_array[5] + feature_array[13] + feature_array[15] + feature_array[16] + feature_array[17] + feature_array[18] + feature_array[19] + feature_array[20] + feature_array[21] + feature_array[23] + feature_array[25] + feature_array[27] + feature_array[29] + feature_array[32] + feature_array[33] + feature_array[35] + feature_array[38] + feature_array[39] + feature_array[43] + feature_array[45] + feature_array[46] + feature_array[49] + feature_array[51] + feature_array[52] + feature_array[59] + feature_array[60] + feature_array[61] + feature_array[62] + feature_array[64] + feature_array[71] + feature_array[72] + feature_array[73] + feature_array[75] + feature_array[76] + feature_array[77] + feature_array[78] + feature_array[79] + feature_array[81] + feature_array[82] + feature_array[83] + feature_array[84] + feature_array[86] + feature_array[87] + feature_array[91] + feature_array[92] + feature_array[94] + feature_array[95] + feature_array[99] + feature_array[100] + feature_array[105] + feature_array[108] + feature_array[109] + feature_array[110] + feature_array[111] + feature_array[112] + feature_array[113] + feature_array[114] + feature_array[115] + feature_array[116] + feature_array[121] + feature_array[122] + feature_array[123] + feature_array[124] + feature_array[125];
    assign neg_24 = + feature_array[0] + feature_array[6] + feature_array[7] + feature_array[8] + feature_array[9] + feature_array[10] + feature_array[11] + feature_array[12] + feature_array[14] + feature_array[22] + feature_array[24] + feature_array[26] + feature_array[28] + feature_array[30] + feature_array[31] + feature_array[34] + feature_array[36] + feature_array[37] + feature_array[40] + feature_array[41] + feature_array[42] + feature_array[44] + feature_array[47] + feature_array[48] + feature_array[50] + feature_array[53] + feature_array[54] + feature_array[55] + feature_array[56] + feature_array[57] + feature_array[58] + feature_array[63] + feature_array[65] + feature_array[66] + feature_array[67] + feature_array[68] + feature_array[69] + feature_array[70] + feature_array[74] + feature_array[80] + feature_array[85] + feature_array[88] + feature_array[89] + feature_array[90] + feature_array[93] + feature_array[96] + feature_array[97] + feature_array[98] + feature_array[101] + feature_array[102] + feature_array[103] + feature_array[104] + feature_array[106] + feature_array[107] + feature_array[117] + feature_array[118] + feature_array[119] + feature_array[120] + feature_array[126] + feature_array[127];
    assign hidden[24] = pos_24 >= neg_24;

    wire unsigned [9:0] pos_25;
    wire unsigned [9:0] neg_25;
    assign pos_25 = + feature_array[0] + feature_array[1] + feature_array[2] + feature_array[3] + feature_array[4] + feature_array[5] + feature_array[8] + feature_array[9] + feature_array[10] + feature_array[11] + feature_array[13] + feature_array[15] + feature_array[20] + feature_array[22] + feature_array[27] + feature_array[29] + feature_array[30] + feature_array[33] + feature_array[34] + feature_array[36] + feature_array[41] + feature_array[42] + feature_array[44] + feature_array[46] + feature_array[49] + feature_array[54] + feature_array[57] + feature_array[58] + feature_array[59] + feature_array[60] + feature_array[62] + feature_array[63] + feature_array[64] + feature_array[65] + feature_array[66] + feature_array[67] + feature_array[70] + feature_array[71] + feature_array[73] + feature_array[74] + feature_array[75] + feature_array[77] + feature_array[79] + feature_array[88] + feature_array[92] + feature_array[93] + feature_array[94] + feature_array[97] + feature_array[99] + feature_array[101] + feature_array[105] + feature_array[107] + feature_array[109] + feature_array[110] + feature_array[111] + feature_array[117] + feature_array[118] + feature_array[120] + feature_array[125] + feature_array[126];
    assign neg_25 = + feature_array[6] + feature_array[7] + feature_array[12] + feature_array[14] + feature_array[16] + feature_array[17] + feature_array[18] + feature_array[19] + feature_array[21] + feature_array[23] + feature_array[24] + feature_array[25] + feature_array[26] + feature_array[28] + feature_array[31] + feature_array[32] + feature_array[35] + feature_array[37] + feature_array[38] + feature_array[39] + feature_array[40] + feature_array[43] + feature_array[45] + feature_array[47] + feature_array[48] + feature_array[50] + feature_array[51] + feature_array[52] + feature_array[53] + feature_array[55] + feature_array[56] + feature_array[61] + feature_array[68] + feature_array[69] + feature_array[72] + feature_array[76] + feature_array[78] + feature_array[80] + feature_array[81] + feature_array[82] + feature_array[83] + feature_array[84] + feature_array[85] + feature_array[86] + feature_array[87] + feature_array[89] + feature_array[90] + feature_array[91] + feature_array[95] + feature_array[96] + feature_array[98] + feature_array[100] + feature_array[102] + feature_array[103] + feature_array[104] + feature_array[106] + feature_array[108] + feature_array[112] + feature_array[113] + feature_array[114] + feature_array[115] + feature_array[116] + feature_array[119] + feature_array[121] + feature_array[122] + feature_array[123] + feature_array[124] + feature_array[127];
    assign hidden[25] = pos_25 >= neg_25;

    wire unsigned [9:0] pos_26;
    wire unsigned [9:0] neg_26;
    assign pos_26 = + feature_array[0] + feature_array[1] + feature_array[2] + feature_array[3] + feature_array[4] + feature_array[6] + feature_array[7] + feature_array[10] + feature_array[11] + feature_array[15] + feature_array[18] + feature_array[20] + feature_array[21] + feature_array[23] + feature_array[27] + feature_array[28] + feature_array[33] + feature_array[34] + feature_array[35] + feature_array[37] + feature_array[38] + feature_array[42] + feature_array[43] + feature_array[45] + feature_array[46] + feature_array[47] + feature_array[49] + feature_array[51] + feature_array[54] + feature_array[55] + feature_array[58] + feature_array[60] + feature_array[62] + feature_array[63] + feature_array[64] + feature_array[65] + feature_array[66] + feature_array[67] + feature_array[68] + feature_array[69] + feature_array[70] + feature_array[71] + feature_array[72] + feature_array[73] + feature_array[74] + feature_array[75] + feature_array[77] + feature_array[85] + feature_array[91] + feature_array[92] + feature_array[94] + feature_array[95] + feature_array[98] + feature_array[99] + feature_array[100] + feature_array[103] + feature_array[106] + feature_array[107] + feature_array[108] + feature_array[109] + feature_array[114] + feature_array[115] + feature_array[116] + feature_array[117] + feature_array[118] + feature_array[122] + feature_array[123] + feature_array[124] + feature_array[127];
    assign neg_26 = + feature_array[5] + feature_array[8] + feature_array[9] + feature_array[12] + feature_array[13] + feature_array[14] + feature_array[16] + feature_array[17] + feature_array[19] + feature_array[22] + feature_array[24] + feature_array[25] + feature_array[26] + feature_array[29] + feature_array[30] + feature_array[31] + feature_array[32] + feature_array[36] + feature_array[39] + feature_array[40] + feature_array[41] + feature_array[44] + feature_array[48] + feature_array[50] + feature_array[52] + feature_array[53] + feature_array[56] + feature_array[57] + feature_array[59] + feature_array[61] + feature_array[76] + feature_array[78] + feature_array[79] + feature_array[80] + feature_array[81] + feature_array[82] + feature_array[83] + feature_array[84] + feature_array[86] + feature_array[87] + feature_array[88] + feature_array[89] + feature_array[90] + feature_array[93] + feature_array[96] + feature_array[97] + feature_array[101] + feature_array[102] + feature_array[104] + feature_array[105] + feature_array[110] + feature_array[111] + feature_array[112] + feature_array[113] + feature_array[119] + feature_array[120] + feature_array[121] + feature_array[125] + feature_array[126];
    assign hidden[26] = pos_26 >= neg_26;

    wire unsigned [9:0] pos_27;
    wire unsigned [9:0] neg_27;
    assign pos_27 = + feature_array[0] + feature_array[1] + feature_array[2] + feature_array[3] + feature_array[4] + feature_array[6] + feature_array[7] + feature_array[8] + feature_array[9] + feature_array[10] + feature_array[11] + feature_array[12] + feature_array[13] + feature_array[14] + feature_array[15] + feature_array[17] + feature_array[19] + feature_array[22] + feature_array[23] + feature_array[24] + feature_array[25] + feature_array[27] + feature_array[28] + feature_array[29] + feature_array[30] + feature_array[31] + feature_array[33] + feature_array[35] + feature_array[37] + feature_array[39] + feature_array[41] + feature_array[45] + feature_array[49] + feature_array[50] + feature_array[51] + feature_array[52] + feature_array[53] + feature_array[56] + feature_array[57] + feature_array[58] + feature_array[59] + feature_array[60] + feature_array[61] + feature_array[62] + feature_array[64] + feature_array[65] + feature_array[66] + feature_array[67] + feature_array[68] + feature_array[69] + feature_array[71] + feature_array[72] + feature_array[73] + feature_array[74] + feature_array[75] + feature_array[76] + feature_array[80] + feature_array[81] + feature_array[82] + feature_array[83] + feature_array[88] + feature_array[89] + feature_array[91] + feature_array[92] + feature_array[95] + feature_array[99] + feature_array[100] + feature_array[102] + feature_array[107] + feature_array[112] + feature_array[113] + feature_array[114] + feature_array[115] + feature_array[116] + feature_array[118] + feature_array[119] + feature_array[120] + feature_array[121] + feature_array[122] + feature_array[123] + feature_array[124] + feature_array[127];
    assign neg_27 = + feature_array[5] + feature_array[16] + feature_array[18] + feature_array[20] + feature_array[21] + feature_array[26] + feature_array[32] + feature_array[34] + feature_array[36] + feature_array[38] + feature_array[40] + feature_array[42] + feature_array[43] + feature_array[44] + feature_array[46] + feature_array[47] + feature_array[48] + feature_array[54] + feature_array[55] + feature_array[63] + feature_array[70] + feature_array[77] + feature_array[78] + feature_array[79] + feature_array[84] + feature_array[85] + feature_array[86] + feature_array[87] + feature_array[90] + feature_array[93] + feature_array[94] + feature_array[96] + feature_array[97] + feature_array[98] + feature_array[101] + feature_array[103] + feature_array[104] + feature_array[105] + feature_array[106] + feature_array[108] + feature_array[109] + feature_array[110] + feature_array[111] + feature_array[117] + feature_array[125] + feature_array[126];
    assign hidden[27] = pos_27 >= neg_27;

    wire unsigned [9:0] pos_28;
    wire unsigned [9:0] neg_28;
    assign pos_28 = + feature_array[1] + feature_array[4] + feature_array[7] + feature_array[8] + feature_array[9] + feature_array[11] + feature_array[12] + feature_array[14] + feature_array[15] + feature_array[16] + feature_array[18] + feature_array[20] + feature_array[23] + feature_array[24] + feature_array[25] + feature_array[26] + feature_array[31] + feature_array[32] + feature_array[33] + feature_array[37] + feature_array[38] + feature_array[39] + feature_array[40] + feature_array[41] + feature_array[44] + feature_array[55] + feature_array[56] + feature_array[61] + feature_array[62] + feature_array[66] + feature_array[68] + feature_array[69] + feature_array[70] + feature_array[71] + feature_array[78] + feature_array[79] + feature_array[80] + feature_array[85] + feature_array[89] + feature_array[94] + feature_array[95] + feature_array[97] + feature_array[101] + feature_array[102] + feature_array[104] + feature_array[112] + feature_array[117] + feature_array[120] + feature_array[125] + feature_array[126];
    assign neg_28 = + feature_array[0] + feature_array[2] + feature_array[3] + feature_array[5] + feature_array[6] + feature_array[10] + feature_array[13] + feature_array[17] + feature_array[19] + feature_array[21] + feature_array[22] + feature_array[27] + feature_array[28] + feature_array[29] + feature_array[30] + feature_array[34] + feature_array[35] + feature_array[36] + feature_array[42] + feature_array[43] + feature_array[45] + feature_array[46] + feature_array[47] + feature_array[48] + feature_array[49] + feature_array[50] + feature_array[51] + feature_array[52] + feature_array[53] + feature_array[54] + feature_array[57] + feature_array[58] + feature_array[59] + feature_array[60] + feature_array[63] + feature_array[64] + feature_array[65] + feature_array[67] + feature_array[72] + feature_array[73] + feature_array[74] + feature_array[75] + feature_array[76] + feature_array[77] + feature_array[81] + feature_array[82] + feature_array[83] + feature_array[84] + feature_array[86] + feature_array[87] + feature_array[88] + feature_array[90] + feature_array[91] + feature_array[92] + feature_array[93] + feature_array[96] + feature_array[98] + feature_array[99] + feature_array[100] + feature_array[103] + feature_array[105] + feature_array[106] + feature_array[107] + feature_array[108] + feature_array[109] + feature_array[110] + feature_array[111] + feature_array[113] + feature_array[114] + feature_array[115] + feature_array[116] + feature_array[118] + feature_array[119] + feature_array[121] + feature_array[122] + feature_array[123] + feature_array[124] + feature_array[127];
    assign hidden[28] = pos_28 >= neg_28;

    wire unsigned [9:0] pos_29;
    wire unsigned [9:0] neg_29;
    assign pos_29 = + feature_array[0] + feature_array[1] + feature_array[2] + feature_array[3] + feature_array[4] + feature_array[6] + feature_array[7] + feature_array[8] + feature_array[10] + feature_array[11] + feature_array[12] + feature_array[15] + feature_array[16] + feature_array[20] + feature_array[21] + feature_array[23] + feature_array[24] + feature_array[28] + feature_array[29] + feature_array[34] + feature_array[35] + feature_array[38] + feature_array[40] + feature_array[41] + feature_array[42] + feature_array[43] + feature_array[45] + feature_array[46] + feature_array[47] + feature_array[48] + feature_array[49] + feature_array[52] + feature_array[53] + feature_array[56] + feature_array[57] + feature_array[58] + feature_array[59] + feature_array[60] + feature_array[64] + feature_array[65] + feature_array[66] + feature_array[67] + feature_array[68] + feature_array[70] + feature_array[72] + feature_array[73] + feature_array[74] + feature_array[75] + feature_array[76] + feature_array[77] + feature_array[79] + feature_array[80] + feature_array[85] + feature_array[86] + feature_array[93] + feature_array[96] + feature_array[98] + feature_array[99] + feature_array[100] + feature_array[102] + feature_array[104] + feature_array[105] + feature_array[106] + feature_array[107] + feature_array[108] + feature_array[117] + feature_array[118] + feature_array[119] + feature_array[125] + feature_array[126];
    assign neg_29 = + feature_array[5] + feature_array[9] + feature_array[13] + feature_array[14] + feature_array[17] + feature_array[18] + feature_array[19] + feature_array[22] + feature_array[25] + feature_array[26] + feature_array[27] + feature_array[30] + feature_array[31] + feature_array[32] + feature_array[33] + feature_array[36] + feature_array[37] + feature_array[39] + feature_array[44] + feature_array[50] + feature_array[51] + feature_array[54] + feature_array[55] + feature_array[61] + feature_array[62] + feature_array[63] + feature_array[69] + feature_array[71] + feature_array[78] + feature_array[81] + feature_array[82] + feature_array[83] + feature_array[84] + feature_array[87] + feature_array[88] + feature_array[89] + feature_array[90] + feature_array[91] + feature_array[92] + feature_array[94] + feature_array[95] + feature_array[97] + feature_array[101] + feature_array[103] + feature_array[109] + feature_array[110] + feature_array[111] + feature_array[112] + feature_array[113] + feature_array[114] + feature_array[115] + feature_array[116] + feature_array[120] + feature_array[121] + feature_array[122] + feature_array[123] + feature_array[124] + feature_array[127];
    assign hidden[29] = pos_29 >= neg_29;

    wire unsigned [9:0] pos_30;
    wire unsigned [9:0] neg_30;
    assign pos_30 = + feature_array[1] + feature_array[5] + feature_array[6] + feature_array[12] + feature_array[15] + feature_array[16] + feature_array[17] + feature_array[18] + feature_array[19] + feature_array[21] + feature_array[23] + feature_array[24] + feature_array[25] + feature_array[26] + feature_array[27] + feature_array[29] + feature_array[30] + feature_array[31] + feature_array[32] + feature_array[34] + feature_array[37] + feature_array[39] + feature_array[40] + feature_array[42] + feature_array[44] + feature_array[49] + feature_array[50] + feature_array[57] + feature_array[61] + feature_array[62] + feature_array[69] + feature_array[77] + feature_array[78] + feature_array[82] + feature_array[86] + feature_array[89] + feature_array[94] + feature_array[96] + feature_array[97] + feature_array[98] + feature_array[104] + feature_array[105] + feature_array[106] + feature_array[110] + feature_array[111] + feature_array[112] + feature_array[117] + feature_array[119] + feature_array[125] + feature_array[127];
    assign neg_30 = + feature_array[0] + feature_array[2] + feature_array[3] + feature_array[4] + feature_array[7] + feature_array[8] + feature_array[9] + feature_array[10] + feature_array[11] + feature_array[13] + feature_array[14] + feature_array[20] + feature_array[22] + feature_array[28] + feature_array[33] + feature_array[35] + feature_array[36] + feature_array[38] + feature_array[41] + feature_array[43] + feature_array[45] + feature_array[46] + feature_array[47] + feature_array[48] + feature_array[51] + feature_array[52] + feature_array[53] + feature_array[54] + feature_array[55] + feature_array[56] + feature_array[58] + feature_array[59] + feature_array[60] + feature_array[63] + feature_array[64] + feature_array[65] + feature_array[66] + feature_array[67] + feature_array[68] + feature_array[70] + feature_array[71] + feature_array[72] + feature_array[73] + feature_array[74] + feature_array[75] + feature_array[76] + feature_array[79] + feature_array[80] + feature_array[81] + feature_array[83] + feature_array[84] + feature_array[85] + feature_array[87] + feature_array[88] + feature_array[90] + feature_array[91] + feature_array[92] + feature_array[93] + feature_array[95] + feature_array[99] + feature_array[100] + feature_array[101] + feature_array[102] + feature_array[103] + feature_array[107] + feature_array[108] + feature_array[109] + feature_array[113] + feature_array[114] + feature_array[115] + feature_array[116] + feature_array[118] + feature_array[120] + feature_array[121] + feature_array[122] + feature_array[123] + feature_array[124] + feature_array[126];
    assign hidden[30] = pos_30 >= neg_30;

    wire unsigned [9:0] pos_31;
    wire unsigned [8:0] neg_31;
    assign pos_31 = + feature_array[0] + feature_array[1] + feature_array[2] + feature_array[3] + feature_array[4] + feature_array[6] + feature_array[8] + feature_array[9] + feature_array[10] + feature_array[11] + feature_array[12] + feature_array[15] + feature_array[16] + feature_array[19] + feature_array[20] + feature_array[21] + feature_array[23] + feature_array[28] + feature_array[29] + feature_array[30] + feature_array[31] + feature_array[33] + feature_array[35] + feature_array[36] + feature_array[38] + feature_array[39] + feature_array[41] + feature_array[43] + feature_array[48] + feature_array[49] + feature_array[51] + feature_array[52] + feature_array[53] + feature_array[54] + feature_array[55] + feature_array[56] + feature_array[57] + feature_array[60] + feature_array[61] + feature_array[64] + feature_array[66] + feature_array[67] + feature_array[68] + feature_array[69] + feature_array[70] + feature_array[71] + feature_array[72] + feature_array[73] + feature_array[74] + feature_array[75] + feature_array[76] + feature_array[77] + feature_array[78] + feature_array[79] + feature_array[82] + feature_array[86] + feature_array[87] + feature_array[88] + feature_array[89] + feature_array[90] + feature_array[91] + feature_array[93] + feature_array[96] + feature_array[98] + feature_array[99] + feature_array[100] + feature_array[102] + feature_array[103] + feature_array[107] + feature_array[108] + feature_array[110] + feature_array[111] + feature_array[112] + feature_array[114] + feature_array[115] + feature_array[117] + feature_array[118] + feature_array[121] + feature_array[123] + feature_array[124] + feature_array[126] + feature_array[127];
    assign neg_31 = + feature_array[5] + feature_array[7] + feature_array[13] + feature_array[14] + feature_array[17] + feature_array[18] + feature_array[22] + feature_array[24] + feature_array[25] + feature_array[26] + feature_array[27] + feature_array[32] + feature_array[34] + feature_array[37] + feature_array[40] + feature_array[42] + feature_array[44] + feature_array[45] + feature_array[46] + feature_array[47] + feature_array[50] + feature_array[58] + feature_array[59] + feature_array[62] + feature_array[63] + feature_array[65] + feature_array[80] + feature_array[81] + feature_array[83] + feature_array[84] + feature_array[85] + feature_array[92] + feature_array[94] + feature_array[95] + feature_array[97] + feature_array[101] + feature_array[104] + feature_array[105] + feature_array[106] + feature_array[109] + feature_array[113] + feature_array[116] + feature_array[119] + feature_array[120] + feature_array[122] + feature_array[125];
    assign hidden[31] = pos_31 >= neg_31;

    wire unsigned [9:0] pos_32;
    wire unsigned [9:0] neg_32;
    assign pos_32 = + feature_array[1] + feature_array[2] + feature_array[5] + feature_array[7] + feature_array[8] + feature_array[9] + feature_array[10] + feature_array[11] + feature_array[12] + feature_array[16] + feature_array[18] + feature_array[19] + feature_array[22] + feature_array[23] + feature_array[24] + feature_array[26] + feature_array[30] + feature_array[32] + feature_array[33] + feature_array[36] + feature_array[37] + feature_array[38] + feature_array[39] + feature_array[40] + feature_array[48] + feature_array[49] + feature_array[56] + feature_array[61] + feature_array[63] + feature_array[64] + feature_array[68] + feature_array[69] + feature_array[70] + feature_array[76] + feature_array[77] + feature_array[78] + feature_array[79] + feature_array[80] + feature_array[87] + feature_array[88] + feature_array[94] + feature_array[95] + feature_array[96] + feature_array[102] + feature_array[104] + feature_array[106] + feature_array[109] + feature_array[110] + feature_array[112] + feature_array[114] + feature_array[118] + feature_array[120] + feature_array[125];
    assign neg_32 = + feature_array[0] + feature_array[3] + feature_array[4] + feature_array[6] + feature_array[13] + feature_array[14] + feature_array[15] + feature_array[17] + feature_array[20] + feature_array[21] + feature_array[25] + feature_array[27] + feature_array[28] + feature_array[29] + feature_array[31] + feature_array[34] + feature_array[35] + feature_array[41] + feature_array[42] + feature_array[43] + feature_array[44] + feature_array[45] + feature_array[46] + feature_array[47] + feature_array[50] + feature_array[51] + feature_array[52] + feature_array[53] + feature_array[54] + feature_array[55] + feature_array[57] + feature_array[58] + feature_array[59] + feature_array[60] + feature_array[62] + feature_array[65] + feature_array[66] + feature_array[67] + feature_array[71] + feature_array[72] + feature_array[73] + feature_array[74] + feature_array[75] + feature_array[81] + feature_array[82] + feature_array[83] + feature_array[84] + feature_array[85] + feature_array[86] + feature_array[89] + feature_array[90] + feature_array[91] + feature_array[92] + feature_array[93] + feature_array[97] + feature_array[98] + feature_array[99] + feature_array[100] + feature_array[101] + feature_array[103] + feature_array[105] + feature_array[107] + feature_array[108] + feature_array[111] + feature_array[113] + feature_array[115] + feature_array[116] + feature_array[117] + feature_array[119] + feature_array[121] + feature_array[122] + feature_array[123] + feature_array[124] + feature_array[126] + feature_array[127];
    assign hidden[32] = pos_32 >= neg_32;

    wire unsigned [9:0] pos_33;
    wire unsigned [9:0] neg_33;
    assign pos_33 = + feature_array[1] + feature_array[2] + feature_array[3] + feature_array[4] + feature_array[5] + feature_array[6] + feature_array[7] + feature_array[8] + feature_array[9] + feature_array[10] + feature_array[11] + feature_array[12] + feature_array[14] + feature_array[17] + feature_array[19] + feature_array[21] + feature_array[22] + feature_array[23] + feature_array[24] + feature_array[29] + feature_array[31] + feature_array[33] + feature_array[36] + feature_array[37] + feature_array[44] + feature_array[45] + feature_array[46] + feature_array[47] + feature_array[55] + feature_array[57] + feature_array[58] + feature_array[61] + feature_array[63] + feature_array[64] + feature_array[65] + feature_array[67] + feature_array[68] + feature_array[71] + feature_array[78] + feature_array[80] + feature_array[81] + feature_array[85] + feature_array[86] + feature_array[88] + feature_array[89] + feature_array[92] + feature_array[93] + feature_array[96] + feature_array[97] + feature_array[102] + feature_array[104] + feature_array[109] + feature_array[111] + feature_array[121] + feature_array[124] + feature_array[127];
    assign neg_33 = + feature_array[0] + feature_array[13] + feature_array[15] + feature_array[16] + feature_array[18] + feature_array[20] + feature_array[25] + feature_array[26] + feature_array[27] + feature_array[28] + feature_array[30] + feature_array[32] + feature_array[34] + feature_array[35] + feature_array[38] + feature_array[39] + feature_array[40] + feature_array[41] + feature_array[42] + feature_array[43] + feature_array[48] + feature_array[49] + feature_array[50] + feature_array[51] + feature_array[52] + feature_array[53] + feature_array[54] + feature_array[56] + feature_array[59] + feature_array[60] + feature_array[62] + feature_array[66] + feature_array[69] + feature_array[70] + feature_array[72] + feature_array[73] + feature_array[74] + feature_array[75] + feature_array[76] + feature_array[77] + feature_array[79] + feature_array[82] + feature_array[83] + feature_array[84] + feature_array[87] + feature_array[90] + feature_array[91] + feature_array[94] + feature_array[95] + feature_array[98] + feature_array[99] + feature_array[100] + feature_array[101] + feature_array[103] + feature_array[105] + feature_array[106] + feature_array[107] + feature_array[108] + feature_array[110] + feature_array[112] + feature_array[113] + feature_array[114] + feature_array[115] + feature_array[116] + feature_array[117] + feature_array[118] + feature_array[119] + feature_array[120] + feature_array[122] + feature_array[123] + feature_array[125] + feature_array[126];
    assign hidden[33] = pos_33 >= neg_33;

    wire unsigned [9:0] pos_34;
    wire unsigned [9:0] neg_34;
    assign pos_34 = + feature_array[5] + feature_array[6] + feature_array[14] + feature_array[15] + feature_array[18] + feature_array[20] + feature_array[23] + feature_array[25] + feature_array[27] + feature_array[28] + feature_array[31] + feature_array[34] + feature_array[35] + feature_array[37] + feature_array[38] + feature_array[40] + feature_array[41] + feature_array[42] + feature_array[43] + feature_array[44] + feature_array[47] + feature_array[49] + feature_array[50] + feature_array[51] + feature_array[52] + feature_array[54] + feature_array[57] + feature_array[58] + feature_array[59] + feature_array[60] + feature_array[63] + feature_array[65] + feature_array[70] + feature_array[71] + feature_array[73] + feature_array[75] + feature_array[77] + feature_array[78] + feature_array[83] + feature_array[84] + feature_array[85] + feature_array[86] + feature_array[87] + feature_array[90] + feature_array[92] + feature_array[93] + feature_array[94] + feature_array[95] + feature_array[97] + feature_array[99] + feature_array[100] + feature_array[103] + feature_array[104] + feature_array[105] + feature_array[106] + feature_array[107] + feature_array[108] + feature_array[110] + feature_array[114] + feature_array[115] + feature_array[116] + feature_array[119] + feature_array[123] + feature_array[124] + feature_array[127];
    assign neg_34 = + feature_array[0] + feature_array[1] + feature_array[2] + feature_array[3] + feature_array[4] + feature_array[7] + feature_array[8] + feature_array[9] + feature_array[10] + feature_array[11] + feature_array[12] + feature_array[13] + feature_array[16] + feature_array[17] + feature_array[19] + feature_array[21] + feature_array[22] + feature_array[24] + feature_array[26] + feature_array[29] + feature_array[30] + feature_array[32] + feature_array[33] + feature_array[36] + feature_array[39] + feature_array[45] + feature_array[46] + feature_array[48] + feature_array[53] + feature_array[55] + feature_array[56] + feature_array[61] + feature_array[62] + feature_array[64] + feature_array[66] + feature_array[67] + feature_array[68] + feature_array[69] + feature_array[72] + feature_array[74] + feature_array[76] + feature_array[79] + feature_array[80] + feature_array[81] + feature_array[82] + feature_array[88] + feature_array[89] + feature_array[91] + feature_array[96] + feature_array[98] + feature_array[101] + feature_array[102] + feature_array[109] + feature_array[111] + feature_array[112] + feature_array[113] + feature_array[117] + feature_array[118] + feature_array[120] + feature_array[121] + feature_array[122] + feature_array[125] + feature_array[126];
    assign hidden[34] = pos_34 >= neg_34;

    wire unsigned [9:0] pos_35;
    wire unsigned [9:0] neg_35;
    assign pos_35 = + feature_array[0] + feature_array[2] + feature_array[5] + feature_array[7] + feature_array[8] + feature_array[9] + feature_array[10] + feature_array[11] + feature_array[12] + feature_array[14] + feature_array[16] + feature_array[17] + feature_array[22] + feature_array[23] + feature_array[25] + feature_array[26] + feature_array[28] + feature_array[31] + feature_array[32] + feature_array[33] + feature_array[36] + feature_array[37] + feature_array[38] + feature_array[39] + feature_array[44] + feature_array[45] + feature_array[46] + feature_array[47] + feature_array[48] + feature_array[49] + feature_array[54] + feature_array[55] + feature_array[64] + feature_array[66] + feature_array[67] + feature_array[68] + feature_array[69] + feature_array[70] + feature_array[71] + feature_array[72] + feature_array[74] + feature_array[75] + feature_array[76] + feature_array[77] + feature_array[78] + feature_array[79] + feature_array[81] + feature_array[82] + feature_array[84] + feature_array[90] + feature_array[96] + feature_array[102] + feature_array[103] + feature_array[112] + feature_array[117] + feature_array[121] + feature_array[122] + feature_array[125] + feature_array[126];
    assign neg_35 = + feature_array[1] + feature_array[3] + feature_array[4] + feature_array[6] + feature_array[13] + feature_array[15] + feature_array[18] + feature_array[19] + feature_array[20] + feature_array[21] + feature_array[24] + feature_array[27] + feature_array[29] + feature_array[30] + feature_array[34] + feature_array[35] + feature_array[40] + feature_array[41] + feature_array[42] + feature_array[43] + feature_array[50] + feature_array[51] + feature_array[52] + feature_array[53] + feature_array[56] + feature_array[57] + feature_array[58] + feature_array[59] + feature_array[60] + feature_array[61] + feature_array[62] + feature_array[63] + feature_array[65] + feature_array[73] + feature_array[80] + feature_array[83] + feature_array[85] + feature_array[86] + feature_array[87] + feature_array[88] + feature_array[89] + feature_array[91] + feature_array[92] + feature_array[93] + feature_array[94] + feature_array[95] + feature_array[97] + feature_array[98] + feature_array[99] + feature_array[100] + feature_array[101] + feature_array[104] + feature_array[105] + feature_array[106] + feature_array[107] + feature_array[108] + feature_array[109] + feature_array[110] + feature_array[111] + feature_array[113] + feature_array[114] + feature_array[115] + feature_array[116] + feature_array[118] + feature_array[119] + feature_array[120] + feature_array[123] + feature_array[124] + feature_array[127];
    assign hidden[35] = pos_35 >= neg_35;

    wire unsigned [9:0] pos_36;
    wire unsigned [9:0] neg_36;
    assign pos_36 = + feature_array[0] + feature_array[4] + feature_array[8] + feature_array[12] + feature_array[13] + feature_array[14] + feature_array[21] + feature_array[23] + feature_array[25] + feature_array[27] + feature_array[28] + feature_array[30] + feature_array[31] + feature_array[33] + feature_array[36] + feature_array[38] + feature_array[39] + feature_array[40] + feature_array[41] + feature_array[44] + feature_array[49] + feature_array[53] + feature_array[54] + feature_array[55] + feature_array[57] + feature_array[62] + feature_array[65] + feature_array[67] + feature_array[71] + feature_array[72] + feature_array[73] + feature_array[74] + feature_array[75] + feature_array[77] + feature_array[80] + feature_array[81] + feature_array[82] + feature_array[85] + feature_array[87] + feature_array[88] + feature_array[91] + feature_array[93] + feature_array[95] + feature_array[96] + feature_array[97] + feature_array[99] + feature_array[100] + feature_array[103] + feature_array[104] + feature_array[105] + feature_array[106] + feature_array[108] + feature_array[110] + feature_array[111] + feature_array[112] + feature_array[113] + feature_array[116] + feature_array[117] + feature_array[123] + feature_array[124] + feature_array[125];
    assign neg_36 = + feature_array[1] + feature_array[2] + feature_array[3] + feature_array[5] + feature_array[6] + feature_array[7] + feature_array[9] + feature_array[10] + feature_array[11] + feature_array[15] + feature_array[16] + feature_array[17] + feature_array[18] + feature_array[19] + feature_array[20] + feature_array[22] + feature_array[24] + feature_array[26] + feature_array[29] + feature_array[32] + feature_array[34] + feature_array[35] + feature_array[37] + feature_array[42] + feature_array[43] + feature_array[45] + feature_array[46] + feature_array[47] + feature_array[48] + feature_array[50] + feature_array[51] + feature_array[52] + feature_array[56] + feature_array[58] + feature_array[59] + feature_array[60] + feature_array[61] + feature_array[63] + feature_array[64] + feature_array[66] + feature_array[68] + feature_array[69] + feature_array[70] + feature_array[76] + feature_array[78] + feature_array[79] + feature_array[83] + feature_array[84] + feature_array[86] + feature_array[89] + feature_array[90] + feature_array[92] + feature_array[94] + feature_array[98] + feature_array[101] + feature_array[102] + feature_array[107] + feature_array[109] + feature_array[114] + feature_array[115] + feature_array[118] + feature_array[119] + feature_array[120] + feature_array[121] + feature_array[122] + feature_array[126] + feature_array[127];
    assign hidden[36] = pos_36 >= neg_36;

    wire unsigned [9:0] pos_37;
    wire unsigned [9:0] neg_37;
    assign pos_37 = + feature_array[0] + feature_array[2] + feature_array[3] + feature_array[4] + feature_array[7] + feature_array[8] + feature_array[9] + feature_array[10] + feature_array[11] + feature_array[12] + feature_array[13] + feature_array[19] + feature_array[20] + feature_array[22] + feature_array[23] + feature_array[25] + feature_array[27] + feature_array[29] + feature_array[31] + feature_array[33] + feature_array[35] + feature_array[41] + feature_array[44] + feature_array[45] + feature_array[46] + feature_array[47] + feature_array[48] + feature_array[49] + feature_array[52] + feature_array[54] + feature_array[58] + feature_array[59] + feature_array[60] + feature_array[64] + feature_array[65] + feature_array[66] + feature_array[67] + feature_array[68] + feature_array[69] + feature_array[70] + feature_array[71] + feature_array[72] + feature_array[73] + feature_array[74] + feature_array[75] + feature_array[76] + feature_array[77] + feature_array[79] + feature_array[80] + feature_array[81] + feature_array[82] + feature_array[83] + feature_array[84] + feature_array[85] + feature_array[86] + feature_array[87] + feature_array[89] + feature_array[90] + feature_array[91] + feature_array[93] + feature_array[94] + feature_array[100] + feature_array[101] + feature_array[103] + feature_array[107] + feature_array[108] + feature_array[109] + feature_array[112] + feature_array[113] + feature_array[114] + feature_array[115] + feature_array[116] + feature_array[118] + feature_array[119] + feature_array[120] + feature_array[121] + feature_array[122] + feature_array[123] + feature_array[124];
    assign neg_37 = + feature_array[1] + feature_array[5] + feature_array[6] + feature_array[14] + feature_array[15] + feature_array[16] + feature_array[17] + feature_array[18] + feature_array[21] + feature_array[24] + feature_array[26] + feature_array[28] + feature_array[30] + feature_array[32] + feature_array[34] + feature_array[36] + feature_array[37] + feature_array[38] + feature_array[39] + feature_array[40] + feature_array[42] + feature_array[43] + feature_array[50] + feature_array[51] + feature_array[53] + feature_array[55] + feature_array[56] + feature_array[57] + feature_array[61] + feature_array[62] + feature_array[63] + feature_array[78] + feature_array[88] + feature_array[92] + feature_array[95] + feature_array[96] + feature_array[97] + feature_array[98] + feature_array[99] + feature_array[102] + feature_array[104] + feature_array[105] + feature_array[106] + feature_array[110] + feature_array[111] + feature_array[117] + feature_array[125] + feature_array[126] + feature_array[127];
    assign hidden[37] = pos_37 >= neg_37;
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
