cyberseihis/bnnprint/(commit log)

2022-11-21 Prototype of bnorm passed first test vs larq
2022-11-23 Hdl printer for xnor layer(untested)
2022-11-24 Xnor-Popcount printer
2023-02-07 Starting to compile all datasets
    [HarData.csv, HarLabels.csv, cardio.csv, pendigits.csv, winequality-red.csv, winequality-white.csv]
2023-02-07 Cleaned datasets
    [arrhythmia.csv, winequality-red.csv, winequality-white.csv]
2023-02-07 Small cleanup
    [Har.csv, HarData.csv, HarLabels.csv, pendigits.csv]
2023-02-08 Removed almost empty classes 7 and 8 from arrhythmia
    [arrhythmia.csv]
2023-02-08 Normalised labels from 0-n
    [Har.csv, arrhythmia.csv, cardio.csv, winequality-red.csv, winequality-white.csv]
2023-02-23 Failed attempt at non-recersive argmax
    [argmax.v]
2023-03-05 Cleaned useless debug prints
2023-03-05 Fixed argmax a bit
    [argmax.v, tbmred.v]
2023-03-08 Results of bnn models for each sample in dataset
2023-03-09 Start of rewrite of parallel printer
2023-03-10 Demo run of bnn printerv2
2023-03-10 Trying the printscripts output
2023-03-11 Failed attempts at changing printed output
    [bndemo.v]
2023-03-11 Trying to print operations for each sign seperately
2023-03-11 Printed paralel bnn tested working, input was just reverse
    [bndemo.v]
2023-03-11 Comparing undeclared sums failed
    [bndemo.v]
2023-03-11 Revert "Comparing undeclared sums failed"
    This reverts commit a7ec9ba8303981f5b5cec1836271d401fe5b73ad.
    [bndemo.v]
2023-03-11 Bndemo split to importfile, core, tb. Bug in argmax fixed
    [tbparams.txt]
2023-03-11 Standalone tbbnn built
    [tbparams.txt]
2023-03-11 Dumped bnn prints, removed arrhythmia files
2023-03-11 Sample run of iverilog command with remote sources
2023-03-13 Fixed printed seq bnns having submodules in same file
    [dump.py]
2023-03-15 Draft of printscript for paralel tnns
2023-03-15 Prints for paralel tnns
2023-03-17 Changed how empty sides work, changed klass printing
2023-03-19 Fixed parallel tnn by adding constant term to popcount
    [tbtndemo.v, tndemo.v]
2023-03-23 Spreadsheet with first numbers. Seq bnn is fine btw just a tie
    [stats.csv]
2023-03-23 First layer of seq tnn correct for a wine sample
2023-03-23 Tnn seq xnor layer selects wires correctly, adds them wrong
2023-03-27 xnortseqq bug fixed, layer correct for 1st whitewine sample
2023-03-28 Hardcoded entire seq tnn passes first sample test
2023-03-28 Parameterised tbseqtnn, correct class first 5 whitewine
    [tblook.v]
2023-03-30 Changed printing class in seq bnn to be in one line
2023-03-30 Printing 5 classes in one line in seqtnn
2023-03-30 Renamed variables in paralel bnns
    [winequality_red.csv, winequality_white.csv]
2023-04-01 Snipping some features. Wines dont seem to work Im doing something wrong
    [less_Har.csv, less_cardio.csv, less_gasId.csv, less_pendigits.csv, less_winequality_red.csv, less_winequality_white.csv, stats.csv]
2023-04-02 Updated with more legit columns
    [less_cardio.csv, less_gasId.csv, less_pendigits.csv, less_winequality_red.csv, less_winequality_white.csv]
2023-04-02 Updated spreadsheet with rfe accuracies
    [stats.csv]
2023-04-03 Replaced dump.py with .sh in tnns, cleaned files
    [dump.py]
2023-04-06 Added space to testresult printing
2023-04-17 Added csv from server
    [arg_results.csv]
2023-04-17 Using 1000 samples in tb instead of 5
2023-04-19 Renamed wines
    [less_winered.csv, less_winewhite.csv, winered.csv, winewhite.csv]
2023-04-19 renamed design folders to avoid underscores
    [accumulator.v, binthresh.v, first_layer.v, seq_bnn.v, tbgasId_bp.v]
2023-04-21 Attempt to change direction to standard, found bug in tnnseq
    [Har_bnn1_bnnpar.v, cardio_bnn1_bnnpar.v, gasId_bnn1_bnnpar.v, modular_bnnpar.v, modular_tnnpar.v, pendigits_bnn1_bnnpar.v, tbHar_bnn1_bnnpar.v]
2023-04-22 Renaming and dumping samples in correct direction
2023-04-22 Bnnpar now reads samples from file
2023-04-22 All simulations now done with sample files
2023-04-22 Results on 1000 samples
    [results1k.csv]
2023-04-22 Failed start at direct first layer of bnnseq
    [Har_bnn1_bnndirect.v, accumulator.v, binthresh.v, cardio_bnn1_bnndirect.v, first_layer.v, gasId_bnn1_bnndirect.v, pendigits_bnn1_bnndirect.v, seq_bnn.v]
2023-04-23 Fixed a vector length in hybrid direct layer1 input
    [first_layer.v]
2023-04-23 Split sw0 in pos/neg and first/second output val per sample
2023-04-24 Results for different implementations of bnnseq.Direct wins except for gas where shift wins
    [alt_bnnseq_results.csv, arg_results.csv, results1k.csv, stats.csv]
2023-04-25 Stats cleanup
    [260423_results.csv, alt_bnnseq_results.csv, arg_results.csv, results1k.csv]
2023-04-25 Script to plot area/power results
2023-04-26 Quick draft of creating wire with only samples in mask
2023-04-27 Direct tnnseq with unused features set to 0 foreach custom sample
2023-04-27 Bistring print script prints minwidths
2023-04-29 Function to check which samples error if a bit increases
2023-05-01 Recent results
    [020523_results.csv]
2023-05-03 Bnnroll with bit flipping instead of arithmetic negation in custom input
    [binthresh.v, modular_bnnrolin.v]
2023-05-04 Results after proper timing(I think)
    [040523_results.csv]
2023-05-04 Replaced 2nd layer to non-mem since it turned out better
    [xnor_roclk.v]
2023-05-04 Initial block to remove tristate wires
2023-05-04 Rst check in first layer to try and fix nonmerge
    [first_layer_roclk.v]
2023-05-04 Gated cnts to avoid activity in off layer
    [roclk_seq.v]
2023-05-05 Fix (removed double assignment)
    [first_layer_dsat.v]
2023-05-05 Had to make dump.sh parallel cause slow. 1 sample wrong in gasid
    [Har_bnn1_bnndsat.v, cardio_bnn1_bnndsat.v, gasId_bnn1_bnndsat.v, pendigits_bnn1_bnndsat.v, tbHar_bnn1_bnndsat.v, tbcardio_bnn1_bnndsat.v, tbgasId_bnn1_bnndsat.v, tbpendigits_bnn1_bnndsat.v]
2023-05-07 Dictionaries of features per width to print easier
2023-05-08 Changed bnnromem to have shifting reg in midbits
    [080523_results.csv]
2023-05-08 Failing on shiftxnor counter
    [binthresh.v, hm.v, modular_bnnromesx.v]
2023-05-10 Onehot selects correct weights
    [Har_bnn1_bnnrospine.v, cardio_bnn1_bnnrospine.v, first_layer_rospine.v, gasId_bnn1_bnnrospine.v, modular_bnnrospine.v, pendigits_bnn1_bnnrospine.v, tbHar_bnn1_bnnrospine.v, tbcardio_bnn1_bnnrospine.v]
2023-05-10 Added screenshots of winered symreg and latest results
    [100523_results.csv]
2023-05-18 Printed params for paar
2023-05-23 Fixed tnnpaar, I forgot the correction term for tnns last layer
    [modular_tnnpaar.v]
2023-06-29 Inplace figures, results at analysis, framework flowchart in tikz
2023-06-30 Number comparison with crosslayer
    [croslayerback.csv, newres.csv]
2023-07-02 Results compared
    [compare.csv, compare2.csv, extracompare.csv, newres.csv]
